beagleboard/beaglebone-black/images/image86.jpg

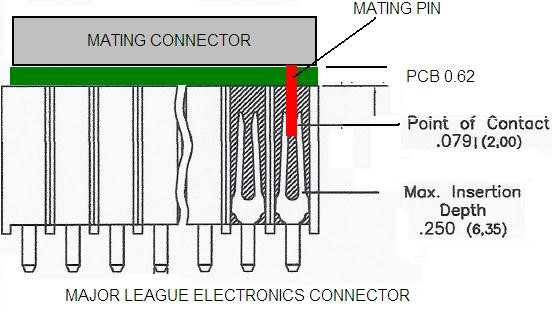
images/image86.jpg
