beagleboard/beaglebone-black/images/image9.jpg

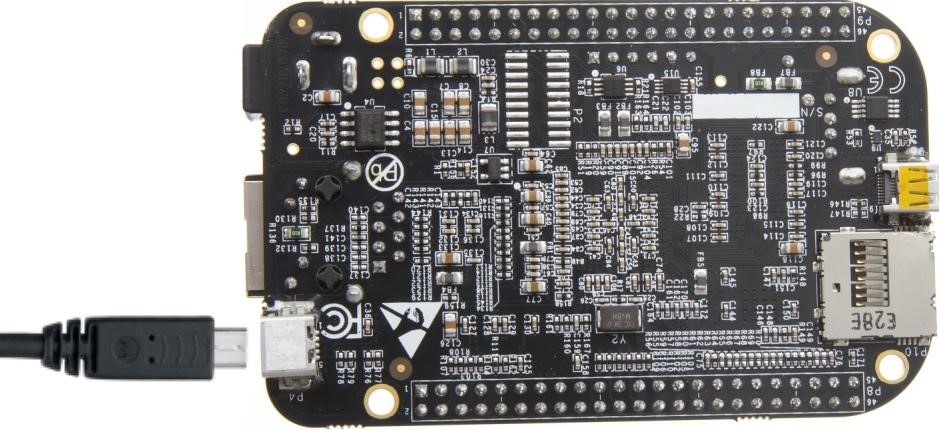
images/image9.jpg
