beagleboard/beaglebone-black/docs/PCN/PCN_BBBI_v0.2.pdf

## PRODUCT CHANGE

PCN# | PCN20201105-002 | PCN ISSUE DATE | Nov 05, 2020
PCN TITLE

BeagleBone Black Industrial

REVISION | | CUSTOMER CONTACT

TYPE OF CHANGE

☐Electrical Specification | ☐Part Number
☐Mechanical Specification | RComponents End of Life
☐Firmware Specification | ☐Other
☐Regulatory of Compliance

AFFECTED PART NUMBER(S)

Part Number | Manufacturer | Description | Change
YL004-030-001 | YULIANG | SMD SD Card Holder | Replace ALPS:SCHA5B0200
Resistors and Capacitors | YAGEO | Improve EMI performance | Quantity and value change

REASONS FOR CHANGE

ALPS: SCHA5B0200 SD card cage EOL and change it to YULIANG: YL004-030-001 (compatible with Molex: 5027740891).

Mechanical is compatible with previous design.

CUSTOMER ACTION REQUIRED

No actions.

## PRODUCT CHANGE

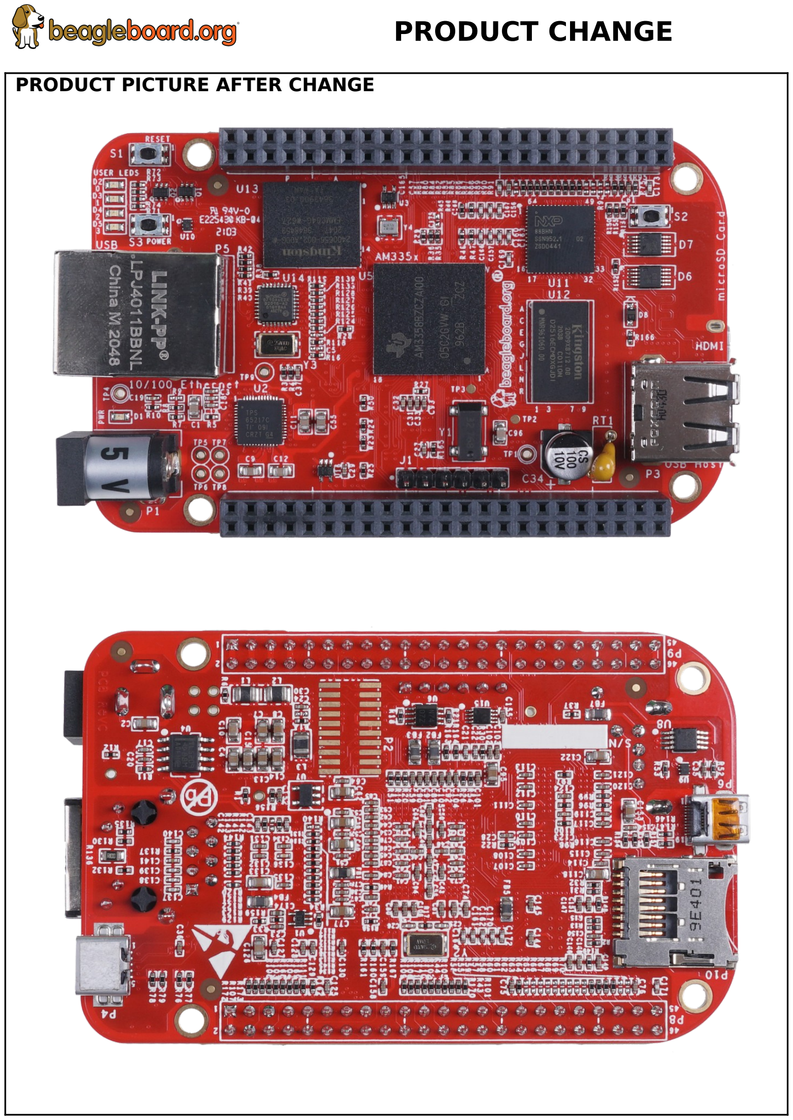
[picture p3: page 2]

PRODUCT PICTURE AFTER CHANGE
