beagleboard/beaglebone-black/images/image1.jpg

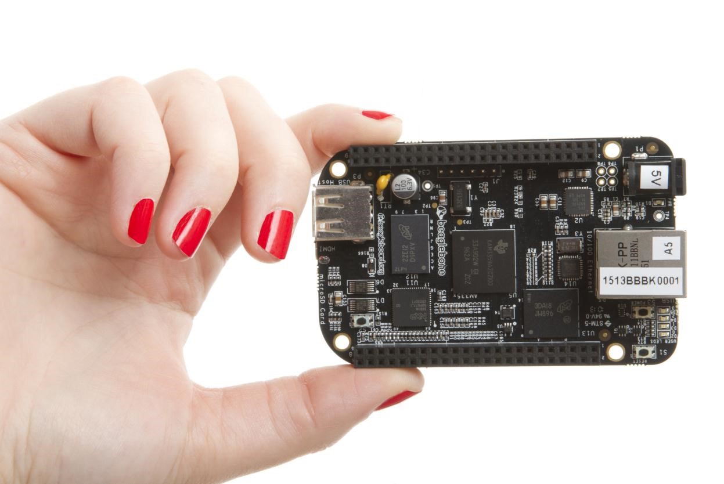
images/image1.jpg
