beagleboard/beaglebone-black/images/image7.jpg

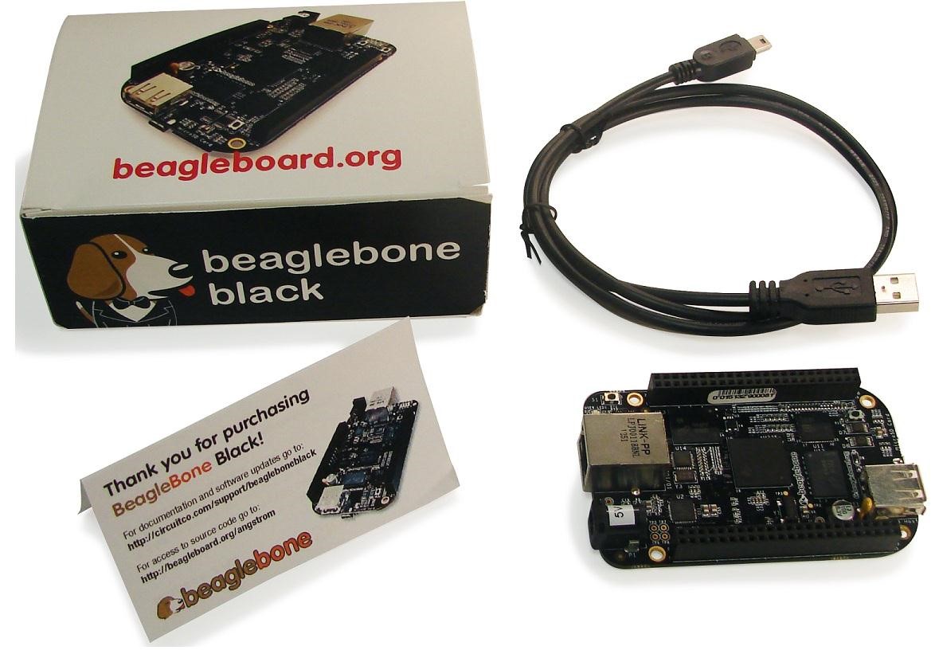
images/image7.jpg
