beagleboard/beaglebone-black/images/image8.jpg

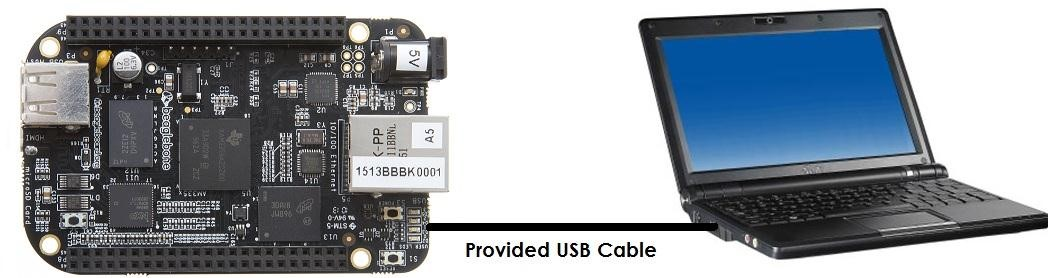
images/image8.jpg
