beagleboard/beaglebone-black/images/image10.jpg

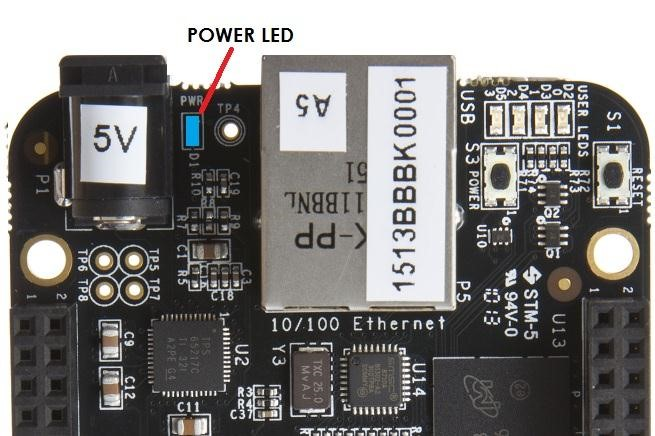
images/image10.jpg
