beagleboard/beaglebone-black/images/image11.jpg

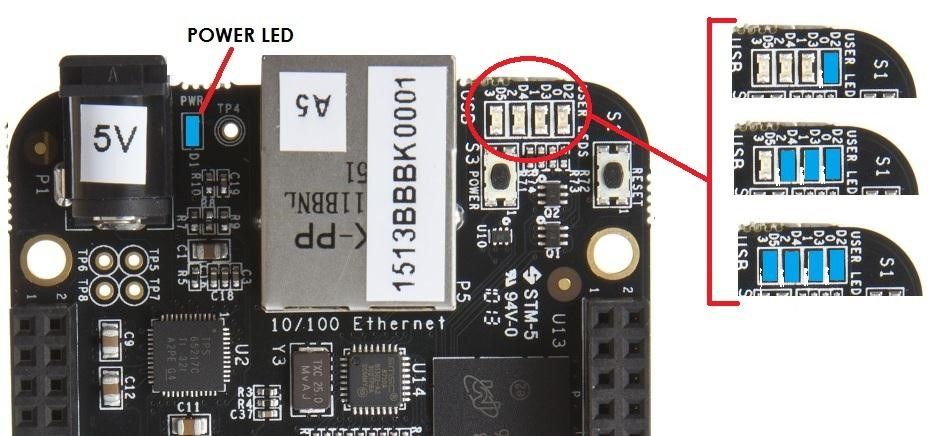
images/image11.jpg
