beagleboard/beaglebone-black/images/image12.jpg

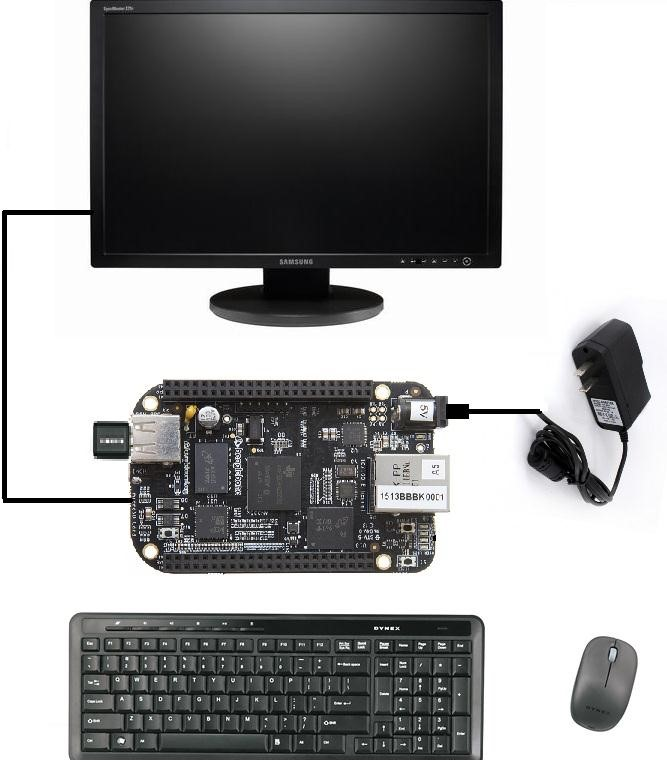
images/image12.jpg
