beagleboard/beaglebone-black/images/image14.jpg

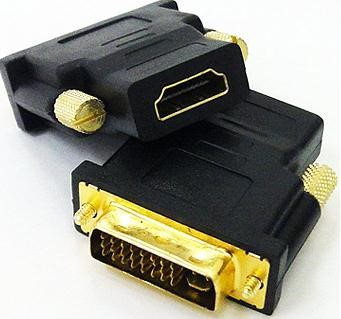
images/image14.jpg
