beagleboard/beaglebone-black/images/image16.jpg

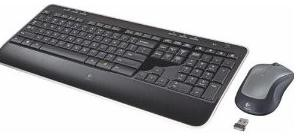
images/image16.jpg
