beagleboard/beaglebone-black/images/image17.jpg

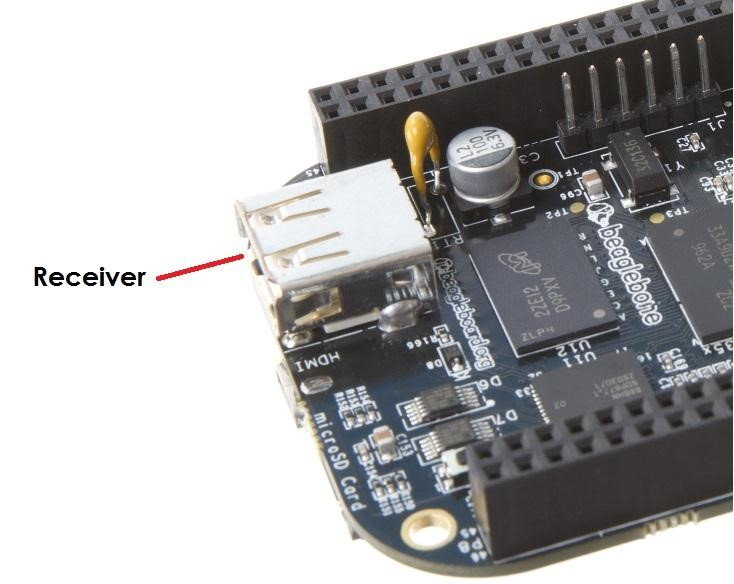
images/image17.jpg
