beagleboard/beaglebone-black/images/image18.jpg

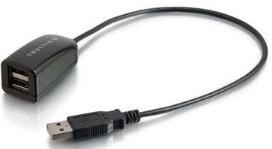
images/image18.jpg
