beagleboard/beaglebone-black/images/image24.jpg

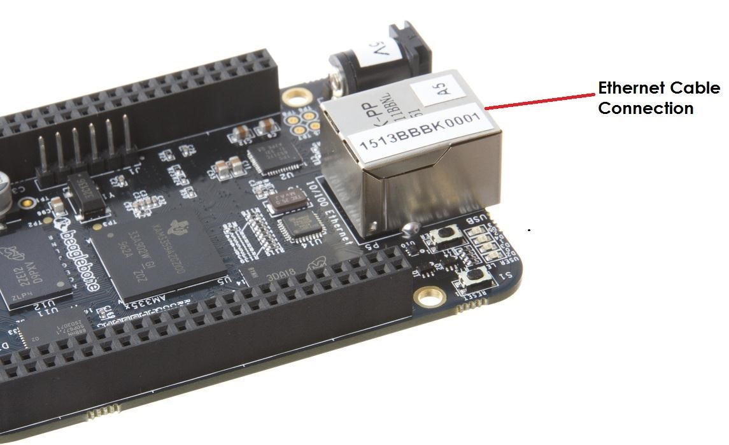
images/image24.jpg
