beagleboard/beaglebone-black/images/image25.jpg

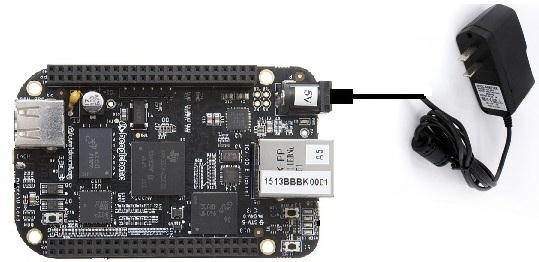
images/image25.jpg
