beagleboard/beaglebone-black/images/image26.jpg

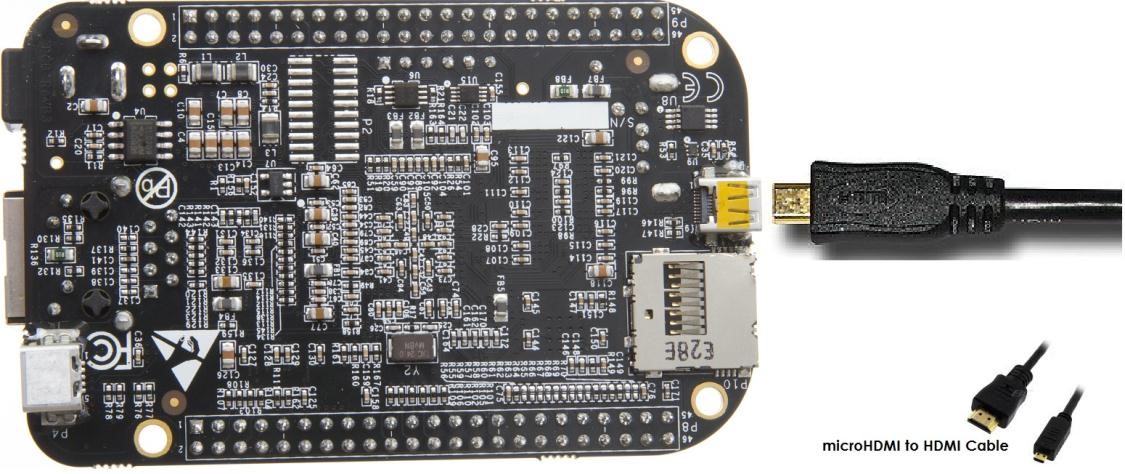
images/image26.jpg
