beagleboard/beaglebone-black/images/image27.jpg

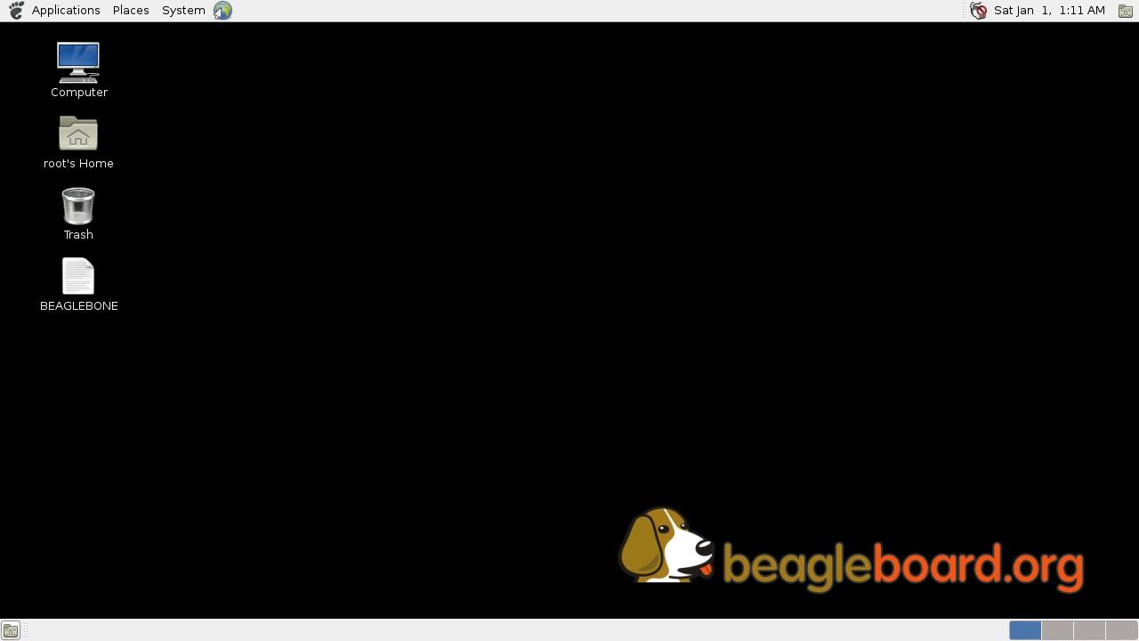
images/image27.jpg
