beagleboard/beaglebone-black/images/image28.jpg

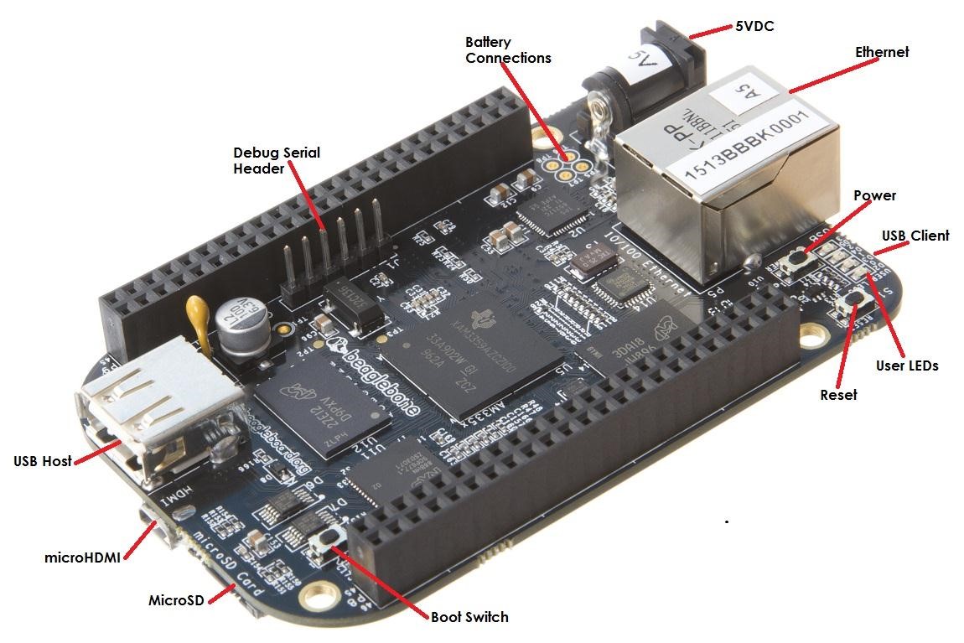
images/image28.jpg
