beagleboard/beaglebone-black/images/image29.jpg

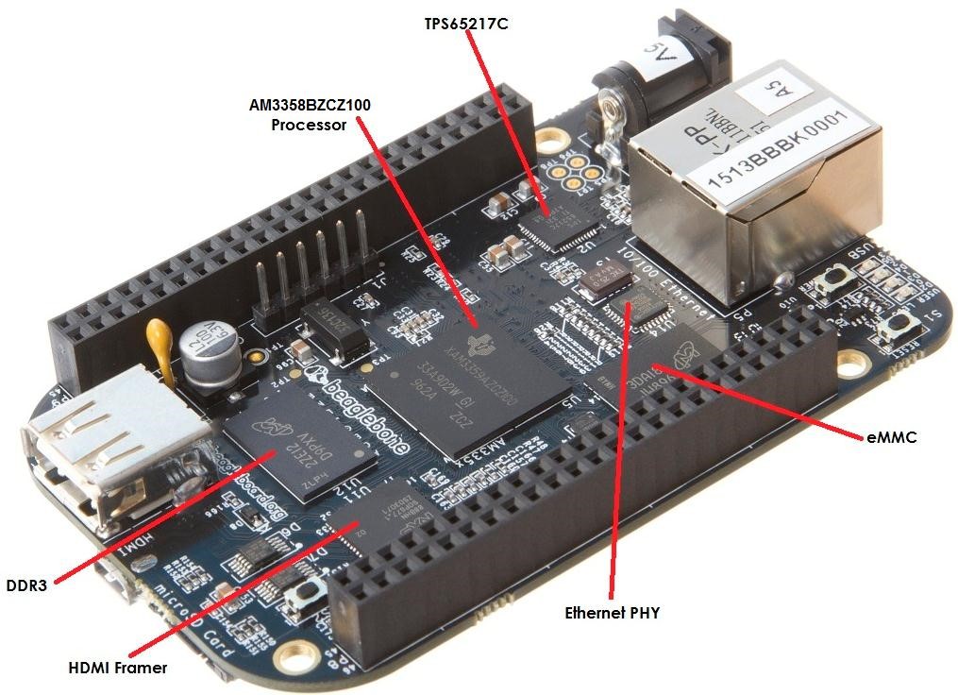
images/image29.jpg
