beagleboard/beaglebone-black/images/image30.jpg

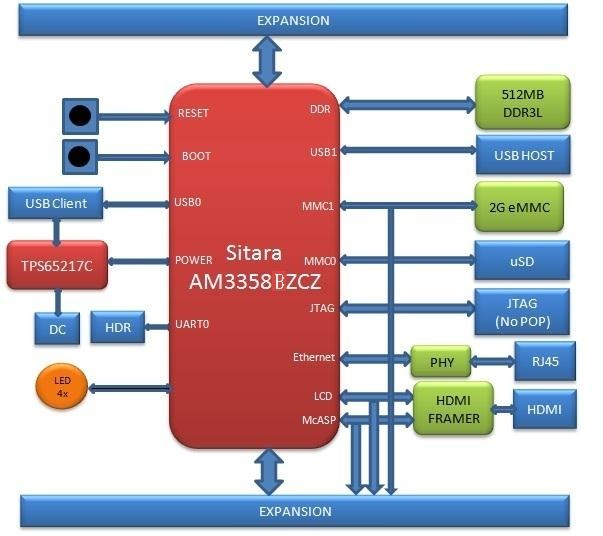
images/image30.jpg
