beagleboard/beaglebone-black/images/image31.png

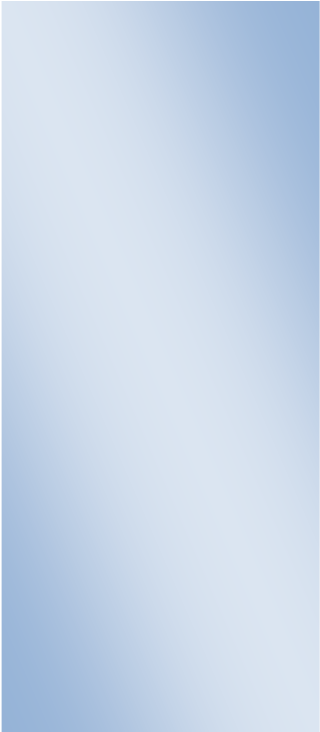
images/image31.png
