beagleboard/beaglebone-black/images/image37.png

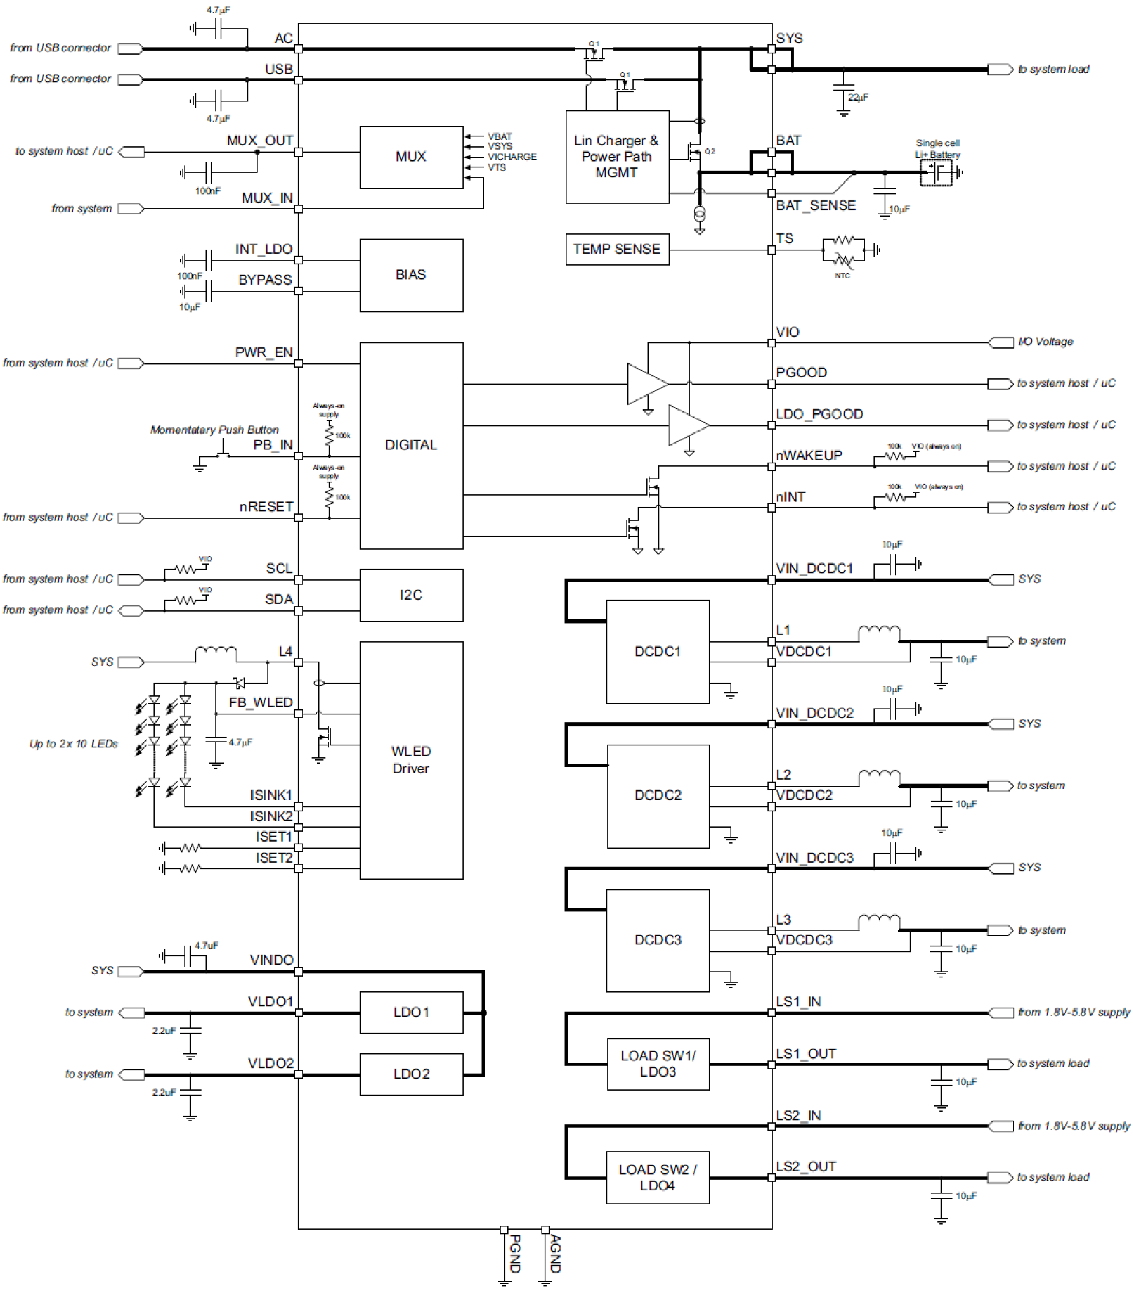
images/image37.png
