beagleboard/beaglebone-black/images/image38.png

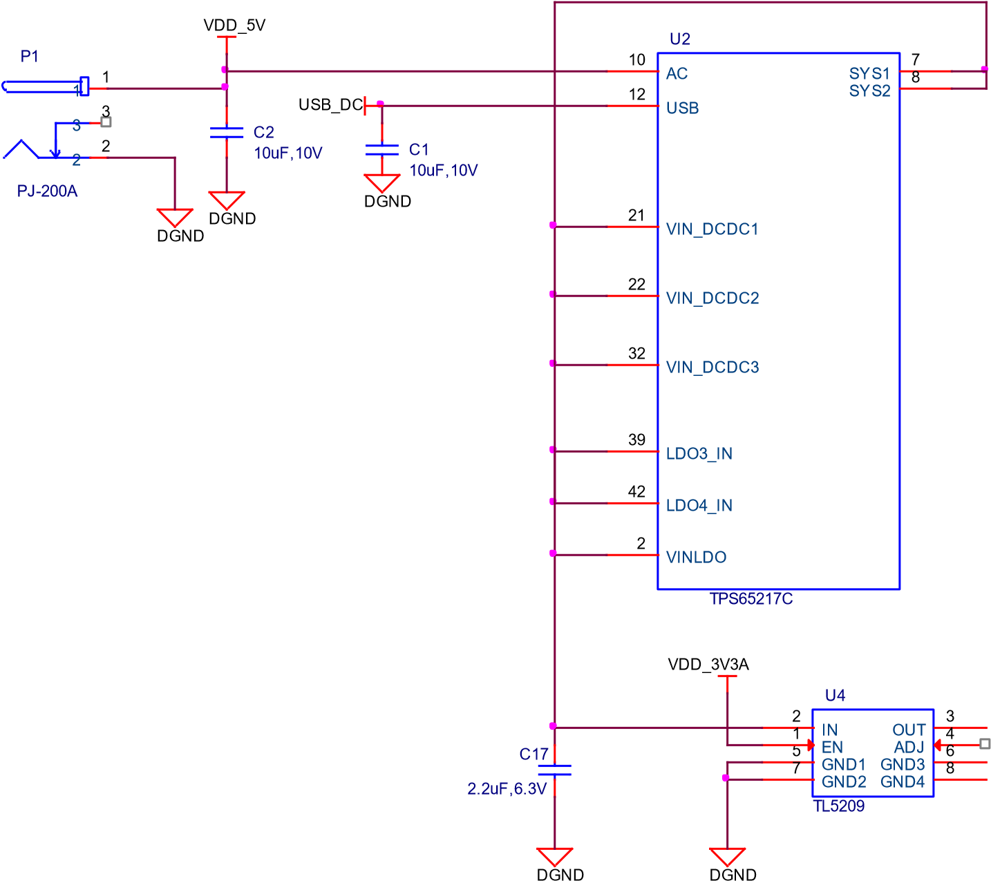
images/image38.png
