beagleboard/beaglebone-black/images/image39.jpg

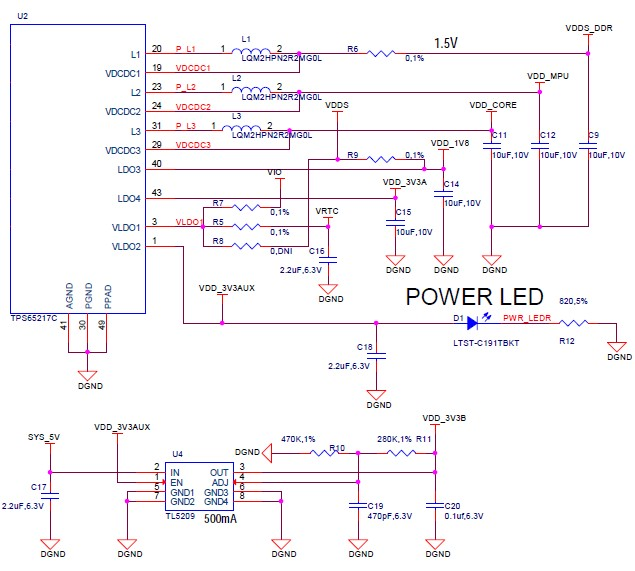
images/image39.jpg
