beagleboard/beaglebone-black/images/image40.png

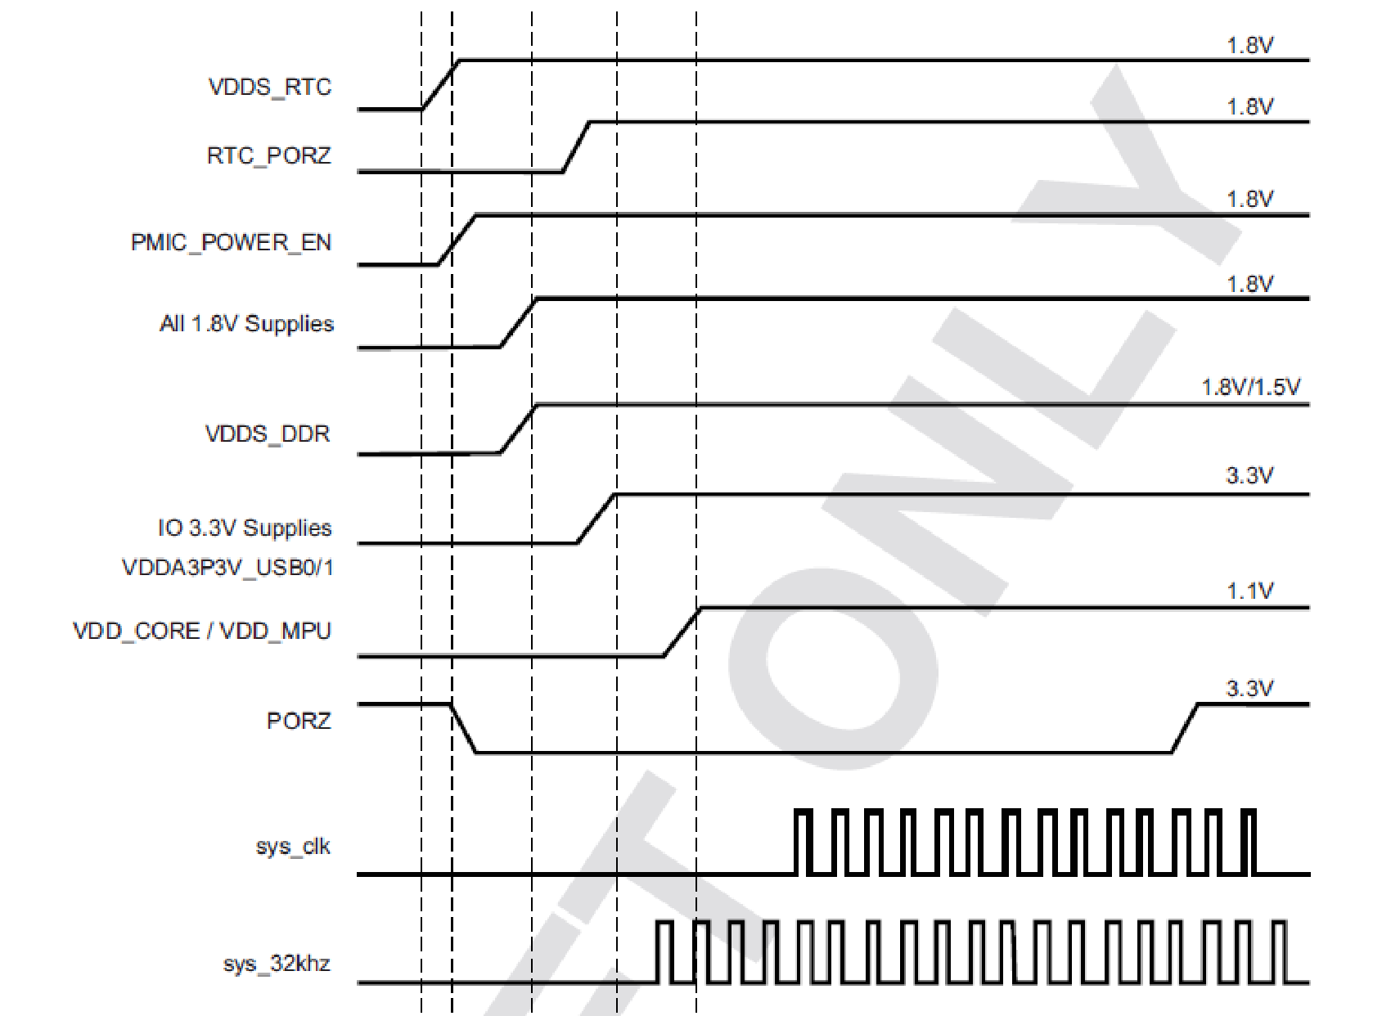
images/image40.png
