beagleboard/beaglebone-black/images/image41.png

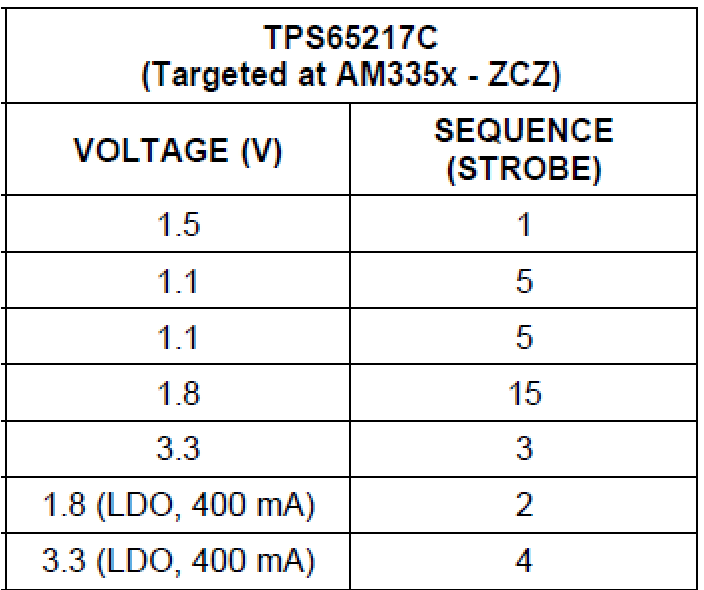
images/image41.png
