beagleboard/beaglebone-black/images/image42.jpg

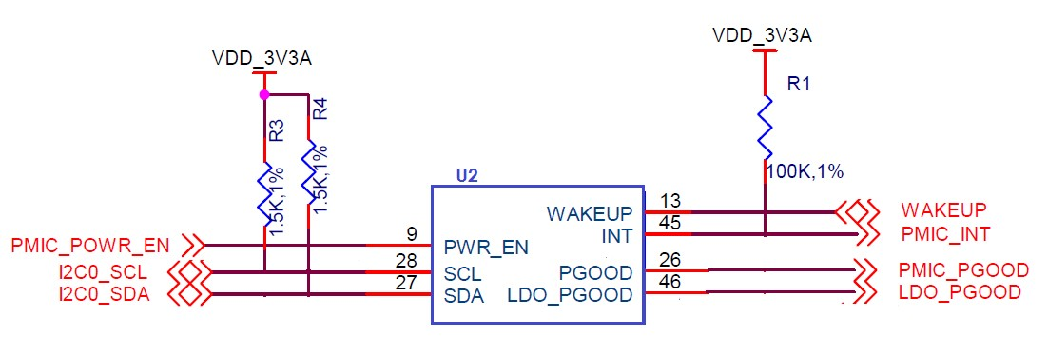
images/image42.jpg
