beagleboard/beaglebone-black/images/image43.png

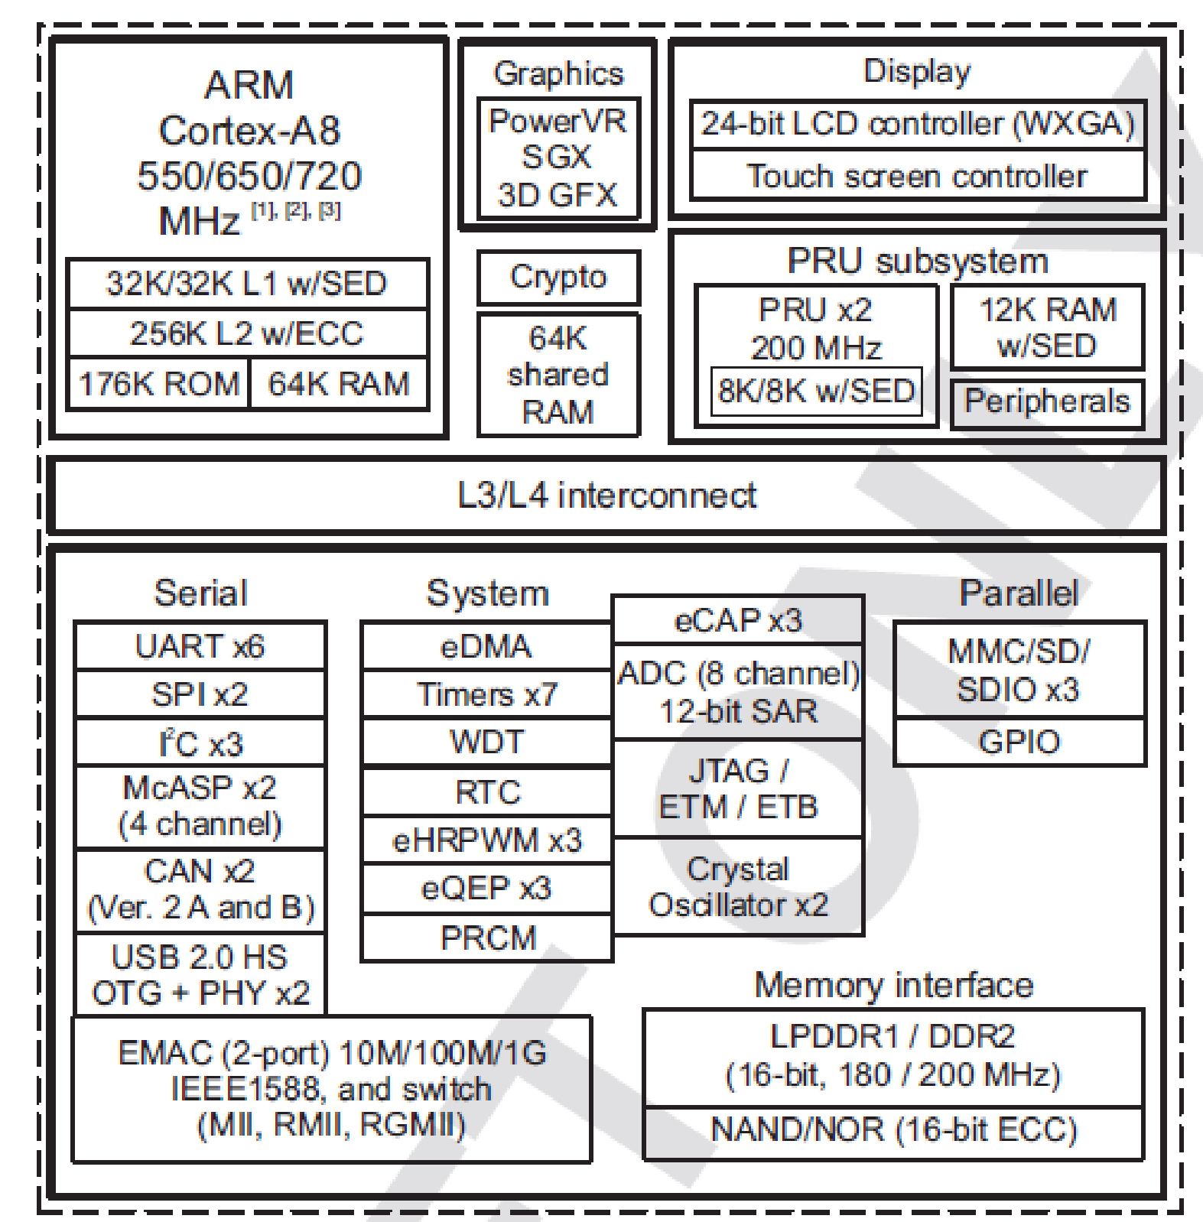
images/image43.png
