beagleboard/beaglebone-black/images/image44.png

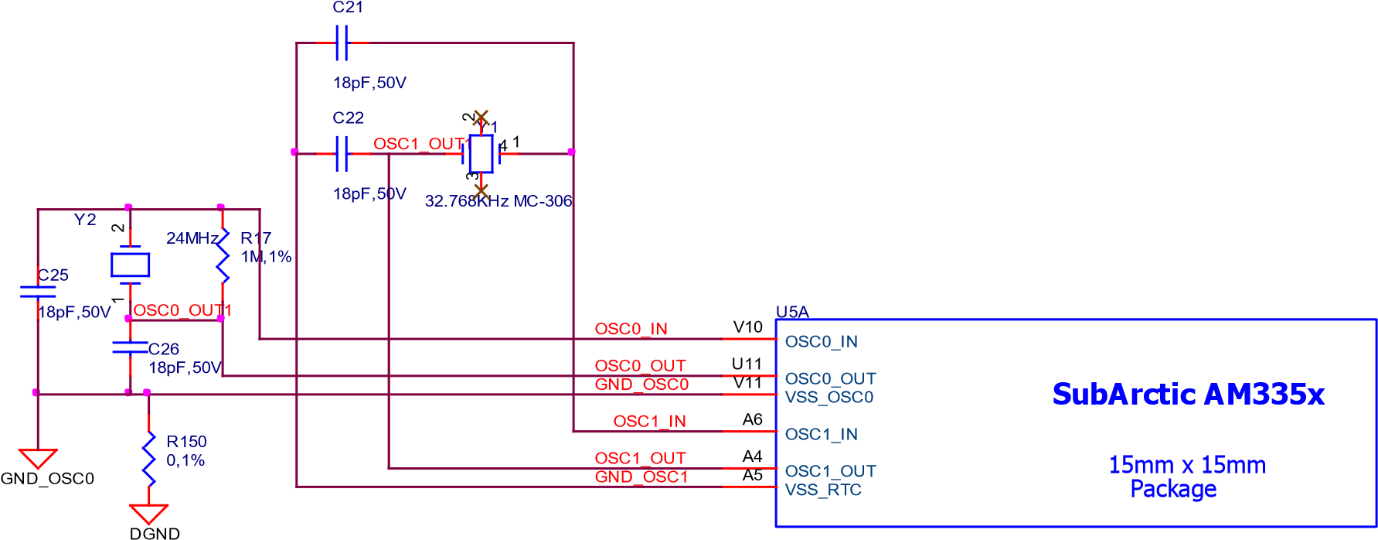
images/image44.png
