beagleboard/beaglebone-black/images/image45.png

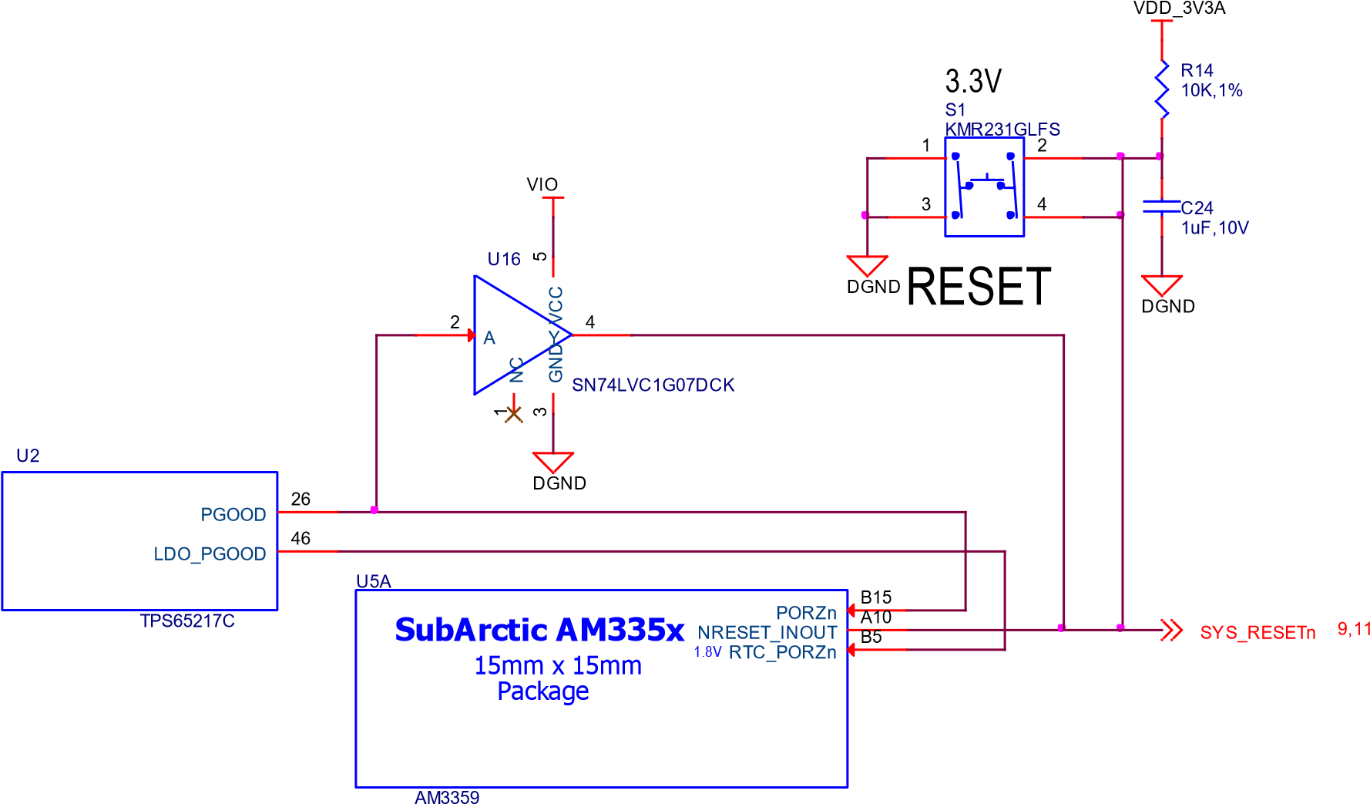
images/image45.png
