beagleboard/beaglebone-black/images/image46.png

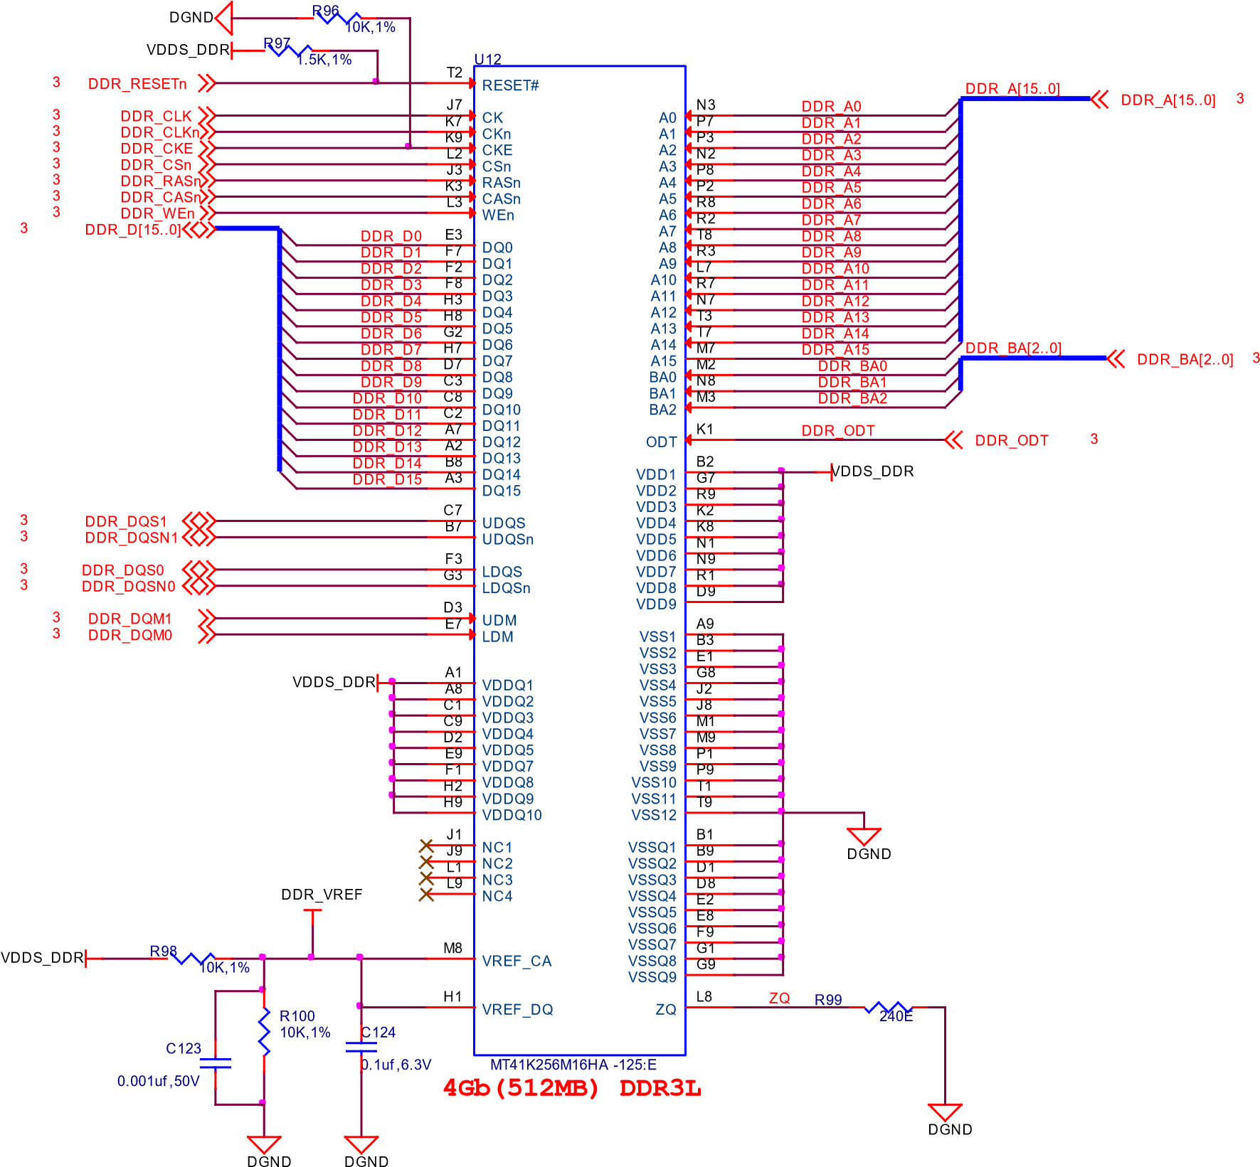
images/image46.png
