beagleboard/beaglebone-black/images/image47.jpg

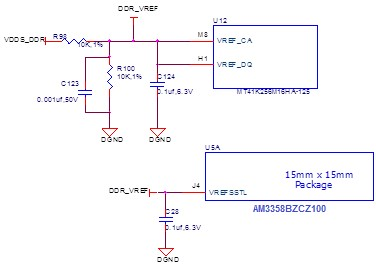
images/image47.jpg
