beagleboard/beaglebone-black/images/image48.png

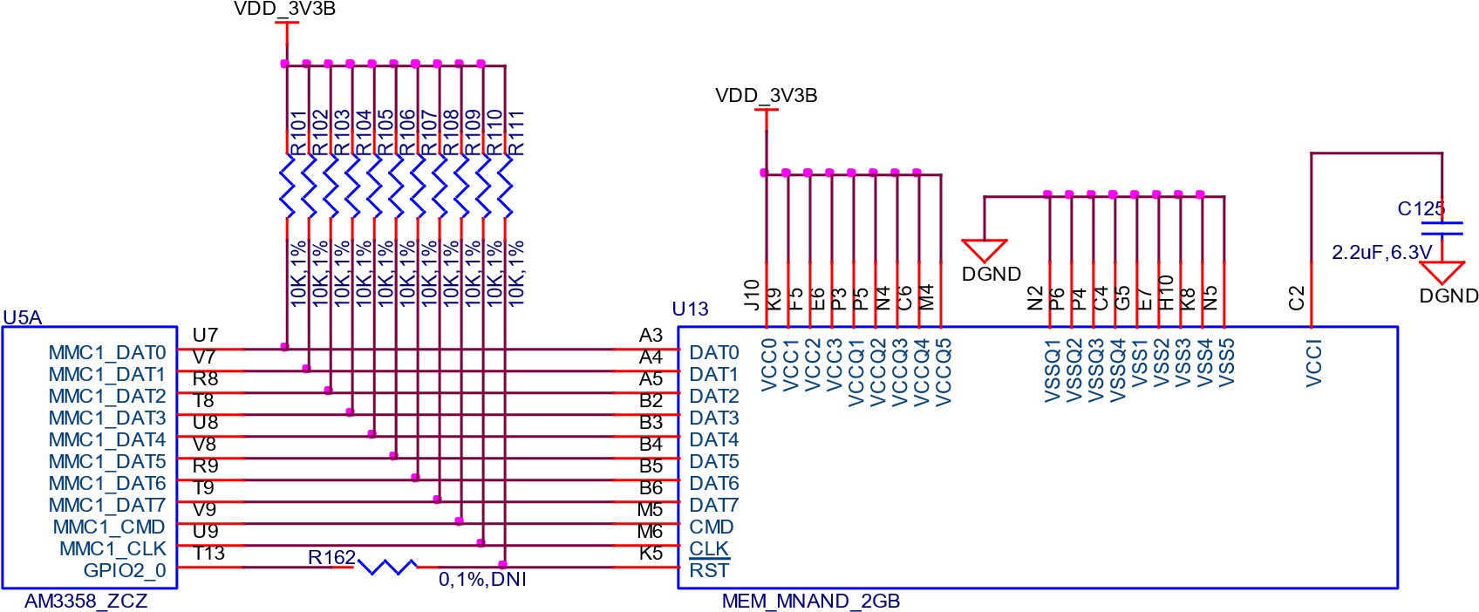
images/image48.png
