beagleboard/beaglebone-black/images/image49.png

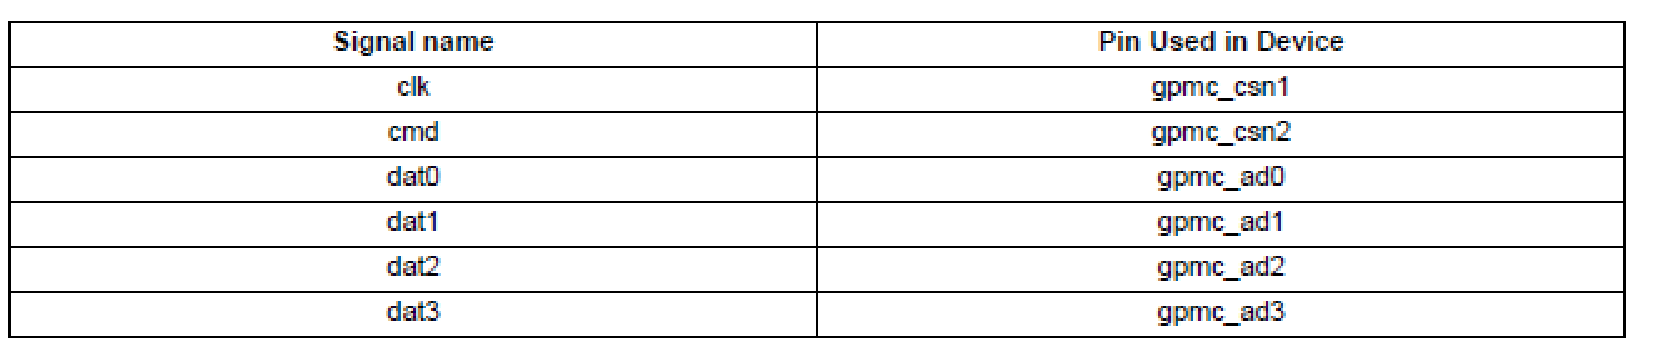
images/image49.png
