beagleboard/beaglebone-black/images/image50.png

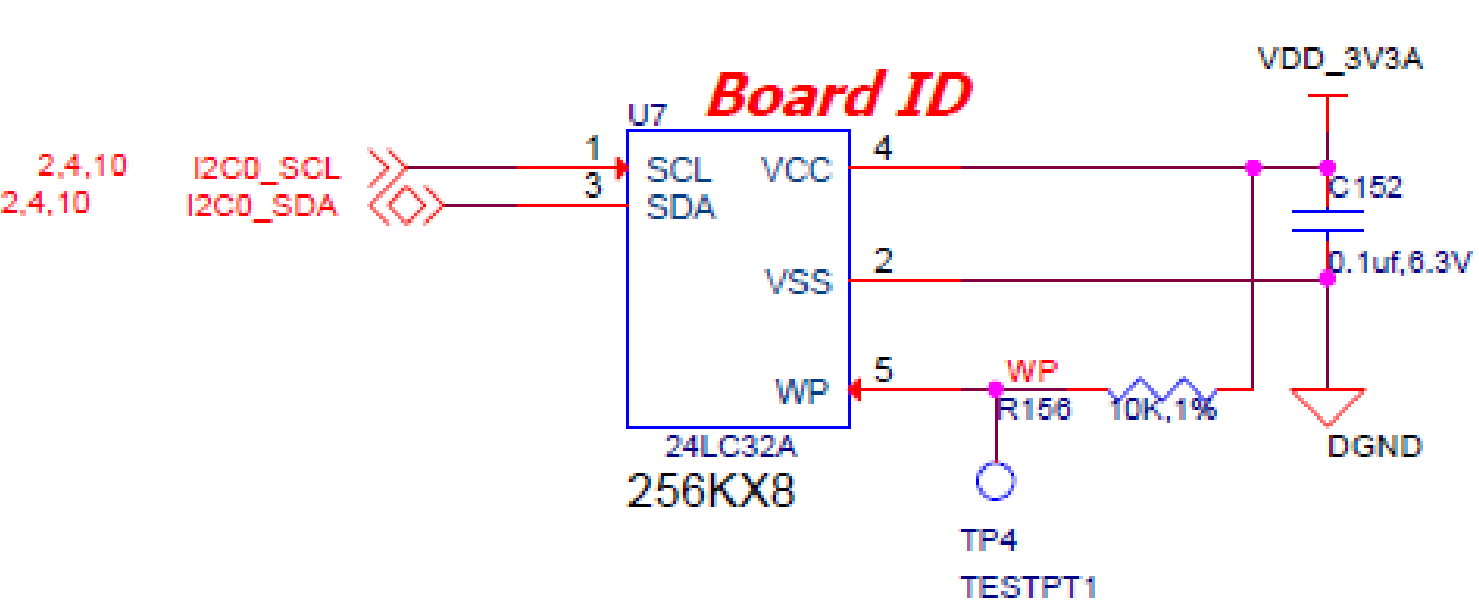
images/image50.png
