beagleboard/beaglebone-black/images/image51.png

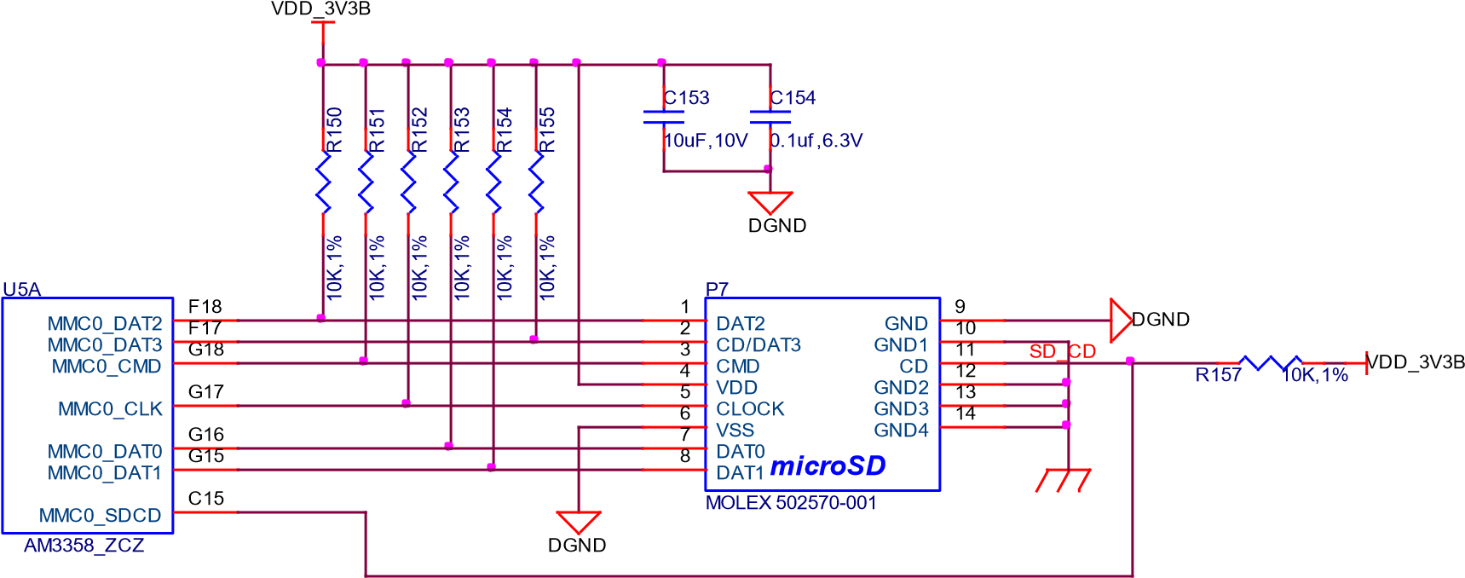
images/image51.png
