beagleboard/beaglebone-black/images/image52.png

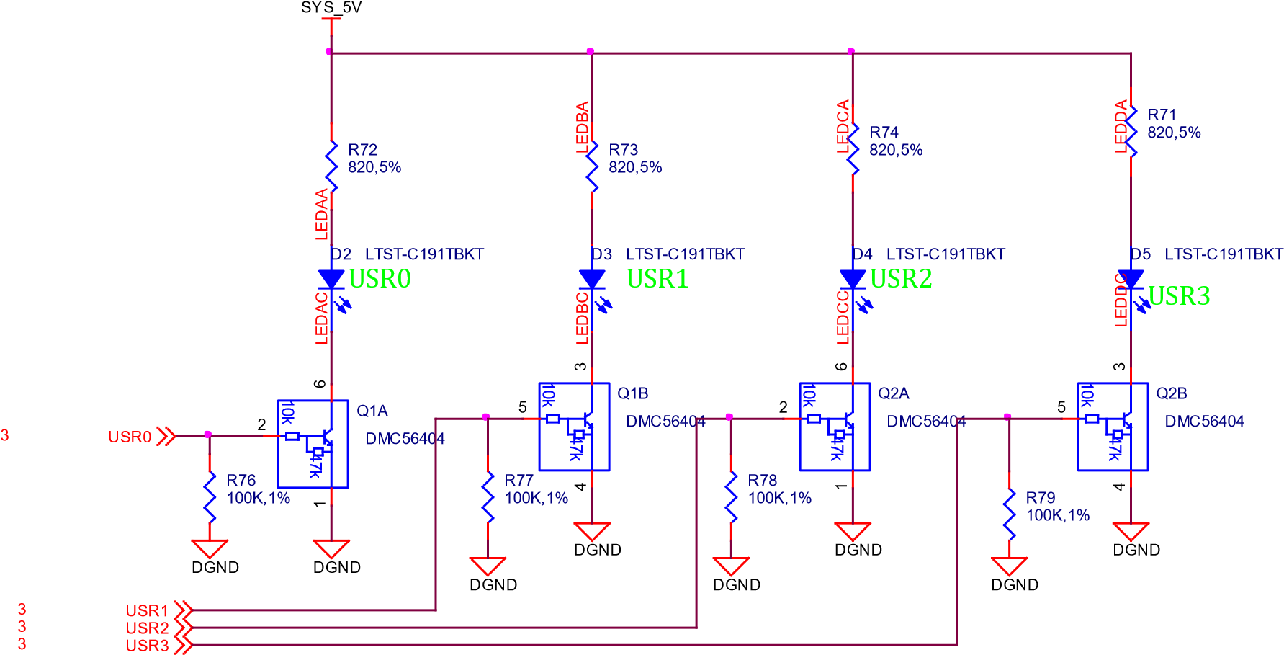
images/image52.png
