beagleboard/beaglebone-black/images/image53.png

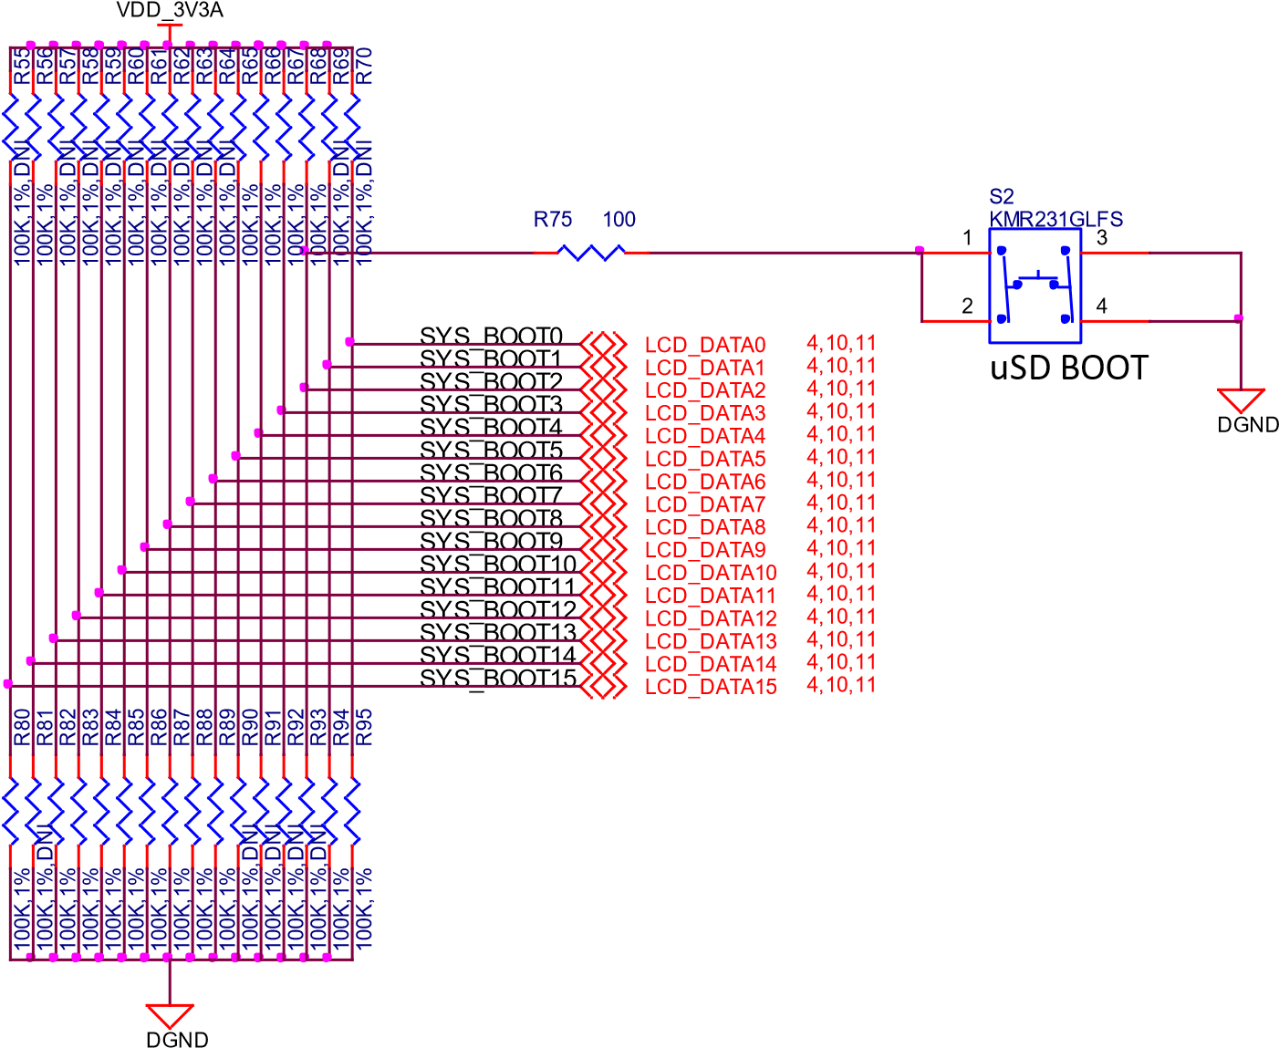
images/image53.png
