beagleboard/beaglebone-black/images/image54.jpg

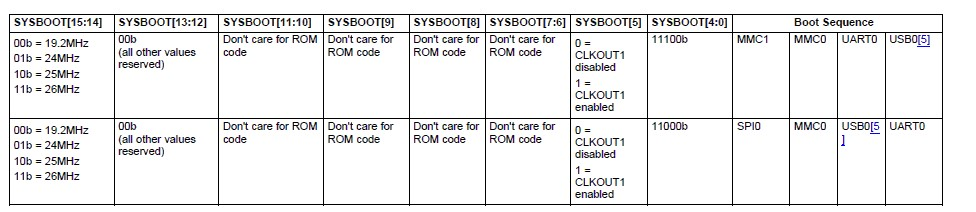
images/image54.jpg
