beagleboard/beaglebone-black/images/image55.png

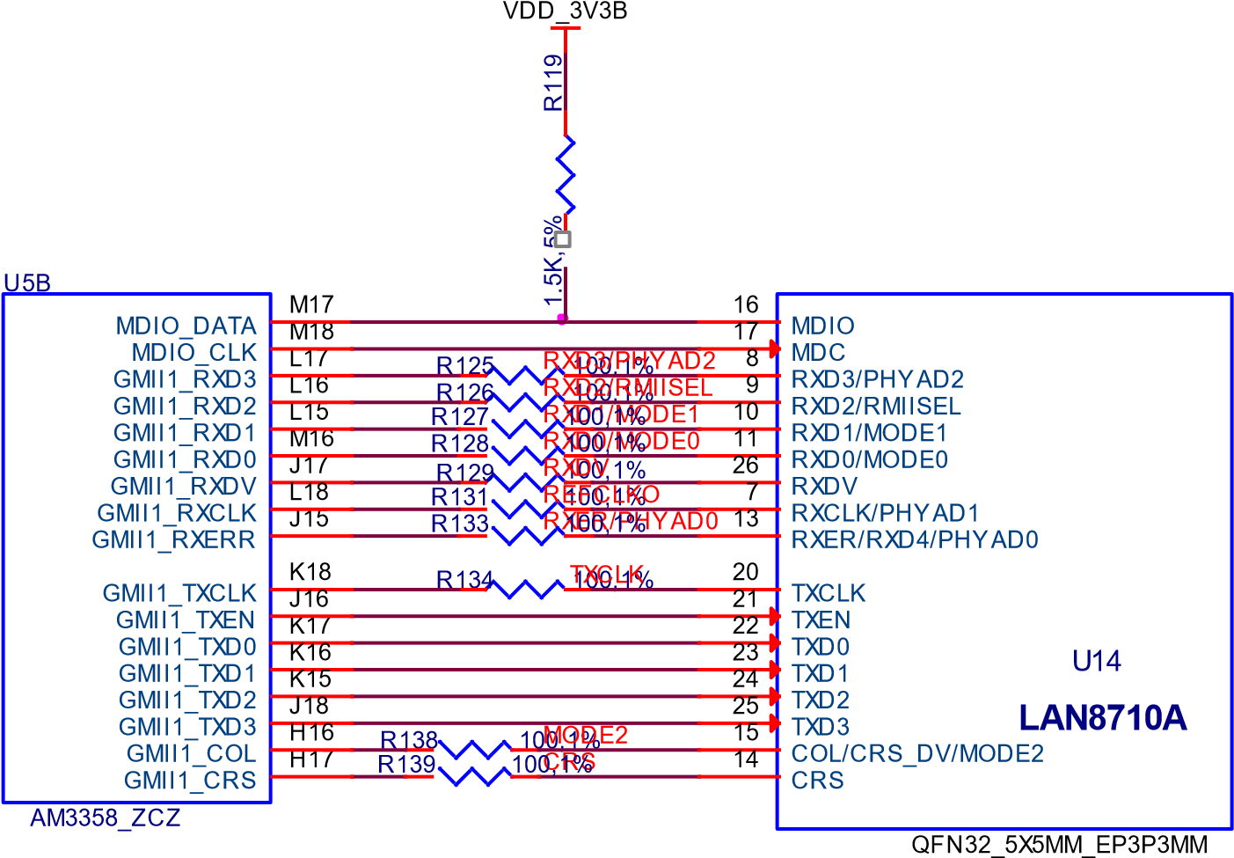
images/image55.png
