beagleboard/beaglebone-black/images/image56.png

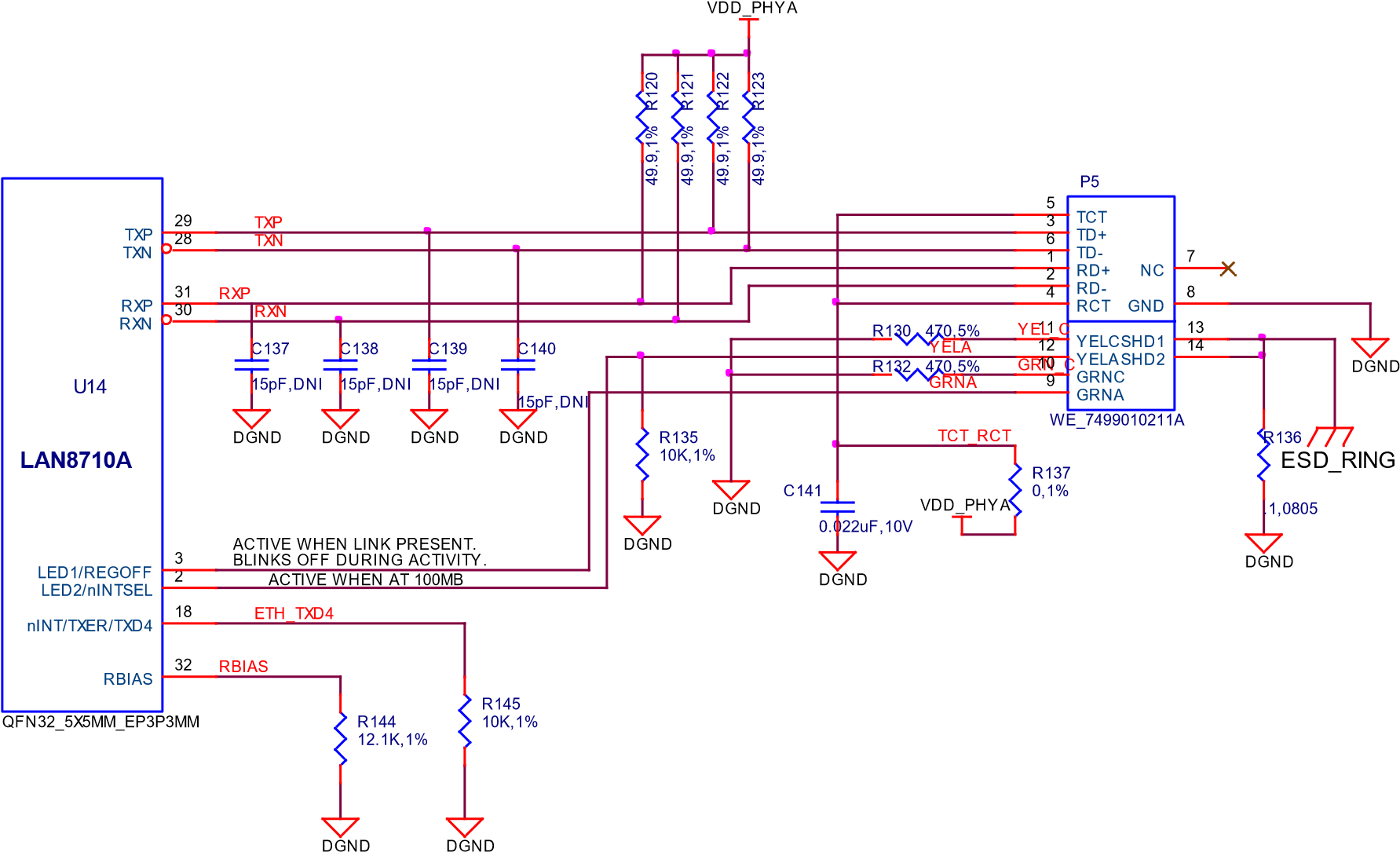
images/image56.png
