beagleboard/beaglebone-black/images/image57.png

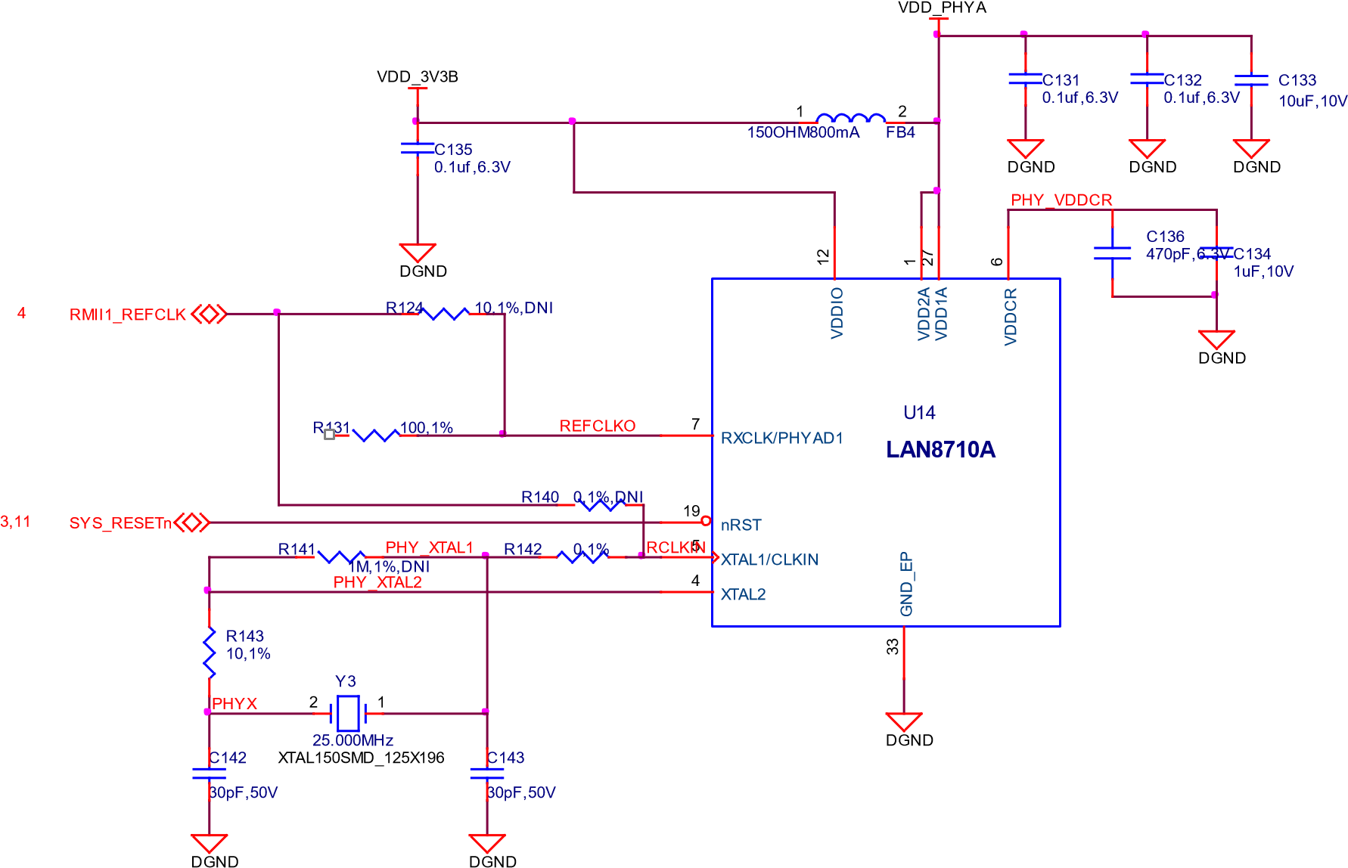
images/image57.png
