beagleboard/beaglebone-black/images/image58.png

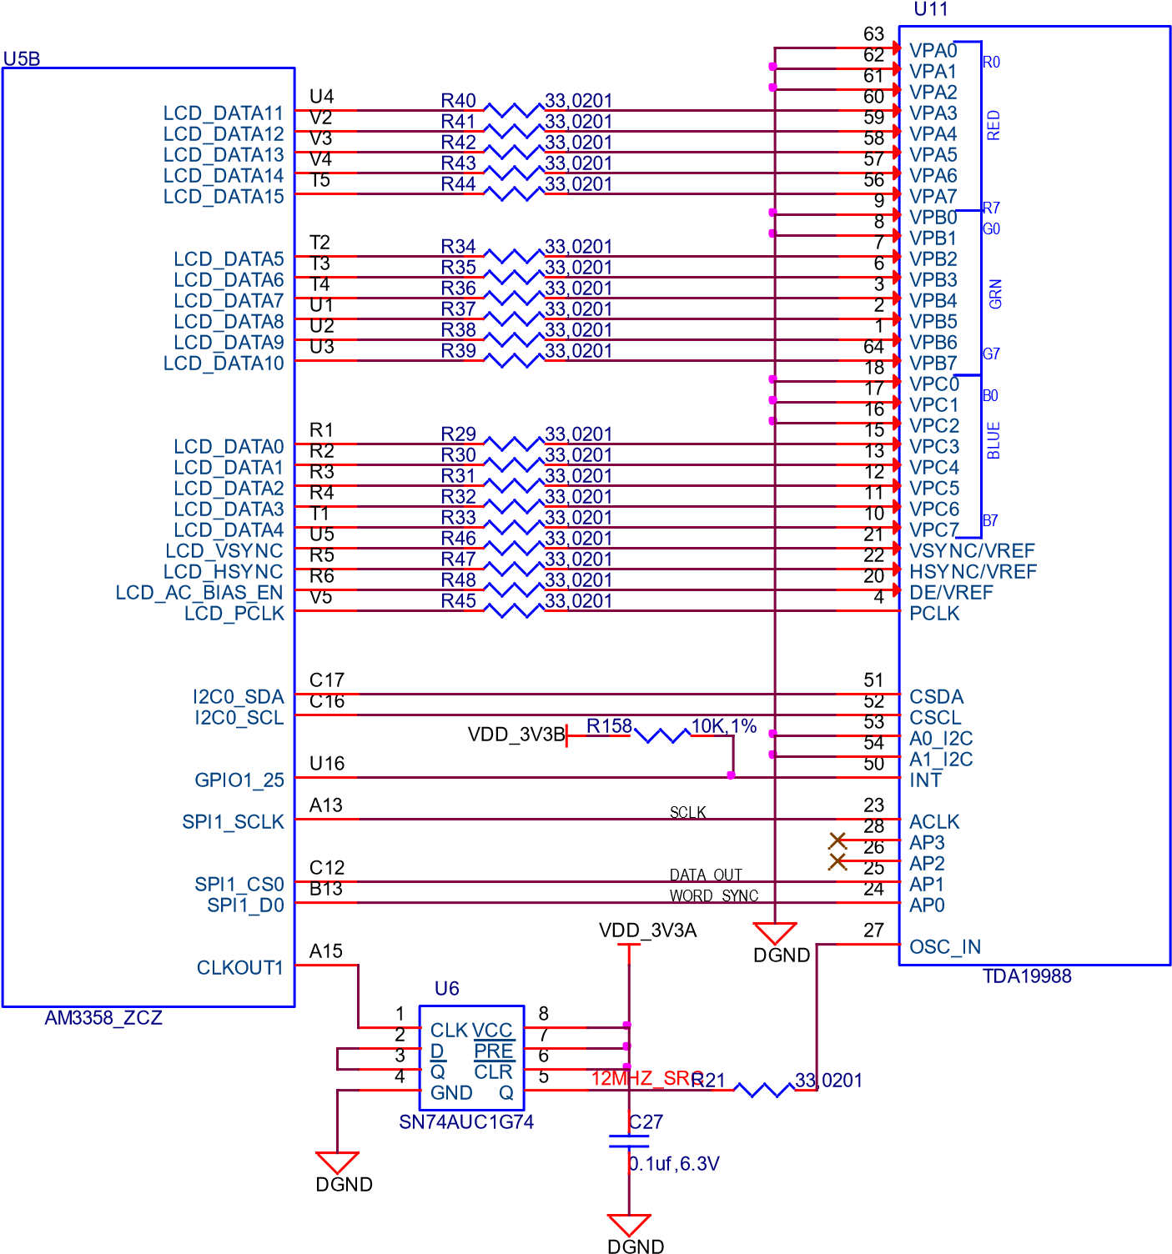
images/image58.png
