beagleboard/beaglebone-black/images/image59.png

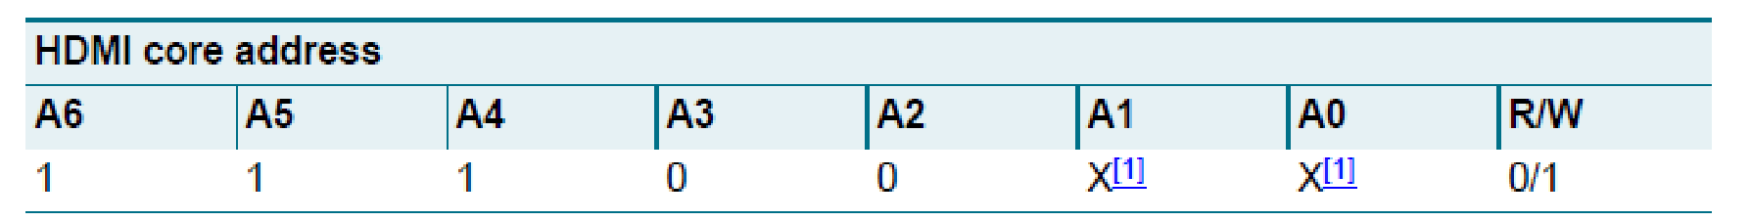
images/image59.png
