beagleboard/beaglebone-black/images/image60.png

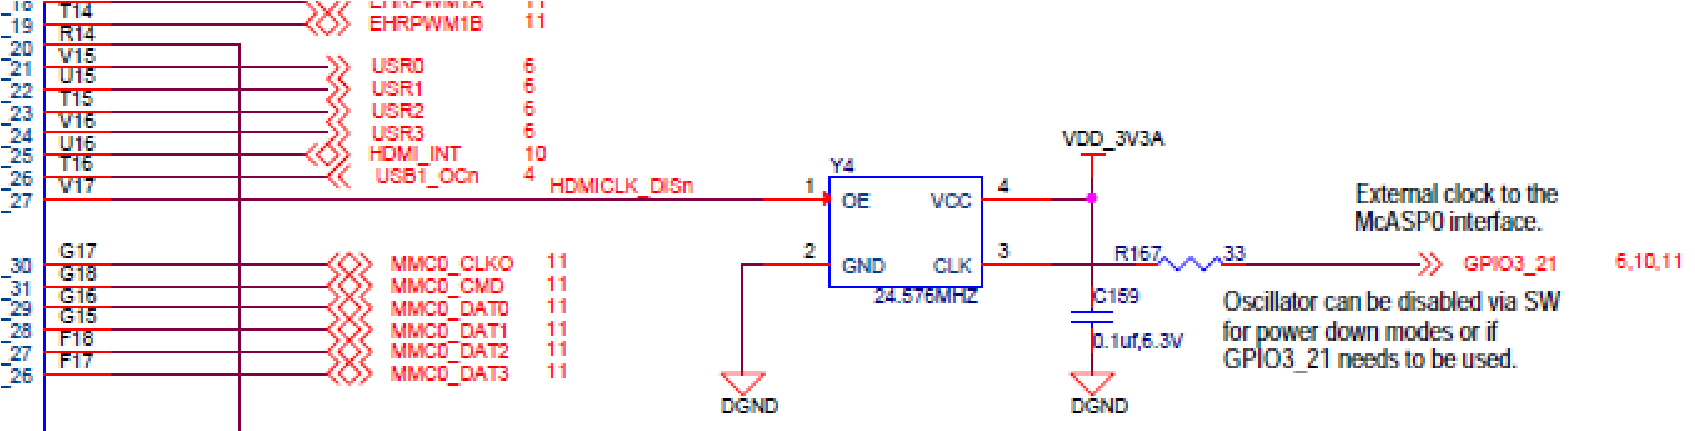
images/image60.png
