beagleboard/beaglebone-black/images/image64.png

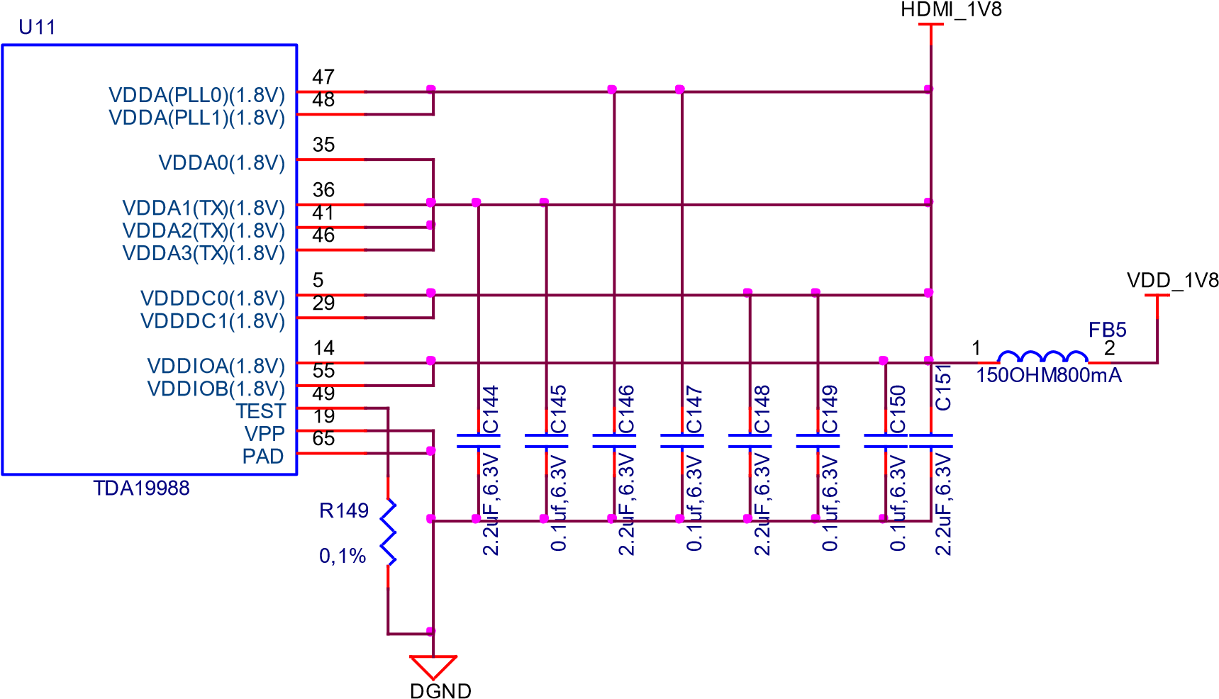
images/image64.png
