beagleboard/beaglebone-black/images/image65.png

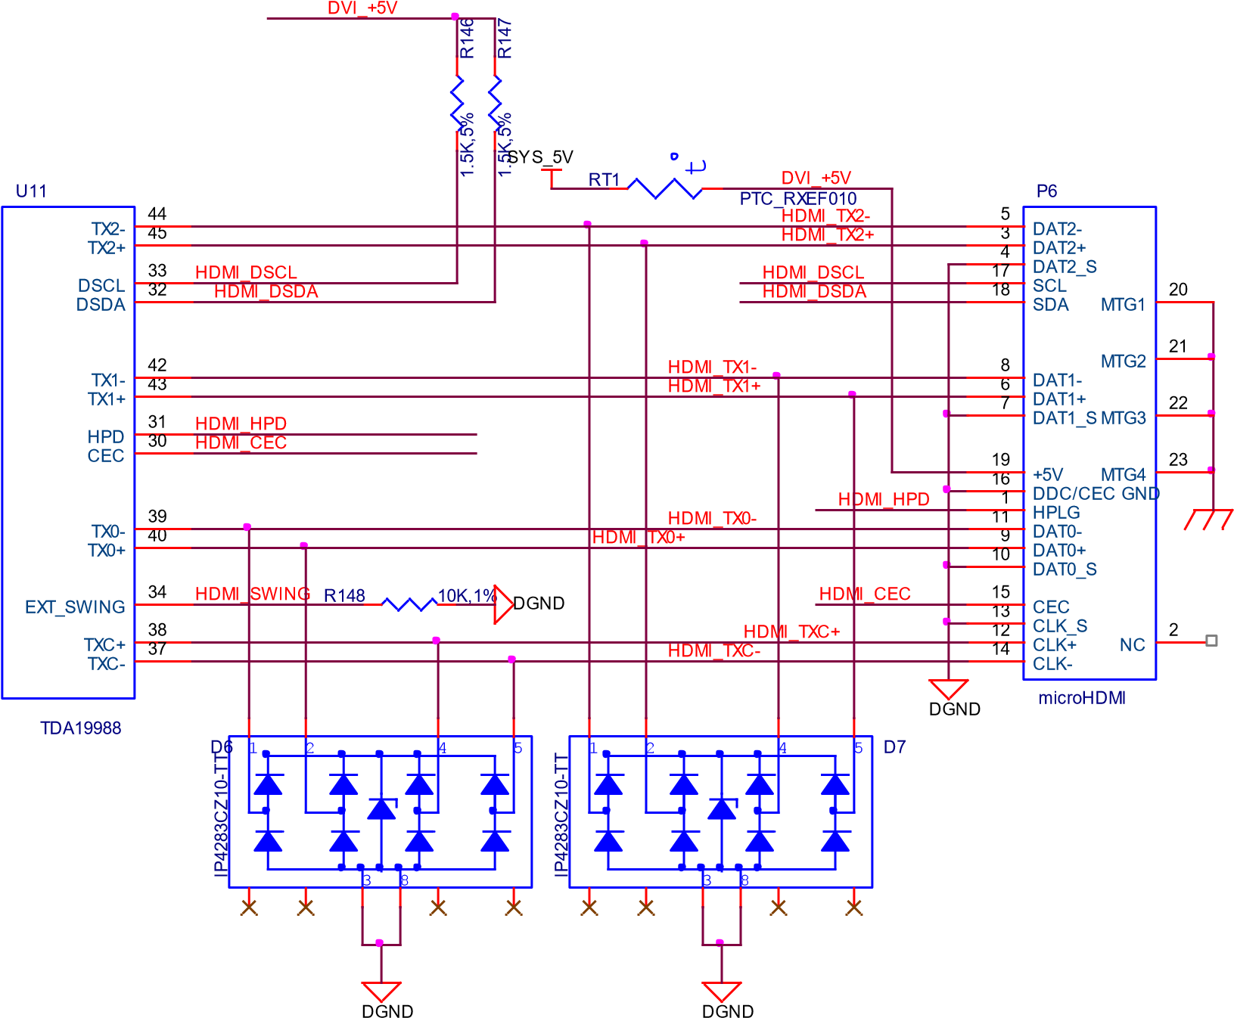
images/image65.png
