beagleboard/beaglebone-black/images/image66.png

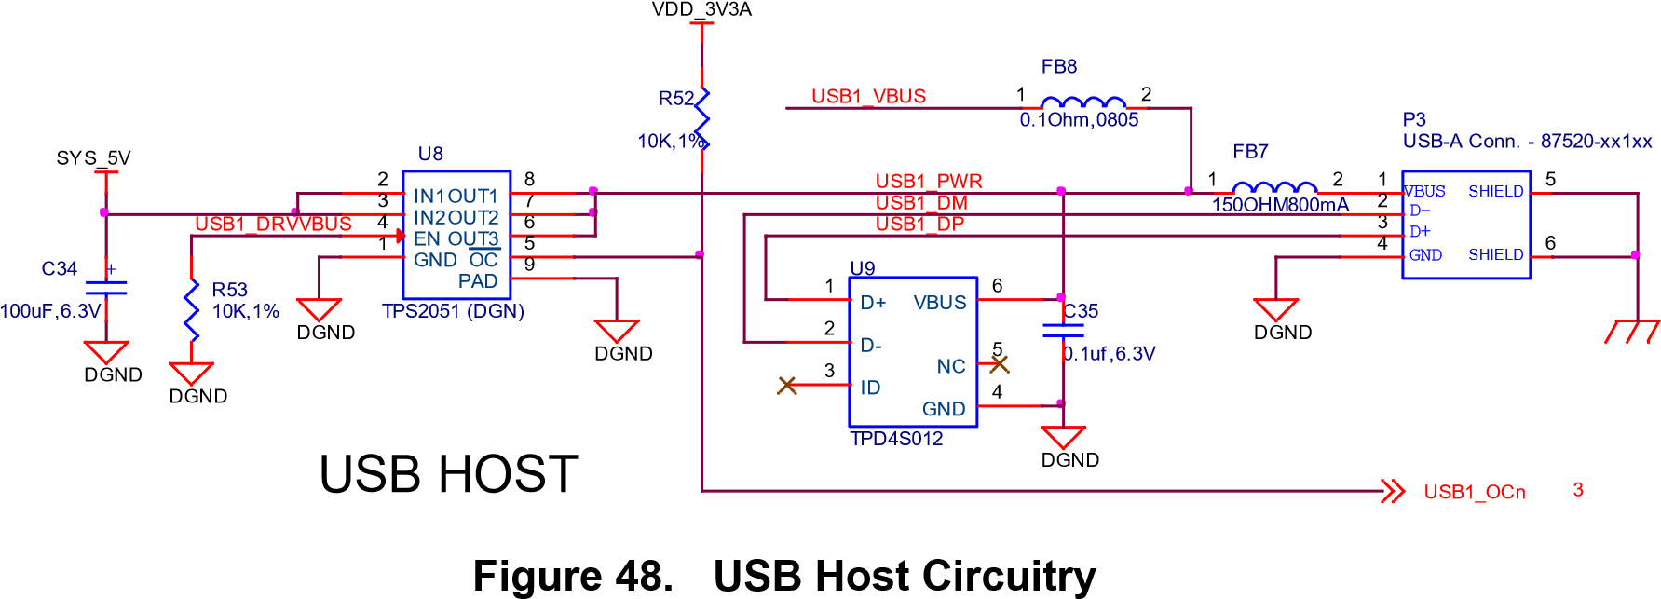
images/image66.png
