beagleboard/beaglebone-black/images/image67.png

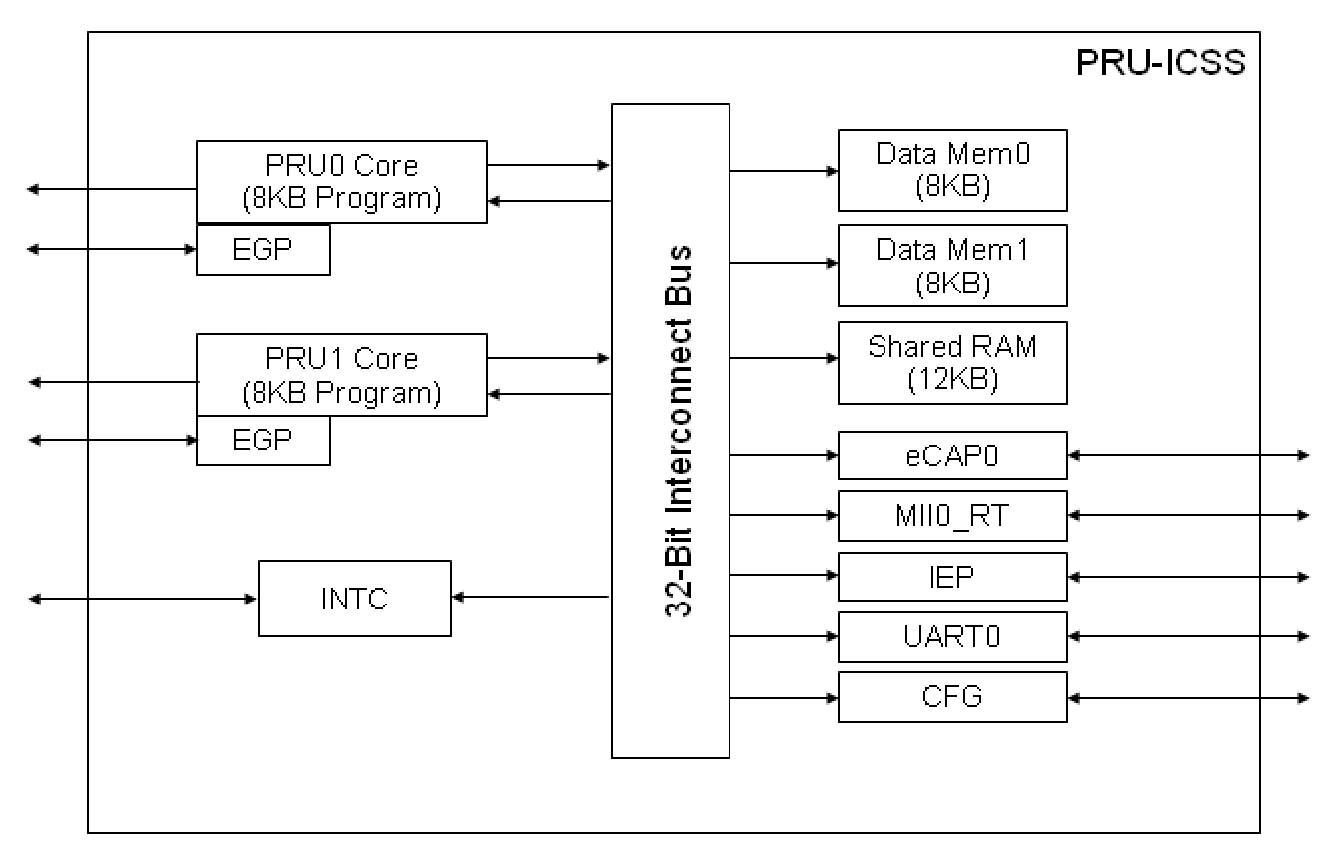
images/image67.png
