beagleboard/beaglebone-black/images/image68.jpg

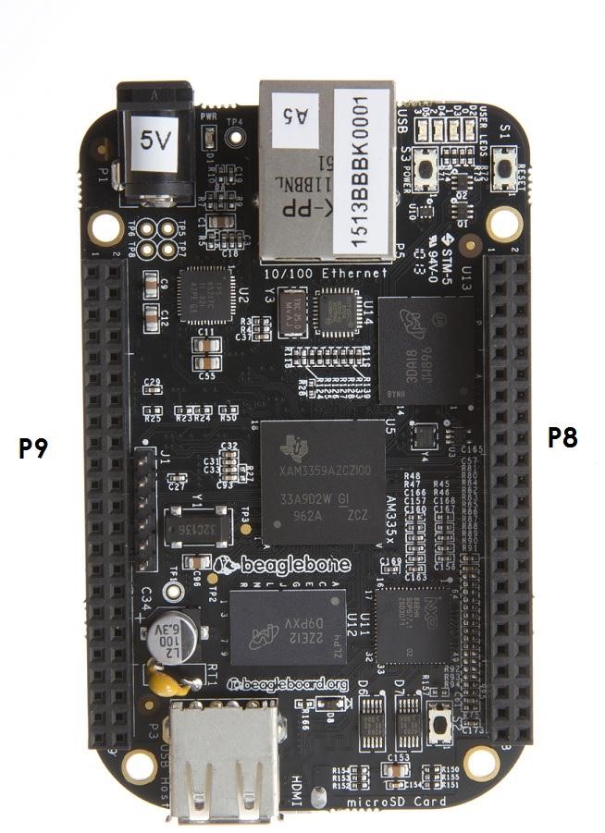
images/image68.jpg
