beagleboard/beaglebone-black/images/image69.jpg

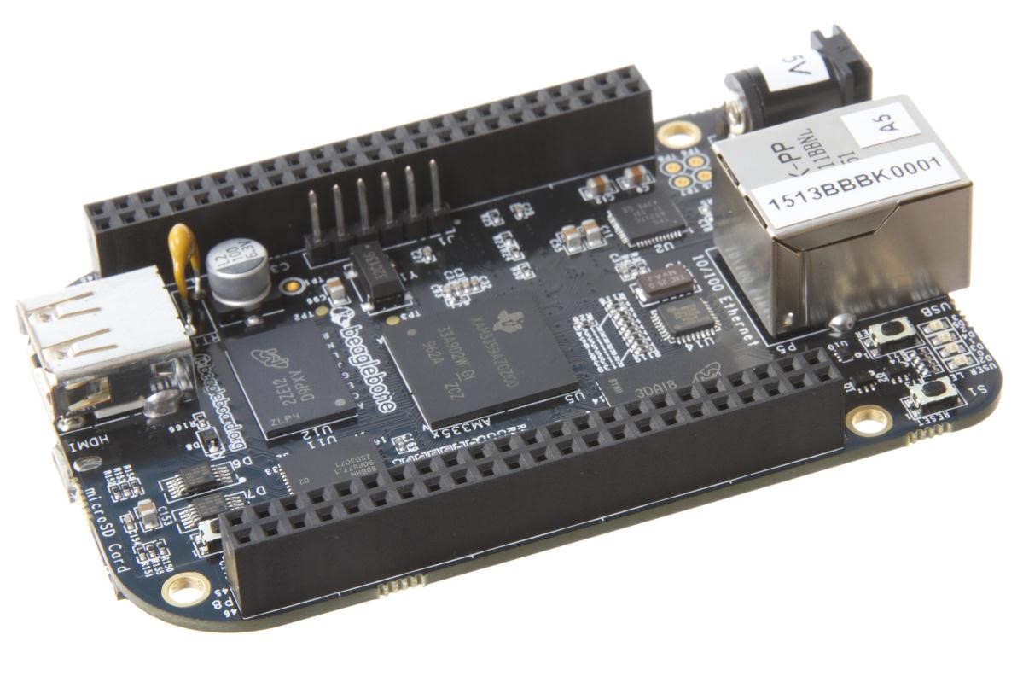
images/image69.jpg
