beagleboard/beaglebone-black/images/image73.jpg

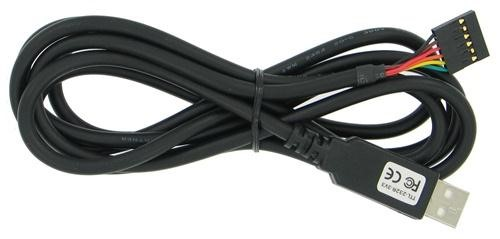
images/image73.jpg
