beagleboard/beaglebone-black/images/image75.jpg

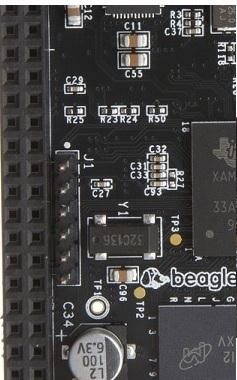
images/image75.jpg
