beagleboard/beaglebone-black/images/image77.jpg

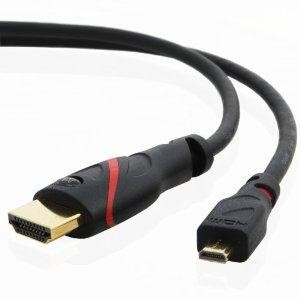
images/image77.jpg
