beagleboard/beaglebone-black/images/image78.png

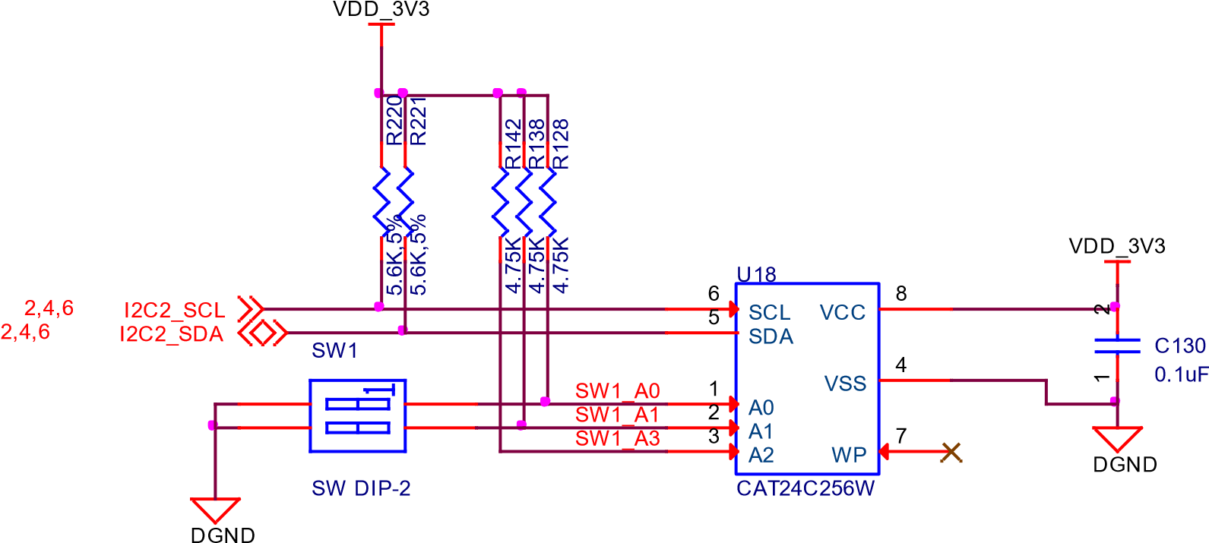
images/image78.png
