beagleboard/beaglebone-black/images/image79.png

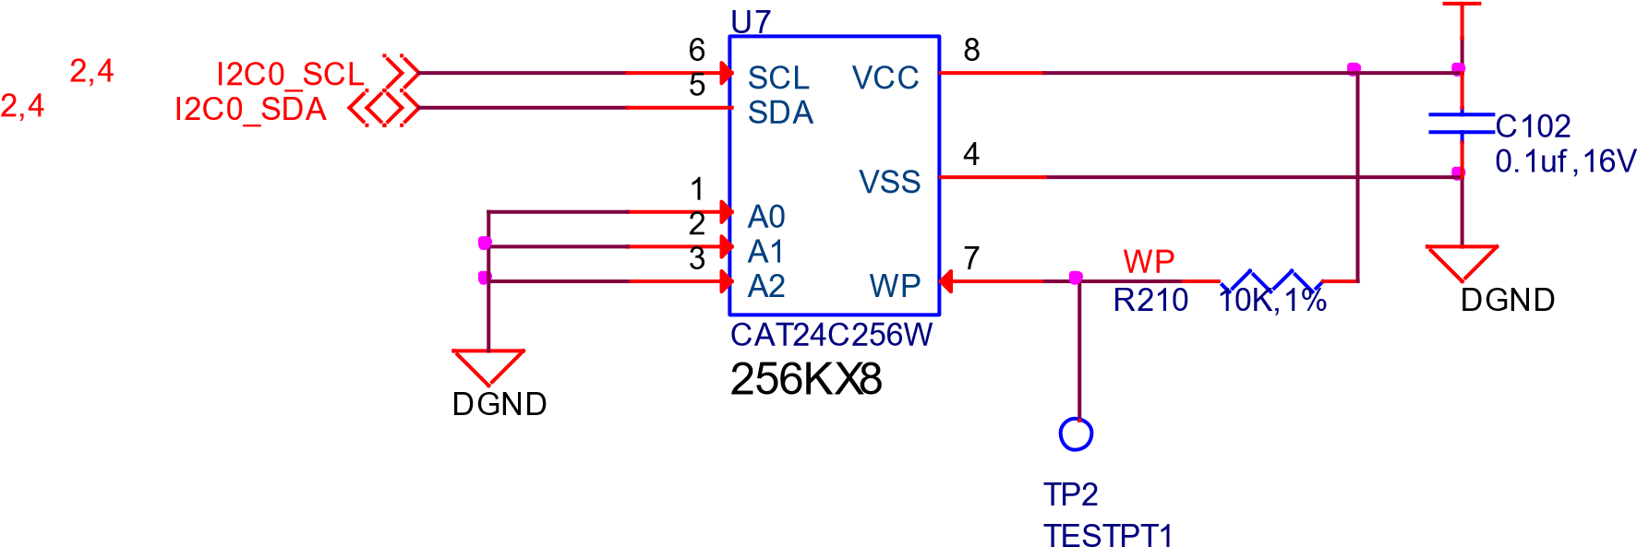
images/image79.png
