beagleboard/beaglebone-black/images/image80.png

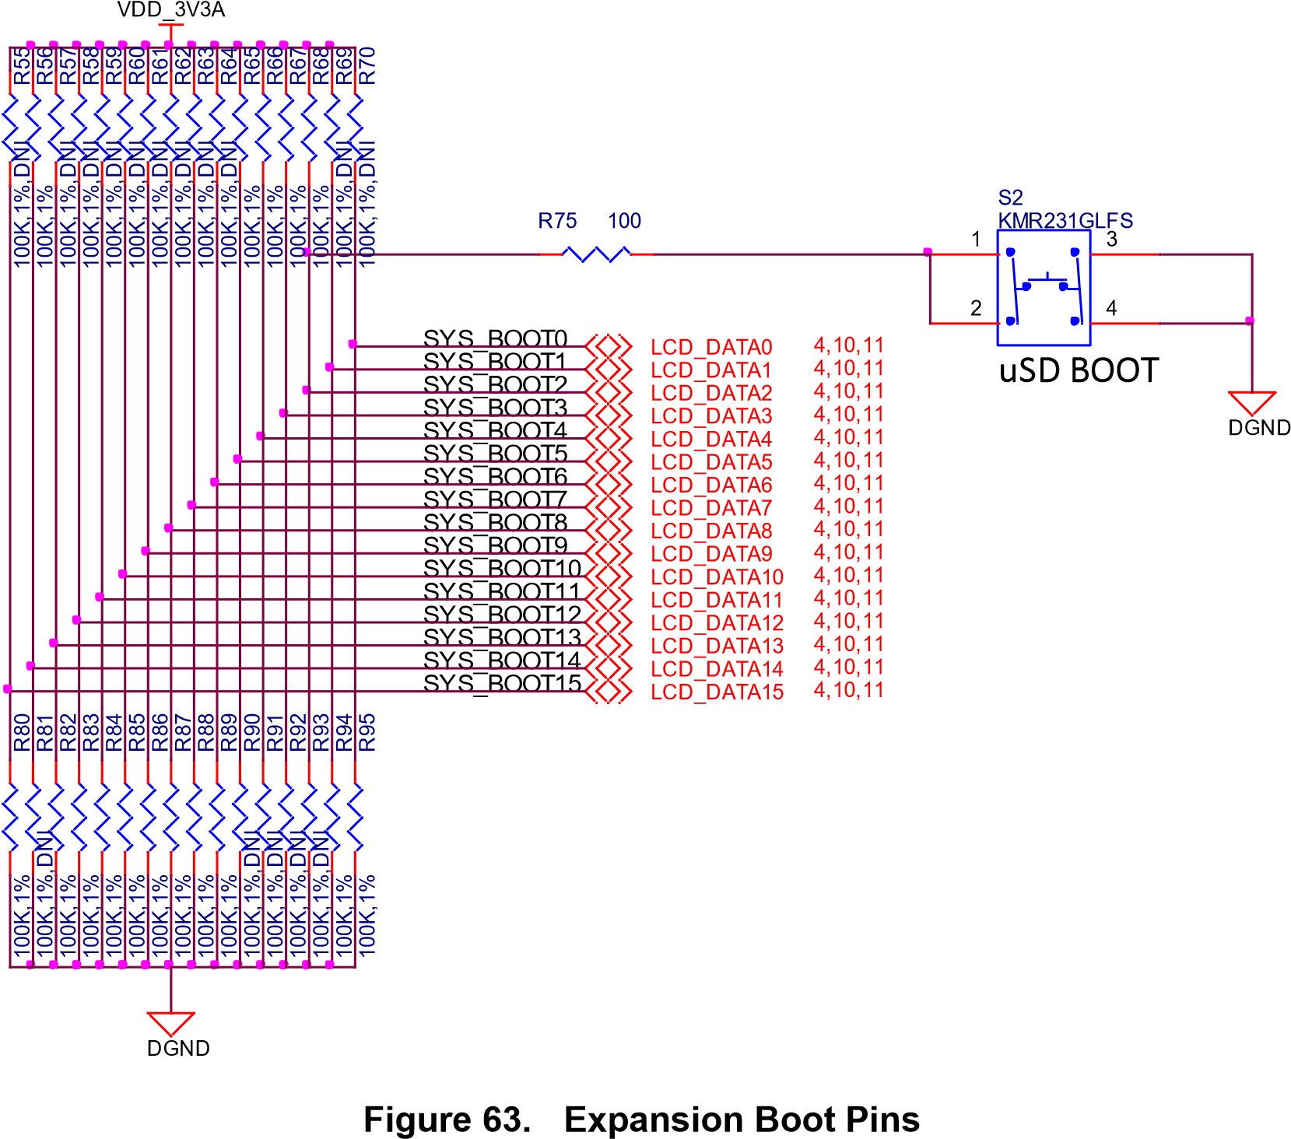
images/image80.png
