beagleboard/beaglebone-black/images/image87.jpg

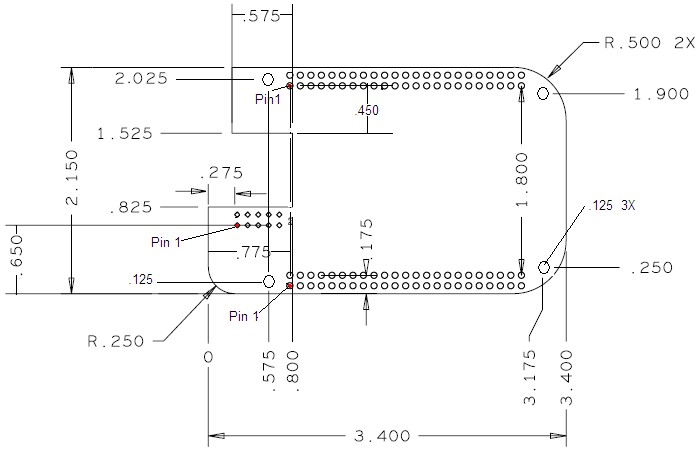
images/image87.jpg
