beagleboard/beaglebone-black/images/image88.jpg

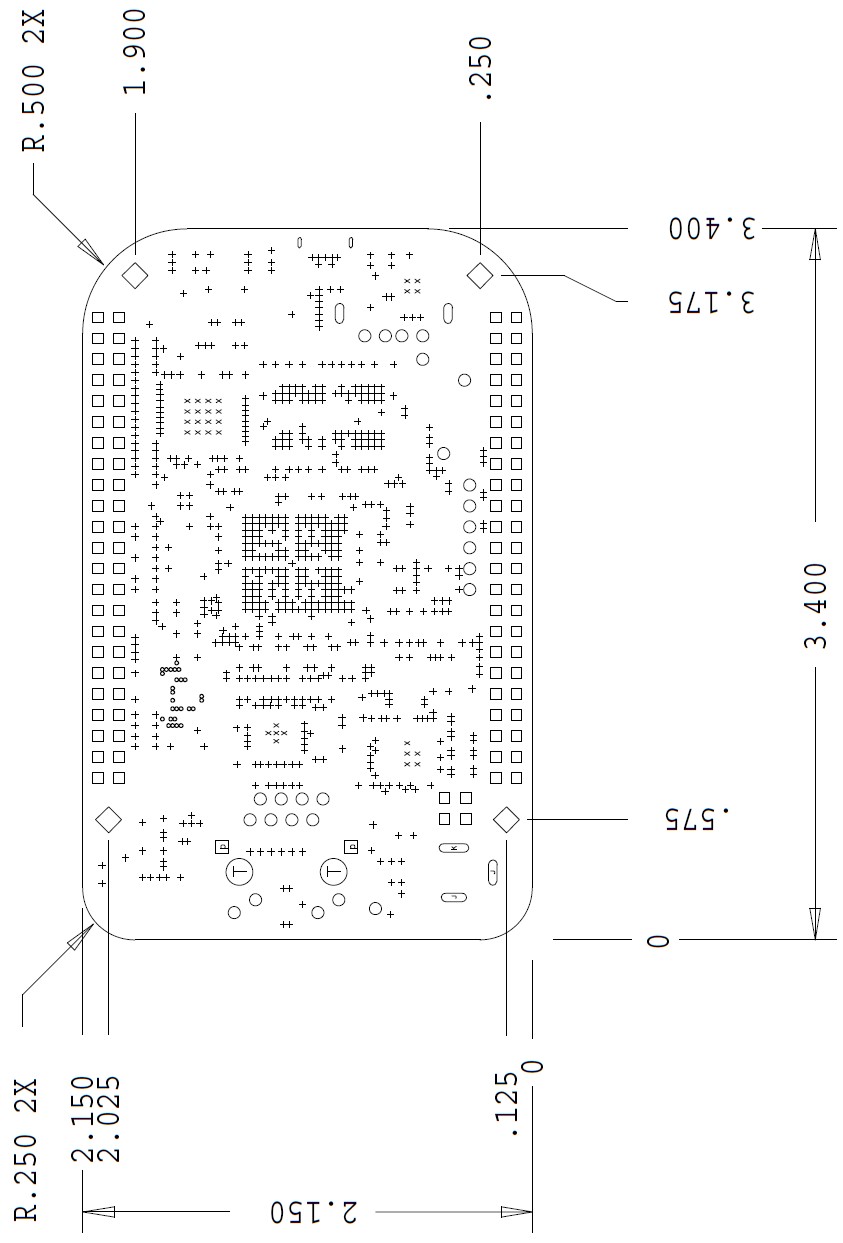
images/image88.jpg
