beagleboard/beaglebone-black/images/image89.jpg

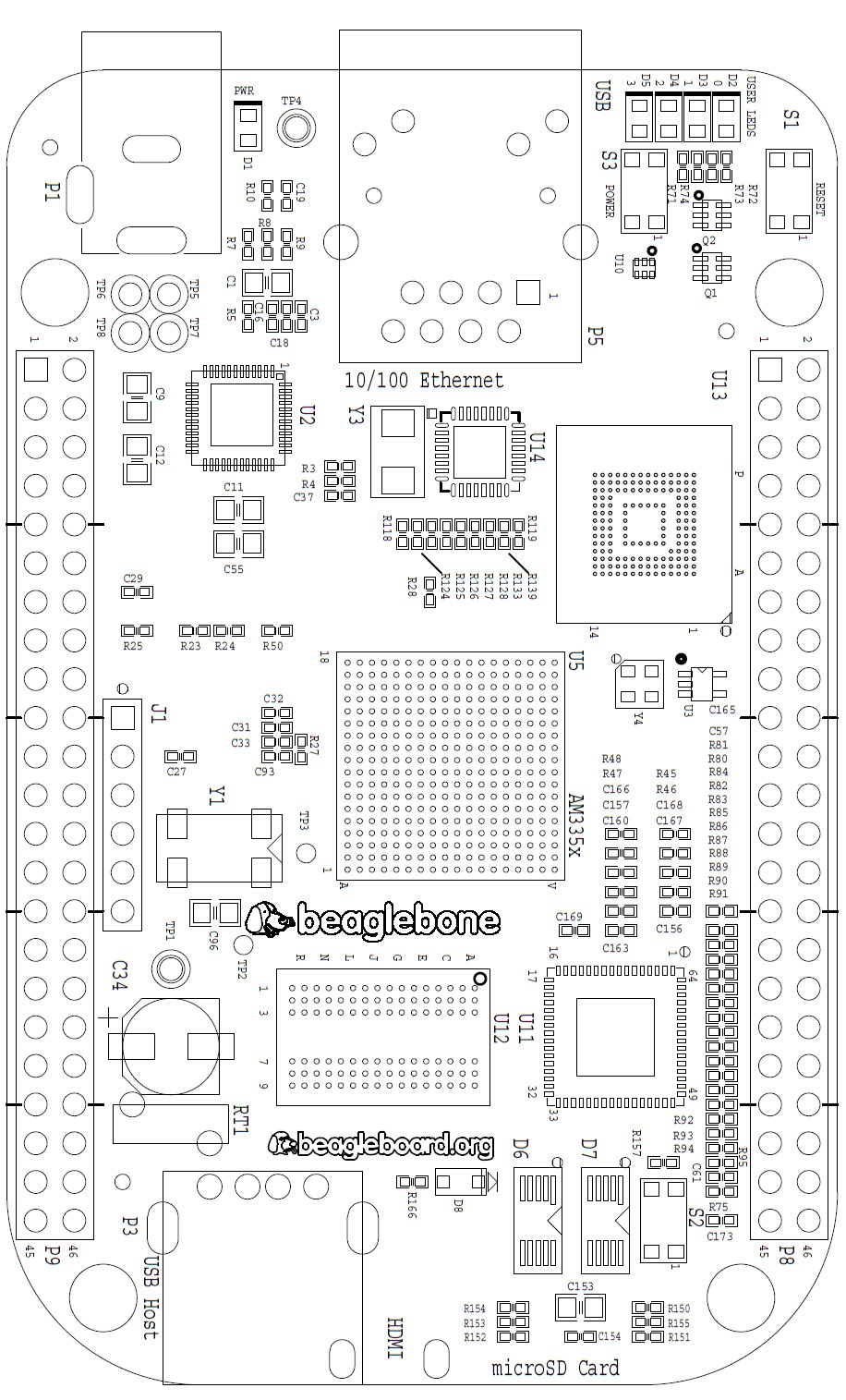
images/image89.jpg
