beagleboard/beaglebone-black/images/image90.jpg

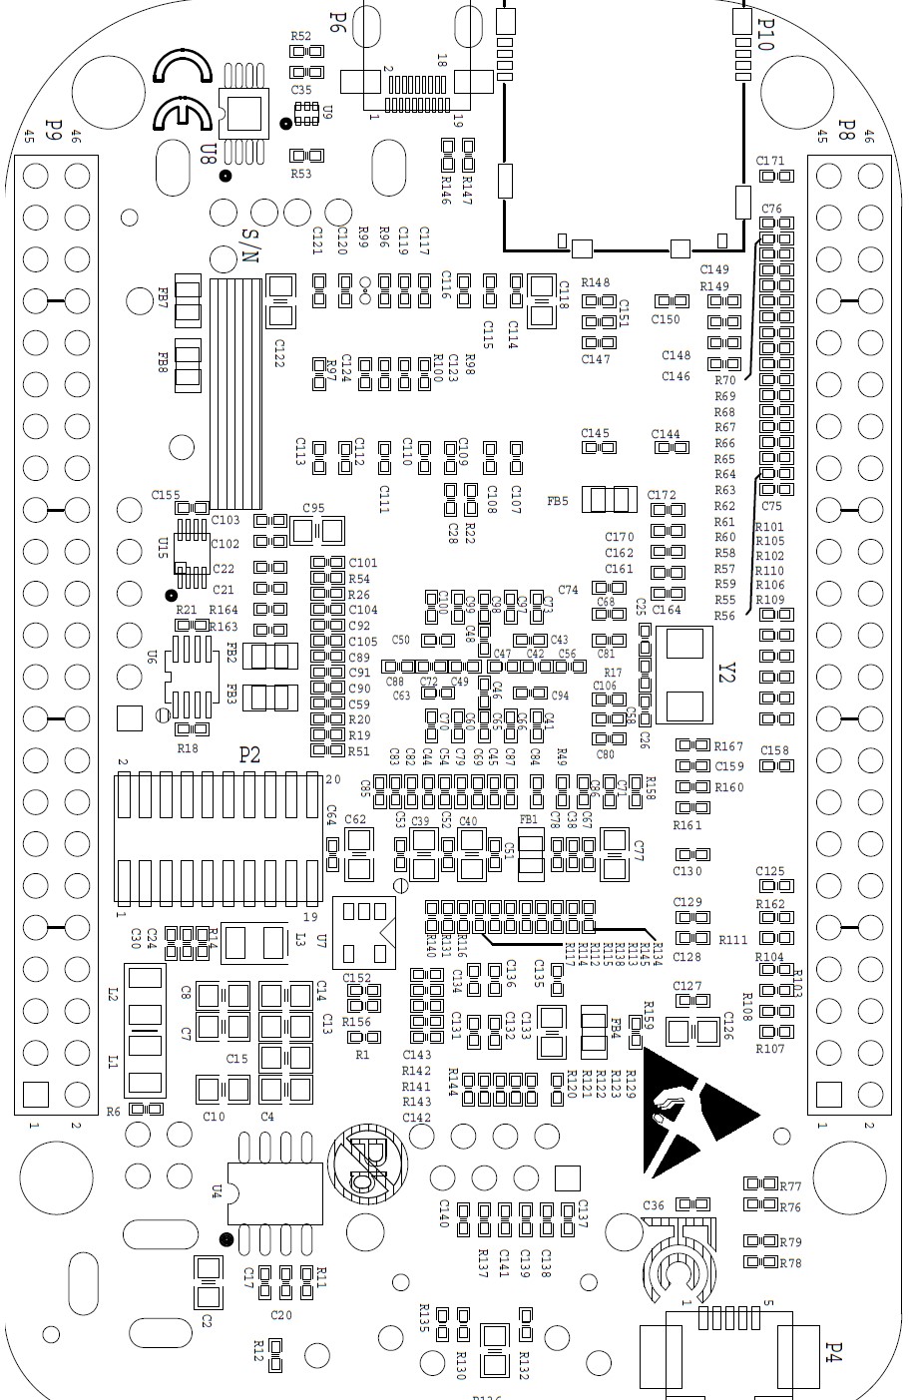
images/image90.jpg
