beagleboard/beaglebone-black/images/image91.jpg

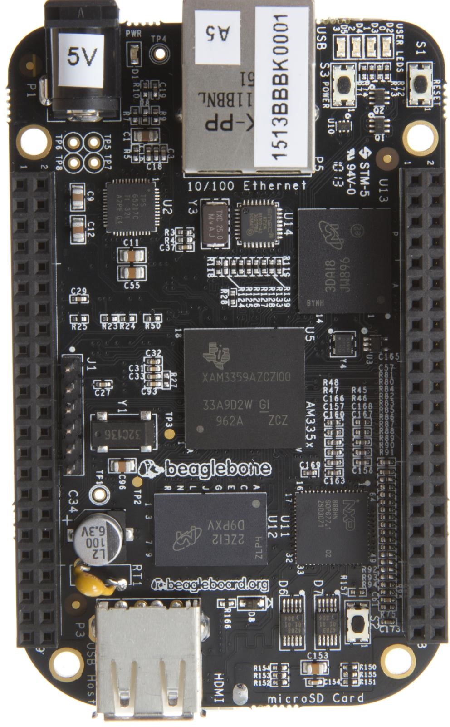
images/image91.jpg
