beagleboard/beaglebone-black/images/image92.jpg

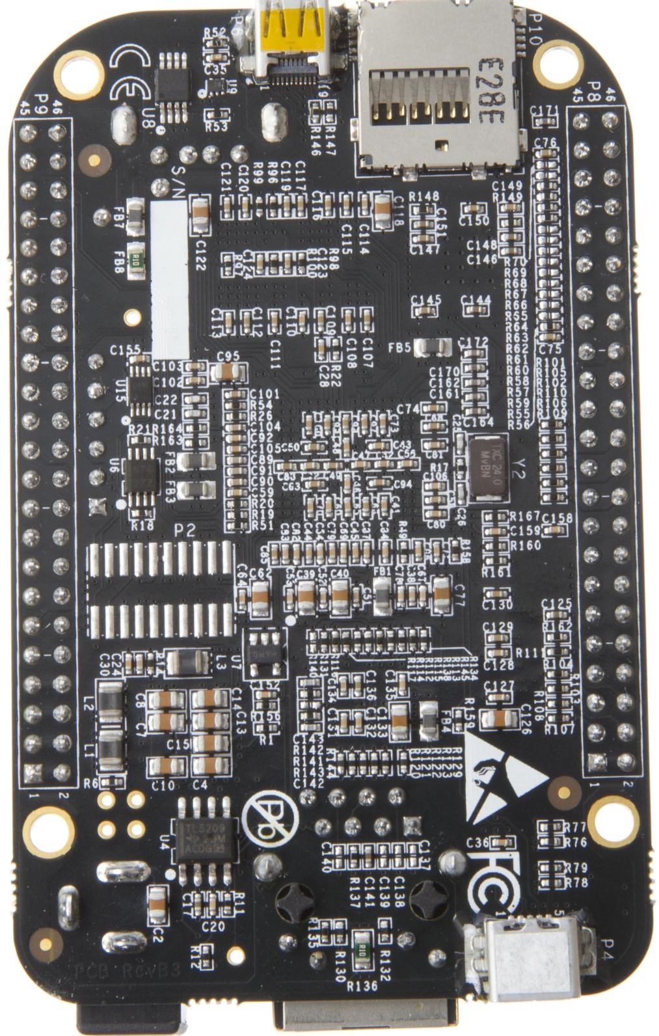
images/image92.jpg
