beagleboard/beaglebone-black/images/image93.jpg

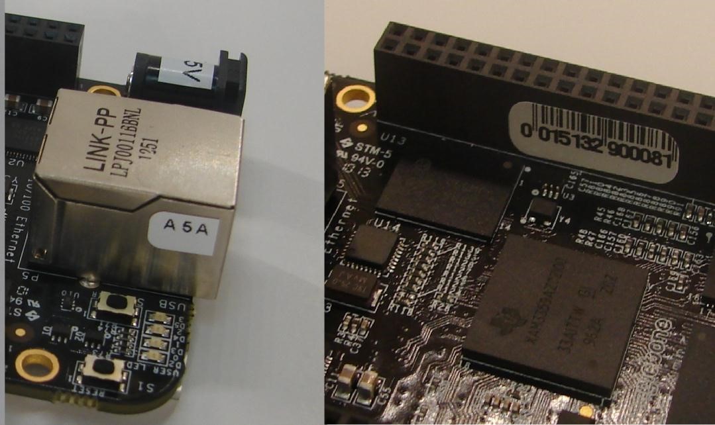
images/image93.jpg
