beagleboard/beaglebone-black/images/image94.jpg

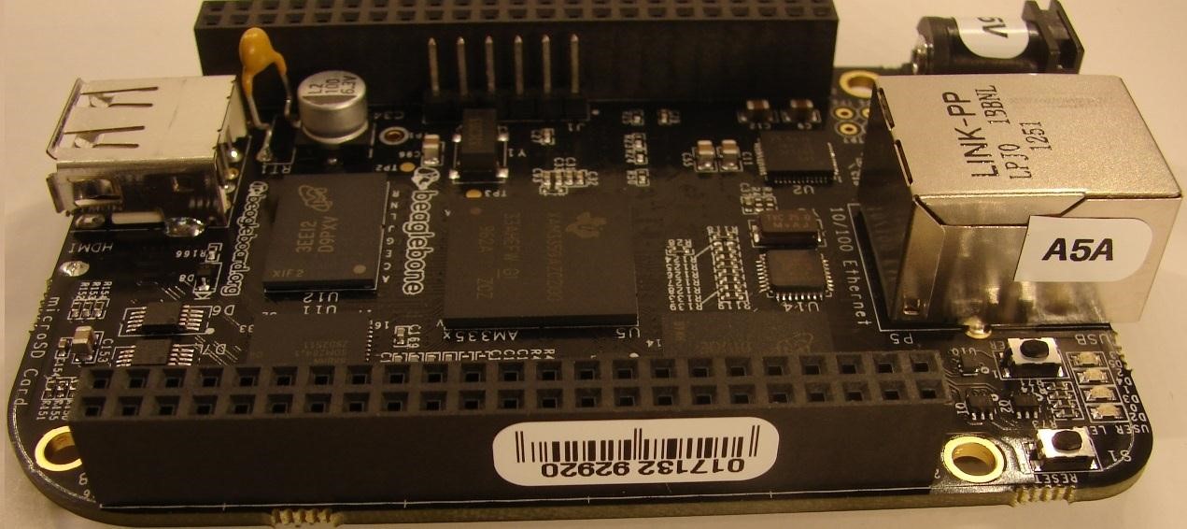
images/image94.jpg
