beagleboard/beaglebone-black/images/image95.jpg

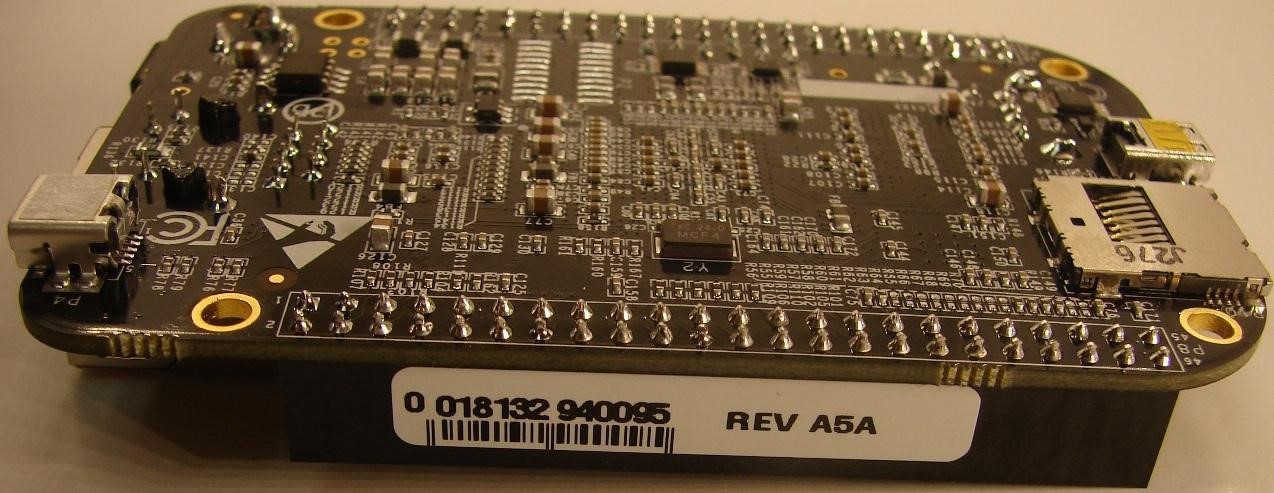
images/image95.jpg
