beagleboard/beaglebone-black/images/RevD-Schematic/AM335X-2O3.png

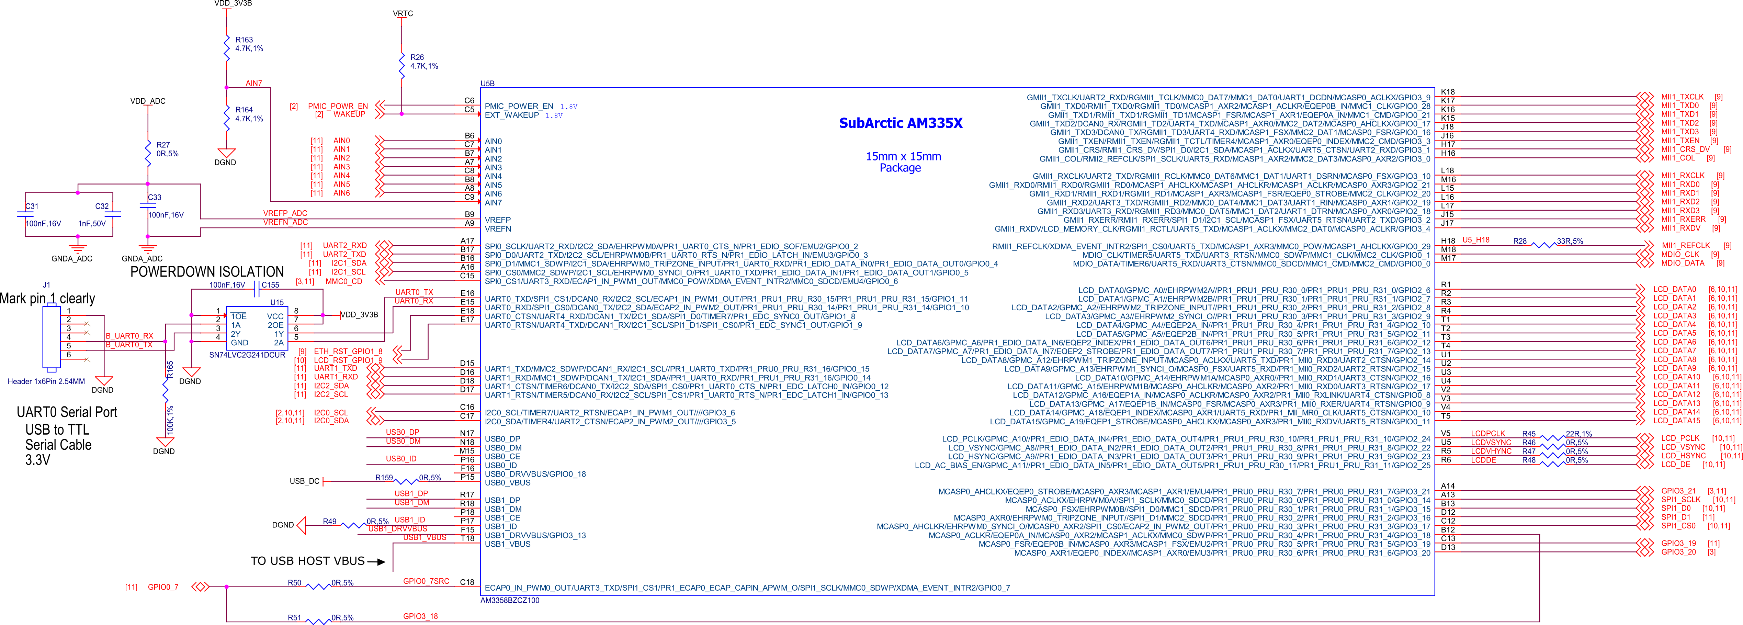
images/RevD-Schematic/AM335X-2O3.png
