beagleboard/beaglebone-black/images/RevD-Schematic/board-id.png

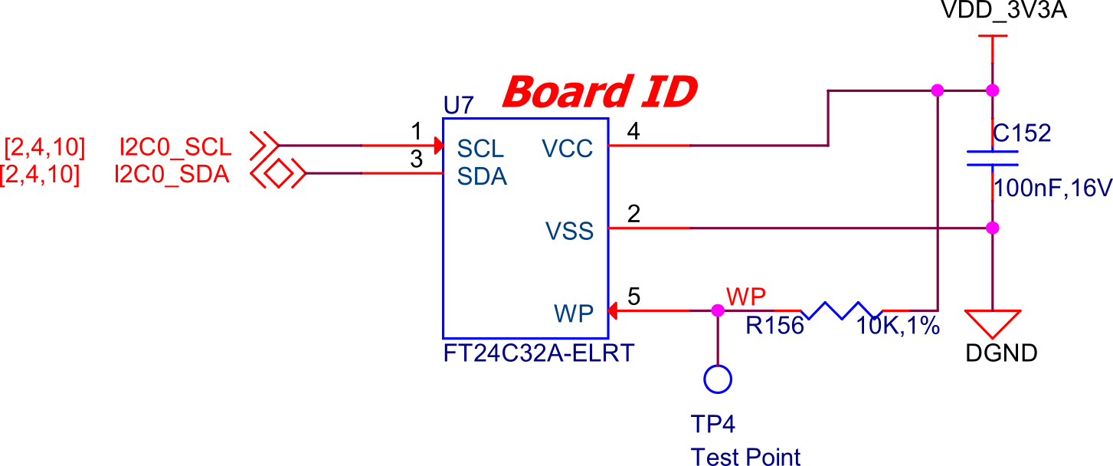
images/RevD-Schematic/board-id.png
