beagleboard/beaglebone-black/images/RevD-Schematic/eMMC.png

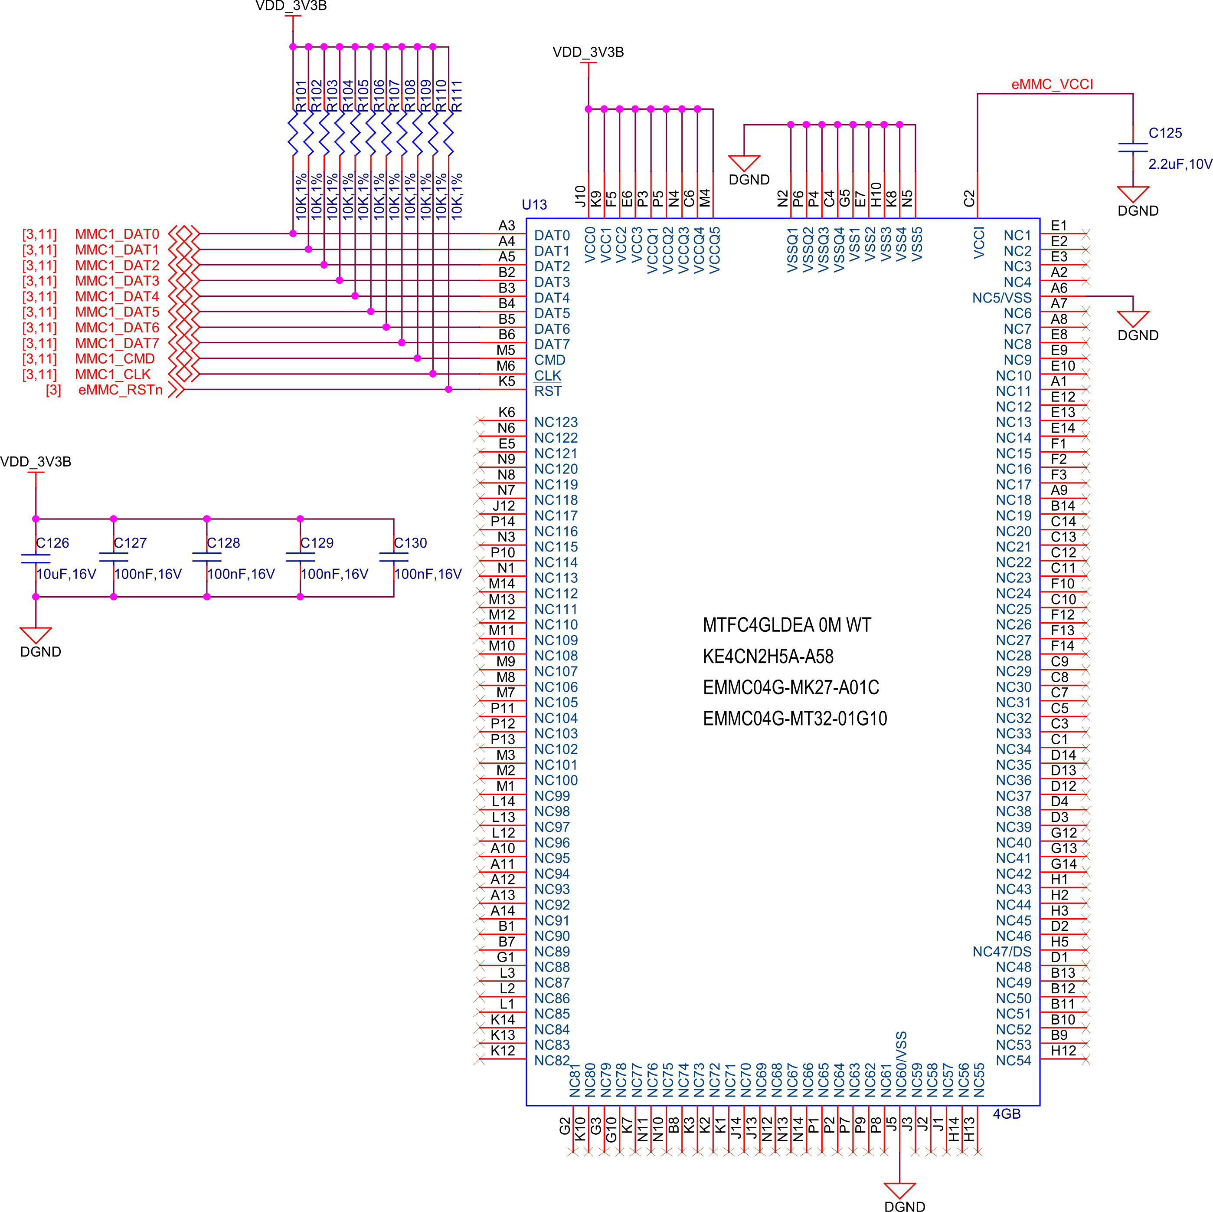
images/RevD-Schematic/eMMC.png
