beagleboard/beaglebone-black/images/RevD-Schematic/Ethernet-AND.png

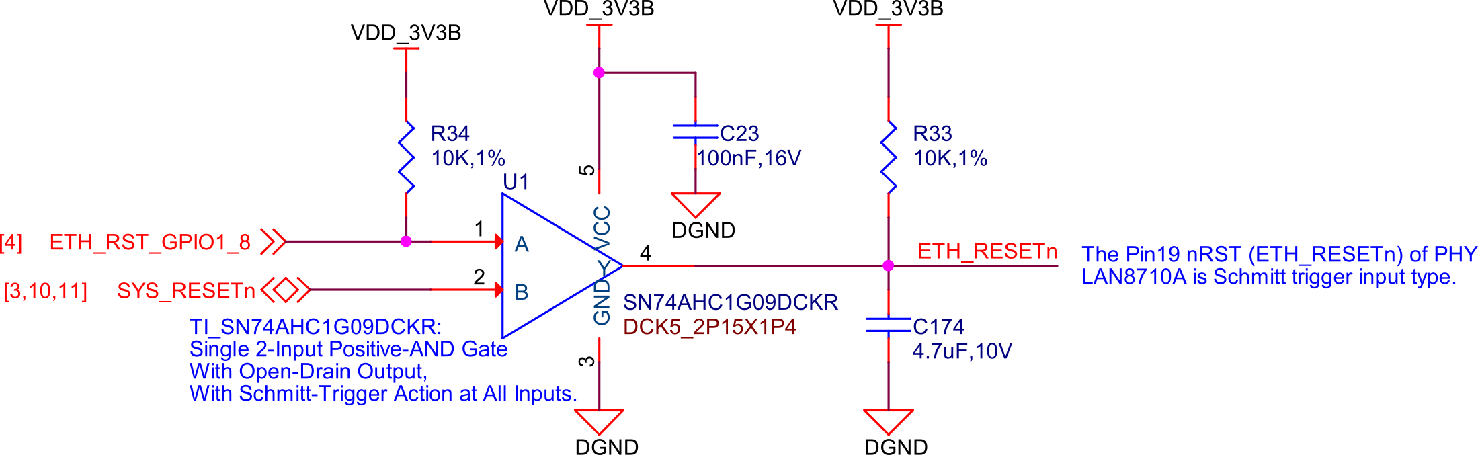
images/RevD-Schematic/Ethernet-AND.png
