beagleboard/beaglebone-black/images/RevD-Schematic/Ethernet-PU-PD.png

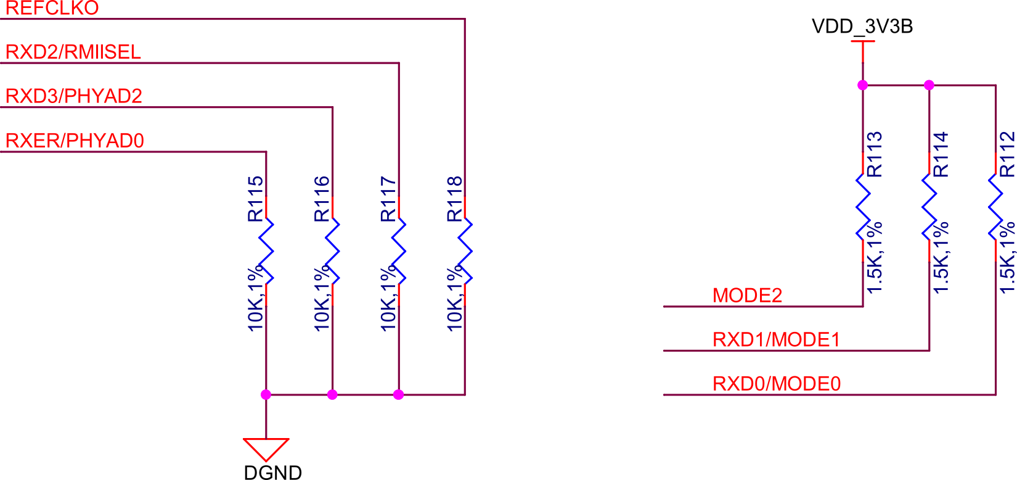
images/RevD-Schematic/Ethernet-PU-PD.png
