beagleboard/beaglebone-black/images/RevD-Schematic/Ethernet.png

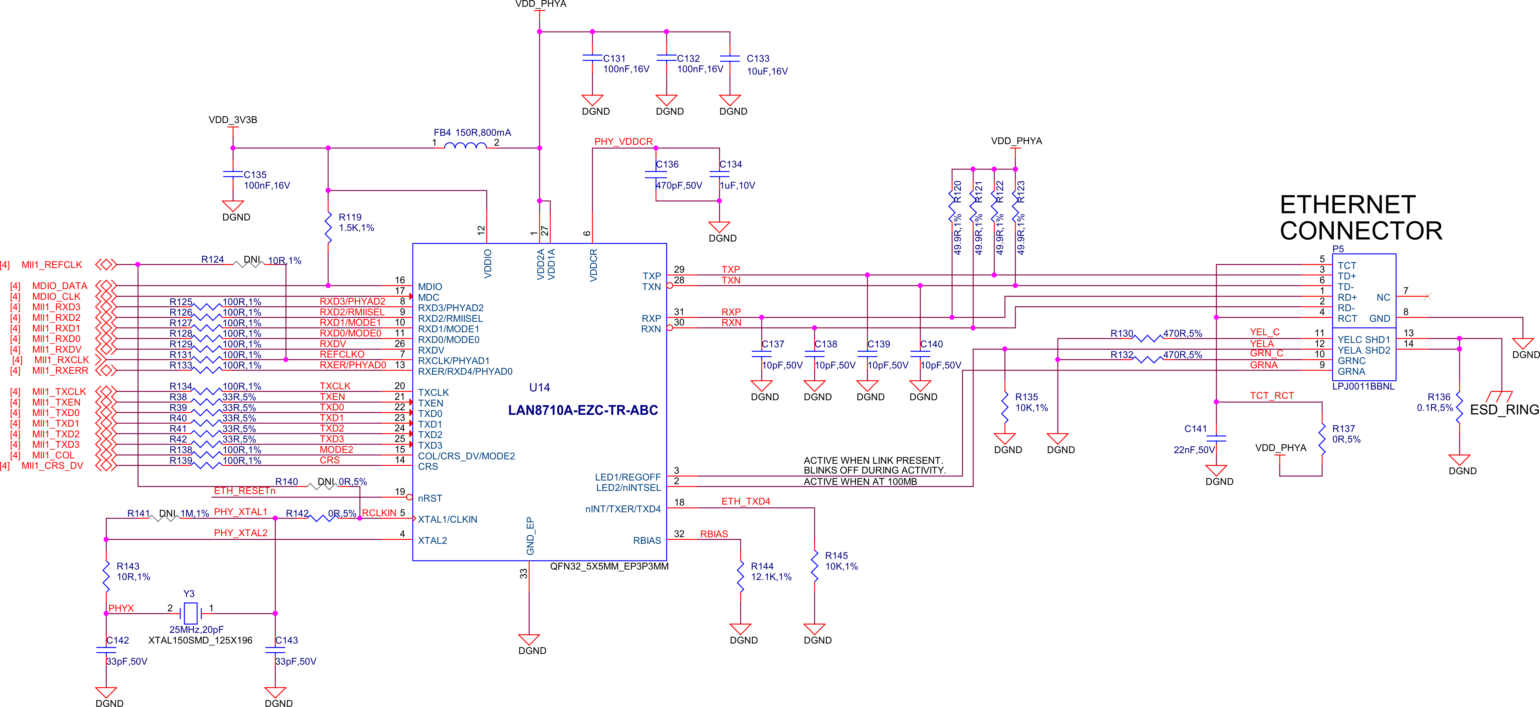
images/RevD-Schematic/Ethernet.png
