beagleboard/beaglebone-black/images/RevD-Schematic/HDMI-ESD.png

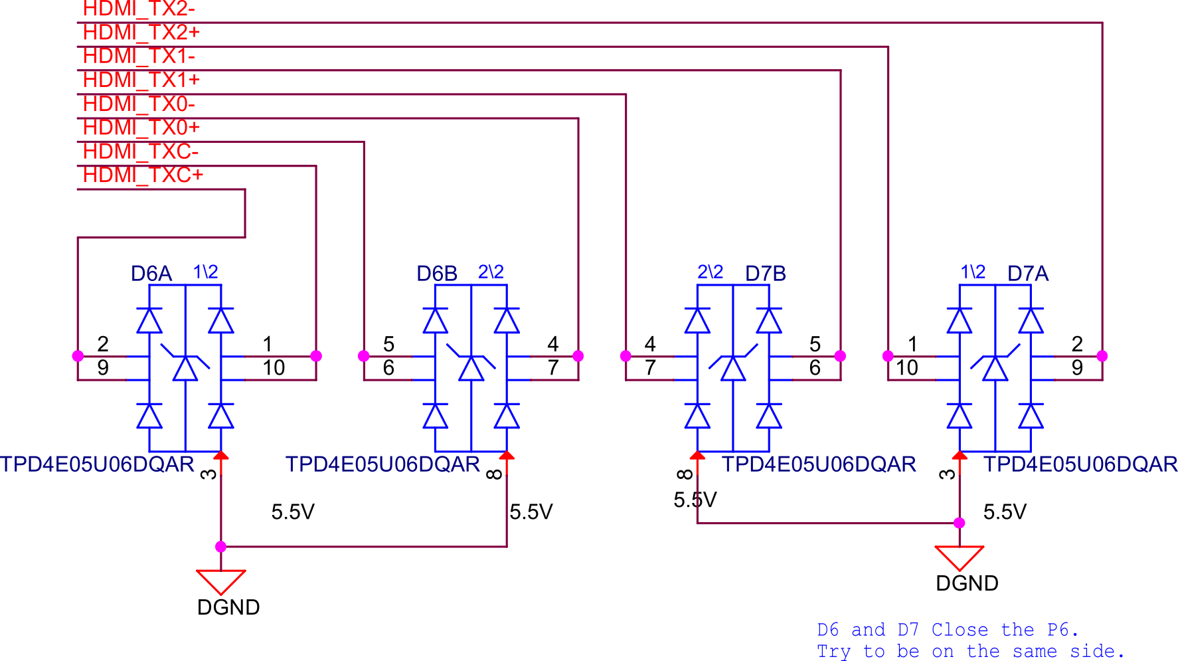
images/RevD-Schematic/HDMI-ESD.png
