beagleboard/beaglebone-black/images/RevD-Schematic/HDMI.png

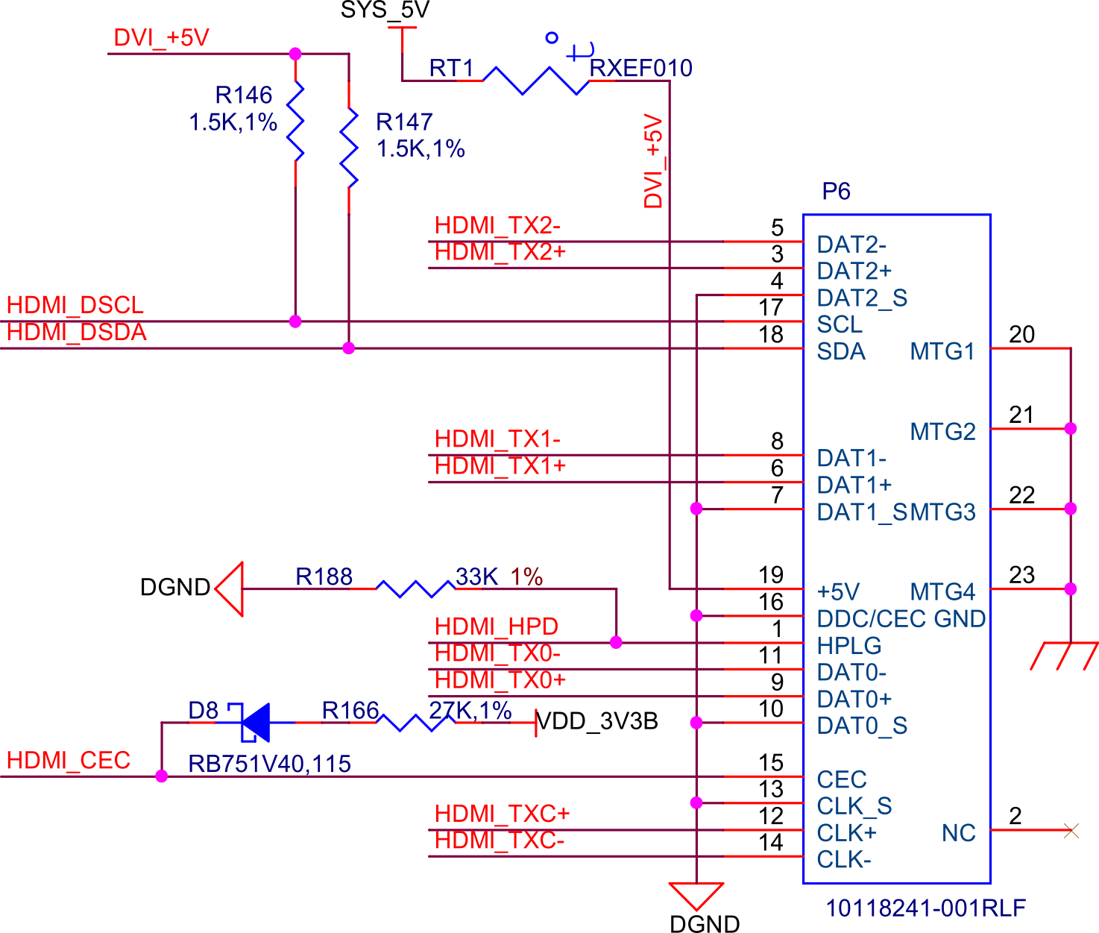
images/RevD-Schematic/HDMI.png
