beagleboard/beaglebone-black/images/RevD-Schematic/IT66122.png

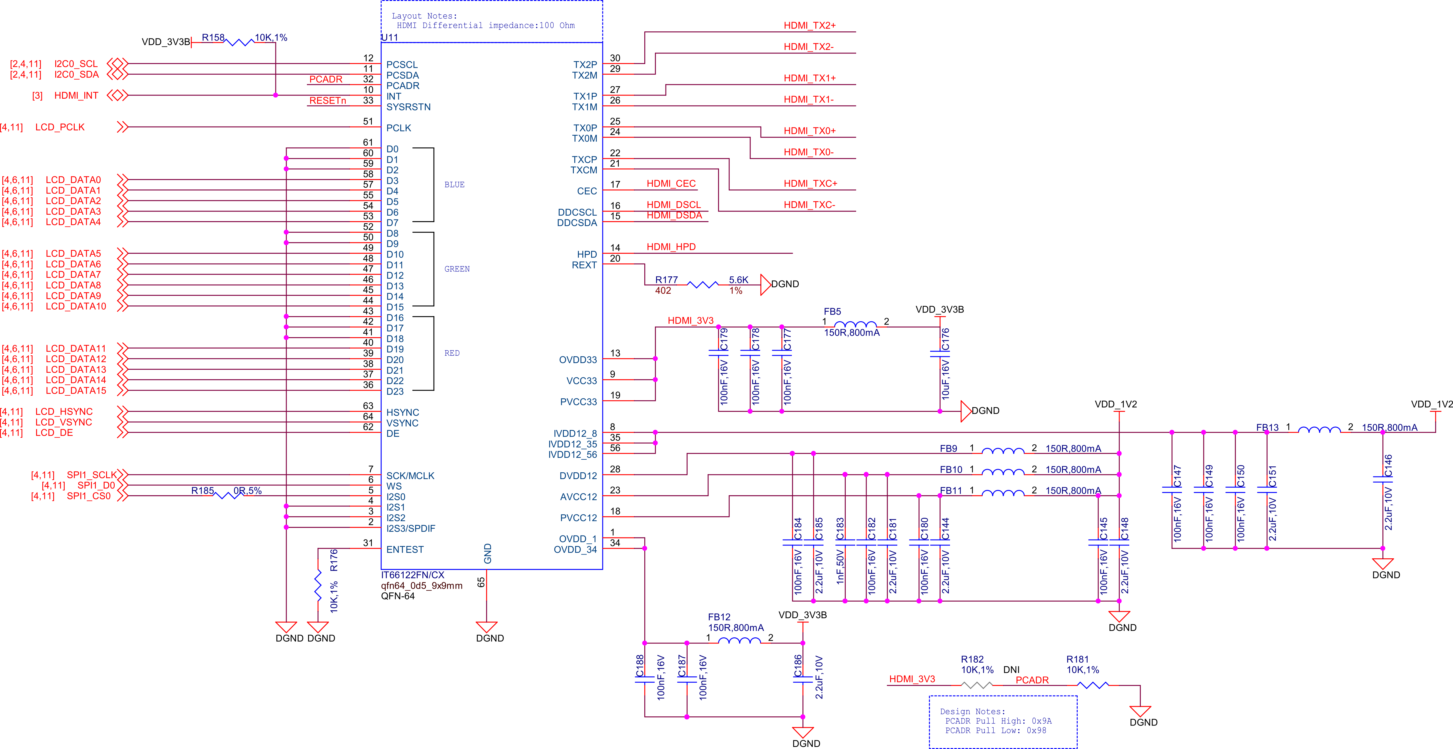
images/RevD-Schematic/IT66122.png
