beagleboard/beaglebone-black/images/RevD-Schematic/JTAG.png

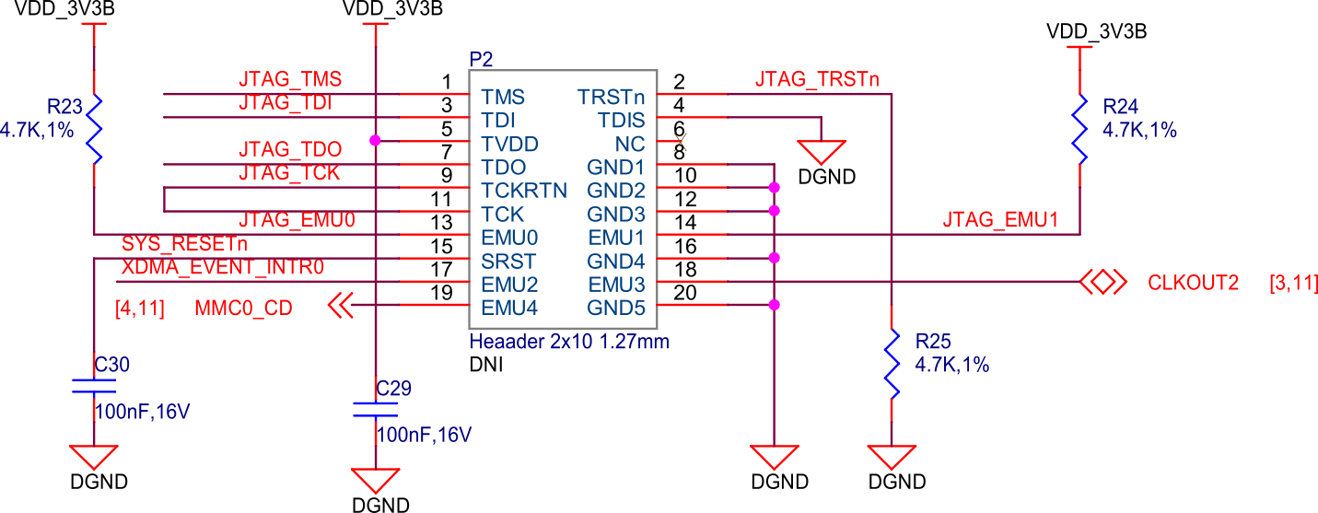
images/RevD-Schematic/JTAG.png
