beagleboard/beaglebone-black/images/RevD-Schematic/TL5209DR-VDD_3V3B.png

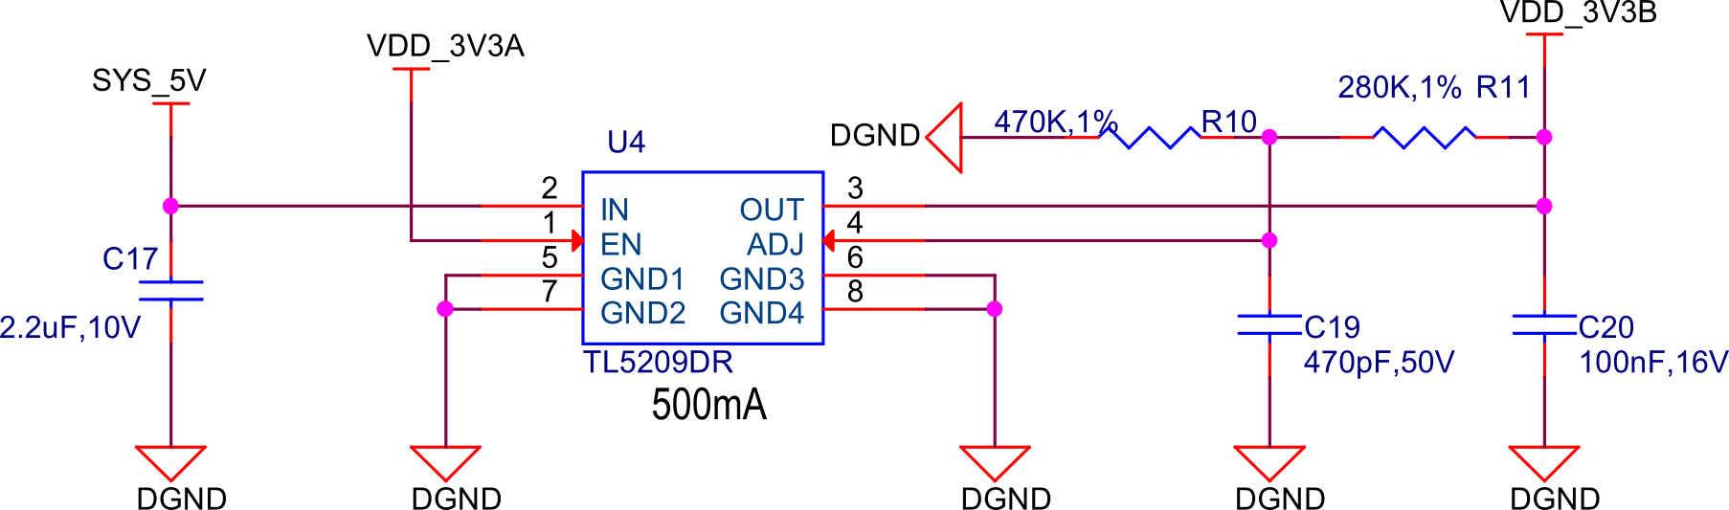
images/RevD-Schematic/TL5209DR-VDD_3V3B.png
