beagleboard/beaglebone-black/images/RevD-Schematic/TLV75512PDBVR-VDD_1V2.png

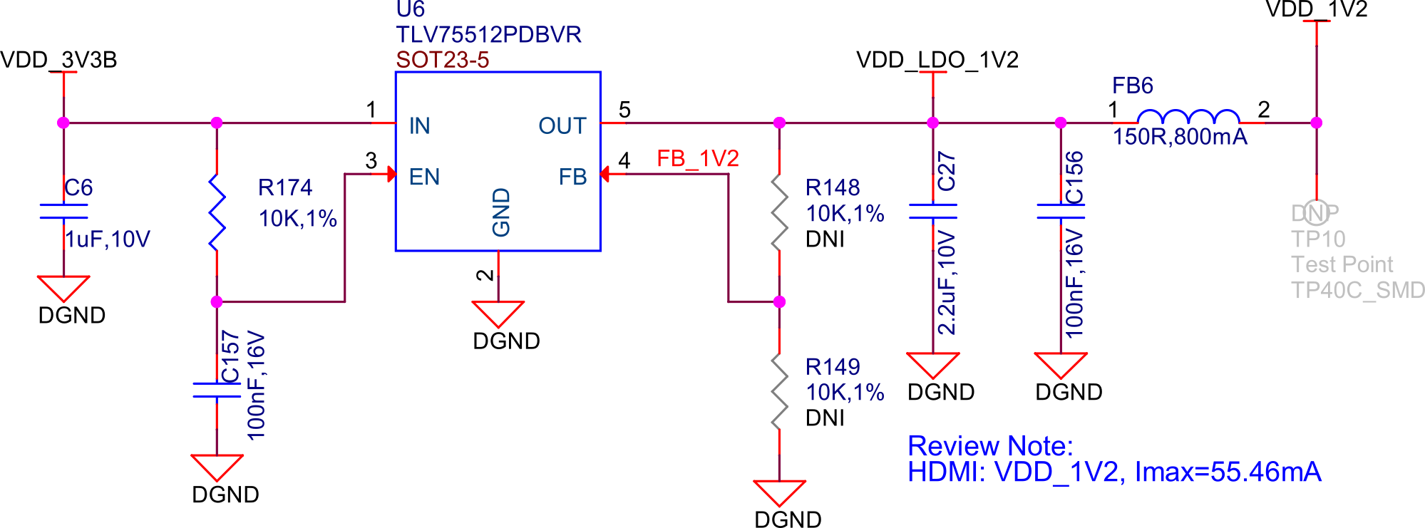
images/RevD-Schematic/TLV75512PDBVR-VDD_1V2.png
