beagleboard/beaglebone-black/images/RevD-Schematic/TPS65217CRSLR-PMIC.png

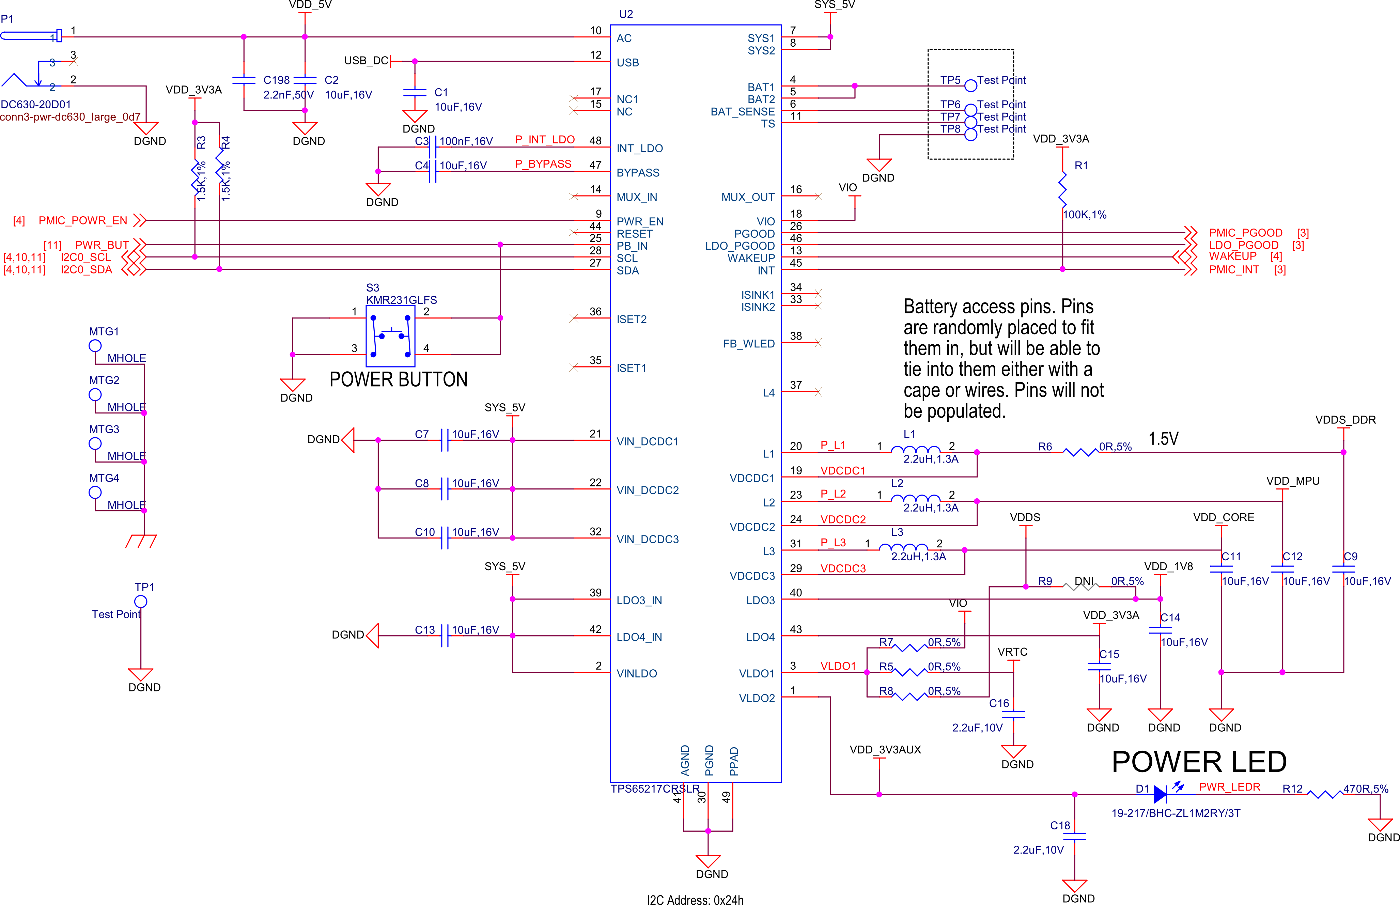
images/RevD-Schematic/TPS65217CRSLR-PMIC.png
