beagleboard/beaglebone-black/images/RevD-Schematic/USB-PC-Connector.png

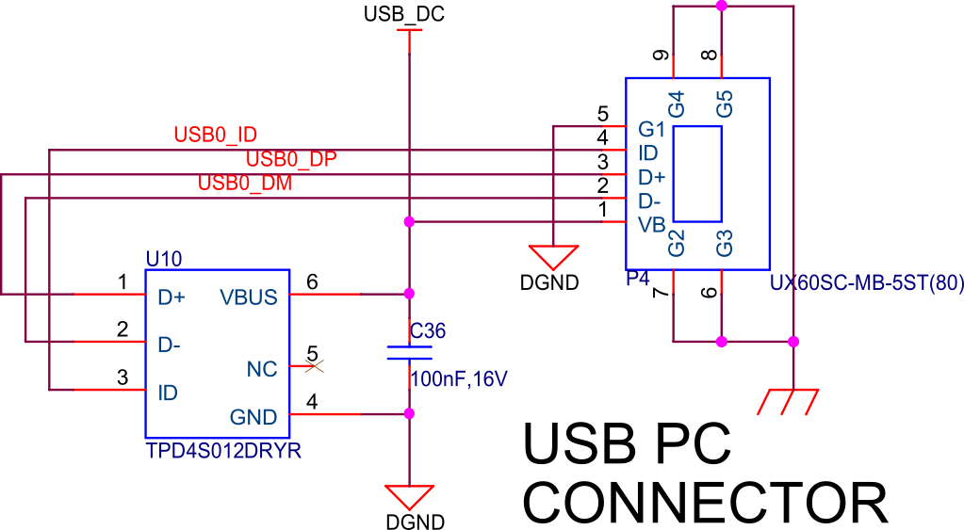
images/RevD-Schematic/USB-PC-Connector.png
