beagleboard/beaglebone-black/images/svg/BeagleBone-Black.jpg

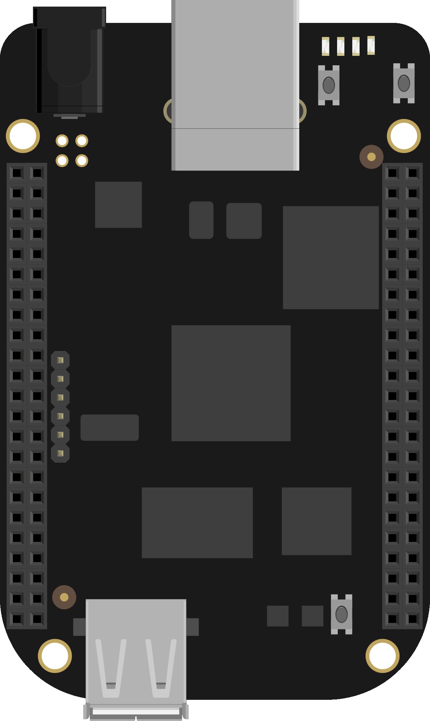
images/svg/BeagleBone-Black.jpg
