beagleboard/beaglebone-black/BBB_BOM.xls

SKU | Description | Manu. | MPN | Quantity | Designator | Working Temp.
310050079 | SMD IC Logic;SC-70-5 | TI | SN74LVC1G07DCKR | 1 | U16 | -40°C~125°C
320010900 | SMD USB2.0 Mini B Right Angle;5P+4P | HRS | UX60SC-MB-5ST(80) | 1 | P4 | -30°C~75°C
301010264 | SMD RES 0.1R-5%-1/8W;0805 | YAGEO | RL0805JR-070R1L | 1 | R136 | -55°C~155°C
320020078 | DIP Black Male Header VERT;1*6P-2.54-2.5-11.5/3.0mm | SINOTOP | ST-PH-254-0087-1*6P-6T | 1 | J1 | -40°C~105°C
303010128 | SMD Inductor 2.2uH-20%-1.3A;2P-2520 | Murata | LQM2HPN2R2MG0L | 3 | L1,L2,L3 | -55°C to 125°C
301010034 | SMD RES 33R-5%-1/16W;0402 | YAGEO | RC0402JR-0733RL | 24 | R2,R13,R15,R16,R18,R28,R31,R32,R35,R36,R38,R39,R40,R41,R42,R43,R44,R167,R168,R169,R170,R171,R172,R173 | -55°C~155°C
302010361 | SMD CAP Ceramic 10uF-16V-±10%-X5R;0805-D*Hmm | Samsung | CL21A106KOQNNNE | 25 | C1,C2,C4,C7,C8,C9,C10,C11,C12,C13,C14,C15,C39,C40,C55,C62,C77,C95,C96,C118,C122,C126,C133,C153,C176 | -55°C~85°C
302012819 | SMD CAP Ceramic 2.2uF-10V-10%-X5R;0402 | YAGEO | CC0402KRX5R6BB225 | 12 | C16,C17,C18,C27,C125,C144,C146,C148,C151,C181,C185,C186 | -55°C~85°C
320030424 | DIP Black Female Header;2*23P-2.54*8.5-3.0mm | SINOTOP | FF-1236 | 2 | P8,P9 | -40°C~105°C
306010085 | SMD Crystal;32.768KHz-12.5pF-20PPM-50K-8*3.8*2.5mm;SOJ-4 | Abracon | ABS25-32.768KHZ-T | 1 | Y1 | -40°C~85°C
320140216 | DIP RJ45 W/P-10/100M;12P-21.25*15.93*13.3mm | LINK-PP | LPJ0011BBNL | 1 | P5 | 0°C~70°C
310030210 | SMD IC PMIC;LDO-ADJ-500mA;SOIC-8 | TI | TL5209DR | 1 | U4 | -40°C~125°C
310050078 | SMD IC Logic;US8(8-VFSOP | TI | SN74LVC2G241DCUR | 1 | U15 | -40°C~125°C
306011584 | SMD Crystal;24MHz-20pF-10ppm-2P-5*3.2*0.8mm | JingYi | HF24000012 | 1 | Y2 | -40°C~85°C
310091066 | (BB) SMD IC Memory-DDR3L 4 Gb(256M x 16)-1866 Mbps-13.5*7.5*1.2mm;FBGA-96 | Kingston | D2516ECMDXGJD-U | 1 | U12 | 0°C~95°C
301010642 | SMD RES;280K-1%-1/16W-0402 | YAGEO | RC0402FR-07280KL | 1 | R11 | -55°C~155°C
302010016 | SMD CAP Ceramic 18pF-50V-5%-NPO;0402 | YAGEO | CC0402JRNPO9BN180 | 2 | C21,C22 | -55°C~125°C
302010001 | SMD CAP Ceramic 10pF-50V-5%-NPO;0402 | YAGEO | CC0402JRNPO9BN100 | 4 | C137,C138,C139,C140 | -55°C~125°C
301010441 | SMD RES 33K-1%-1/16W;0402 | YAGEO | RC0402FR-0733KL | 1 | R188 | -55°C~155°C
301010047 | SMD RES 10K-1%-1/16W;0402 | YAGEO | RC0402FR-0710KL | 40 | R14,R21,R33,R34,R52,R53,R54,R96,R98,R100,R101,R102,R103,R104,R105,R106,R107,R108,R109,R110,R111,R115,R116,R117,R118,R135,R145,R150,R151,R152,R153,R154,R155,R156,R157,R158,R174,R176,R181,R183 | -55°C~155°C
310071146 | SMD IC Ethernet 1-CH Transceiver 10Mbps/100Mbps ;SQFN-32 | Microchip | LAN8710A-EZC-TR-ABC | 1 | U14 | 0°C~85°C
302010010 | SMD CAP Ceramic 470pF-50V-10%-X7R;0402 | YAGEO | CC0402KRX7R9BB471 | 2 | C19,C136 | -55°C~125°C
302010407 | SMD CAP Ceramic 4.7uF-10V-10%-X5R;0402 | YAGEO | CC0402KRX5R6BB475 | 1 | C174 | -55°C~85°C
302030050 | SMD CAP Aluminum 100uF-10V;D6.3*H5.4mm | ST | CS1A101M-CRE54 | 1 | C34 | -40°C~105°C
302010000 | SMD CAP Ceramic 33pF-50V-5%-NPO;0402 | YAGEO | CC0402JRNPO9BN330 | 2 | C142,C143 | -55°C~125°C
301010546 | SMD RES;5.6K-1%-1/10W-0402 | Vishay | CRCW04025K60FKED | 1 | R177 | -55°C~155°C
310050077 | SMD IC Logic;SC-70-5 | TI | SN74LVC1G06DCKR | 1 | U3 | -40°C~125°C
301010000 | SMD RES 0R-5%-1/16W;0402 | YAGEO | RC0402JR-070RL | 24 | R5,R6,R7,R8,R19,R20,R27,R29,R30,R37,R46,R47,R48,R49,R50,R51,R137,R142,R159,R160,R161,R162,R175,R185 | -55°C~155°C
310030209 | SMD IC PMIC;VQFN-48 | TI | TPS65217CRSLR | 1 | U2 | -40°C~105°C
303030029 | SMD Ferrite Bead;150R-800mA-0805 | Laird | LI0805H151R-10 | 12 | FB1,FB2,FB3,FB4,FB5,FB6,FB7,FB9,FB10,FB11,FB12,FB13 | -40°C~125°C
310051111 | SMD IC Logic;Single 2–Input Positive-AND Gate With Open-Drain Output;SC-70-5 | TI | SN74AHC1G09DCKR | 2 | U1,U17 | -55°C~125°C
301010444 | SMD RES 10R-1%-1/16W;0402 | YAGEO | RC0402FR-0710RL | 1 | R143 | -55°C~155°C
320011322 | DIP USB Conn;TYPE-A-Female R/A-USB 2.0-1Port;4P+2P-L14.2*W14.1*H7mm | SUNGTECH | ST-USB-003AT-30 | 1 | P3 | -55°C~85°C
304020767 | SMD Diode Schottky 40V-120mA;SOD-323 | NXP | RB751V40,115 | 1 | D8 | -65°C~150°C
304090045 | SMD LED Clear-Blue;0603 | Everlight | 19-217/BHC-ZL1M2RY/6T | 5 | D1,D2,D3,D4,D5 | -40°C~85°
301011475 | SMD RES 240R-1%-1/16W;0402 | YAGEO | RC0402FR-07240RL | 1 | R99 | -55°C~155°C
301010567 | SMD RES 1.5K-1%-1/16W;0402 | YAGEO | RC0402FR-071K5L | 9 | R3,R4,R97,R112,R113,R114,R119,R146,R147 | -55°C~155°C
301010633 | SMD RES;4.7K-1%-1/16W-0402 | YAGEO | RC0402FR-074K7L | 6 | R23,R24,R25,R26,R163,R164 | -55°C~155°C
302010022 | SMD CAP Ceramic 2.2nF-50V-10%-X7R;0402 | YAGEO | CC0402KRX7R9BB222 | 6 | C192,C194,C195,C196,C197,C198 | -55°C~125°C
310032772 | SMD IC PMIC;LDO-1.2V-500mA;SOT23-5 | TI | TLV75512PDBVR | 1 | U6 | -40°C~125°C
301010013 | SMD RES 470R-5%-1/16W;0402 | YAGEO | RC0402JR-07470RL | 3 | R12,R130,R132 | -55°C~155°C
306020923 | SMD Oscillator;24.576MHz-50ppm-3.3V-4P-2.5*2*1mm | ECEC | DS24576007 | 1 | Y4 | -40°C~85°C
301010442 | SMD RES 100R-1%-1/16W;0402 | YAGEO | RC0402FR-07100RL | 11 | R75,R125,R126,R127,R128,R129,R131,R133,R134,R138,R139 | -55°C~155°C
302010242 | SMD CAP Ceramic 22nF-50V-10%-X7R;0402 | YAGEO | CC0402KRX7R9BB223 | 1 | C141 | -55°C~125°C
302010007 | SMD CAP Ceramic 47pF-50V-5%-NP0;0402 | YAGEO | CC0402JRNPO9BN470 | 16 | C161,C162,C163,C164,C165,C166,C167,C168,C169,C170,C171,C172,C173,C189,C190,C191 | -55°C~125°C
304050020 | SMD Diode TVS;4-Ch USB ESD Solution with-SON-6（1.45x1） | TI | TPD4S012DRYR | 2 | U9,U10 | -40°C to 85°C
319016319 | PCB;BeagleBone Black Commercial RevD_250421-Black-6L |  |  | 1
302010004 | SMD CAP Ceramic 100nF-16V-10%-X7R;0402 | YAGEO | CC0402KRX7R7BB104 | 110 | C3,C20,C23,C28,C29,C30,C31,C33,C35,C36,C37,C38,C41,C42,C43,C44,C45,C46,C47,C48,C49,C50,C51,C52,C53,C54,C56,C57,C58,C59,C60,C61,C63,C64,C65,C66,C67,C68,C69,C70,C71,C72,C73,C74,C75,C76,C78,C79,C80,C81,C82,C83,C84,C85,C86,C87,C88,C92,C93,C94,C97,C98,C99,C100,C101,C102,C103,C105,C107,C108,C109,C110,C111,C112,C113,C114,C115,C116,C117,C119,C120,C121,C124,C127,C128,C129,C130,C131,C132,C135,C145,C147,C149,C150,C152,C154,C155,C156,C157,C158,C159,C160,C177,C178,C179,C180,C182,C184,C187,C188 | -55°C~125°C
301011877 | SMD RES 12.1K-1%-1/16W;0402 | YAGEO | RC0402FR-0712K1L | 1 | R144 | -55°C~155°C
302013681 | SMD CAP Ceramic;30pF-50V-5%-NP0;0402 | YAGEO | CC0402JRNPO9BN300 | 2 | C25,C26 | -55°C~125°C
302013249 | SMD CAP Ceramic 1uF-10V-10%-X5R;0402 | Samsung | CL05A105KP5NNNC | 8 | C6,C89,C90,C91,C104,C106,C134,C193 | -55°C~85°C
320010901 | SMD HDMI Type D Right Angle;SMT+DIP-19P | Amphenol | 10118241-001RLF | 1 | P6 | -40°C to 85°C
304060074 | SMD Diode ESD 0.05pF;0402 | Semitel | ESDPSA0402V05 | 5 | D9,D10,D11,D12,D13 | -40°C~90°C
310030211 | SMD IC PMIC;MSOP-8 | TI | TPS2051BDGNR | 1 | U8 | -40°C~85°C
310091347 | SMD IC Memory;32Kb-IIC Serial EEPROM;SOT23-5 | FMD | FT24C32A-ELRT | 1 | U7 | -40°C~85°C
320120067 | DIP DC Power Jack;3P-2.0-6.3mm;L9*14.7*H11mm | M&T | DC630-20D01 | 1 | P1 | -40°C~85°C
307010055 | DIP PPTC;100mA-60V;2P-5.0-W7.4*T3.0mm | Littelfuse | RF2579-000 | 1 | RT1 | -40°C~85°C
305050004 | SMD Transistor Array 2 NPN-50V-100mA-SOT-363 | Diodes | DDC114YU-7-F | 2 | Q1,Q2 | -55°C~155°C
306011585 | SMD Crystal;25MHz-20pF-10ppm-2P-5*3.2*0.8mm | JingYi | HF25000014 | 1 | Y3 | -40°C~85°C
310010099 | SMD IC MCU;NFBGA-324(15x15） | TI | AM3358BZCZ100 | 1 | U5 | -40°C~105°C
301010456 | SMD RES 100K-1%-1/16W;0402 | YAGEO | RC0402FR-07100KL | 22 | R1,R56,R65,R66,R67,R68,R76,R77,R78,R79,R80,R82,R83,R84,R85,R86,R87,R88,R89,R94,R95,R165 | -55°C~155°C
302010005 | SMD CAP Ceramic 1nF-50V-10%-X7R;0402 | YAGEO | CC0402KRX7R9BB102 | 3 | C32,C123,C183 | -55°C~125°C
301010067 | SMD RES 27K-1%-1/16W;0402 | YAGEO | RC0402FR-0727KL | 1 | R166 | -55°C~155°C
301010043 | SMD RES 1M-1%-1/16W;0402 | YAGEO | RC0402FR-071ML | 1 | R17 | -55°C~155°C
320090416 | SMD SD Card Holder;Reverse-Bottom,8P-14.3*16mm | YuLiang | YL004-030-001 | 1 | P10 | -25°C~85°C
304060294 | SMD Diode Array ESD;4 Channel,6 Gbps,5.5V;USON-10 | TI | TPD4E05U06DQAR | 2 | D6,D7 | -40°C~125°C
301010069 | SMD RES 470K-1%-1/16W;0402 | YAGEO | RC0402FR-07470KL | 1 | R10 | -55°C~155°C
301010052 | SMD RES 22R-1%-1/16W;0402 | YAGEO | RC0402FR-0722RL | 1 | R45 | -55°C~155°C
301010041 | SMD RES 49.9R-1%-1/16W;0402 | YAGEO | RC0402FR-0749R9L | 5 | R22,R120,R121,R122,R123 | -55°C~155°C
301010039 | SMD RES 2.2K-5%-1/16W;0402 | YAGEO | RC0402JR-072K2L | 4 | R71,R72,R73,R74 | -55°C~155°C
311000004 | SMD Button;Top;250gf-0.7mm-4P;L4.6*W3*H2mm | ChengQi | TC-CQ3*4*2 | 3 | S1,S2,S3 | -40°C~80°C
310071490 | SMD IC Interface;HDMI Transmitter;QFN-64 | ITE | IT66122FN/CX | 1 | U11 | -20°C~70°C
310091905 | SMD IC Memory;16GB eMMC 5.1 HS400;VFBGA-153,11.5*13.0*0.73mm | Kingston | EMMC16G-MW28-01E10 | 1 | U13 | -25°C to 85°C
