beagleboard/beaglebone-black/MFG/BeagleBone Black_RevC_ASSY_XY_210222.xlsx

Component Report
Fri Dec 25 15:42:36 2020
Total Components: 413
REFDES | COMP_DEVICE_TYPE | COMP_VALUE | COMP_TOL | COMP_PACKAGE | SYM_X | SYM_Y | SYM_ROTATE | SYM_MIRROR
C1 | CAP_10UF_Y5V_10V_10%_0805_805_1 | 10uF,16V |  | 805 | 550 | 675 | 270 | NO
C2 | CAP_10UF_Y5V_10V_10%_0805_805_1 | 10uF,16V |  | 805 | 325 | 490 | 180 | YES
C3 | CAP_0.1UF_X5R_6.3V_20% 0201 _40 | 100nF,16V |  | 402 | 637.5 | 762.5 | 0 | NO
C4 | CAP_10UF_Y5V_10V_10%_0805_805_1 | 10uF,16V |  | 805 | 787.5 | 675 | 270 | YES
C5 | CC_0402_10PF,50V | 10pF,50V |  | 402 | 1200 | 990 | 0 | NO
C7 | CAP_10UF_Y5V_10V_10%_0805_805_1 | 10uF,16V |  | 805 | 937.5 | 525 | 90 | YES
C8 | CAP_10UF_Y5V_10V_10%_0805_805_1 | 10uF,16V |  | 805 | 1012.5 | 525 | 90 | YES
C9 | CAP_10UF_Y5V_10V_10%_0805_805_1 | 10uF,16V |  | 805 | 847.5 | 337.5 | 180 | NO
C10 | CAP_10UF_Y5V_10V_10%_0805_805_1 | 10uF,16V |  | 805 | 787.5 | 525 | 270 | YES
C11 | CAP_10UF_Y5V_10V_10%_0805_805_1 | 10uF,16V |  | 805 | 1137.5 | 600 | 270 | NO
C12 | CAP_10UF_Y5V_10V_10%_0805_805_1 | 10uF,16V |  | 805 | 1007.5 | 337.5 | 0 | NO
C13 | CAP_10UF_Y5V_10V_10%_0805_805_1 | 10uF,16V |  | 805 | 937.5 | 675 | 270 | YES
C14 | CAP_10UF_Y5V_10V_10%_0805_805_1 | 10uF,16V |  | 805 | 1012.5 | 675 | 270 | YES
C15 | CAP_10UF_Y5V_10V_10%_0805_805_1 | 10uF,16V |  | 805 | 862.5 | 675 | 270 | YES
C16 | CAP_2.2UF_X5R_6.3V_10%_0402_402 | 2.2uF,10V |  | 402 | 637.5 | 687.5 | 180 | NO
C17 | CAP_2.2UF_X5R_6.3V_10%_0402_402 | 2.2uF,10V |  | 402 | 325 | 625 | 0 | YES
C18 | CAP_2.2UF_X5R_6.3V_10%_0402_402 | 2.2uF,10V |  | 402 | 637.5 | 725 | 180 | NO
C19 | CAP_470PF_X7R_25V_10%_0402_402_ | 470pF,50V |  | 402 | 325 | 725 | 180 | NO
C20 | CAP_0.1UF_X5R_6.3V_20% 0201 _40 | 100nF,16V |  | 402 | 325 | 675 | 0 | YES
C21 | CAP_18PF_COG_50V_5%_0402_402_18 | 18pF,50V |  | 402 | 1987.5 | 637.5 | 270 | YES
C22 | CAP_18PF_COG_50V_5%_0402_402_18 | 18pF,50V |  | 402 | 2037.5 | 637.5 | 270 | YES
C23 | CAP_0.1UF_X5R_6.3V_20% 0201 _04 | 100nF,16V |  | 402 | 1015 | 1540 | 0 | YES
C24 | CAP_1.0UF_X5R_10V_10%_0402_40_1 | 2.2uF,10V |  | 402 | 1137.5 | 437.5 | 180 | YES
C25 | CAP_18PF_COG_50V_5%_0402_402_18 | 18pF,50V |  | 402 | 1865 | 1535 | 180 | YES
C26 | CAP_18PF_COG_50V_5%_0402_402_18 | 18pF,50V |  | 402 | 1695 | 1535 | 0 | YES
C27 | CAP_0.1UF_X5R_6.3V_20% 0201 _40 | 100nF,16V |  | 402 | 1775 | 450 | 90 | NO
C28 | CAP_0.1UF_X5R_6.3V_20% 0201 _40 | 100nF,16V |  | 402 | 2200 | 1069.5 | 180 | YES
C29 | CAP_0.1UF_X5R_6.3V_20% 0201 _40 | 100nF,16V |  | 402 | 1350 | 337.5 | 270 | NO
C30 | CAP_0.1UF_X5R_6.3V_20% 0201 _40 | 100nF,16V |  | 402 | 1137.5 | 400 | 180 | YES
C31 | CAP_0.1UF_X5R_6.3V_20% 0201 _40 | 100nF,16V |  | 402 | 1700 | 700 | 270 | NO
C32 | CAP_0.001_X7R_50V_5%_0402_402_1 | 1nF,50V |  | 402 | 1662.5 | 700 | 270 | NO
C33 | CAP_0.1UF_X5R_6.3V_20% 0201 _40 | 100nF,16V |  | 402 | 1737.5 | 700 | 270 | NO
C34 | CAP_100UF_TANT_6.3V_3528-21_RD2 | 100uF,10V |  | RD205SMD_250D | 2525 | 425 | 90 | NO
C35 | CAP_0.1UF_X5R_6.3V_20% 0201 _40 | 100nF,16V |  | 402 | 3223.9 | 725 | 270 | YES
C36 | CAP_0.1UF_X5R_6.3V_20% 0201 _40 | 100nF,16V |  | 402 | 512.5 | 1650 | 90 | YES
C37 | CAP_0.1UF_X5R_6.3V_20% 0201 _40 | 100nF,16V |  | 402 | 1100 | 862.5 | 270 | NO
C38 | CAP_0.1UF_X5R_6.3V_20% 0201 _40 | 100nF,16V |  | 402 | 1350 | 1362.5 | 0 | YES
C39 | CAP_10UF_Y5V_10V_10%_0805_805_1 | 10uF,16V |  | 805 | 1350 | 1005 | 180 | YES
C40 | CAP_10UF_Y5V_10V_10%_0805_805_1 | 10uF,16V |  | 805 | 1350 | 1120 | 180 | YES
C41 | CAP_0.1UF_X5R_6.3V_20% 0201 _40 | 100nF,16V |  | 402 | 1658.25 | 1276 | 0 | YES
C42 | CAP_0.1UF_X5R_6.3V_20% 0201 _40 | 100nF,16V |  | 402 | 1800 | 1276 | 90 | YES
C43 | CAP_0.1UF_X5R_6.3V_20% 0201 _40 | 100nF,16V |  | 402 | 1863 | 1260.25 | 270 | YES
C44 | CAP_0.1UF_X5R_6.3V_20% 0201 _40 | 100nF,16V |  | 402 | 1500.75 | 1016.13 | 0 | YES
C45 | CAP_0.1UF_X5R_6.3V_20% 0201 _40 | 100nF,16V |  | 402 | 1500.75 | 1173.63 | 0 | YES
C46 | CAP_0.1UF_X5R_6.3V_20% 0201 _40 | 100nF,16V |  | 402 | 1737 | 1150 | 180 | YES
C47 | CAP_0.1UF_X5R_6.3V_20% 0201 _40 | 100nF,16V |  | 402 | 1800 | 1197.25 | 90 | YES
C48 | CAP_0.1UF_X5R_6.3V_20% 0201 _40 | 100nF,16V |  | 402 | 1863 | 1150 | 180 | YES
C49 | CAP_0.1UF_X5R_6.3V_20% 0201 _40 | 100nF,16V |  | 402 | 1800 | 1102.75 | 270 | YES
C50 | CAP_0.1UF_X5R_6.3V_20% 0201 _40 | 100nF,16V |  | 402 | 1863 | 1039.75 | 270 | YES
C51 | CAP_0.1UF_X5R_6.3V_20% 0201 _40 | 100nF,16V |  | 402 | 1350 | 1175 | 0 | YES
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
C101 | CAP_0.1UF_X5R_6.3V_20% 0201 _40 | 100nF,16V |  | 402 | 2050 | 775 | 90 | YES
C102 | CAP_0.1UF_X5R_6.3V_20% 0201 _40 | 100nF,16V |  | 402 | 2112.5 | 637.5 | 270 | YES
C103 | CAP_0.1UF_X5R_6.3V_20% 0201 _40 | 100nF,16V |  | 402 | 2150 | 637.5 | 270 | YES
C104 | CAP_1.0UF_X5R_10V_10%_0402_402_ | 1uF,10V |  | 402 | 1937.5 | 775 | 90 | YES
C105 | CAP_0.1UF_X5R_6.3V_20% 0201 _40 | 100nF,16V |  | 402 | 1862.5 | 775 | 90 | YES
C106 | CAP_1.0UF_X5R_10V_10%_0402_402_ | 1uF,10V |  | 402 | 1721.26 | 1449.25 | 270 | YES
C107 | CAP_0.1UF_X5R_6.3V_20% 0201 _40 | 100nF,16V |  | 402 | 2300 | 1227 | 0 | YES
C108 | CAP_0.1UF_X5R_6.3V_20% 0201 _40 | 100nF,16V |  | 402 | 2300 | 1164 | 0 | YES
C109 | CAP_0.1UF_X5R_6.3V_20% 0201 _40 | 100nF,16V |  | 402 | 2300 | 1069.5 | 0 | YES
C110 | CAP_0.1UF_X5R_6.3V_20% 0201 _40 | 100nF,16V |  | 402 | 2300 | 1006.5 | 0 | YES
C111 | CAP_0.1UF_X5R_6.3V_20% 0201 _40 | 100nF,16V |  | 402 | 2300 | 912 | 0 | YES
C112 | CAP_0.1UF_X5R_6.3V_20% 0201 _40 | 100nF,16V |  | 402 | 2300 | 817.5 | 0 | YES
C113 | CAP_0.1UF_X5R_6.3V_20% 0201 _40 | 100nF,16V |  | 402 | 2300 | 754.5 | 0 | YES
C114 | CAP_0.1UF_X5R_6.3V_20% 0201 _40 | 100nF,16V |  | 402 | 2690 | 1215 | 180 | YES
C115 | CAP_0.1UF_X5R_6.3V_20% 0201 _40 | 100nF,16V |  | 402 | 2700 | 1164 | 180 | YES
C116 | CAP_0.1UF_X5R_6.3V_20% 0201 _40 | 100nF,16V |  | 402 | 2700 | 1101 | 180 | YES
C117 | CAP_0.1UF_X5R_6.3V_20% 0201 _40 | 100nF,16V |  | 402 | 2700 | 1006.5 | 180 | YES
C118 | CAP_10UF_Y5V_10V_10%_0805_805_1 | 10uF,16V |  | 805 | 2670 | 1270 | 0 | YES
C119 | CAP_0.1UF_X5R_6.3V_20% 0201 _40 | 100nF,16V |  | 402 | 2700 | 959.25 | 180 | YES
C120 | CAP_0.1UF_X5R_6.3V_20% 0201 _40 | 100nF,16V |  | 402 | 2700 | 817.5 | 180 | YES
C121 | CAP_0.1UF_X5R_6.3V_20% 0201 _40 | 100nF,16V |  | 402 | 2700 | 754.5 | 180 | YES
C122 | CAP_10UF_Y5V_10V_10%_0805_805_1 | 10uF,16V |  | 805 | 2675 | 662.5 | 0 | YES
C123 | CAP_0.001_X7R_50V_5%_0402_402_1 | 1nF,50V |  | 402 | 2500 | 959.25 | 180 | YES
C124 | CAP_0.1UF_X5R_6.3V_20% 0201 _40 | 100nF,16V |  | 402 | 2500 | 864.75 | 0 | YES
C125 | CAP_2.2UF_X5R_6.3V_10%_0402_402 | 2.2uF,10V |  | 402 | 1275 | 1850 | 270 | YES
C126 | CAP_10UF_Y5V_10V_10%_0805_805_1 | 10uF,16V |  | 805 | 925 | 1650 | 270 | YES
C127 | CAP_0.1UF_X5R_6.3V_20% 0201 _40 | 100nF,16V |  | 402 | 1000 | 1650 | 90 | YES
C128 | CAP_0.1UF_X5R_6.3V_20% 0201 _40 | 100nF,16V |  | 402 | 1150 | 1650 | 270 | YES
C129 | CAP_0.1UF_X5R_6.3V_20% 0201 _40 | 100nF,16V |  | 402 | 1200 | 1650 | 90 | YES
C130 | CAP_0.1UF_X5R_6.3V_20% 0201 _40 | 100nF,16V |  | 402 | 1350 | 1650 | 90 | YES
C131 | CAP_0.1UF_X5R_6.3V_20% 0201 _40 | 100nF,16V |  | 402 | 925 | 1125 | 180 | YES
C132 | CAP_0.1UF_X5R_6.3V_20% 0201 _40 | 100nF,16V |  | 402 | 925 | 1175 | 180 | YES
C133 | CAP_10UF_Y5V_10V_10%_0805_805_1 | 10uF,16V |  | 805 | 925 | 1312.5 | 0 | YES
C134 | CAP_1.0UF_X5R_10V_10%_0402_402_ | 1uF,10V |  | 402 | 1050 | 1125 | 0 | YES
C135 | CAP_0.1UF_X5R_6.3V_20% 0201 _40 | 100nF,16V |  | 402 | 1050 | 1325 | 180 | YES
C136 | 470PF/5%/50V/C0G/0603_0_0402_47 | 470pF,50V |  | 402 | 1050 | 1175 | 0 | YES
C137 | CAP_0402_100PF_COG_50V_402_10PF | 10pF,50V |  | 402 | 475 | 1350 | 0 | YES
C138 | CAP_0402_100PF_COG_50V_402_10PF | 10pF,50V |  | 402 | 475 | 1300 | 0 | YES
C139 | CAP_0402_100PF_COG_50V_402_10PF | 10pF,50V |  | 402 | 475 | 1250 | 0 | YES
C140 | CAP_0402_100PF_COG_50V_402_10PF | 10pF,50V |  | 402 | 475 | 1100 | 0 | YES
C141 | CAP_0402_0.1UF_X5R_10V_402_22NF | 22nF,50V |  | 402 | 475 | 1200 | 0 | YES
C142 | CAP_30PF_COG_50V_5%_0402_402_33 | 33pF,50V |  | 402 | 912.5 | 1012.5 | 270 | YES
C143 | CAP_30PF_COG_50V_5%_0402_402_33 | 33pF,50V |  | 402 | 1062.5 | 1012.5 | 270 | YES
C144 | CAP_2.2UF_X5R_6.3V_10%_0402_402 | 2.2uF,10V |  | 402 | 2325 | 1600 | 90 | YES
C145 | CAP_0.1UF_X5R_6.3V_20% 0201 _40 | 100nF,16V |  | 402 | 2325 | 1425 | 90 | YES
C146 | CAP_2.2UF_X5R_6.3V_10%_0402_402 | 2.2uF,10V |  | 402 | 2525 | 1725 | 90 | YES
C147 | CAP_0.1UF_X5R_6.3V_20% 0201 _40 | 100nF,16V |  | 402 | 2575 | 1425 | 270 | YES
C148 | CAP_2.2UF_X5R_6.3V_10%_0402_402 | 2.2uF,10V |  | 402 | 2575 | 1725 | 90 | YES
C149 | CAP_0.1UF_X5R_6.3V_20% 0201 _40 | 100nF,16V |  | 402 | 2675 | 1725 | 270 | YES
C150 | CAP_0.1UF_X5R_6.3V_20% 0201 _40 | 100nF,16V |  | 402 | 2650 | 1590 | 0 | YES
C151 | CAP_2.2UF_X5R_6.3V_10%_0402_402 | 2.2uF,10V |  | 402 | 2625 | 1425 | 90 | YES
C152 | CAP_0.1UF_X5R_6.3V_20% 0201 _40 | 100nF,16V |  | 402 | 1025 | 862.5 | 270 | YES
C153 | CAP_10UF_Y5V_10V_10%_0805_805_1 | 10uF,16V |  | 805 | 2835 | 945 | 90 | YES
C154 | CAP_0.1UF_X5R_6.3V_20% 0201 _40 | 100nF,16V |  | 402 | 2840 | 1030 | 0 | YES
C155 | CAP_0.1UF_X5R_6.3V_20% 0201 _40 | 100nF,16V |  | 402 | 2180 | 450 | 90 | YES
C156 | CAP_0.1UF_X5R_6.3V_20% 0201 __1 | 47pF,50V |  | 402 | 2175 | 1730 | 90 | NO
C157 | CAP_0.1UF_X5R_6.3V_20% 0201 __1 | 47pF,50V |  | 402 | 2125 | 1590 | 90 | NO
C158 | CAP_0.1UF_X5R_6.3V_20% 0201 _40 | 100nF,16V |  | 402 | 1562.5 | 1850 | 270 | YES
C159 | CAP_0.1UF_X5R_6.3V_20% 0201 _40 | 100nF,16V |  | 402 | 1562.5 | 1650 | 90 | YES
C160 | CAP_0.1UF_X5R_6.3V_20% 0201 __1 | 47pF,50V |  | 402 | 2175 | 1590 | 270 | NO
C161 | CAP_0.1UF_X5R_6.3V_20% 0201 __1 | 47pF,50V |  | 402 | 2025 | 1590 | 270 | YES
C162 | CAP_0.1UF_X5R_6.3V_20% 0201 __1 | 47pF,50V |  | 402 | 2075 | 1590 | 270 | YES
C163 | CAP_0.1UF_X5R_6.3V_20% 0201 __1 | 47pF,50V |  | 402 | 2225 | 1590 | 90 | NO
C164 | CAP_0.1UF_X5R_6.3V_20% 0201 __1 | 47pF,50V |  | 402 | 1975 | 1590 | 270 | YES
C165 | CAP_0.1UF_X5R_6.3V_20% 0201 __1 | 47pF,50V |  | 402 | 2175 | 1850 | 270 | NO
C166 | CAP_0.1UF_X5R_6.3V_20% 0201 __1 | 47pF,50V |  | 402 | 2075 | 1590 | 90 | NO
C167 | CAP_0.1UF_X5R_6.3V_20% 0201 __1 | 47pF,50V |  | 402 | 2125 | 1730 | 270 | NO
C168 | CAP_0.1UF_X5R_6.3V_20% 0201 __1 | 47pF,50V |  | 402 | 2075 | 1730 | 90 | NO
C169 | CAP_0.1UF_X5R_6.3V_20% 0201 __1 | 47pF,50V |  | 402 | 2225 | 1470 | 270 | NO
C170 | CAP_0.1UF_X5R_6.3V_20% 0201 __1 | 47pF,50V |  | 402 | 2125 | 1590 | 270 | YES
C171 | CAP_0.1UF_X5R_6.3V_20% 0201 __1 | 47pF,50V |  | 402 | 2975 | 1850 | 90 | YES
C172 | CAP_0.1UF_X5R_6.3V_20% 0201 __1 | 47pF,50V |  | 402 | 2175 | 1590 | 270 | YES
C173 | CAP_0.1UF_X5R_6.3V_20% 0201 __1 | 47pF,50V |  | 402 | 2975 | 1850 | 270 | NO
C174 | CAP_30PF_COG_50V_5%_0402_0402_4 | 4.7uF,10V |  | 402 | 1015 | 1470 | 0 | YES
C175 | CC_0402_10PF,50V | 10pF,50V |  | 402 | 1845 | 1675 | 90 | NO
D1 | LED_LTST-C150GKT_0_LED_0603__19 | 19-217/BHC-ZL1M2RY/3T |  | LED_0603 | 150 | 625 | 0 | NO
D2 | LED_LTST-C150GKT_0_LED_0603__19 | 19-217/BHC-ZL1M2RY/3T |  | LED_0603 | 125 | 1862.5 | 0 | NO
D3 | LED_LTST-C150GKT_0_LED_0603__19 | 19-217/BHC-ZL1M2RY/3T |  | LED_0603 | 125 | 1787.5 | 0 | NO
D4 | LED_LTST-C150GKT_0_LED_0603__19 | 19-217/BHC-ZL1M2RY/3T |  | LED_0603 | 125 | 1712.5 | 0 | NO
D5 | LED_LTST-C150GKT_0_LED_0603__19 | 19-217/BHC-ZL1M2RY/3T |  | LED_0603 | 125 | 1637.5 | 0 | NO
D6 | 32CTQ030/TO_1_TSSOP10_TPD4S009D | TPD4S009DGSR |  | TSSOP10 | 2975 | 1375 | 270 | NO
D7 | 32CTQ030/TO_1_TSSOP10_TPD4S009D | TPD4S009DGSR |  | TSSOP10 | 2975 | 1550 | 270 | NO
D8 | DIO_SR305_TH_0_SOD323_RB751V40, | RB751V40,115 |  | SOD323 | 2875 | 1175 | 90 | NO
FB1 | FER_180_200_0_SM-7351-IND-0805_ | 150R,800mA |  | SM-7351-IND-0805 | 1350 | 1262.5 | 180 | YES
FB2 | FER_180_200_0_SM-7351-IND-0805_ | 150R,800mA |  | SM-7351-IND-0805 | 1825 | 637.5 | 90 | YES
FB3 | FER_180_200_0_SM-7351-IND-0805_ | 150R,800mA |  | SM-7351-IND-0805 | 1725 | 637.5 | 90 | YES
FB4 | FER_180_200_0_SM-7351-IND-0805_ | 150R,800mA |  | SM-7351-IND-0805 | 925 | 1412.5 | 0 | YES
FB5 | FER_180_200_0805_SM-7351-IND-08 | 150R,800mA |  | SM-7351-IND-0805 | 2200 | 1450 | 90 | YES
FB7 | FER_180_200_0_SM-7351-IND-0805_ | 150R,800mA |  | SM-7351-IND-0805 | 2675 | 440 | 180 | YES
J1 | HEADER 6_SIP6_HEADER 1X6PIN 2.5 | Header 1x6Pin 2.54MM |  | SIP6 | 1675 | 300 | 90 | NO
L1 | IND_2.2UH_2.6A_10%_SMD_2520_2.2 | 2.2uH,1.3A |  | 2520 | 847.5 | 337.5 | 0 | YES
L2 | IND_2.2UH_2.6A_10%_SMD_2520_2.2 | 2.2uH,1.3A |  | 2520 | 1010 | 337.5 | 180 | YES
L3 | IND_2.2UH_2.6A_10%_SMD_2520_2.2 | 2.2uH,1.3A |  | 2520 | 1137.5 | 600 | 90 | YES
MTG1 | MHOLE_MTGH200C125D_PL_MHOLE | MHOLE |  | MTGH200C125D_PL | 575 | 125 | 90 | NO
MTG2 | MHOLE_MTGH200C125D_PL_MHOLE | MHOLE |  | MTGH200C125D_PL | 3175 | 250 | 90 | NO
MTG3 | MHOLE_MTGH200C125D_PL_MHOLE | MHOLE |  | MTGH200C125D_PL | 575 | 2025 | 90 | NO
MTG4 | MHOLE_MTGH200C125D_PL_MHOLE | MHOLE |  | MTGH200C125D_PL | 3175 | 1900 | 90 | NO
P1 | POWER_JACK_CONN3-PWR-PJ102A_DC6 | DC630-20D01 |  | CONN3-PWR-PJ102A | 440 | 375 | 180 | NO
P2 | HDR_10X2_CJTAG_0_HEADER10X2_SMD | Heaader 2x10 1.27mm |  | HEADER10X2_SMD | 1387.5 | 512.5 | 270 | YES
P3 | CONN_54819-0578_2_USB_A_SH__UB1 | UB11123-4H9-4F |  | USB_A_SH | 2887.5 | 525 | 90 | NO
P4 | MINI-USB-AB-SOCKET_USB5MINI_4SH | UX60SC-MB-5ST(80) |  | USB5MINI_4SHIELDED_SMD-5 | 240 | 1737.5 | 180 | YES
P5 | CONN_RJ45_MAG_WE_0_RJ45-7499010 | LPJ0011BBNL |  | RJ45-7499010211A | 575 | 1350 | 270 | NO
P6 | CONN_HDMI_TYPED_CONN19_HDMI_101 | 10118241-001RLF |  | CONN19_HDMI | 3332.68 | 990 | 90 | YES
P8 | HDR_46_F_2_0.1_0.1_HEADER23X2_F | Female Header 2x23Pin 2.54MM |  | HEADER23X2 | 775 | 1975 | 0 | NO
P9 | HDR_46_F_2_0.1_0.1_HEADER23X2_F | Female Header 2x23Pin 2.54MM |  | HEADER23X2 | 775 | 75 | 0 | NO
P10 | MICROSD CARD_10+4P_MICRO_SD_15X | TF-114 |  | MICRO_SD_15X14_3X1_8MM | 2779.92 | 1230.7 | 270 | YES
Q1 | RN1907_SMINI6-F3-B_DDC114YU-7-F | DDC114YU-7-F |  | SMINI6-F3-B | 512.5 | 1825 | 180 | NO
Q2 | RN1907_SMINI6-F3-B_DDC114YU-7-F | DDC114YU-7-F |  | SMINI6-F3-B | 375 | 1825 | 180 | NO
R1 | RES_100K_1/16W_1%_0402_402_100K | 100K,1% |  | 402 | 850 | 862.5 | 90 | YES
R2 | RES_33_0402_0402_33R,5% | 33R,5% |  | 402 | 2650 | 1625 | 180 | YES
R3 | RES_1.5K_1/16W_5%_0402_402_1.5K | 1.5K,1% |  | 402 | 1025 | 862.5 | 270 | NO
R4 | RES_1.5K_1/16W_5%_0402_402_1.5K | 1.5K,1% |  | 402 | 1062.5 | 862.5 | 270 | NO
R5 | RES_4.75K_1/16W_1%_0402_402_0R, | 0R,5% |  | 402 | 637.5 | 625 | 180 | NO
R6 | RES_4.75K_1/16W_1%_0402_402_0R, | 0R,5% |  | 402 | 740 | 340 | 90 | YES
R7 | RES_4.75K_1/16W_1%_0402_402_0R, | 0R,5% |  | 402 | 450 | 625 | 180 | NO
R8 | RES_4.75K_1/16W_1%_0402_402_0R, | 0R,5% |  | 402 | 450 | 675 | 180 | NO
R9 | RES_4.75K_1/16W_1%_0402_402_0R, | 0R,5% |  | 402 | 450 | 725 | 0 | NO
R10 | RES_470_1/10W_5%_0402_402_470K, | 470K,1% |  | 402 | 325 | 675 | 180 | NO
R11 | RES_470_1/10W_5%_0402_402_280K, | 280K,1% |  | 402 | 325 | 725 | 180 | YES
R12 | RES_470_1/10W_5%_0402_402_470R, | 470R,5% |  | 402 | 150 | 650 | 0 | YES
R13 | RES_33_0402_0402_33R,5% | 33R,5% |  | 402 | 2650 | 1545 | 180 | YES
R14 | RES_10K_1/16W_1%_0402_402_10K,1 | 10K,1% |  | 402 | 1137.5 | 475 | 0 | YES
R15 | RES_33_0402_0402_33R,5% | 33R,5% |  | 402 | 2650 | 1510 | 180 | YES
R16 | RES_33_0402_0402_33R,5% | 33R,5% |  | 402 | 1200 | 955 | 180 | NO
R17 | RES_1M_1/16W_1%_0402_402_1M,1% | 1M,1% |  | 402 | 1780 | 1535 | 0 | YES
R18 | RES_33_0402_0402_33R,5% | 33R,5% |  | 402 | 1650 | 450 | 90 | YES
R19 | RES_0_1/16W_1%_0402_402_0R,5% | 0R,5% |  | 402 | 1637.5 | 775 | 90 | YES
R20 | RES_0_1/16W_1%_0402_402_0R,5% | 0R,5% |  | 402 | 1675 | 775 | 270 | YES
R21 | RES_33_0402_0402_33R,5% | 33R,5% |  | 402 | 1900 | 450 | 90 | YES
R22 | RES_4.7K_0402_402_49.9R,1% | 49.9R,1% |  | 402 | 2200 | 1118.5 | 0 | YES
R23 | RES_4.75K_1/16W_1%_0402_402_4.7 | 4.7K,1% |  | 402 | 1450 | 487.5 | 270 | NO
R24 | RES_4.75K_1/16W_1%_0402_402_4.7 | 4.7K,1% |  | 402 | 1450 | 575 | 90 | NO
R25 | RES_4.75K_1/16W_1%_0402_402_4.7 | 4.7K,1% |  | 402 | 1450 | 337.5 | 90 | NO
R26 | RES_4.75K_1/16W_1%_0402_402_4.7 | 4.7K,1% |  | 402 | 1975 | 775 | 270 | YES
R27 | RES_0_1/16W_1%_0402_402_0R,5% | 0R,5% |  | 402 | 1756.25 | 762.5 | 180 | NO
R28 | RES_33_0402_0402_33R,5% | 33R,5% |  | 402 | 1350 | 1095 | 180 | NO
R29 | RES_0_1/16W_1%_0402_402_0R,5% | 0R,5% |  | 402 | 1770 | 1590 | 90 | NO
R30 | RES_0_1/16W_1%_0402_402_0R,5% | 0R,5% |  | 402 | 2075 | 637.5 | 90 | YES
R31 | RES_33_0402_0402_33R,5% | 33R,5% |  | 402 | 2650 | 1360 | 180 | YES
R32 | RES_33_0402_0402_33R,5% | 33R,5% |  | 402 | 2650 | 1325 | 180 | YES
R33 | RES_10K_1/16W_1%_0402_0402_10K, | 10K,1% |  | 402 | 1015 | 1505 | 180 | YES
R34 | RES_10K_1/16W_1%_0402_0402_10K, | 10K,1% |  | 402 | 1230 | 1505 | 90 | YES
R35 | RES_33_0402_0402_33R,5% | 33R,5% |  | 402 | 1845 | 1590 | 90 | NO
R36 | RES_33_0402_0402_33R,5% | 33R,5% |  | 402 | 1810 | 1590 | 90 | NO
R37 | RES_100K_1/16W_1%_0402_0402_0R, | 0R,5% |  | 402 | 2540 | 440 | 180 | YES
R38 | RES_4.7K_0402_0402_33R,5% | 33R,5% |  | 402 | 955 | 1385 | 0 | NO
R39 | RES_4.7K_0402_0402_33R,5% | 33R,5% |  | 402 | 820 | 1415 | 0 | NO
R40 | RES_4.7K_0402_0402_33R,5% | 33R,5% |  | 402 | 820 | 1380 | 0 | NO
R41 | RES_4.7K_0402_0402_33R,5% | 33R,5% |  | 402 | 820 | 1450 | 180 | NO
R42 | RES_4.7K_0402_0402_33R,5% | 33R,5% |  | 402 | 820 | 1485 | 180 | NO
R43 | RES_33_0402_0402_33R,5% | 33R,5% |  | 402 | 1950 | 1850 | 270 | YES
R44 | RES_33_0402_0402_33R,5% | 33R,5% |  | 402 | 1845 | 1850 | 270 | YES
R45 | RES_33_0402_0402_22R,1% | 22R,1% |  | 402 | 1975 | 1730 | 90 | NO
R46 | RES_33_0402_0402_0R,5% | 0R,5% |  | 402 | 2025 | 1730 | 90 | NO
R47 | RES_33_0402_0402_0R,5% | 0R,5% |  | 402 | 2025 | 1590 | 90 | NO
R48 | RES_33_0402_0402_0R,5% | 0R,5% |  | 402 | 1975 | 1590 | 90 | NO
R49 | RES_100K_1/16W_1%_0402_402_0R,5 | 0R,5% |  | 402 | 1500 | 1337.5 | 180 | YES
R50 | RES_4.75K_1/16W_1%_0402_402_0R, | 0R,5% |  | 402 | 1450 | 700 | 270 | NO
R51 | RES_4.75K_1/16W_1%_0402_402_0R, | 0R,5% |  | 402 | 1600 | 775 | 270 | YES
R52 | RES_10K_1/16W_1%_0402_402_10K,1 | 10K,1% |  | 402 | 3273.9 | 725 | 90 | YES
R53 | RES_10K_1/16W_1%_0402_402_10K,1 | 10K,1% |  | 402 | 3023.9 | 725 | 270 | YES
R54 | RES_10K_1/16W_1%_0402_402_10K,1 | 10K,1% |  | 402 | 2012.5 | 775 | 270 | YES
R55 | RES_100K_1/16W_1%_0402_402_100K | 100K,1% |  | 402 | 2300 | 1850 | 270 | YES
R56 | RES_100K_1/16W_1%_0402_402_100K | 100K,1% |  | 402 | 2262.5 | 1850 | 270 | YES
R57 | RES_100K_1/16W_1%_0402_402_100K | 100K,1% |  | 402 | 2375 | 1850 | 270 | YES
R58 | RES_100K_1/16W_1%_0402_402_100K | 100K,1% |  | 402 | 2412.5 | 1850 | 270 | YES
R59 | RES_100K_1/16W_1%_0402_402_100K | 100K,1% |  | 402 | 2337.5 | 1850 | 270 | YES
R60 | RES_100K_1/16W_1%_0402_402_100K | 100K,1% |  | 402 | 2450 | 1850 | 270 | YES
R61 | RES_100K_1/16W_1%_0402_402_100K | 100K,1% |  | 402 | 2487.5 | 1850 | 270 | YES
R62 | RES_100K_1/16W_1%_0402_402_100K | 100K,1% |  | 402 | 2525 | 1850 | 270 | YES
R63 | RES_100K_1/16W_1%_0402_402_100K | 100K,1% |  | 402 | 2562.5 | 1850 | 270 | YES
R64 | RES_100K_1/16W_1%_0402_402_100K | 100K,1% |  | 402 | 2600 | 1850 | 270 | YES
R65 | RES_100K_1/16W_1%_0402_402_100K | 100K,1% |  | 402 | 2637.5 | 1850 | 270 | YES
R66 | RES_100K_1/16W_1%_0402_402_100K | 100K,1% |  | 402 | 2675 | 1850 | 270 | YES
R67 | RES_100K_1/16W_1%_0402_402_100K | 100K,1% |  | 402 | 2712.5 | 1850 | 270 | YES
R68 | RES_100K_1/16W_1%_0402_402_100K | 100K,1% |  | 402 | 2750 | 1850 | 270 | YES
R69 | RES_100K_1/16W_1%_0402_402_100K | 100K,1% |  | 402 | 2787.5 | 1850 | 270 | YES
R70 | RES_100K_1/16W_1%_0402_402_100K | 100K,1% |  | 402 | 2825 | 1850 | 270 | YES
R71 | RES_470_1/10W_5%_0402_402_2.2K, | 2.2K,5% |  | 402 | 250 | 1750 | 180 | NO
R72 | RES_470_1/10W_5%_0402_402_2.2K, | 2.2K,5% |  | 402 | 250 | 1862.5 | 180 | NO
R73 | RES_470_1/10W_5%_0402_402_2.2K, | 2.2K,5% |  | 402 | 250 | 1825 | 180 | NO
R74 | RES_470_1/10W_5%_0402_402_2.2K, | 2.2K,5% |  | 402 | 250 | 1787.5 | 180 | NO
R75 | RES_100K_1/16W_1%_0402_402_100R | 100R,1% |  | 402 | 2900 | 1850 | 270 | NO
R76 | RES_100K_1/16W_1%_0402_402_100K | 100K,1% |  | 402 | 512.5 | 1812.5 | 270 | YES
R77 | RES_100K_1/16W_1%_0402_402_100K | 100K,1% |  | 402 | 562.5 | 1812.5 | 90 | YES
R78 | RES_100K_1/16W_1%_0402_402_100K | 100K,1% |  | 402 | 375 | 1812.5 | 270 | YES
R79 | RES_100K_1/16W_1%_0402_402_100K | 100K,1% |  | 402 | 425 | 1812.5 | 90 | YES
R80 | RES_100K_1/16W_1%_0402_402_100K | 100K,1% |  | 402 | 2300 | 1850 | 270 | NO
R81 | RES_100K_1/16W_1%_0402_402_100K | 100K,1% |  | 402 | 2262.5 | 1850 | 270 | NO
R82 | RES_100K_1/16W_1%_0402_402_100K | 100K,1% |  | 402 | 2375 | 1850 | 270 | NO
R83 | RES_100K_1/16W_1%_0402_402_100K | 100K,1% |  | 402 | 2412.5 | 1850 | 270 | NO
R84 | RES_100K_1/16W_1%_0402_402_100K | 100K,1% |  | 402 | 2337.5 | 1850 | 270 | NO
R85 | RES_100K_1/16W_1%_0402_402_100K | 100K,1% |  | 402 | 2450 | 1850 | 270 | NO
R86 | RES_100K_1/16W_1%_0402_402_100K | 100K,1% |  | 402 | 2487.5 | 1850 | 270 | NO
R87 | RES_100K_1/16W_1%_0402_402_100K | 100K,1% |  | 402 | 2525 | 1850 | 270 | NO
R88 | RES_100K_1/16W_1%_0402_402_100K | 100K,1% |  | 402 | 2562.5 | 1850 | 270 | NO
R89 | RES_100K_1/16W_1%_0402_402_100K | 100K,1% |  | 402 | 2600 | 1850 | 270 | NO
R90 | RES_100K_1/16W_1%_0402_402_100K | 100K,1% |  | 402 | 2637.5 | 1850 | 270 | NO
R91 | RES_100K_1/16W_1%_0402_402_100K | 100K,1% |  | 402 | 2675 | 1850 | 270 | NO
R92 | RES_100K_1/16W_1%_0402_402_100K | 100K,1% |  | 402 | 2712.5 | 1850 | 270 | NO
R93 | RES_100K_1/16W_1%_0402_402_100K | 100K,1% |  | 402 | 2750 | 1850 | 270 | NO
R94 | RES_100K_1/16W_1%_0402_402_100K | 100K,1% |  | 402 | 2787.5 | 1850 | 270 | NO
R95 | RES_100K_1/16W_1%_0402_402_100K | 100K,1% |  | 402 | 2825 | 1850 | 270 | NO
R96 | RES_10K_1/16W_1%_0402_402_10K,1 | 10K,1% |  | 402 | 2700 | 912 | 0 | YES
R97 | RES_10K_1/16W_1%_0402_402_1.5K, | 1.5K,1% |  | 402 | 2500 | 754.5 | 0 | YES
R98 | RES_10K_1/16W_1%_0402_402_10K,1 | 10K,1% |  | 402 | 2500 | 1006.5 | 0 | YES
R99 | RES_0402_240R,1% | 240R,1% |  | 402 | 2700 | 864.75 | 0 | YES
R100 | RES_10K_1/16W_1%_0402_402_10K,1 | 10K,1% |  | 402 | 2500 | 912 | 0 | YES
R101 | RES_10K_1/16W_1%_0402_402_10K,1 | 10K,1% |  | 402 | 1985 | 1850 | 270 | YES
R102 | RES_10K_1/16W_1%_0402_402_10K,1 | 10K,1% |  | 402 | 1810 | 1850 | 270 | YES
R103 | RES_10K_1/16W_1%_0402_402_10K,1 | 10K,1% |  | 402 | 1010 | 1850 | 270 | YES
R104 | RES_10K_1/16W_1%_0402_402_10K,1 | 10K,1% |  | 402 | 1080 | 1850 | 270 | YES
R105 | RES_10K_1/16W_1%_0402_402_10K,1 | 10K,1% |  | 402 | 1880 | 1850 | 270 | YES
R106 | RES_10K_1/16W_1%_0402_402_10K,1 | 10K,1% |  | 402 | 1705 | 1850 | 270 | YES
R107 | RES_10K_1/16W_1%_0402_402_10K,1 | 10K,1% |  | 402 | 905 | 1850 | 270 | YES
R108 | RES_10K_1/16W_1%_0402_402_10K,1 | 10K,1% |  | 402 | 975 | 1850 | 270 | YES
R109 | RES_10K_1/16W_1%_0402_402_10K,1 | 10K,1% |  | 402 | 1670 | 1850 | 270 | YES
R110 | RES_10K_1/16W_1%_0402_402_10K,1 | 10K,1% |  | 402 | 1775 | 1850 | 270 | YES
R111 | RES_10K_1/16W_1%_0402_402_10K,1 | 10K,1% |  | 402 | 1150 | 1850 | 90 | YES
R112 | RES_4.75K_1/16W_1%_0402_402_1.5 | 1.5K,1% |  | 402 | 1200 | 1212.5 | 180 | YES
R113 | RES_4.75K_1/16W_1%_0402_402_1.5 | 1.5K,1% |  | 402 | 1200 | 1325 | 180 | YES
R114 | RES_4.75K_1/16W_1%_0402_402_1.5 | 1.5K,1% |  | 402 | 1200 | 1175 | 180 | YES
R115 | RES_4.75K_1/16W_1%_0402_402_10K | 10K,1% |  | 402 | 1200 | 1250 | 180 | YES
R116 | RES_4.75K_1/16W_1%_0402_402_10K | 10K,1% |  | 402 | 1200 | 1100 | 180 | YES
R117 | RES_4.75K_1/16W_1%_0402_402_10K | 10K,1% |  | 402 | 1200 | 1137.5 | 180 | YES
R118 | RES_4.75K_1/16W_1%_0402_402_10K | 10K,1% |  | 402 | 1200 | 1025 | 0 | NO
R119 | RES_1.5K_1/16W_5%_0402_402_1.5K | 1.5K,1% |  | 402 | 1200 | 1325 | 180 | NO
R120 | RES_4.7K_0402_402_49.9R,1% | 49.9R,1% |  | 402 | 787.5 | 1150 | 0 | YES
R121 | RES_4.7K_0402_402_49.9R,1% | 49.9R,1% |  | 402 | 787.5 | 1187.5 | 0 | YES
R122 | RES_4.7K_0402_402_49.9R,1% | 49.9R,1% |  | 402 | 787.5 | 1225 | 0 | YES
R123 | RES_4.7K_0402_402_49.9R,1% | 49.9R,1% |  | 402 | 787.5 | 1262.5 | 0 | YES
R124 | 100-1/10W-1%-0603_4_402_10R,1% | 10R,1% |  | 402 | 1200 | 1062.5 | 180 | NO
R125 | 100-1/10W-1%-0603_4_402_100R,1% | 100R,1% |  | 402 | 1200 | 1100 | 180 | NO
R126 | 100-1/10W-1%-0603_4_402_100R,1% | 100R,1% |  | 402 | 1200 | 1137.5 | 180 | NO
R127 | RES_100_1/10W_5%_0402_402_100R, | 100R,1% |  | 402 | 1200 | 1175 | 180 | NO
R128 | RES_100_1/10W_5%_0402_402_100R, | 100R,1% |  | 402 | 1200 | 1212.5 | 180 | NO
R129 | 100-1/10W-1%-0603_4_402_100R,1% | 100R,1% |  | 402 | 787.5 | 1325 | 180 | YES
R130 | RES_470_1/10W_5%_0402_402_470R, | 470R,5% |  | 402 | 225 | 1100 | 0 | YES
R131 | RES_100_1/10W_5%_0402_402_100R, | 100R,1% |  | 402 | 1200 | 1062.5 | 0 | YES
R132 | RES_470_1/10W_5%_0402_402_470R, | 470R,5% |  | 402 | 225 | 1250 | 0 | YES
R133 | RES_100_1/10W_5%_0402_402_100R, | 100R,1% |  | 402 | 1200 | 1250 | 180 | NO
R134 | 100-1/10W-1%-0603_4_402_100R,1% | 100R,1% |  | 402 | 1200 | 1400 | 0 | YES
R135 | RES_10K_1/16W_1%_0402_402_10K,1 | 10K,1% |  | 402 | 225 | 1050 | 180 | YES
R136 | RES_0.1_0805_805_0.1R,5% | 0.1R,5% |  | 805 | 162.5 | 1175 | 0 | YES
R137 | RES_10K_1/16W_1%_0402_402_0R,5% | 0R,5% |  | 402 | 475 | 1150 | 0 | YES
R138 | 100-1/10W-1%-0603_4_402_100R,1% | 100R,1% |  | 402 | 1200 | 1287.5 | 0 | YES
R139 | RES_100_1/10W_5%_0402_402_100R, | 100R,1% |  | 402 | 1200 | 1287.5 | 180 | NO
R140 | RES_0_1/16W_1%_0402_402_0R,5% | 0R,5% |  | 402 | 1200 | 1025 | 0 | YES
R141 | RES_1M_1/16W_1%_0402_402_1M,1% | 1M,1% |  | 402 | 987.5 | 1012.5 | 90 | YES
R142 | RES_0_1/16W_1%_0402_402_0R,5% | 0R,5% |  | 402 | 1025 | 1012.5 | 270 | YES
R143 | RES_10K_1/16W_1%_0402_402_10R,1 | 10R,1% |  | 402 | 950 | 1012.5 | 90 | YES
R144 | RES_12.1K_1/16W_1%_0402_402_12. | 12.1K,1% |  | 402 | 787.5 | 1112.5 | 0 | YES
R145 | RES_10K_1/16W_1%_0402_402_10K,1 | 10K,1% |  | 402 | 1200 | 1362.5 | 180 | YES
R146 | RES_1.5K_1/16W_5%_0402_402_1.5K | 1.5K,1% |  | 402 | 3025 | 1062.5 | 180 | YES
R147 | RES_1.5K_1/16W_5%_0402_402_1.5K | 1.5K,1% |  | 402 | 3025 | 1112.5 | 180 | YES
R148 | RES_10K_1/16W_1%_0402_402_10K,1 | 10K,1% |  | 402 | 2675 | 1425 | 90 | YES
R149 | RES_0_1/16W_1%_0402_402_0R,5% | 0R,5% |  | 402 | 2625 | 1725 | 90 | YES
R150 | RES_10K_1/16W_1%_0402_402_10K,1 | 10K,1% |  | 402 | 2760 | 1730 | 270 | NO
R151 | RES_10K_1/16W_1%_0402_402_10K,1 | 10K,1% |  | 402 | 2835 | 1730 | 270 | NO
R152 | RES_10K_1/16W_1%_0402_402_10K,1 | 10K,1% |  | 402 | 2795 | 1430 | 270 | NO
R153 | RES_10K_1/16W_1%_0402_402_10K,1 | 10K,1% |  | 402 | 2865 | 1090 | 270 | YES
R154 | RES_10K_1/16W_1%_0402_402_10K,1 | 10K,1% |  | 402 | 2815 | 1090 | 270 | YES
R155 | RES_10K_1/16W_1%_0402_402_10K,1 | 10K,1% |  | 402 | 2797.5 | 1730 | 270 | NO
R156 | RES_0_1/16W_1%_0402_402_10K,1% | 10K,1% |  | 402 | 987.5 | 862.5 | 270 | YES
R157 | RES_10K_1/16W_1%_0402_402_10K,1 | 10K,1% |  | 402 | 2925 | 1090 | 90 | YES
R158 | RES_10K_1/16W_1%_0402_402_10K,1 | 10K,1% |  | 402 | 1500 | 1512.5 | 0 | YES
R159 | RES_4.75K_1/16W_1%_0402_402_0R, | 0R,5% |  | 402 | 925 | 1512.5 | 180 | YES
R160 | RES_4.75K_1/16W_1%_0402_402_0R, | 0R,5% |  | 402 | 1512.5 | 1650 | 270 | YES
R161 | RES_4.75K_1/16W_1%_0402_402_0R, | 0R,5% |  | 402 | 1462.5 | 1650 | 270 | YES
R162 | RES_4.75K_1/16W_1%_0402_402_0R, | 0R,5% |  | 402 | 1200 | 1850 | 90 | YES
R163 | RES_4.75K_1/16W_1%_0402_402_4.7 | 4.7K,1% |  | 402 | 1887.5 | 637.5 | 270 | YES
R164 | RES_4.75K_1/16W_1%_0402_402_4.7 | 4.7K,1% |  | 402 | 1937.5 | 637.5 | 270 | YES
R165 | RES_100K_1/16W_1%_0402_402_100K | 100K,1% |  | 402 | 1825 | 450 | 90 | NO
R166 | RES_22.6K_1/16W_1%_0402_402_27K | 27K,1% |  | 402 | 2875 | 1050 | 270 | NO
R167 | RES_33_0402_0402_33R,5% | 33R,5% |  | 402 | 1612.5 | 1650 | 90 | YES
R168 | RES_33_0402_0402_33R,5% | 33R,5% |  | 402 | 1045 | 1850 | 270 | YES
R169 | RES_33_0402_0402_33R,5% | 33R,5% |  | 402 | 1115 | 1850 | 270 | YES
R170 | RES_33_0402_0402_33R,5% | 33R,5% |  | 402 | 1915 | 1850 | 270 | YES
R171 | RES_33_0402_0402_33R,5% | 33R,5% |  | 402 | 1740 | 1850 | 270 | YES
R172 | RES_33_0402_0402_33R,5% | 33R,5% |  | 402 | 870 | 1850 | 270 | YES
R173 | RES_33_0402_0402_33R,5% | 33R,5% |  | 402 | 940 | 1850 | 270 | YES
RT1 | PTC_RXEF010_POLYSW200-5638-310_ | RXEF010 |  | POLYSW200-5638-310 | 2775 | 525 | 90 | NO
S1 | SW_KT11P2JM_2_SW4SMD_63X161LS__ | KMR231GLFS |  | SW4SMD_63X161LS | 312.5 | 2025 | 180 | NO
S2 | SW_KT11P2JM_1_SW4SMD_63X161LS__ | KMR231GLFS |  | SW4SMD_63X161LS | 2975 | 1700 | 180 | NO
S3 | SW_KT11P2JM_2_SW4SMD_63X161LS__ | KMR231GLFS |  | SW4SMD_63X161LS | 312.5 | 1650 | 180 | NO
TP1 | TESTPT1_TP1-8040_TEST POINT | Test Point |  | TP1-8040 | 2325 | 425 | 0 | NO
TP2 | TESTPT1_TP60C_SMD_TEST POINT | Test Point |  | TP60C_SMD | 2262.5 | 612.5 | 0 | NO
TP3 | TESTPT1_TP60C_SMD_TEST POINT | Test Point |  | TP60C_SMD | 2025 | 775 | 0 | NO
TP4 | TESTPT1_TP1-8040_TEST POINT | Test Point |  | TP1-8040 | 150 | 750 | 0 | NO
TP5 | TESTPT1_TP60C33D_TEST POINT | Test Point |  | TP60C33D | 580 | 420 | 0 | NO
TP6 | TESTPT1_TP60C33D_TEST POINT | Test Point |  | TP60C33D | 580 | 320 | 0 | NO
TP7 | TESTPT1_TP60C33D_TEST POINT | Test Point |  | TP60C33D | 680 | 420 | 0 | NO
TP8 | TESTPT1_TP60C33D_TEST POINT | Test Point |  | TP60C33D | 680 | 320 | 0 | NO
TP9 | TESTPT1_TP60C33D_TEST POINT | Test Point |  | TP60C33D | 920 | 865 | 0 | NO
U1 | SN74AHC1G09DCKR_DCK5_2P15X1P4_S | SN74AHC1G09DCKR |  | DCK5_2P15X1P4 | 1135 | 1500 | 90 | YES
U2 | PWR_TPS65217_2_U_48_RSL_TPS6521 | TPS65217CRSLR |  | U_48_RSL | 900 | 600 | 0 | NO
U3 | IC_SN74LVC1G06DCK_0_DCK5_2P15X1 | SN74LVC1G06DCKR |  | DCK5_2P15X1P4 | 1587.5 | 1800 | 0 | NO
U4 | PWR_TLV70233DBV_0_SO8-25X75_TL5 | TL5209DR |  | SO8-25X75 | 537.5 | 650 | 270 | YES
U5 | IC_AM335X_ZCZ_AM33XX_15X15_AM33 | AM3358BZCZ100 |  | AM33XX_15X15 | 1800 | 1150 | 180 | NO
U6 | IC_SN74AUC1G74_SOP8_DCT_SN74LVC | SN74LVC1G74DCTR |  | SOP8_DCT | 1775 | 450 | 270 | YES
U7 | MEM_24LC32_SOT23-5_SOT23-5_24LC | 24LC32AT-I/OT |  | SOT23-5 | 1162.5 | 862.5 | 90 | YES
U8 | TPS2061_1_DGN-16X60_TPS2051BDGN | TPS2051BDGNR |  | DGN-16X60 | 3123.9 | 575 | 270 | YES
U9 | PROT_TPD4S012_U_6_DRY_TPD4S012D | TPD4S012DRYR |  | U_6_DRY | 3123.9 | 725 | 270 | YES
U10 | PROT_TPD4S012_U_6_DRY_TPD4S012D | TPD4S012DRYR |  | U_6_DRY | 512.5 | 1650 | 270 | NO
U11 | IC_TDA19988_HVQFN64_5_QFN64S9X9 | TDA19988BHN/C1,557 |  | QFN64S9X9P5 | 2500 | 1575 | 0 | NO
U12 | MT47H256M8_7_BGA96_T9_P8_9X14_D | D2516ECMDXGJD-U |  | BGA96_T9_P8_9X14 | 2500 | 975 | 0 | NO
U13 | EMMC_153-BALL_WFBGA_BGA153_P14_ | EMMC04G-M627 |  | BGA153_P14_P5_11P5X13 | 1175 | 1650 | 270 | NO
U14 | LAN8710 QFN32_1_QFN32_5X5MM_EP3 | LAN8710A-EZC-TR |  | QFN32_5X5MM_EP3P3MM | 987.5 | 1225 | 0 | NO
U15 | IC_SN74LVC2G241_1_U_8_DCU_SN74L | SN74LVC2G241DCUR |  | U_8_DCU | 2070 | 450 | 270 | YES
U16 | IC_SN74LVC1G07DCK_DCK5_2P15X1P4 | SN74LVC1G07DCKR |  | DCK5_2P15X1P4 | 1250 | 338 | 180 | NO
Y1 | CRYS_32_768KHZ_SMD32_1_XTAL4_12 | 32.768KHz,12.5pF |  | XTAL4_126-216SMD | 2012.5 | 550 | 270 | NO
Y2 | CRYS_24MHZ_SCC_0_XTAL150SMD_125 | 24MHz,20pF |  | XTAL150SMD_125X196 | 1780 | 1630 | 180 | YES
Y3 | SUNTSU ITEMP 25MHZ _0.005% 20PF | 25MHz,20pF |  | XTAL150SMD_125X196 | 987.5 | 1012.5 | 180 | NO
Y4 | OSC_12MHZ_1.3V_OSC4_61X65LS_79X | 24.576MHz |  | OSC4_61X65LS_79X98SMD | 1587.5 | 1637.5 | 0 | NO
