beagleboard/beaglebone-black/(threads)

Thread 3 (2017-12-06):

Wrong connector number in SRM

smortex, 2017-12-06:
On page 85 of file `BBB_SRM.pdf`, Rev C.1, we can read:

* “# Both of these signals connect to pin 41 of P*11*.”
* “@ Both of these signals connect to pin 42 of P*11*.”

But there is no P*11* connector.  In fact, this is the section talking about P*9* so **P11** should be replaced by **P9**.

smortex, 2017-12-06:
Same paragraphs, “by removing R*221*.” and “by removing R*202*.”.

There are no R*202* / R*221*. As far as I understand, **R221** should be **R20**, and **R202** should be **R51**.  But one may prefer to remove R20 and R50 depending on the application… maybe it makes sense to tell the user about the 3 possibilities (use one pin as input, the other one as output ; remove one of the resistors ; remove the other resistor).

jadonk, 2018-01-17:
@smortex thanks!

Note that the latest SRM is now at https://github.com/beagleboard/beaglebone-black/wiki/System-Reference-Manual. I'm still working on the process of producing a suitable new .PDF file to replace BBB_SRM.pdf.

jadonk, 2018-01-18:
Updated on wiki: https://github.com/beagleboard/beaglebone-black/wiki/System-Reference-Manual/_compare/363d5c354752fb1a1734f4a465a1d885d3a89e16...0828a11554c69e32f2dd45afb77fd1157a17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

jadonk, 2018-01-18:
Note I've duplicated and expanded upon some of this table data at https://github.com/beagleboard/capes

jadonk, 2018-01-18:
OK, I think I've fixed it up enough.

Closed 2018-01-18.

Thread 4 (2018-03-14):

8710A Reset Design Flaw

sslupsky, 2018-03-14:
There is an issue in the way the reset circuity on the BBB resets the 8710A ethernet PHY.

When coming out of reset, the 8710A can end up in an indefinite state as a result.  This is problematic because you can loose the ability to communicate with the BBB occasionally and it requires a physical reset to clear the problem.  For a remote system if a difficult to reach location this creates a major problem.

We have found that you can hack the current pcb (Rev B or Rev C) and disconnect the reset line from the 8710A.  Then, hack a wire from the 8710A reset pin to a GPIO on the BBB.  Now, when the ethernet PHY hangs it can be reset by asserting the GPIO pin.

I would like to recommend a revision to the PCB to address this issue.  At the moment the reset trace near the 8710A is on an inner layer and not easily accessible.  It would be a big help if the trace was more easily accessible.  It would be an even bigger help if there was a jumper and a couple pads.

We would be happy to contribute the firmware driver we developed for this.

RobertCNelson, 2018-03-20:
This was the exact same fix done to later boards, on mainline, the kernel mdio device tree supports the concept of a gpio-reset line:

https://git.kernel.org/pub/scm/linux/kernel/git/torvalds/linux.git/commit/Documentation/devicetree/bindings/net/mdio.txt?id=69226896ad636b94f6d2e55d75ff21a29c4de83b

If we ever did a rev D pcb, this is something i'd request..

Regards,

sslupsky, 2018-03-20:
@RobertCNelson

Do you know if anyone has converted the schematic and pcb from Allegro format to either Kicad or Altium?

Also, on my wish list would be to increase the amount of RAM.

rowsail, 2019-02-13:
There might be a fix here: https://wp.josh.com/2018/06/04/a-software-only-solution-to-the-vexing-beagle-bone-black-phy-issue/

rowsail, 2019-02-13:
On Rev D, would it be more appropriate to use a reset controller rather than an RC circuit?

RobertCNelson, 2019-02-13:
@rowsail we have been using a kernel mdio address fixup patch mentioned in that link you show.  A dedicated gpio to reset the phy is the best option.

Regards,

rowsail, 2019-02-15:
So until a design with this fix is released (I have the design in Altium BTW) would an external reset controller on a cape (or equivalent) fix the issue?

RobertCNelson, 2019-02-15:
@rowsail, in your design based off the beagle, cut the reset line so they aren't shared, wire a spare gpio to it with a pull-up/pull-down (haven't looked at the phy reset logic in awhile) and use the phy-reset binding, to control the gpio.

Regards,

rowsail, 2019-02-15:
Thanks for your help Robert. That's a very short trace on Pin 19 before it gets to the via carrying the regular reset signal, but if this goes into production, it's not really the sort of thing I want to do on 100+ units!  It's difficult to find out what the actual issue is from the posts re the fix: is it that the reset duration is not long enough, or something else?  If the former, I can fix it simply with a reset controller on my main board that can drive the reset low for longer and when the voltage is at a sufficiently high level.  If it is a problem with the PHY (a silicon issue) then sure, the only fix might be to additionally control its reset line by GPIO.
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

RobertCNelson, 2019-02-15:
@rowsail , i haven't looked at the actual timing signals, but from what i've been told, the sys_resetn is long enough to reset the am335x but not long enough to correctly reset the phy in 100% of all boards.

Regards,

rowsail, 2019-02-15:
OK - great info - thank you.  I will check the timing requirements but if that is the case it sounds like adding an external reset controller should work.

sslupsky, 2019-02-17:
@rowsail. It is a timing issue ... not just duration of the reset.  So, unfortunately, simply adding an external reset controller will not do the job.

It is an expensive hack.  To do it reliably you need a laser to cut the reset line.

Can you convert the design files to Kicad?  If so, I can propose some changes.

rowsail, 2019-02-17:
Ugh, that's bad news. I've got the schematics updated to rev C in Altium, but PCB is still at rev A5. The additional components need to be placed and routed to bring to rev C, but for what I'm needing the Altoid tin profile is not necessary at all and just pushed up the assembly cost. If you let me know know the changes I will include and can send the update to you.
Thanks, David.

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

--
Sent from my Android device with K-9 Mail. Please excuse my brevity.

sslupsky, 2019-02-17:
I updated my comment to be more specific.  The main cause is the power sequencing.  As I recall (it has been a while), I think I concluded the 8710a is likely on the wrong power bus.  In theory, separating the reset and using a reset controller for the 8710a should work.  But the underlying issue remains if you do not address the power sequencing.  So, likely the issue is best resolved by addressing the power sequencing issue and separating the reset.

rowsail, 2019-02-18:
Attached should be a PDF of the schematic.  I have attempted to create a structured schematic which I think is easier to understand to someone looking at it anew (i.e. me!).  I have also made the changes which bought it to Rev C and also added a link between a GPIO pin an the reset of the PHY.  I'd be grateful for any input good or bad.

[BEAGLEBONEBLACK.pdf](https://github.com/beagleboard/beaglebone-black/files/2873685/BEAGLEBONEBLACK.pdf)

rowsail, 2019-02-19:
https://github.com/rowsail/-BeagleBone-Black

GTrannoy, 2019-06-03:
I am designing a board based on BeagleCore and would add an ethernet PHY similar to this one of the BBB.

Is the solution of Rowsail correct ? With the fix in the mdio_driver ? (https://git.kernel.org/pub/scm/linux/kernel/git/torvalds/linux.git/commit/Documentation/devicetree/bindings/net/mdio.txt?id=69226896ad636b94f6d2e55d75ff21a29c4de83b)

jadonk, 2020-09-04:
@RobertCNelson is there a safe gpio line we can use for the MDIO reset? We will eventually need to address the microSD card cage issue and therefore do a hardware rev.

jadonk, 2020-09-04:
I think the reasonable way to do this (for as much compatibility as possible) is to find an unused GPIO that is able to float high with a pull-up and add an AND gate ahead of the reset to the PHY MDIO reset. That way, old code will still rely on the SYS_RESETn, but new code can reset the PHY even after SYS_RESETn is high.

Fixing the power sequencing would be nice such that this device is powered early enough for the SYS_RESETn to do the trick, but I'm worried about the validation process (risk) for that.

sslupsky, 2020-09-04:
I took a look at the technical reference manual and found this:
> Caution must be used when implementing the nRESETIN_OUT as an bi-directional reset signal. Because of the short maximum time allowed using RSTTIME1, it does not supply an adequate debounce time for an external push button circuit. The processor could potentially start running while external components are still in reset. It is recommended that this signal be used as input only (do not connect to other devices as a reset) to implement a push button reset circuit to the AM335x, or an output only to be able to reset other devices after an AM335x reset completes.

It appears the BBB does not adhere to this caution.  Moreover, the large capacitance on this signal line may cause issues due to the very slow signal rise time.  It would likely be a good idea to properly debounce the reset button and remove the capacitor from this reset signal line.

I recall that when we did some work on this a few years ago we tested whether or not a reset controller would resolve the issue.  If I recall correctly, a reset controller did not resolve the issue.  Unfortunately I did not perform the testing so I am not certain of my recollection of how the tests were carried out.  I think there are reports from others elsewhere that attempted to use a reset controller and observed the same outcome.

I took a closer look today on the power sequencing and the TPS65217's default sequence has about 26ms of delay from LDO4.  The LAN8710a datasheet indicates a minimum reset of 25ms is required.  So, that delay plus the delay associated with the time constant should be adequate to reset the PHY.

Another thought is to increase PGDLY.  It can be changed from 25ms to 100, 200 or 400ms.

jadonk, 2020-12-15:
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

Fix in version C3.

sslupsky, 2020-12-15:
That looks like a lot of capacitance.  Might want to double check the rise time spec on the 8710A.

Did anyone try changing PGDLY?

jadonk, 2020-12-16:
Where is PGDLY set?

sslupsky, 2020-12-17:
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

Yeah, it is a TPS65217C register.  I looked into this and I think it can be changed but I was not able to determine which driver to make the change to.

mvduin, 2021-03-30:
> There might be a fix here: https://wp.josh.com/2018/06/04/a-software-only-solution-to-the-vexing-beagle-bone-black-phy-issue/

This is not a good fix, it causes most processor supplies to briefly power off while SYS_5V remains powered hence the VDD_3V3B regulator bug will cause the 3.3V supply on the P9 header to remain powered.  Depending on what's connected to the beaglebone externally, this can easily cause external hardware to fry the AM335x's I/O.

>> I'm pretty sure PGDLY is in the TPS65217C, not sure we can reprogram that..
>
> Yeah, it is a TPS65217C register. I looked into this and I think it can be changed but I was not able to determine which driver to make the change to.

Changing its value at runtime is pointless since that's too late, you'd need to change its non-volatile programming.  This is presumably possible using the programming sequence documented for the TPS652170, however this requires putting 8V on PWR_EN and therefore cannot be done in-situ.

As I also commented on that article linked above, my own testing results show that the primary cause of the phy problems is not the reset time but the rise time of the reset signal:

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

In short summary, the phy just sucks.  Has it ever been considered to just swap it out for one that _doesn't_ suck?

mvduin, 2021-03-30:
Just to add, the fixes that I believe would solve the problem are:
1. replace the phy by one that doesn't have this problem
2. use a GPIO to reset the phy instead of using the processor reset signal
3. extend the reset time (by reprogramming PGDLY or using an external reset extender) and remove the capacitance on the reset line to ensure a sharp rising edge

mvduin, 2021-03-30:
> is there a safe gpio line we can use for the MDIO reset? We will eventually need to address the microSD card cage issue and therefore do a hardware rev.

You could reuse the eMMC reset line, since this line has not worked for the intended purpose (keeping eMMC in reset to ensure it does not cause problems when reusing the eMMC pins) since the Micron eMMC (whose reset input is low-level-triggered) was swapped out for Kingston eMMC (whose reset input is rising-edge-triggered).

jadonk, 2021-08-30:
Resolved in 5b065006c05e50cd58c14f73959d9bd32d439efc. Reset GPIO is GPIO1_8.

mvduin, 2021-12-15:
I only just noticed in the C3 schematic that the phy reset is being driven by an AND-gate with open-drain output and weak pull-up (10KΩ) and large capacitance (4.7μF) on its output, yielding a 47 ms RC-time, which seems like a bad idea considering slow rise time on the reset line appears to be the main cause for the phy problems in the first place. A push-pull output would have been more appropriate (and eliminates 2 components). It's not a huge deal since the reset gpio allows for multiple attempts at resetting the phy if necessary, but it is a bit of a weird choice.

Is C3 already in production btw? There's no [EEPROM identifier](https://github.com/RobertCNelson/omap-image-builder#eeprom-database) listed for it yet, will it be `A335BNLT00C3`?  I noticed the BBBs currently produced by Seeed erroneously identify themselves as `A335BNLTEIA0` (Element14 BBB Industrial A0).

svdmark, 2021-12-21:
It seems that completely removing C24 fixes the issue for us (powering the board through the cape connectors).
If I understand correctly the side effect should be that the reset button does not work reliably anymore, but we are not using that anyway.
Can anybody see a problem with this approach I am missing?

mvduin, 2021-12-24:
@svdmark As shown in my comment earlier, in my experience removing C24 helped a lot but did not fix it completely. The sensitivity to this issue varies per board though, and the one I tested on was particularly sensitive. Also, the purpose of C24 is to ensure the minimum reset time for the phy is met, and removing it without somehow extending the power-on-reset duration will violate the reset timing requirements specified in the phy's datasheet. Whether or not that will cause problems in practice, I do not know.

And of course having to patch the board is not exactly an ideal workaround.

It seems the C3 revision with the new phy reset gpio is either currently shipping or about to be, based on [this forum thread](https://forum.beagleboard.org/t/recognizing-a-beaglebone-black-rev-c3-board/31249). If a small bit of logic is added to u-boot to reset the phy until it's working properly, this problem will finally be fixed.

@jadonk This issue should probably not be closed until that software fix is actually implemented. The reset gpio by itself doesn't fix the problem if it's not being used.

jadonk, 2022-10-18:
@RobertCNelson do you know if this has been implemented yet?

RobertCNelson, 2022-10-18:
@jadonk this is a todo... i think it's best to implement the "reset" in u-boot... mainline gpio-reset for phy's cpsw, is ongoing (last i checked)..

We should just do this in u-boot, blindy reset the gpio, connected or not on the "bone-black" target..

RobertCNelson, 2022-10-18:
Just like the icev2 is done... https://github.com/u-boot/u-boot/blob/master/board/ti/am335x/board.c#L789

jadonk, 2022-10-18:
I agree. It should be innocuous to do it blind.

On Tue, Oct 18, 2022 at 11:37 AM Robert Nelson ***@***.***>
wrote:

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

Closed 2021-08-30.

Thread 5 (2018-07-23):

RE: Using the Teensy USB Device for a Marlin Device/BBB

silver2row, 2018-07-23:
Hello,

I found that the hardware is in fact a Teensy but I am not aware of what type/version. Is the Teensy type a Teensy++ 2.0?

Seth

P.S. Sorry, the USB device is what I am discussing.

Closed 2018-07-24.

Thread 6 (2018-11-05):

P10 (SD Card Slot) Obsolete

abferm, 2018-11-05:
ALPS has discontinued SCHA5B0200 without an alternative or replacement. If there is a suitable replacement from a different manufacturer the BOM should be updated.

`P10	Connector SD/MMC	ALPS	SCHA5B0200`

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

jadonk, 2020-01-10:
No suitable replacment has been found. They continue to supply this component. We did a design update with a new card cage, but it didn't pass FCC/CE and we currently have no plans to revisit. We continue to be able to design in high volume (~400k/yr).

jadonk, 2021-02-12:
Alternate proposed SD card cage options with associated layout update are:
* Molex 5027740891
* XUNPU TF-114

jadonk, 2021-08-30:
Resolved in rev_c3

Closed 2021-08-30.

Thread 7 (2019-03-25):

Beaglebone black boot kernel panic

natasha323, 2019-03-25:
Hi, i have a problem with BBB.

I have two sd images and both worked fine.
Then during work it disconnected from PC, i tried to reboot it, but reboot fails with this log with both sd cards:

U-Boot SPL 2013.04-dirty (Jul 10 2013 - 14:02:53)
musb-hdrc: ConfigData=0xde (UTMI-8, dyn FIFOs, HB-ISO Rx, HB-ISO Tx, SoftConn)
musb-hdrc: MHDRC RTL version 2.0
musb-hdrc: setup fifo_mode 4
musb-hdrc: 28/31 max ep, 16384/16384 memory
USB Peripheral mode controller at 47401000 using PIO, IRQ 0
musb-hdrc: ConfigData=0xde (UTMI-8, dyn FIFOs, HB-ISO Rx, HB-ISO Tx, SoftConn)
musb-hdrc: MHDRC RTL version 2.0
musb-hdrc: setup fifo_mode 4
musb-hdrc: 28/31 max ep, 16384/16384 memory
USB Host mode controller at 47401800 using PIO, IRQ 0
OMAP SD/MMC: 0
mmc_send_cmd : timeout: No status update
reading u-boot.img
reading u-boot.img

U-Boot 2013.04-dirty (Jul 10 2013 - 14:02:53)

I2C:   ready
DRAM:  512 MiB
WARNING: Caches not enabled
NAND:  No NAND device found!!!
0 MiB
MMC:   OMAP SD/MMC: 0, OMAP SD/MMC: 1
*** Warning - readenv() failed, using default environment

musb-hdrc: ConfigData=0xde (UTMI-8, dyn FIFOs, HB-ISO Rx, HB-ISO Tx, SoftConn)
musb-hdrc: MHDRC RTL version 2.0
musb-hdrc: setup fifo_mode 4
musb-hdrc: 28/31 max ep, 16384/16384 memory
USB Peripheral mode controller at 47401000 using PIO, IRQ 0
musb-hdrc: ConfigData=0xde (UTMI-8, dyn FIFOs, HB-ISO Rx, HB-ISO Tx, SoftConn)
musb-hdrc: MHDRC RTL version 2.0
musb-hdrc: setup fifo_mode 4
musb-hdrc: 28/31 max ep, 16384/16384 memory
USB Host mode controller at 47401800 using PIO, IRQ 0
Net:   <ethaddr> not set. Validating first E-fuse MAC
Phy not found
PHY reset timed out
cpsw, usb_ether
Hit any key to stop autoboot:  0
gpio: pin 53 (gpio 53) value is 1
mmc0 is current device
micro SD card found
mmc0 is current device
gpio: pin 54 (gpio 54) value is 1
SD/MMC found on device 0
reading uEnv.txt
33 bytes read in 4 ms (7.8 KiB/s)
Loaded environment from uEnv.txt
Importing environment from mmc ...
gpio: pin 55 (gpio 55) value is 1
4381184 bytes read in 816 ms (5.1 MiB/s)
gpio: pin 56 (gpio 56) value is 1
24238 bytes read in 55 ms (429.7 KiB/s)
Booting from mmc ...
## Booting kernel from Legacy Image at 80007fc0 ...
   Image Name:   Linux-3.8.13
   Image Type:   ARM Linux Kernel Image (uncompressed)
   Data Size:    4381120 Bytes = 4.2 MiB
   Load Address: 80008000
   Entry Point:  80008000
   Verifying Checksum ... OK
## Flattened Device Tree blob at 80f80000
   Booting using the fdt blob at 0x80f80000
   XIP Kernel Image ... OK
OK
   Using Device Tree in place at 80f80000, end 80f88ead

Starting kernel ...

Uncompressing Linux... done, booting the kernel.
[    0.190418] omap2_mbox_probe: platform not supported
[    0.200964] tps65217-bl tps65217-bl: no platform data provided
[    0.276307] omap_hsmmc mmc.5: of_parse_phandle_with_args of 'reset' failed
[    0.340932] pinctrl-single 44e10800.pinmux: pin 44e10854 already requested by 44e10800.pinmux; cannot claim for gpio-leds.8
[    0.352646] pinctrl-single 44e10800.pinmux: pin-21 (gpio-leds.8) status -22
[    0.359960] pinctrl-single 44e10800.pinmux: could not request pin 21 on device pinctrl-single
[    0.464476] Unhandled fault: external abort on non-linefetch (0x1008) at 0xe09e2000
[    0.472492] Internal error: : 1008 [#1] SMP THUMB2
[    0.477498] Modules linked in:
[    0.480701] CPU: 0    Not tainted  (3.8.13 #12)
[    0.485448] PC is at cpsw_probe+0x3ee/0x88c
[    0.489840] LR is at ioremap_page_range+0xad/0xe8
[    0.494761] pc : [<c0250e16>]    lr : [<c019f111>]    psr: 80000133
[    0.494761] sp : df051e20  ip : e09e4000  fp : df3c6590
[    0.506753] r10: df3784a0  r9 : 00000000  r8 : df10d800
[    0.512214] r7 : df10d810  r6 : e09e2000  r5 : df3c6540  r4 : df3c6000
[    0.519033] r3 : 00000000  r2 : 00000800  r1 : c0250e03  r0 : e09e2000
[    0.525855] Flags: Nzcv  IRQs on  FIQs on  Mode SVC_32  ISA Thumb  Segment kernel
[    0.533674] Control: 50c5387d  Table: 80004019  DAC: 00000015
[    0.539678] Process swapper/0 (pid: 1, stack limit = 0xdf050240)
[    0.545954] Stack: (0xdf051e20 to 0xdf052000)
[    0.550517] 1e20: 00000000 c06a7440 00000001 df3c6298 df04cac0 df3c9548 00000000 df051e88
[    0.559069] 1e40: df10c408 c00d0f2f 22222222 df3c9548 df3cae40 df3c9548 df051e88 c00d0e77
[    0.567620] 1e60: df04cac0 df3c9548 df3c9548 00000000 df3c95c8 c00d1557 df0474b8 c004184d
[    0.576171] 1e80: 00000000 00000003 00000008 00000020 df10d844 df10d810 df10d844 c072b1fc
[    0.584722] 1ea0: c072b204 c06beb18 00000000 00000000 00000000 c0201597 c020158b c0200b37
[    0.593272] 1ec0: 00000000 df10d810 df10d844 c06beb18 00000000 c06d9d80 00000000 c0200c45
[    0.601823] 1ee0: c06beb18 c0200c15 00000000 c01ffd5f df047478 df104580 c06beb18 df3cae40
[    0.610375] 1f00: c06b5380 c02005d1 c054e5f7 c054e5f8 c06beb18 c064e048 c064e028 c0644ffd
[    0.618926] 1f20: c06d9d80 c0201025 00000007 c064e048 c064e028 c0644ffd c06d9d80 00000000
[    0.627477] 1f40: 00000000 c0008661 00000007 00000007 c06a27e0 00000007 c064e044 00000007
[    0.636028] 1f60: c064e048 c064e028 c06d9d80 000000f6 c0660134 c062d65d 00000007 00000007
[    0.644578] 1f80: c062d15d c0399955 00000000 00000000 c0399955 00000000 00000000 00000000
[    0.653128] 1fa0: 00000000 c039995b 00000000 c000c5f9 00000000 00000000 00000000 00000000
[    0.661677] 1fc0: 00000000 00000000 00000000 00000000 00000000 00000000 00000000 00000000
[    0.670227] 1fe0: 00000000 00000000 00000000 00000000 00000013 00000000 fe75e5cd a7652d8e
[    0.678808] [<c0250e16>] (cpsw_probe+0x3ee/0x88c) from [<c0201597>] (platform_drv_probe+0xd/0xe)
[    0.688005] [<c0201597>] (platform_drv_probe+0xd/0xe) from [<c0200b37>] (driver_probe_device+0x77/0x154)
[    0.697923] [<c0200b37>] (driver_probe_device+0x77/0x154) from [<c0200c45>] (__driver_attach+0x31/0x44)
[    0.707750] [<c0200c45>] (__driver_attach+0x31/0x44) from [<c01ffd5f>] (bus_for_each_dev+0x27/0x44)
[    0.717215] [<c01ffd5f>] (bus_for_each_dev+0x27/0x44) from [<c02005d1>] (bus_add_driver+0x65/0x158)
[    0.726678] [<c02005d1>] (bus_add_driver+0x65/0x158) from [<c0201025>] (driver_register+0x4d/0xac)
[    0.736052] [<c0201025>] (driver_register+0x4d/0xac) from [<c0008661>] (do_one_initcall+0x65/0xf0)
[    0.745429] [<c0008661>] (do_one_initcall+0x65/0xf0) from [<c062d65d>] (kernel_init_freeable+0xb9/0x14c)
[    0.755352] [<c062d65d>] (kernel_init_freeable+0xb9/0x14c) from [<c039995b>] (kernel_init+0x7/0x90)
[    0.764821] [<c039995b>] (kernel_init+0x7/0x90) from [<c000c5f9>] (ret_from_fork+0x11/0x38)
[    0.773554] Code: fe26 e208 f8c4 05c0 (6803) f44f
[    0.778565] ---[ end trace 3b1325c5f0465841 ]---
[    0.783690] mmc1: BKOPS_EN bit is not set
[    0.787989] Kernel panic - not syncing: Attempted to kill init! exitcode=0x0000000b
[    0.787989]
[    0.797540] drm_kms_helper: panic occurred, switching back to text console

At first we got all four LEDs on, then only LED 2 stays on, and kernel doesn't boot.
Could you help to determine where the problem is and whether it can be fixed?

jadonk, 2019-11-13:
Is this still an issue?

Closed 2020-05-14.

Thread 11 (2021-03-30):

VDD_3V3B regulator latched on by leakage, battery pins unsafe to use as result

mvduin, 2021-03-30:
The BBB has three 3.3V supply rails:
- VDD_3V3AUX from PMIC LDO3 (100 mA) is only used for the power led
- VDD_3V3A from PMIC LDO4 (400 mA) is used for the AM335x 3.3V I/O supplies and a few miscellaneous on-board uses
- VDD_3V3B from discrete LDO U4 (500 mA) is available on P9 for external hardware and also used for various on-board uses such as eMMC, μSD card, ethernet phy, and the console uart buffer.

Since 3V3B is used to drive signals into the AM335x, it is critical this supply comes up after (or simultaneous with) 3V3A. The BBB attempts to ensure this by simply using 3V3A as enable-signal for 3V3B, which has the desired result during power-up. During power-down however a problem arises: current injected from 3V3B into AM335x I/Os flows leaks back onto 3V3A (via protection diodes inside the AM335x) which causes 3V3A to remain high enough to keep 3V3B permanently enabled as long as SYS_5V continues to supply LDO U4.

The impact is easily visible in a scope capture of the power-off sequence:
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
- t = 0 ms: PMIC starts power-off sequence by deasserting PGOOD and (bizarrely) cutting power to SYS_5V, which means the system is now running on capacitors only
- t = 2 ms: DCDC2 and DCDC3 supplying VDD_MPU and VDD_CORE respectively (not depicted) are shut off
- t = 3 ms: LDO4 supplying VDD_3V3A is shut off, but VDD_3V3B remains on
- t = 4 ms: LDO2 supplying VDD_3V3AUX (not depicted) is shut off, SYS_5V has fallen to 3.5V and VDD_3V3B is starting to track SYS_5V - 0.1V
- t = 9 ms: LDO3 supplying VDD_1V8 is shut off
- t = 10 ms: DCDC1 supplying VDDS_DDR (not depicted) is shut off
- t = 11 ms: LDO1 supplying VRTC (not depicted) is shut off and LDO_PGOOD is deasserted, finishing the PMIC's power-off sequence
- t = 20 ms (approx): LDO U4 supplying VDD_3V3B _finally_ shuts off

As a result, the absolute maximum ratings of the AM335x (max I/O voltage = supply voltage + 0.3v) are violated for about 15 ms on each power-off.  Whether this has any long-term reliability impact in practice is unclear.

A far more serious situation occurs when the PMIC battery terminals are used to power the system, in which case SYS_5V is always-on and as a result LDO U4 never shuts off at all:
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

In this state there's about 35 mA continuously flowing from 3V3B into the AM335x (and back out to 3V3A) via pull-ups on about two dozen pins. However if one makes the mistake of having a serial console cable connected during this, the console uart buffer (powered from 3V3B) drives *45 mA* of current into UART0_RXD, causing 3V3A to be raised more than 2V above the 1.8V supplies, a situation the am335x datasheet repeatedly and emphatically warns must be avoided under all circumstances. Yikes.

Note that this is actually an ancient issue dating all the way back to the BeagleBone White ([discussion thread](https://groups.google.com/g/beagleboard/c/7sxPePT7wkM)), whose LDO U8 supplying VDD_3V3EXP suffered from the same problem, except it had no on-board leakage paths into AM335x I/O like the BBB does (but external hardware powered from VDD_3V3EXP easily creates such paths obviously)

mvduin, 2021-03-30:
Possible fixes:
- Use a tracking voltage regulator for VDD_3V3B that tracks the voltage of VDD_3V3A.
- Use PGOOD as enable-signal for the 3V3B.  the only caveat here is that this is an 1.8V signal while the V_IH(min) of the TL5209's enable input is 2V, so this signal would need to be buffered / level-shifted to 3.3V or a different LDO needs to be used which does accept an 1.8V enable-signal.
- Reprogram the PMIC to enable LDO2 (VDD_3V3AUX) after or at the same time as LDO4 (VDD_3V3A) and use LDO2 as enable-signal for the 3V3B.  This option appears very annoying since changing the non-volatile programming of the TPS65217 (assuming the procedure documented in section 7.6.1.1 of the [TPS652170 datasheet](https://www.ti.com/lit/ds/symlink/tps652170.pdf) applies to all TPS65217 family members) requires applying **8V** to its PWR_EN pin.
- For new designs, consider replacing the TPS65217 by the TPS65218D0, which supplies 3.3V using a buck-boost converter which can supply 1.6A output hence eliminates the need for a separate discrete 3.3V LDO.  This also greatly improves energy efficiency, and it can provide stable 3.3V output even if the system is supplied directly by a nearly-depleted Li-Ion battery, albeit with reduced output current (down to 1A 3.3V output from 2.8V input).

Workarounds:
- if your power requirements on 3.3V are modest enough, [replace LDO U4 by a patch wire](https://groups.google.com/g/beagleboard/c/7sxPePT7wkM/m/_oNSCta5WusJ).

sslupsky, 2021-08-30:
This is probably quite an important issue to resolve since the demise of Andicelabs.  Andicelabs had a power cape with a separate battery power path and it worked reasonably well.  However, for quite a while now that cape is no longer available so we have to resort back to the PMIC battery pins.

Ixanom, 2021-11-02:
BTW Figure 25 in the SRM document still shows the EN pin of U4 wired to VDD_3v3AUX rail. That's misleading.

Also it's interesting, in the section 5.4, external LDO TLV70233 is mentioned. In that LDO, the hysteresis window for EN input is relatively narrow. So in theory, it would be practical to implement a quick and dirty fix using just a voltage divider of two resistors on that pin. Also, that LDO optionally has internal discharging capability for Vout. For some reason, they'd decided to substitute that part with TL5209, which seems less suitable here, imho...

apper002, 2022-04-11:
Having several BBB with Roboticscape flying my pretty expensive stuff...
Does this setup, with only the Cape being powered by the Jack with 3S Lipo prevent these issues??
Any ideas or help would be much appreciated!

mvduin, 2022-04-11:
This issue is about the BBB's own battery pins (1S), which are not normally accessible by capes (it's an unplaced header). The robotics cape simply provides the BBB with 5V.

apper002, 2022-04-11:
Got it, ThX

Thread 12 (2021-06-18):

Connecting the BeagleBone Black with mikroE Click Boards/mikroBus Cape help wanted

ckoehler0, 2021-06-18:
TL;DR: How to access a mikroE click module via SPI using a BeagleBone Black and a mikroBus Cape?

Hello,
I'm currently trying to connect my BeagleBone Black Rev C with the mikroBus Cape (PID: MIKROE-1857).
Furthermore, I want to get access to a MRAM click module (https://www.mikroe.com/mram-click) by connecting it with the mikroBus Cape. My BBB is running the latest Debian image (AM3358 Debian 10.3 2020-04-06 4GB SD IoT) and with uname_r=4.14.108-ti-r141.

Firstly, I tried to work with U-Boot overlays:

1.
I followed the instructions on https://elinux.org/Tigal:BeagleBone_mikrobuscape but used the updated url "https://github.com/mikroe/BBB-mikroBUS-Cape". But, after setting the "uboot_overlay_addr0=/lib/firmware/BB-MIKROBUS-01-00A1.dtbo" in the uEnv.txt the board would not boot.

2.
I followed the instructions on "https://github.com/beagleboard/bb.org-overlays/" and I also upgraded my bootloader (https://elinux.org/Beagleboard:BeagleBoneBlack_Debian#U-Boot_Overlays). After setting all four BB-MIKROBUS-CAPE-X.dtbo files in "uboot_overlay_addrY=..." the board booted. (It also boots when only one is enabled)

Next I wanted to get access to the click module on the mikroBus Cape.

A.
I downloaded the mikroSDK 2.0 (https://www.mikroe.com/mikrosdk) on the BBB, but I couldn't find nor create the correct board.h file to get it running. After stumbling upon "NectoStudio" I could only find support for generic ARM boards which are from the STM32 family, which the BBB Rev C is not.  (Getting access to the mikroSDK 2.0 would allow the usage of scripts via https://libstock.mikroe.com/ which would open up many other possibilities)

As I couldn't get the mikroSDK 2.0 working, I tried to get direct access via SPI to the click module. For that I put the click module on the mikroBus Cape slot 3 (CS - Pin 17, D1/MISO - Pin 21, D0/MOSI - Pin 18 and CLK - Pin 22).

B.
After some research I found the iobb library and followed its instructions
(https://www.element14.com/community/community/designcenter/single-board-computers/next-genbeaglebone/blog/2019/08/15/beaglebone-black-bbb-io-gpio-spi-and-i2c-library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).
After installation, I tried to run the example SPI code without any changes (so not using option 2.) and it runs error-free. But when I enable the BB-MIKROBUS-CAPE-3.dtbo I always get "ERROR: open() for /sys/devices/platform/ocp/ocp:P9_17_pinmux/state failed, No such file or directory"  So, after some investigation I realised that BB-MIKROBUS-CAPE-3.dtbo sets "P9_X_pinmux { status = "disabled"; };" for X = {18,19,21,22} and doesn't enable spi in its pinctrl-section, which could be the cause for the problem.

So I tried two things:
- I just used BB-MIKROBUS-CAPE-2.dtbo which doesn't set "P9_X_pinmux { status = "disabled"; };" for any X = {18,19,21,22} and the example code ran error-free.
- I changed BB-MIKROBUS-CAPE-3.dtbo so that spi gets enabled in the pinctrl-section and the example code ran error-free.

To my understanding both of this ways should enable SPI, but when I try to read previously written data from the click module, I can't receive any data at all or select a cell to write to.

So, is there a way to get any of my attempts working so that I can get access to the click module via SPI? Or have I overlooked an other solution?

Btw:
- I tried all solutions on the board itself and on a microSD card which I set up using https://beagleboard.org/getting-started
- I also tried it with and without setting "disable_uboot_overlay_video=1" in the uEnv.txt

jadonk, 2021-10-18:
Please ask for support on forum.beagleboard.org. If resolved, please close this issue and point to the discussion. If unable to resolve, please contact me via my calendar at https://beagleboard.org/about/jkridner.

ckoehler0, 2021-12-14:
The issues were due to an internal error of the beagle board.

Closed 2021-12-14.

Thread 13 (2022-01-12):

Enhancement request: let's measure the battery voltage

Ixanom, 2022-01-12:
BBB design uses the PMIC which is extremely suitable for a battery powered applications. In such applications, it's essential for the SW to be aware of the battery voltage. The PMIC integrates analog multiplexer, that can provide this information. In the BeagleBone design, the  multiplexer's output (MUX_OUT pin) is routed to AN7 input of the processor and this is fine.
For some reason, in the BBB design that feature is broken and the MUX_OUT pin is left not connected. So the customers wishing to get it back having to exercise their soldering skills. Because of the PMIC part dimensions, it's a bit difficult to solder a wire to the MUX_OUT pin manually.
If it's a problem to completely fix the PCB routing in the future revision, I'd like to propose to implement a workaround in the form of test point via on the PCB somewhere near the MUX_OUT pin of the PMIC. That will simplify the soldering work.

mvduin, 2022-01-12:
Hmm, I do wonder why this change was made. My initial thought was that there might be a concern with the PMIC driving the analog inputs of the AM335x when it's powered off, but when the PMIC goes into OFF state it resets all registers which includes setting the mux back to default (high-Z) so that shouldn't be a problem.

BTW, be cautioned: using the battery terminals of the BBB is not officially supported and not advisable. A quirk of the TPS65217 PMIC is that SYS_5V remains at battery voltage even when the board is powered off. Pull-up resistors on various I/Os cause current from VDD_3V3B to be injected into processor pins back onto VDD_3V3A, which is used as enable-signal for the VDD_3V3B regulator, causing it to never shut down hence causing this current leakage to persist. At the very least this causes significant battery drain even when powered off, but if any AM335x I/O pins are strongly driven high from VDD_3V3B, e.g. by external hardware on the expansion headers or by the on-board serial console buffer (when a serial cable is attached), then this will seriously violate the absolute maximum ratings and potentially damage the AM335x.

See also https://elinux.org/BeagleBone_Power_Management#Battery and the discussion thread it links to.

Ixanom, 2022-01-13:
When I'd encountered the 3V3B problem for the first time, I googled a little in the course of investigation and have found all the discussions. Seems it's a well known problem so it must be known to the designers for years. Moreover the BBB is by no mean a new design so it must be reviewed with TI more than once. I was sure that by now it's free from a HW defects of such severity. Recently, the new PCB version has emerged but still with no fix. No idea why it's so poor.

Anyway for the time being every new customer have to do the mandatory homework before starting using the board. To fix the problem, I opted to populate my boards with piggybacked voltage monitor (see the image). It's STM1061, which was suggested in the discussions. The part is easy to source and work just fine.
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

But now the bottom side of the board is more vulnerable to mechanical damage. Some kind of cover is necessary. So the cover board is built to protect the patchwork. That provides enough room for battery. Nothing special.
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

And Matthijs, thanks a lot for your efforts in sharing the information!

apper002, 2022-04-11:
So this also works with every Cape connected to the BBB?

mvduin, 2022-04-11:
None of this is related to capes in any way.

apper002, 2022-04-11:
That's correct. But does powering the BBB from the Cape and not BBB 5V jack influence this...

Thread 16 (2022-06-27):

TPS65217 not available anymore

mickae1, 2022-06-27:
Hi,

The TPS65217 is not available anymore, how can we replace it ?

cschweers, 2022-06-27:
According to TI the TPS65217 ist still [active](https://www.ti.com/product/TPS65217).

mickae1, 2022-06-27:
yes, but nowhere to be found !

cschweers, 2022-06-27:
> yes, but nowhere to be found !

... my distributor show me that 4.274 parts are available.

mvduin, 2022-06-27:
The entire semiconductor industry has availability problems, that's not something to be reported as a bug on a design.

You can use either the TPS65217C or TPS65217D, anything else would require a substantial redesign of the schematic and PCB and modifications to u-boot and the device tree.

mickae1, 2022-06-27:
I agree it's not a bug, but you can't built anymore beaglebone black if you don't have the component ...

Maybe it's time to create a new design ?

Thread 19 (2024-01-11):

Inconsistency between figure 39 and text in SRM + comments on the text relating to boot

TooManyTakenUsernames, 2024-01-11:
In Figure 39 of the user manual, first in the boot sequence when the boot switch is pressed, is "SPI0".
The text states: "On boot, the processor will look for the SPIO0 port first". So the label between these is not consistent.

Comment on the text:
Section 5.3.5 discusses 4 different boot modes, eMMC Boot, SD Boot, Serial Boot and USB boot. It could be helpful (especially for beginners) to relate back to these boot modes in section 6.8 (possibly in relation to figure 39). The text about the serial boot especially feels unconnected to section 6.8: "Serial Boot…This mode will use the serial port to allow downloading of the software direct. A separate USB to serial cable is required to use this port."

I'm assuming that booting from SPI0 or UART is booting in the serial mode, but I cannot confirm this anywhere just by reading the text.

mvduin, 2024-01-11:
Issues for the [current SRM](https://docs.beagleboard.org/latest/boards/beaglebone/black/) should probably be reported [here](https://openbeagle.org/docs/docs.beagleboard.io/-/issues) instead.

It looks like the [current version](https://docs.beagleboard.org/latest/boards/beaglebone/black/ch05.html#boot-modes) doesn't even mention SPI boot, which I personally don't think is an improvement since even if you never use it, its presence in the boot sequence (when the boot switch was down at power-on) means P9.17, P9.18, and P9.22 will be configured as outputs and will toggle as a result of bootrom's attempt to boot from an SPI flash on SPI0 CS0.

Serial boot is referring to UART0 (XMODEM) boot only.

TooManyTakenUsernames, 2024-01-12:
Thank you! And many thanks for clarifying that the serial boot refers to UART only.
I was reading the [PDF version](https://github.com/beagleboard/beaglebone-black/blob/master/BBB_SRM.pdf) and the link for supplying comments and errors in there leads to here:

"Supply comments and errors via https://github.com/beagleboard/beaglebone-black/issues"

I will close this issue and open an issue at the link you supplied instead.

Thread 20 (2024-04-14):

Conversion of (0-5V) Analog Signal to (0-1.8V) without Loss of Information

NabilaTasnim, 2024-04-14:
I have an analog signal of (0-5V). I want to use the ADC of BeagleBone Black to process it, but the ADC inputs can take a maximum of 1.8V. If I down-scale the signal to (0-1.8V), then -

How should I do this ensuring no loss/minimum loss of information or resolution? If there is some loss, then is there any way to retrieve the original signal after processing it with the ADC of BeagleBone Black?

cschweers, 2024-04-14:
This is precisely the purpose of the so-called [voltage divider](https://en.wikipedia.org/wiki/Voltage_divider) in [electrical engineering](https://electronics.stackexchange.com/)

NabilaTasnim, 2024-04-14:
If I use a voltage divider to scale down the voltage and then use ADC for digital conversion, won't I lose some accuracy and information? @cschweers @jadonk @RobertCNelson @pdp7

jadonk, 2024-04-16:
yes, but not much depending on the accuracy of the resistors and amount of capacitance on the line.

mvduin, 2024-04-16:
No, scaling the full range of the signal you want to measure to match the full range of the ADC you're using to measure it is exactly how you achieve the best accuracy possible with that particular ADC.

Also, this sort of question is better asked on the forum at https://forum.beagleboard.org/ instead of using a github issue.

Thread 21 (2024-05-07):

BeagleBone Cape Board Design without EEPROM

NabilaTasnim, 2024-05-07:
I am confused about one thing. If I design a BeagleBone Cape Board without EEPROM and use it with BeagleBone Black, then will that Cape Board work just like a PCB board? @RobertCNelson @jadonk @pdp7 @MarkAYoder

RobertCNelson, 2024-05-07:
If you don't install an eeprom, it just won't auto-load... Nothing stopping from writing directions on using an overlay for your cape.

NabilaTasnim, 2024-05-07:
@RobertCNelson I was thinking if I connect the cape board over the BeagleBone Black and control the GPIO pins of the BeagleBone Black, will I be able to use the cape board? I meant, can I then use the cape board just like the breadboard or protoboard?

RobertCNelson, 2024-05-07:
eeprom is only used for 'auto' detection of what board is plugged into the bbb.. as long as you know what board is plugged in your can load the appropriate overlay

NabilaTasnim, 2024-05-07:
But I want the cape to serve the purpose of the PCB board. It does not need to be intelligent. The cape’s header pins will be like jumper wires, so if I enable one GPIO pin of BeagleBone Black, the corresponding header pin of the connected cape will also be enabled like the jumper wire. So, is it possible to use the header pins of the cape like the jumper wires? @RobertCNelson

RobertCNelson, 2024-05-07:
The only intelligent feature is the erprom. If you don't have eeprom, you can write your own overlay to configure the pin in any mode that is supported.

adhishhh, 2024-06-18:
Yes, your Cape Board without EEPROM will work like a PCB with BeagleBone Black. You'll just need to create a Device Tree Overlay (DTO) for manual configuration instead of automatic detection via EEPROM. This lets you control the Cape's functionalities through BeagleBone Black's software, similar to how you'd use jumper wires on a breadboard.
