beagleboard/beaglebone-black/BBB-SCH.pdf

5

4

3

2

1

D | D
C | C
B | B
A | A

8

1

# eMMC FLASH

9

3

2

# HDMI FRAMER

# 10/100 ETHERNET

10

# DDR3 MEMORY

# PROCESSOR 2 OF 3, UAB PORTS

7

# LED, CONFIGURATION AND BUTTON

PAGE NO. | SCHEMATIC PAGE

# PROCESSOR 3 OF 3

# PROCESSOR 1 OF 3, JTAG HEADER

4

# POWER MANAGEMENT

5

# COVER PAGE

6

# This schematic is *NOT SUPPORTED* and DOES NOT constitute a reference design. Only "community" support is allowed via

resources at BeagleBoard.org/discuss.

# THERE IS NO WARRANTY FOR THIS DESIGN, TO THE EXTENT PERMITTED BY APPLICABLE LAW. EXCEPT WHEN OTHERWISE STATED IN WRITING THE COPYRIGHT HOLDERS AND/OR OTHER PARTIES

PROVIDE THE DESIGN "AS IS" WITHOUT WARRANTY OF ANY KIND, EITHER EXPRESSED OR IMPLIED, INCLUDING, BUT NOT LIMITED TO,

# THE IMPLIED WARRANTIES OF MERCHANTABILITY AND FITNESS FOR A PARTICULAR PURPOSE. THE ENTIRE RISK AS TO THE QUALITY AND PERFORMANCE OF THE DESIGN IS WITH YOU. SHOULD THE DESIGN PROVE DEFECTIVE, YOU ASSUME THE COST OF ALL NECESSARY

SERVICING, REPAIR OR CORRECTION.

11 | EXP CONN, uSD
REV | Description | DATE | BY
A4A | Initial production Release. | 11/19/2012 | GC
A5 | On the initial production release the processors were to be found incorrect as supplied by TI.
| Parts while marked AM3359 were actually AM3352. This revision uses the correct parts. | 1/2/2013 | GC
1. Deleted R29-R44 from the LCD lines.
2. Added 47pf capacitors C156-C173 to LCD data lines to ground.
3. Changed schematic revision to A5A.

A5A

4. Changed a few footprints after PCB update for above changes.
5. Added access point for the battery function of the TPS65217C. | 2/8/2013 | GC

# 7. Added power button to enable sleep, wakeup, power down and power up features on the

system.

# 6. Added Ferrite beads in series with LED power and 5V power rail of the USB host

connector. Required to pass FCC/CE testing due to noise emissions on that pin.

A5B 1. Added 100K pulldown on J1 pin 4 to prevent crosstalk when serial cable is not connected into PCB layout.

2. Changed the LED resistors to 4.75K to lower the brightness.

5/21/2013

# 8. Added Modification to add 100K ohm resistor to ground to prvent crosstalk when serial

cable is not plugged in.

GC

A5C | 6/12/2013 | GC 1. Changed R46, R47,R48 to 0 ohms.
2. Changed R45 to 22 Ohms.
Change was made due to production failures on some boards due to differences in impedances.

A6

# 1. Moved the enable for the VDD_3V3B regulator to VDD_3V3A rail. Change was made to

reduce the delay between the ramp up of the 3.3V rails.
2. Added a AND gate to the SYS_RESETn circuitry. There is a small chance that on power up | 7/25/2013 | GC

# the nRESETOUT signal on the processor may go high, causing the SYS_RESETn signal to go

HI before it should. This change reenforces the reset with the PORZn reset signal.
3. Added optional zero ohm resistor to tie GND_OSC0 to system ground.
A6A | 12/13/2013 | GC
1. Added optional zero ohm resistor to tie GND_OSC1 to system ground.
2. Changed C106 to a 1uF capacitor.
3. Changed C24 to a 2.2uF capacitor.
B | 1. Changed the processor to the AM3358BZCZ100. | 1/20/2014 | GC
4. Made R8 installed and R9 not installed.
C | 1. Increased the eMMC from 2GB to 4GB; The PCB revision for this board is Rev B6. | 3/21/2014 | GC

C3

1. Page 3: Added series resistor (R35,R36,R43,R44,R168-R173)=33R to the MMC1 lines,
C175=DNI(10pF) to the MMC1_CLK to DGND; Changed C24 from 2.2uF to DNI.

4/1/2021

3. Page 8: Connected the Pin A6 J5 of U13(eMMC IC) to DGND.
4. Page 9: Added AM3358 GPIO1_8 and a Positive-AND gate(U1) to reset ethernet LAN8710A; Added series resistor (R38-R42)=33R to the LAN8710A TX lines;
Changed (C137-C140) from DNI to 10pF.

# 5. Page 11: Changed the MicroSD Connector from ALPS_SCHA5B0200 (EOL) to YU LIANG_YL004-030-001; Added series resistor (R2,R13,R15,R16,R31,R32)=33R

and C5=DNI(10pF) to the MMC0 lines.

# JQ.Xin

6. The PCB Revision for this board is RevC, BOM is RevC3.
2. Page 4: Changed USB1_VBUS series resistor from FB8=0.1R 0805 to R37=0R 0402.

C3

1. Page 2: Change P1 footprint for the production.
2. Page 10: Change P6 footprint for the production. | 12/29/2021 | JN.F
3.The PCB version remains unchanged and this board is RevC, BOM is RevC3.

D1

# 1. Page 10: Change the HDMI chip from NXP_TDA19988BHN/C1,557

to ITE_IT66122FN for the TDA19988BHN EOL.
2. Page 10: Adjust the HDMI peripheral circuit of HDMI Transmitter.
3. Page 03: Remove U6,R21,C27 components.

# 24/03/2025 JN.FUONG

4.The PCB Revision for this board is RevD, BOM is RevD1.

# 5. Add C192,C194-C198 to pass FCC/CE

# Title

Size | Document Number | Rev
Date: | Sheet | of
| 450-5500-001 | D1

# BeagleBone Black Cover Page

B
Wednesday, March 26, 2025 | 1 | 11

# Title

Size | Document Number | Rev
Date: | Sheet | of
| 450-5500-001 | D1

# BeagleBone Black Cover Page

B
Wednesday, March 26, 2025 | 1 | 11

# Title

Size | Document Number | Rev
Date: | Sheet | of
| 450-5500-001 | D1

# BeagleBone Black Cover Page

B
Wednesday, March 26, 2025 | 1 | 11

500mA

### DGND

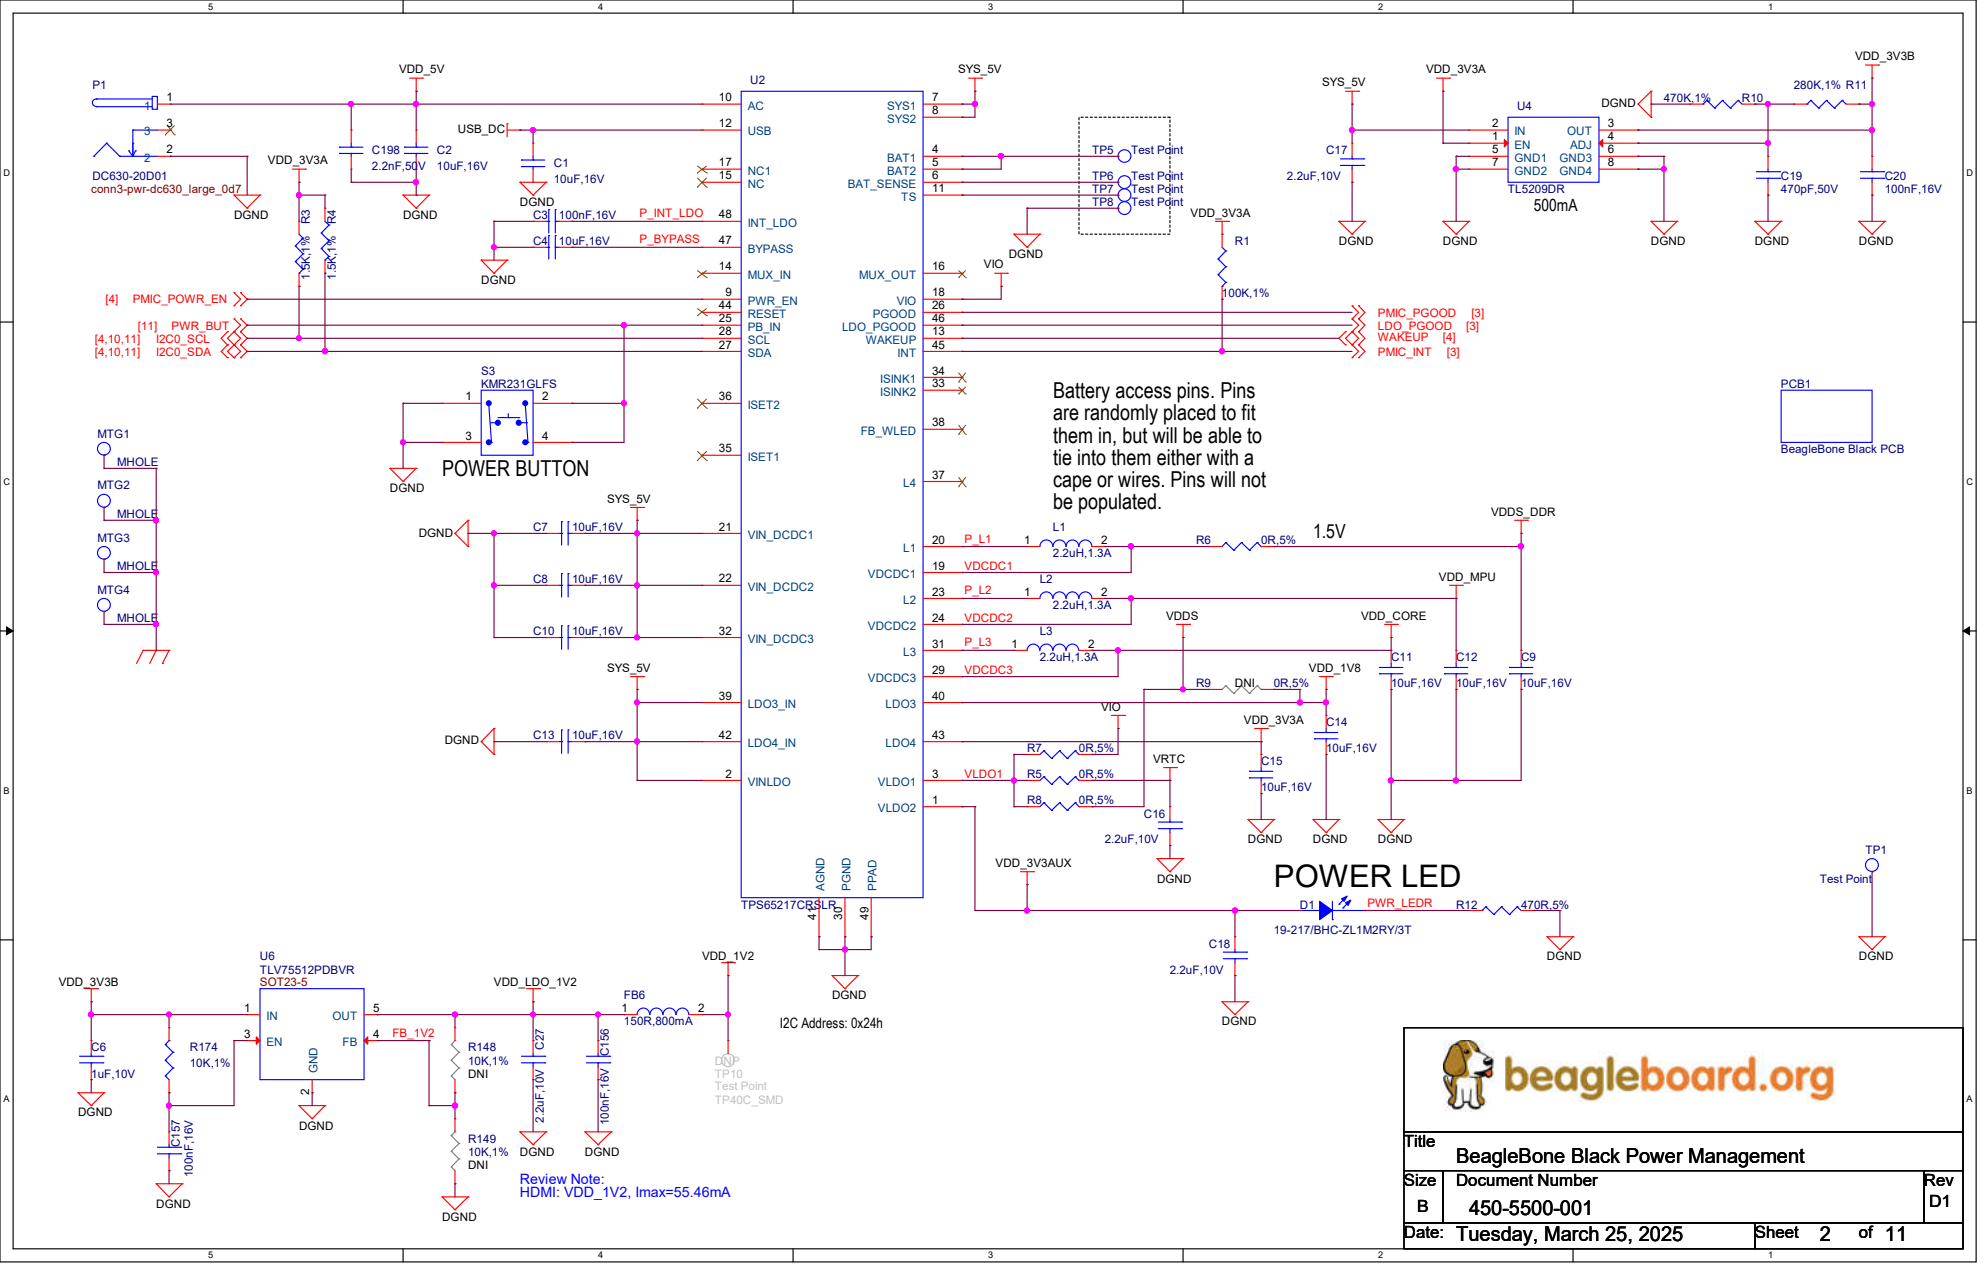
[picture p82: page 2]

Battery access pins. Pins
are randomly placed to fit
them in, but will be able to
tie into them either with a
cape or wires. Pins will not
be populated.

Title
BeagleBone Black Power Management

# RESET

3.3V

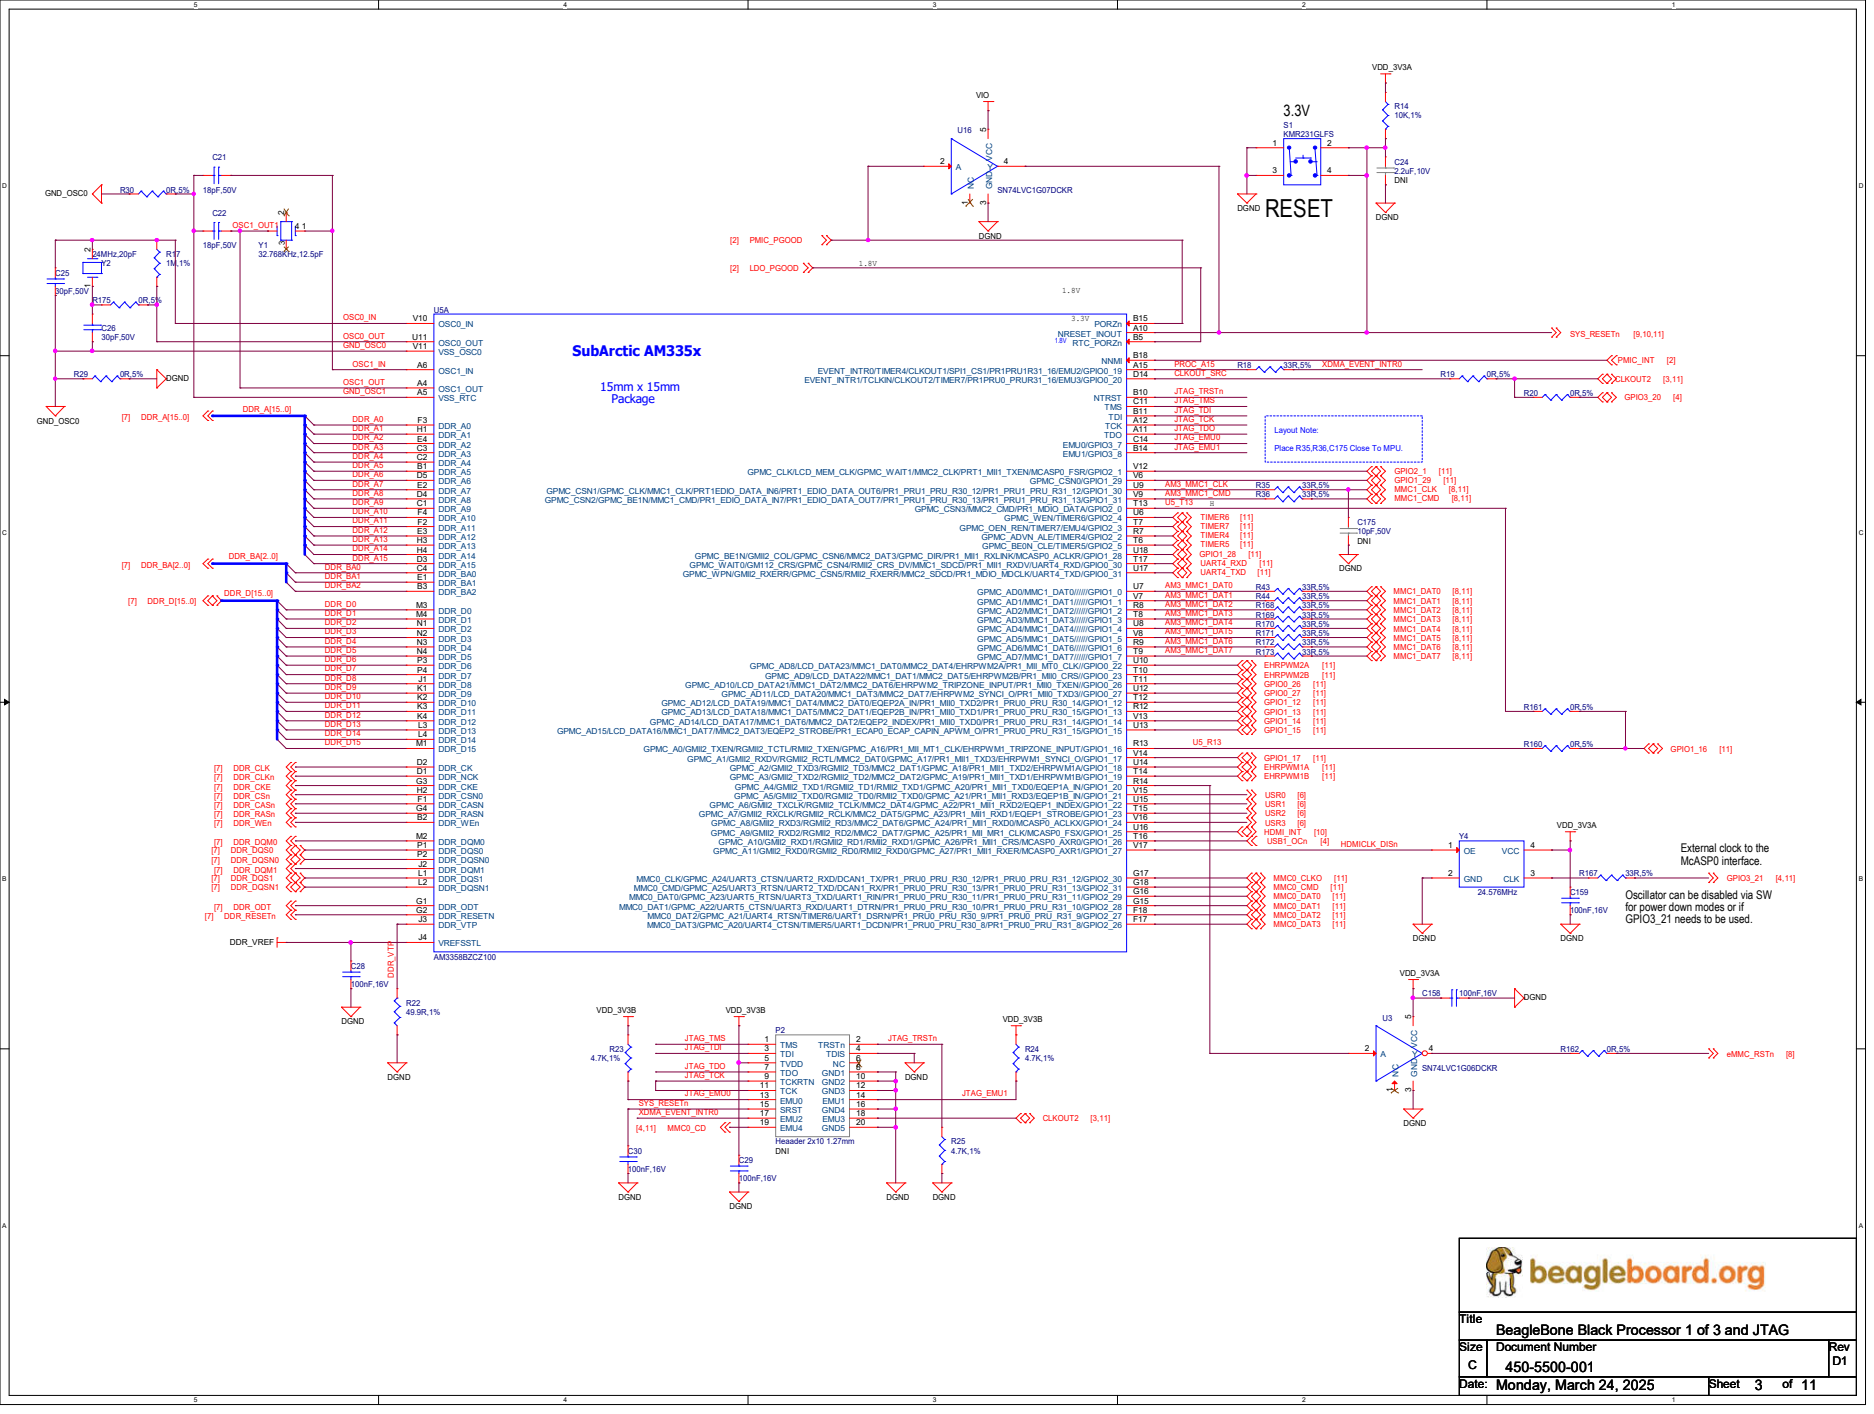
[picture p83: page 3]

Place R35,R36,C175 Close To MPU.

External clock to the
McASP0 interface.

Oscillator can be disabled via SW
for power down modes or if
GPIO3_21 needs to be used.

Title
BeagleBone Black Processor 1 of 3 and JTAG

# SubArctic AM335X

## 15mm x 15mm

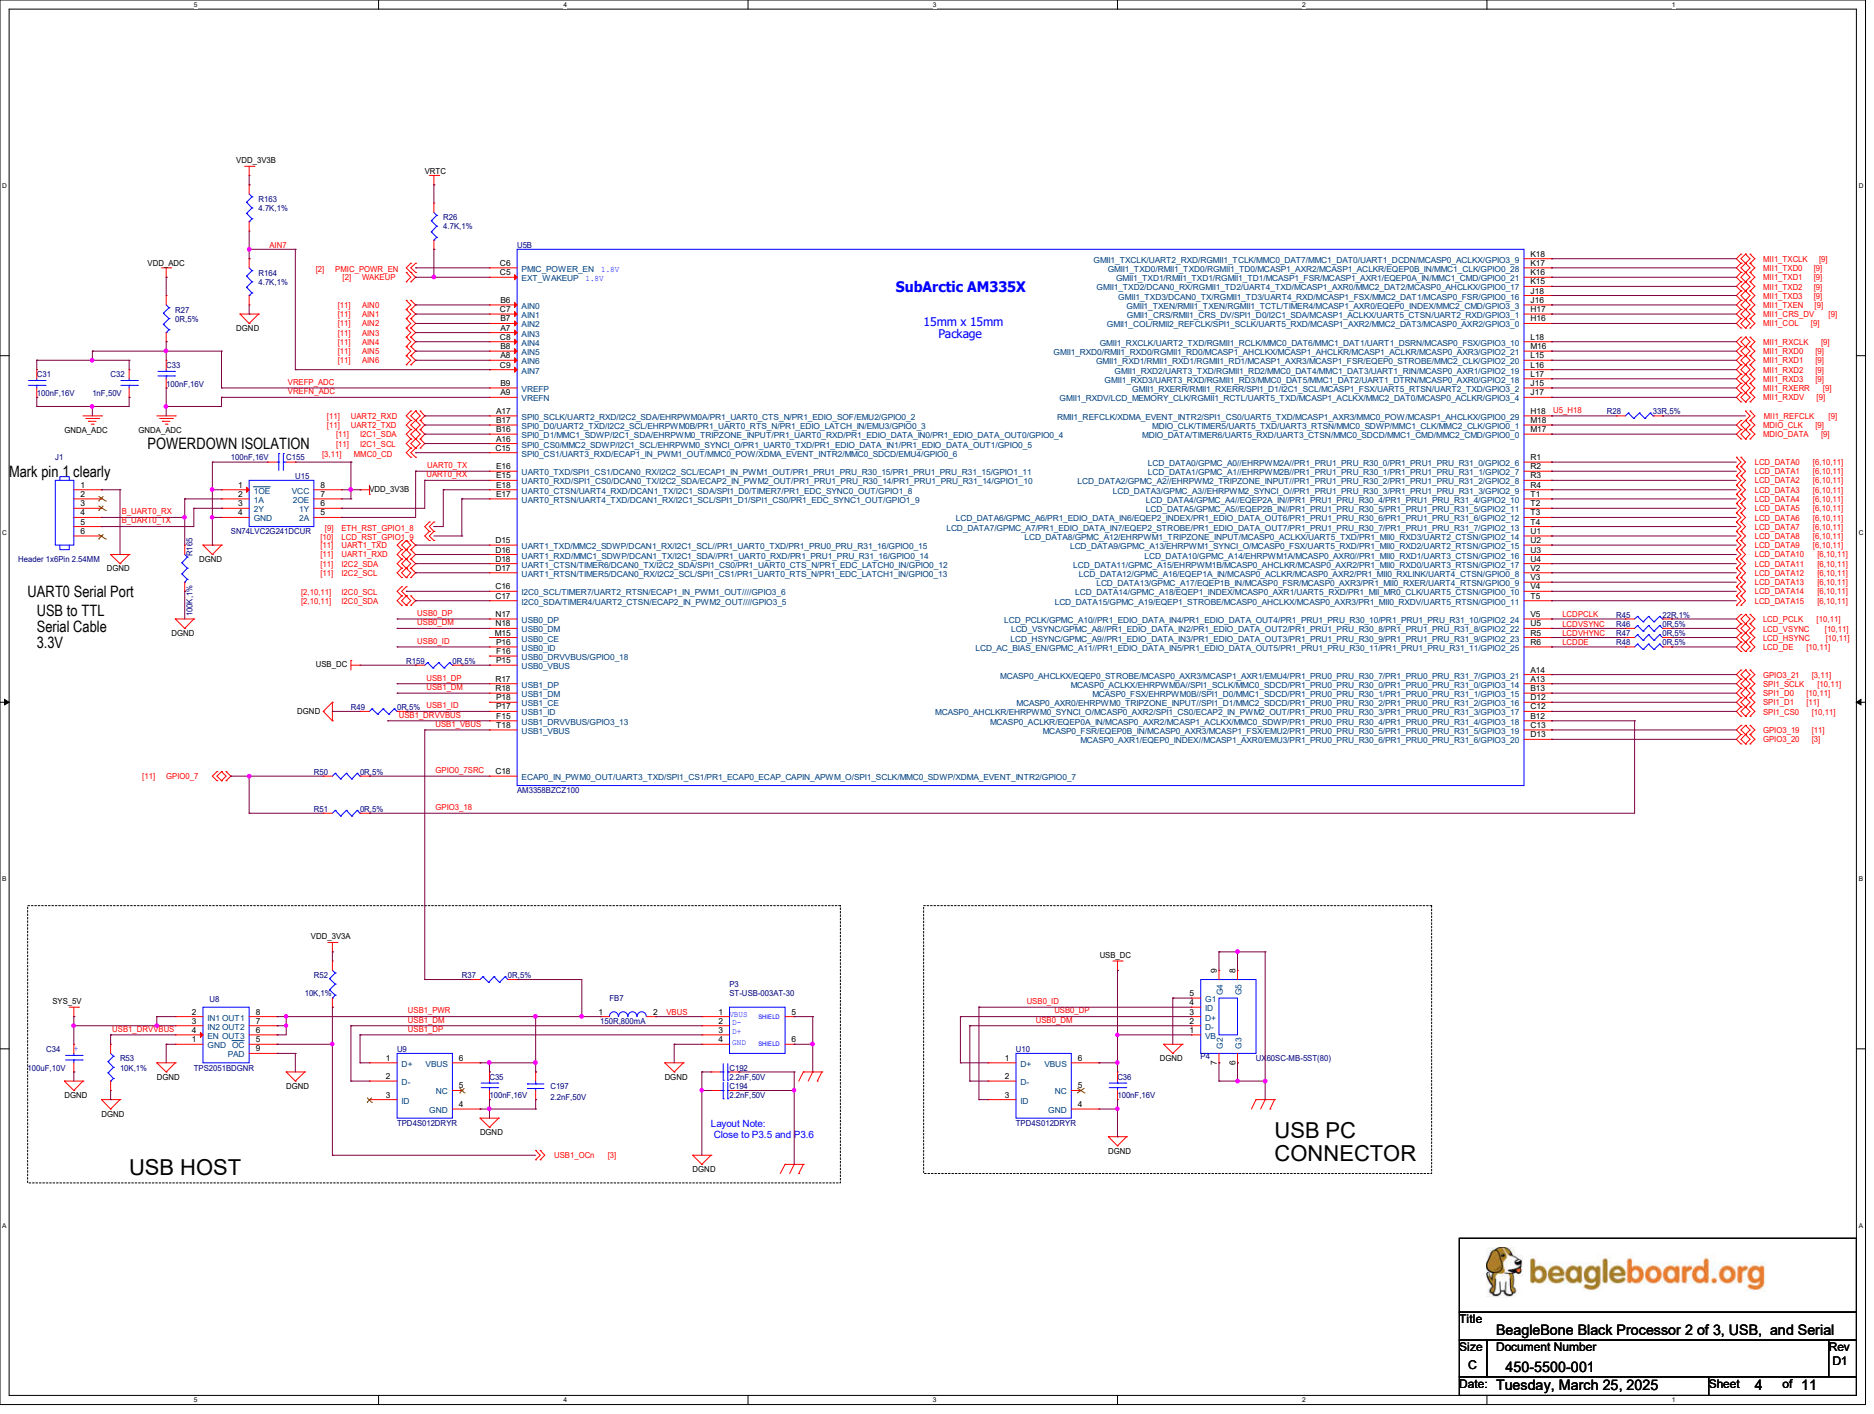
[picture p84: page 4]

Title
BeagleBone Black Processor 2 of 3, USB, and Serial

# C43100nF,16V

# C44100nF,16V

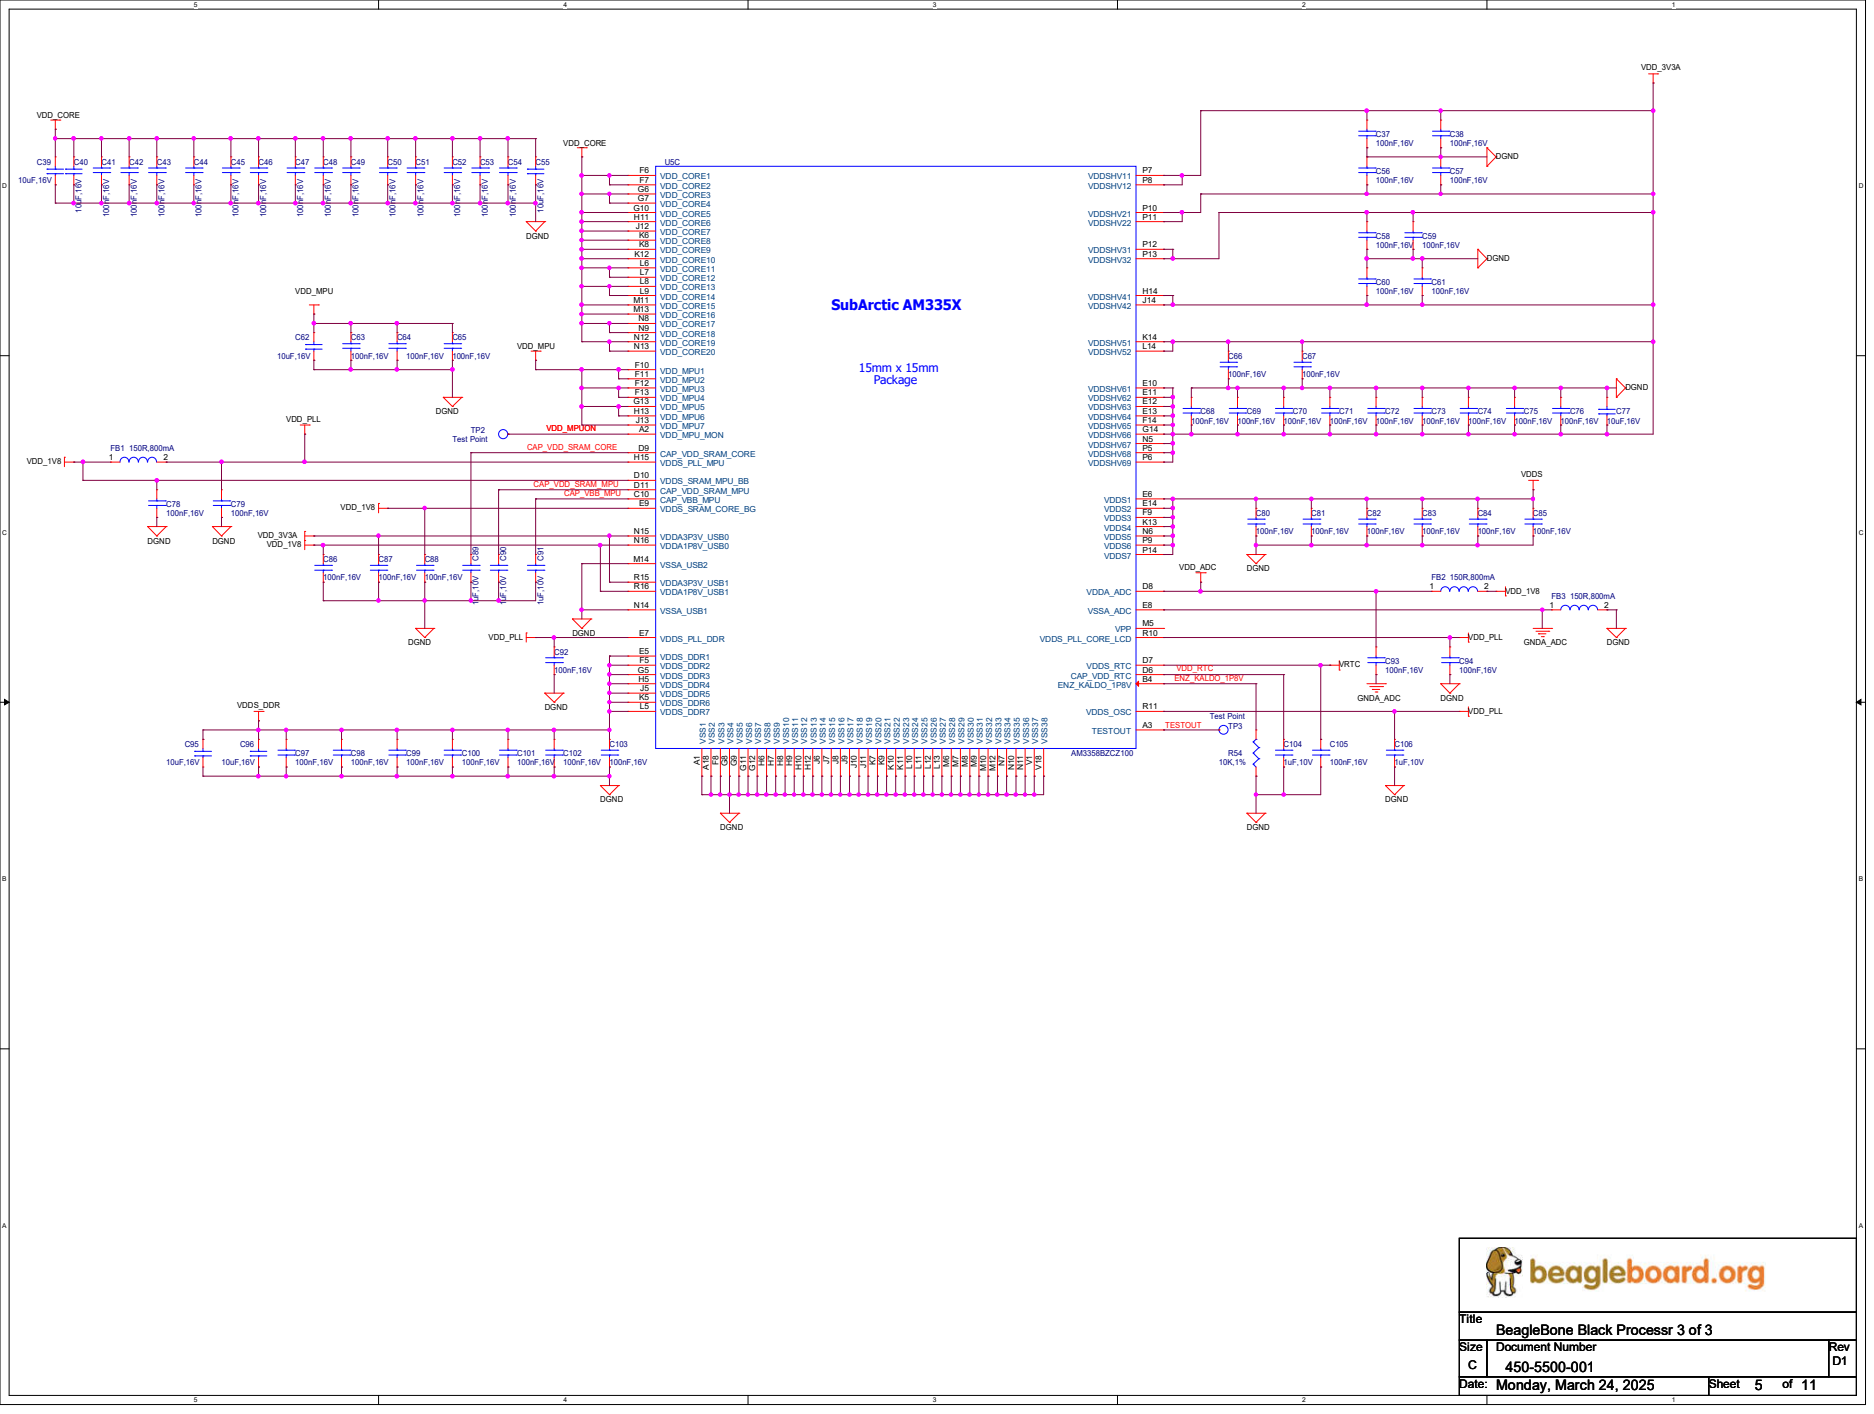
[picture p85: page 5]

Title
BeagleBone Black Processr 3 of 3

## SYS_BOOT8 SYS_BOOT9

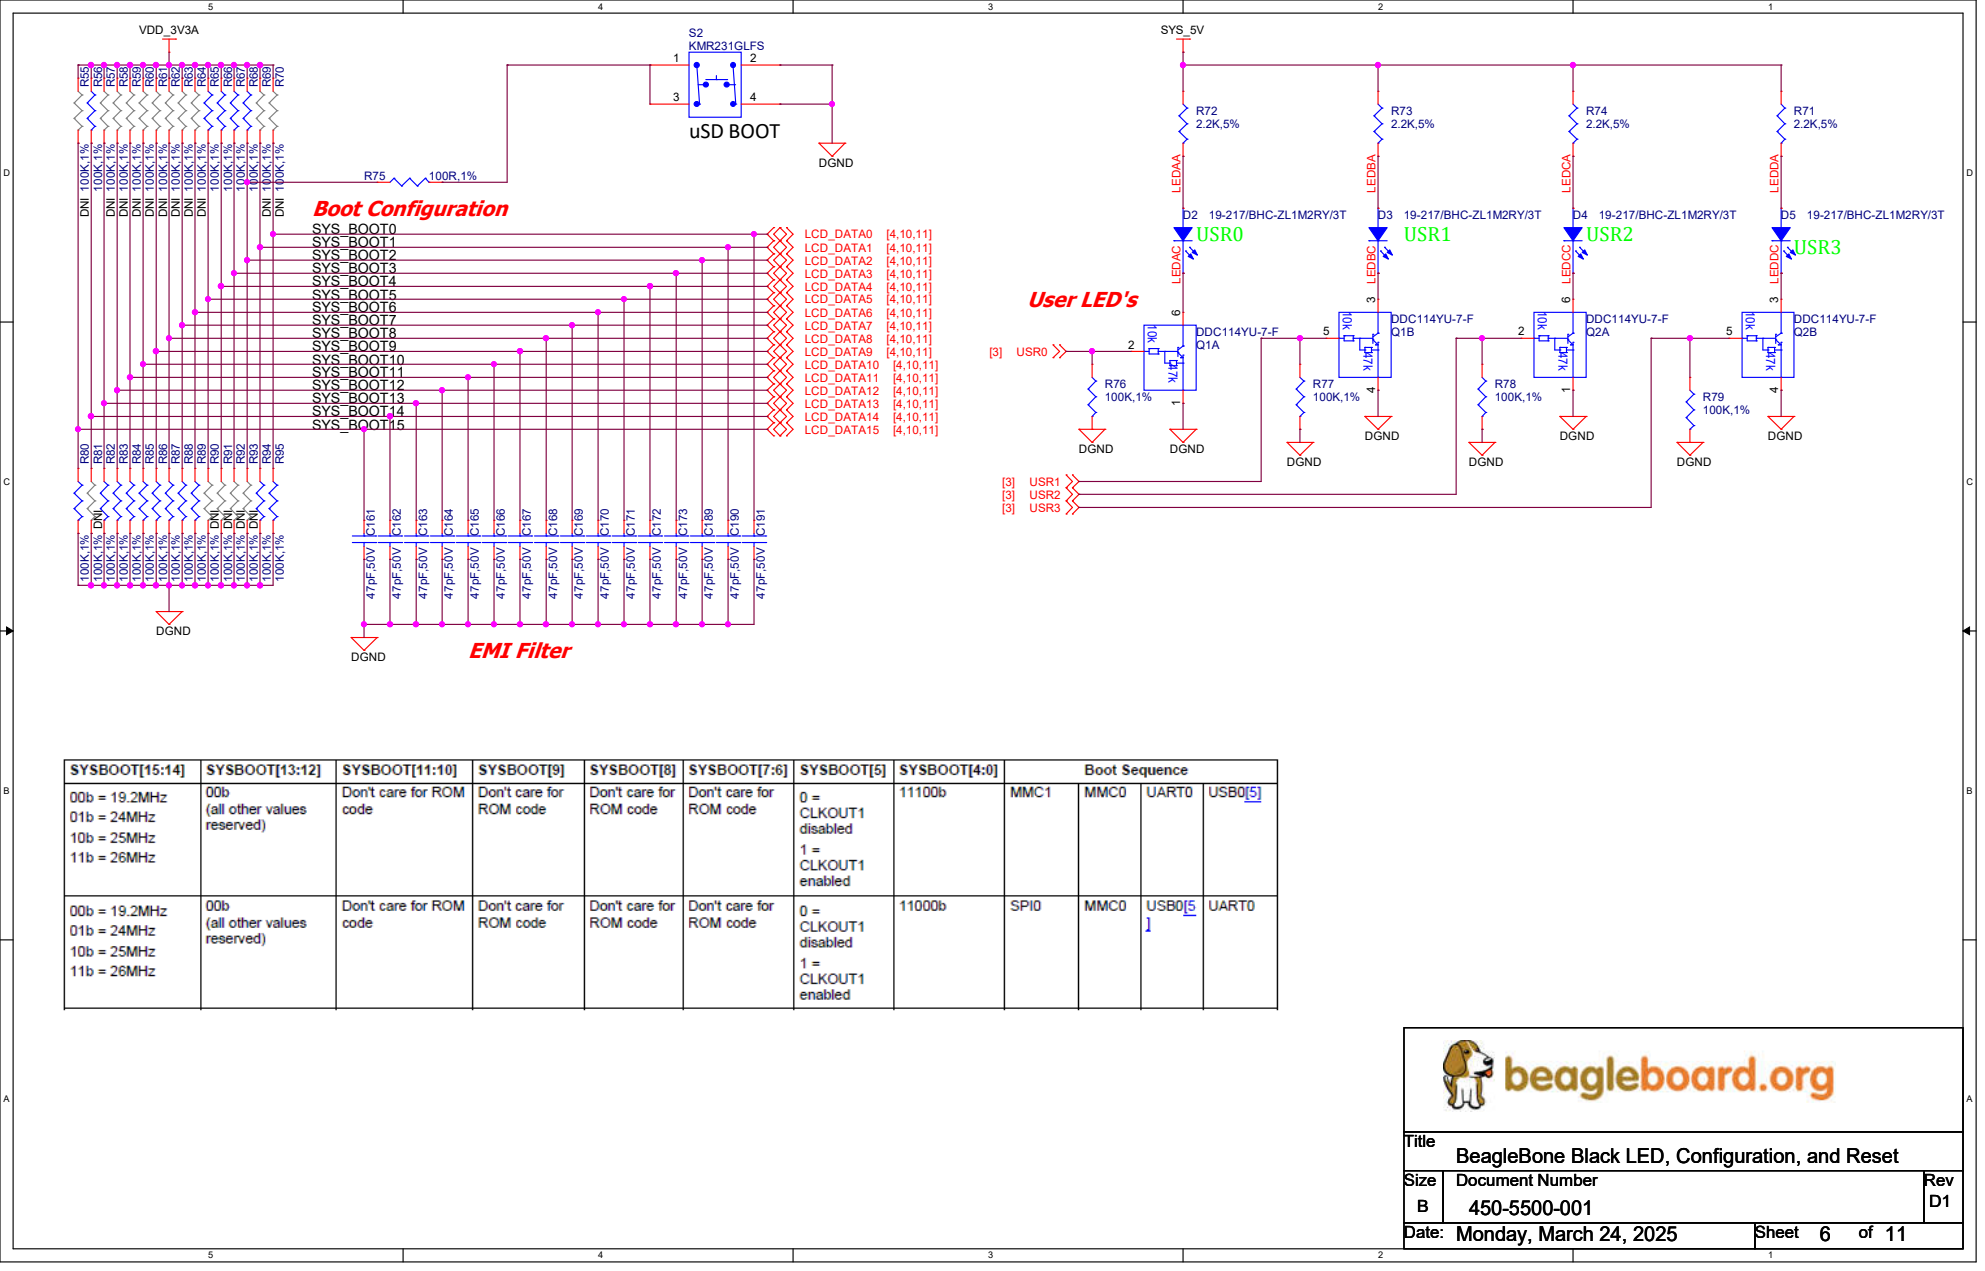
[picture p86: page 6]

Title
BeagleBone Black LED, Configuration, and Reset

# DDR3L SDRAM

### DGND

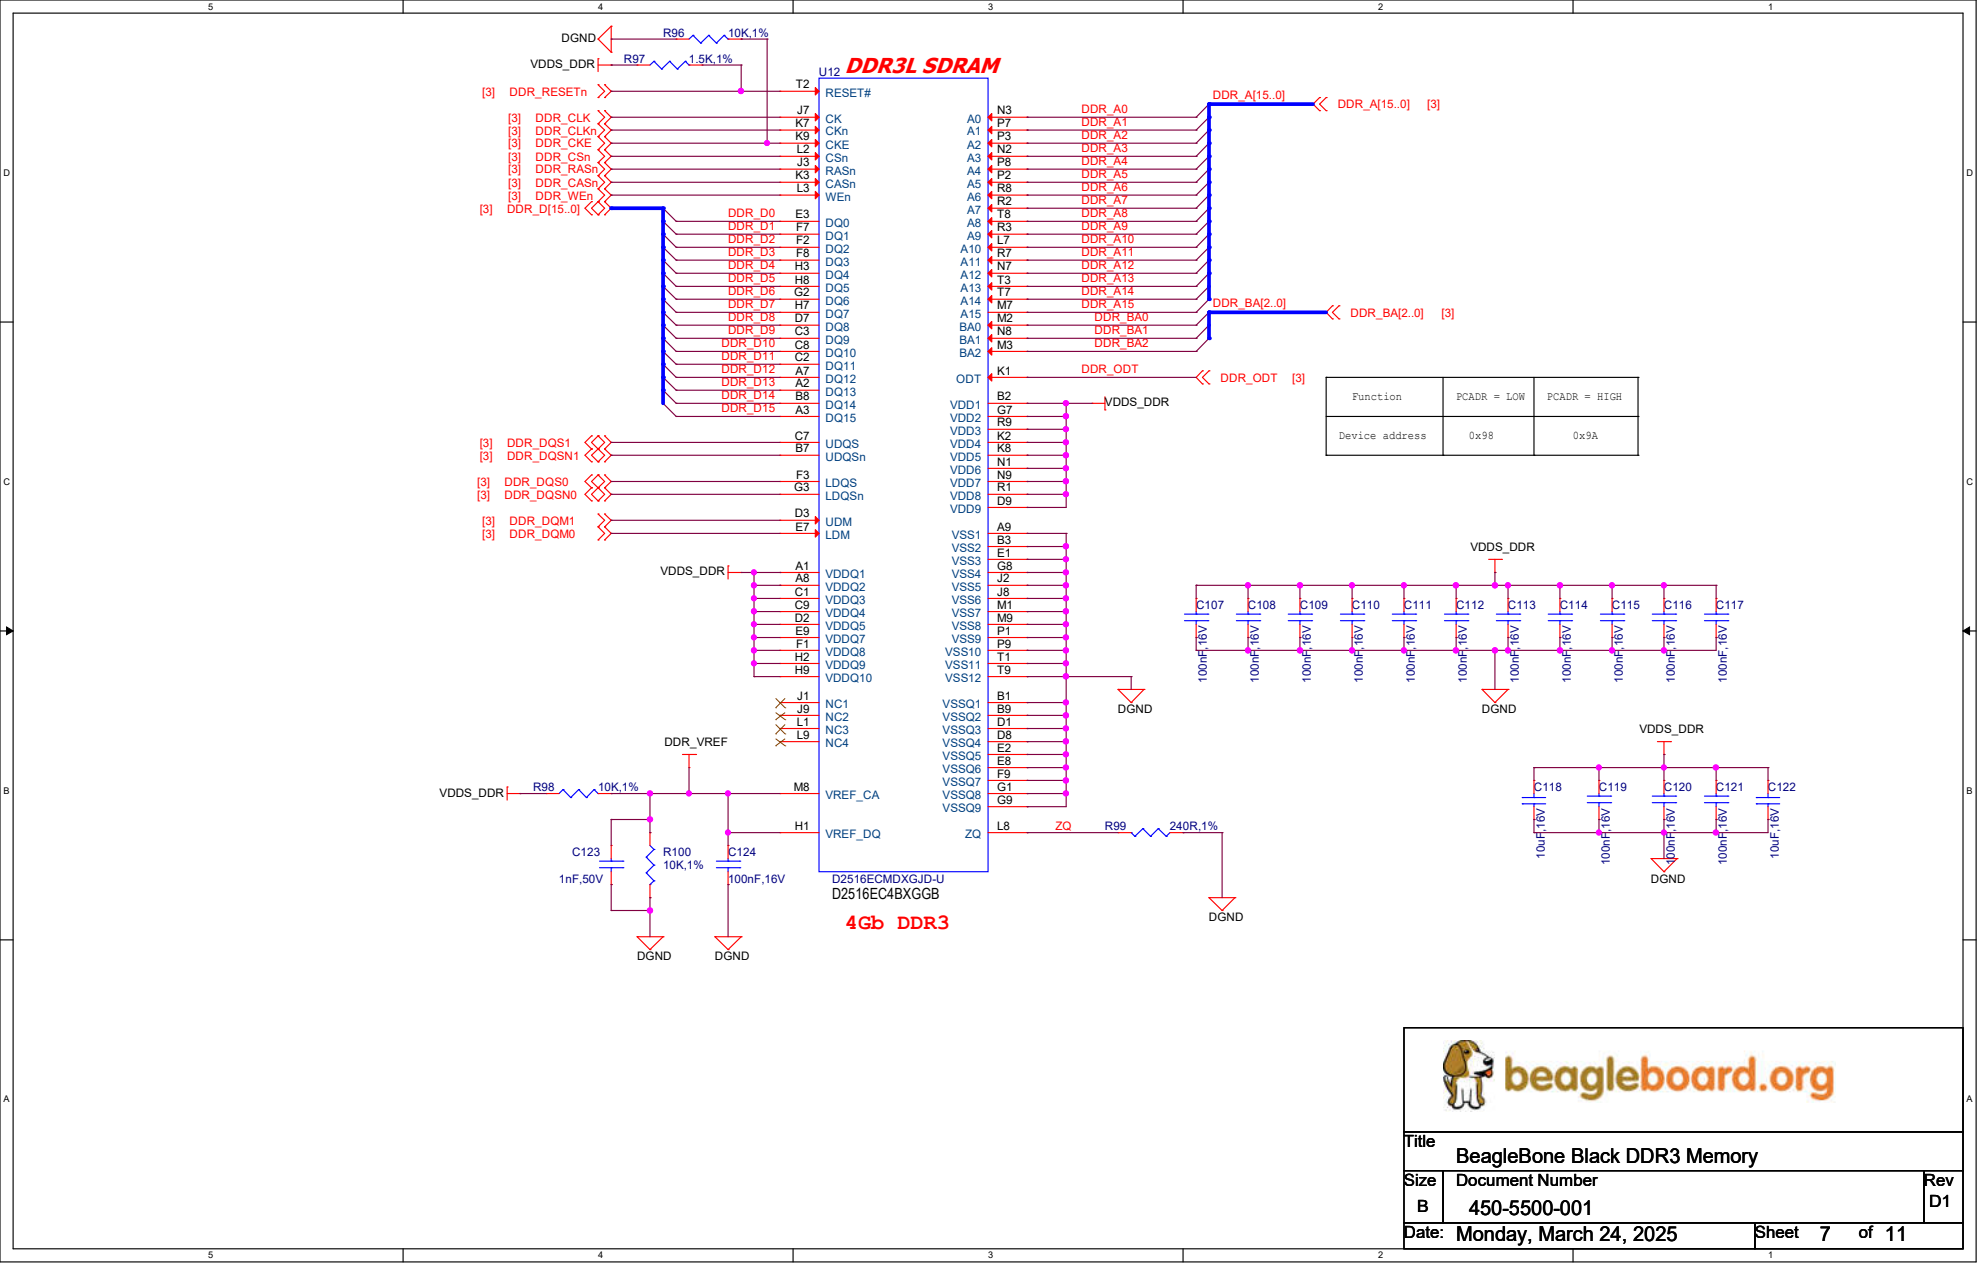
[picture p87: page 7]

Function | PCADR = LOW | PCADR = HIGH

Device address | 0x98 | 0x9A

### DGND

### DGND

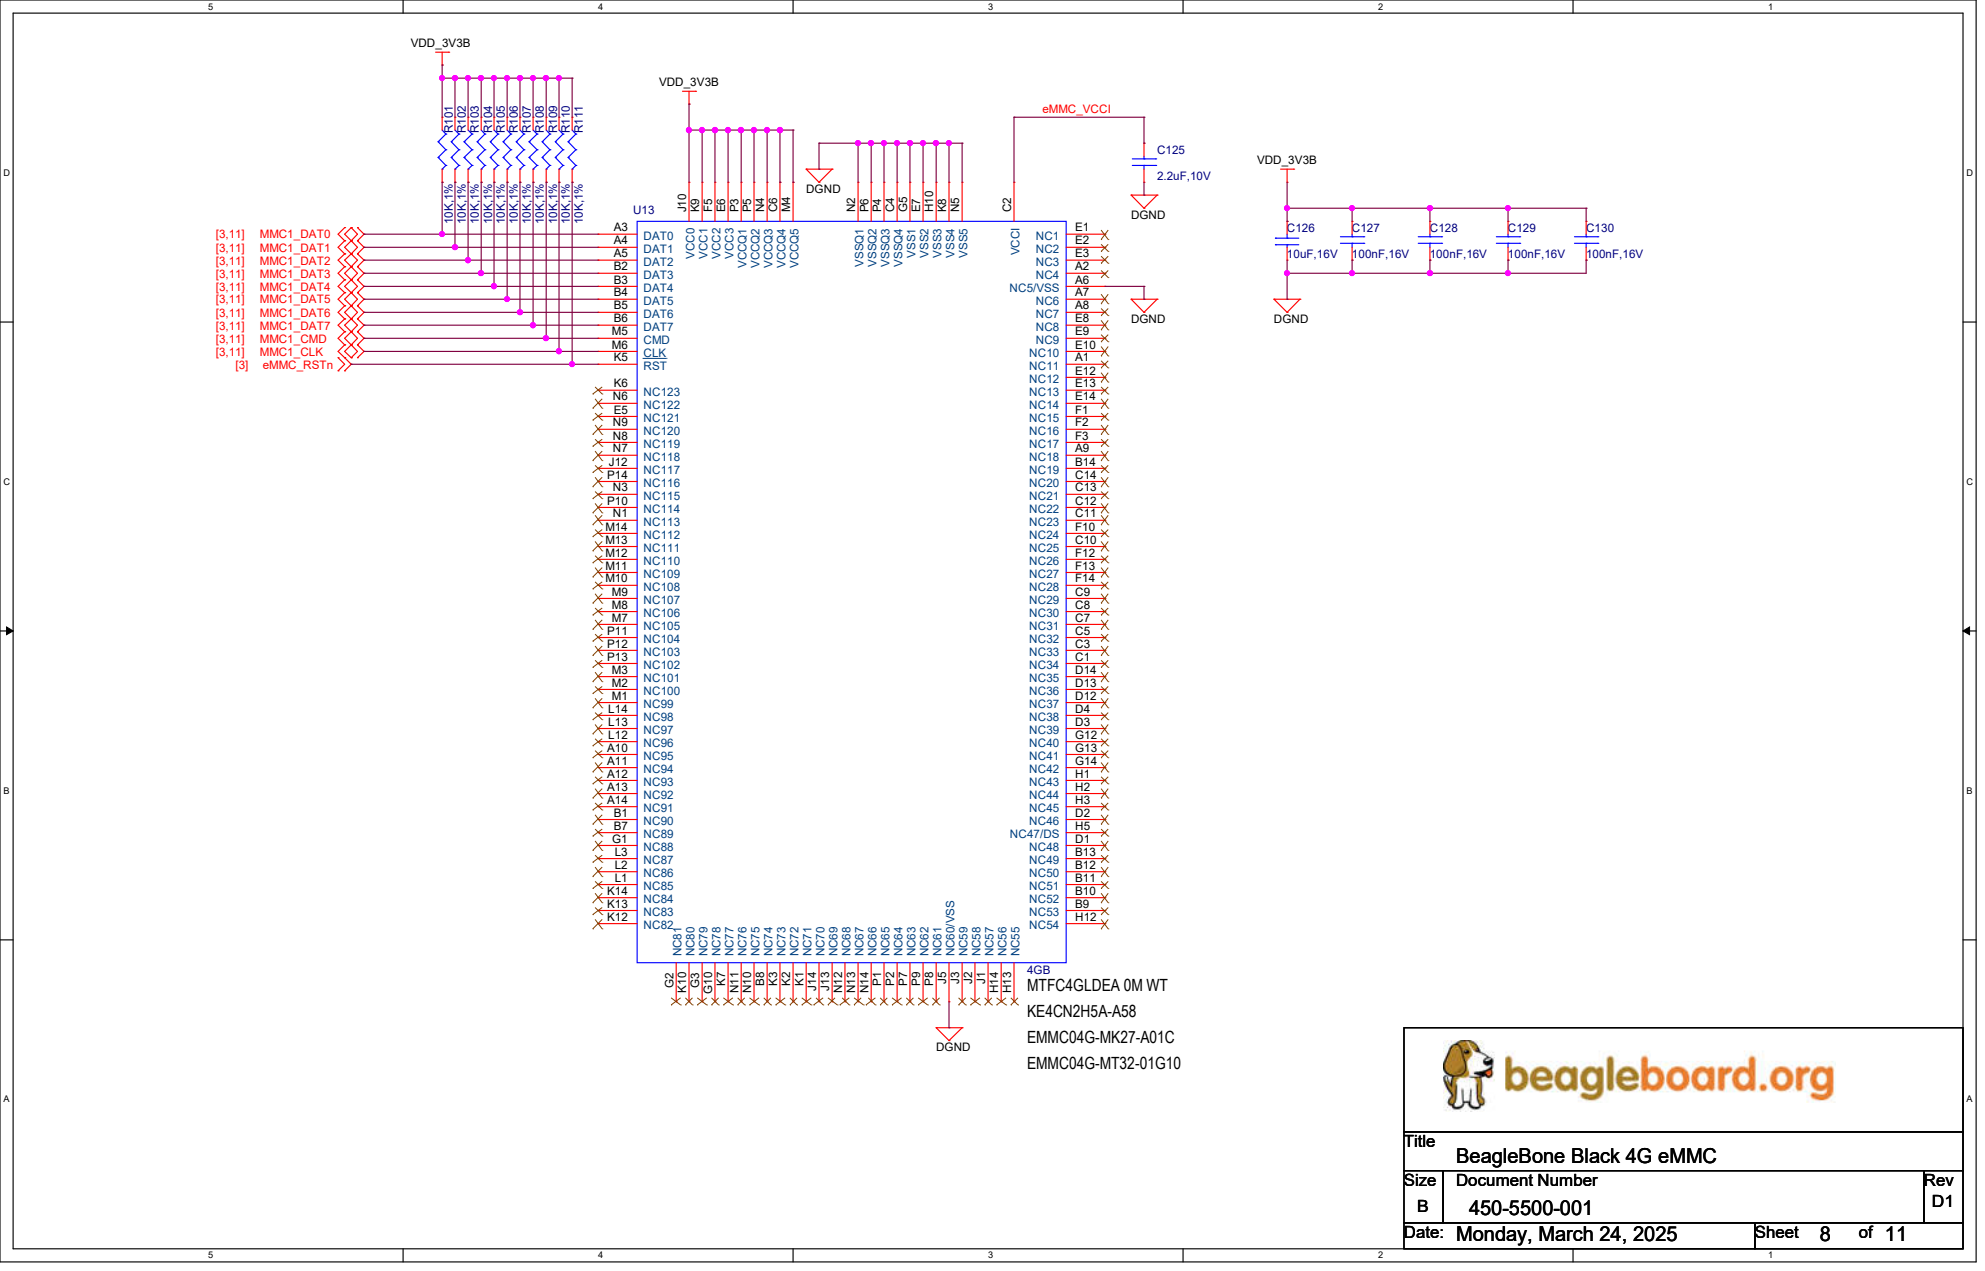
[picture p88: page 8]

### VDD_3V3B

### VDD_PHYA

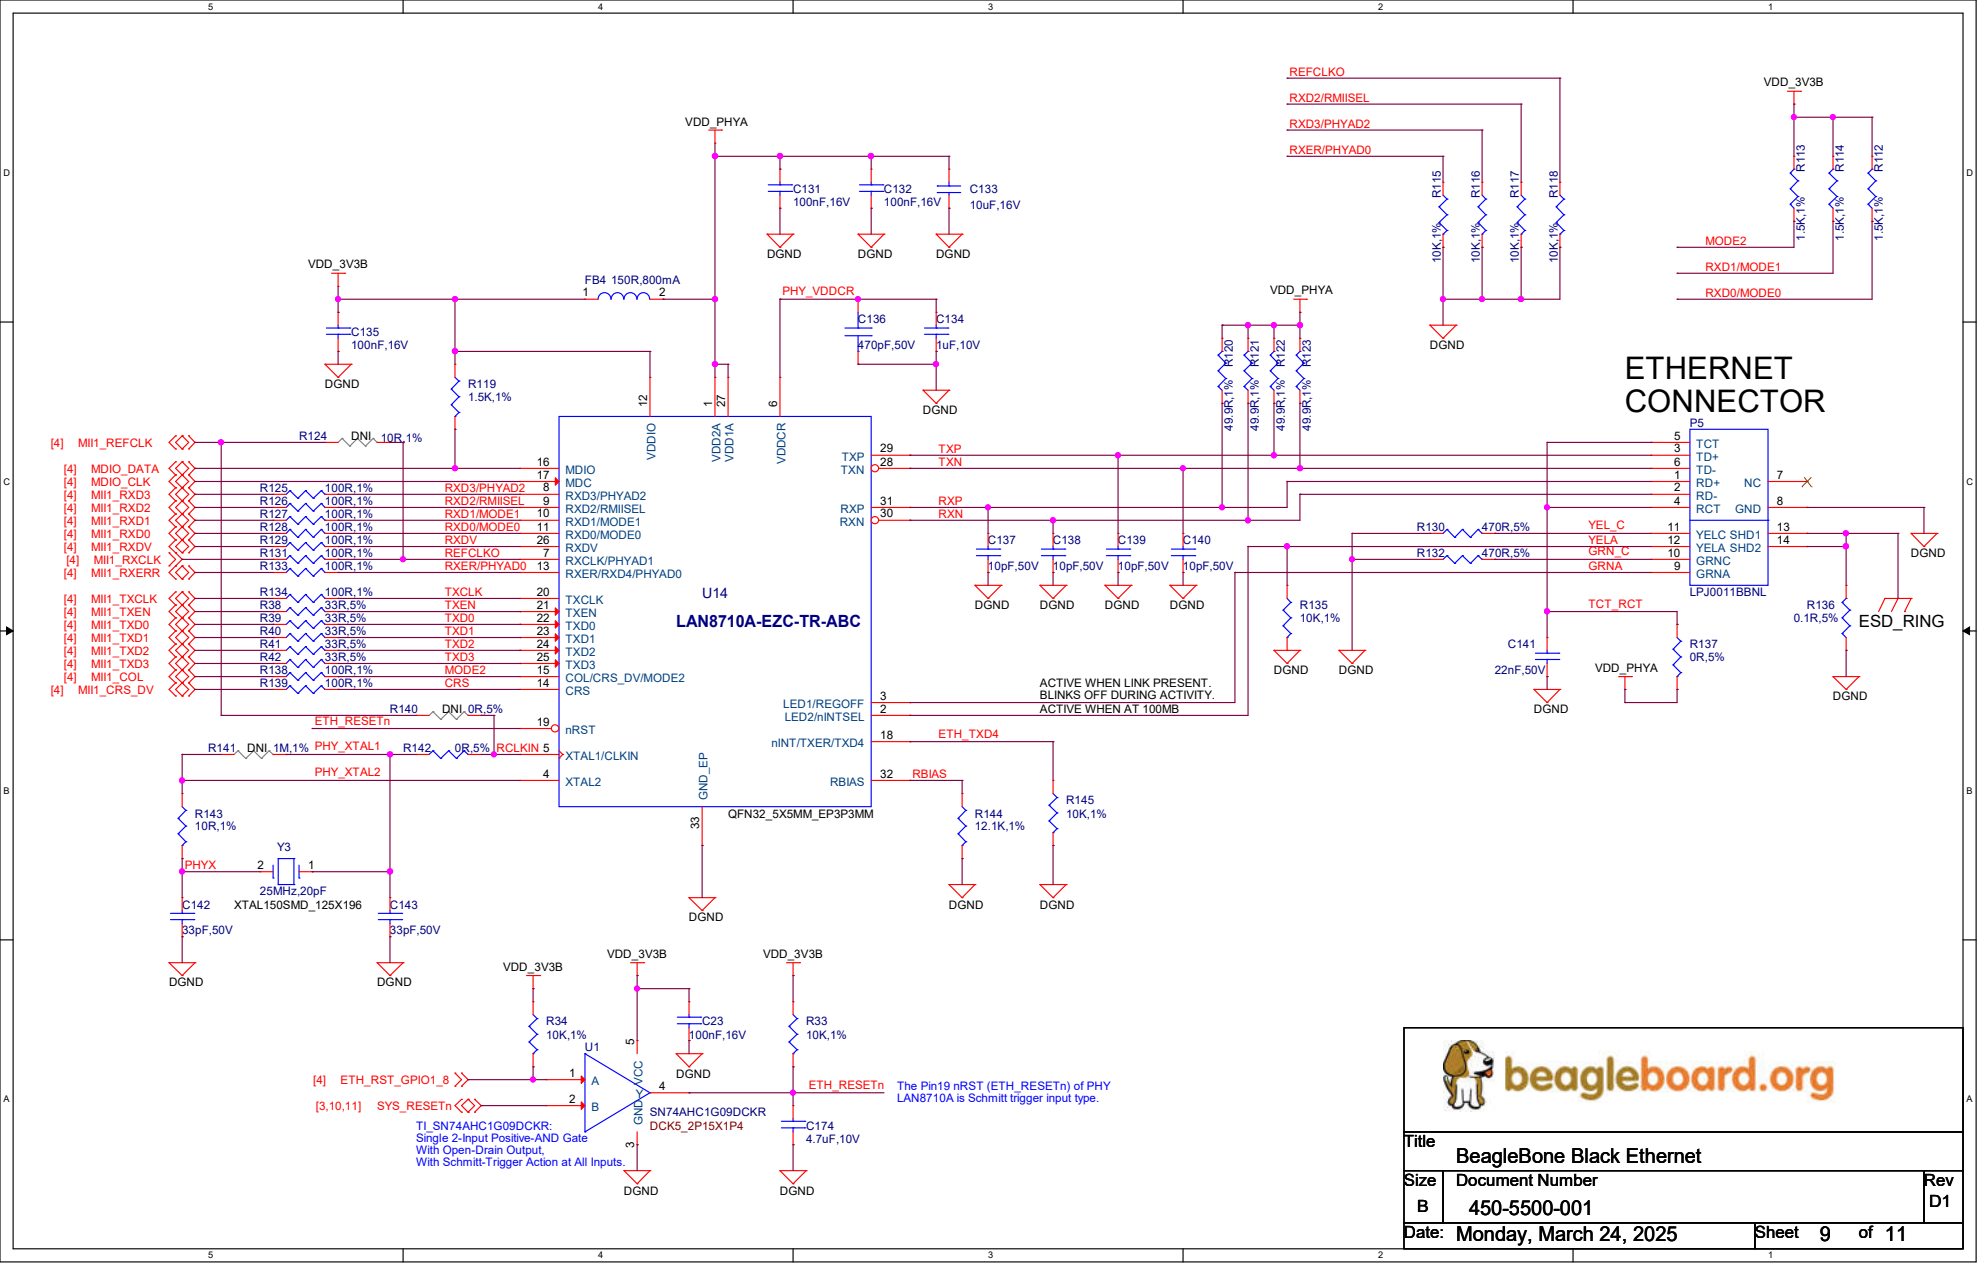
[picture p89: page 9]

ACTIVE WHEN LINK PRESENT.
BLINKS OFF DURING ACTIVITY.
ACTIVE WHEN AT 100MB

The Pin19 nRST (ETH_RESETn) of PHY
LAN8710A is Schmitt trigger input type.

TI_SN74AHC1G09DCKR:
Single 2-Input Positive-AND Gate
With Open-Drain Output,
With Schmitt-Trigger Action at All Inputs.

### SYS_5V

### VDD_3V3B

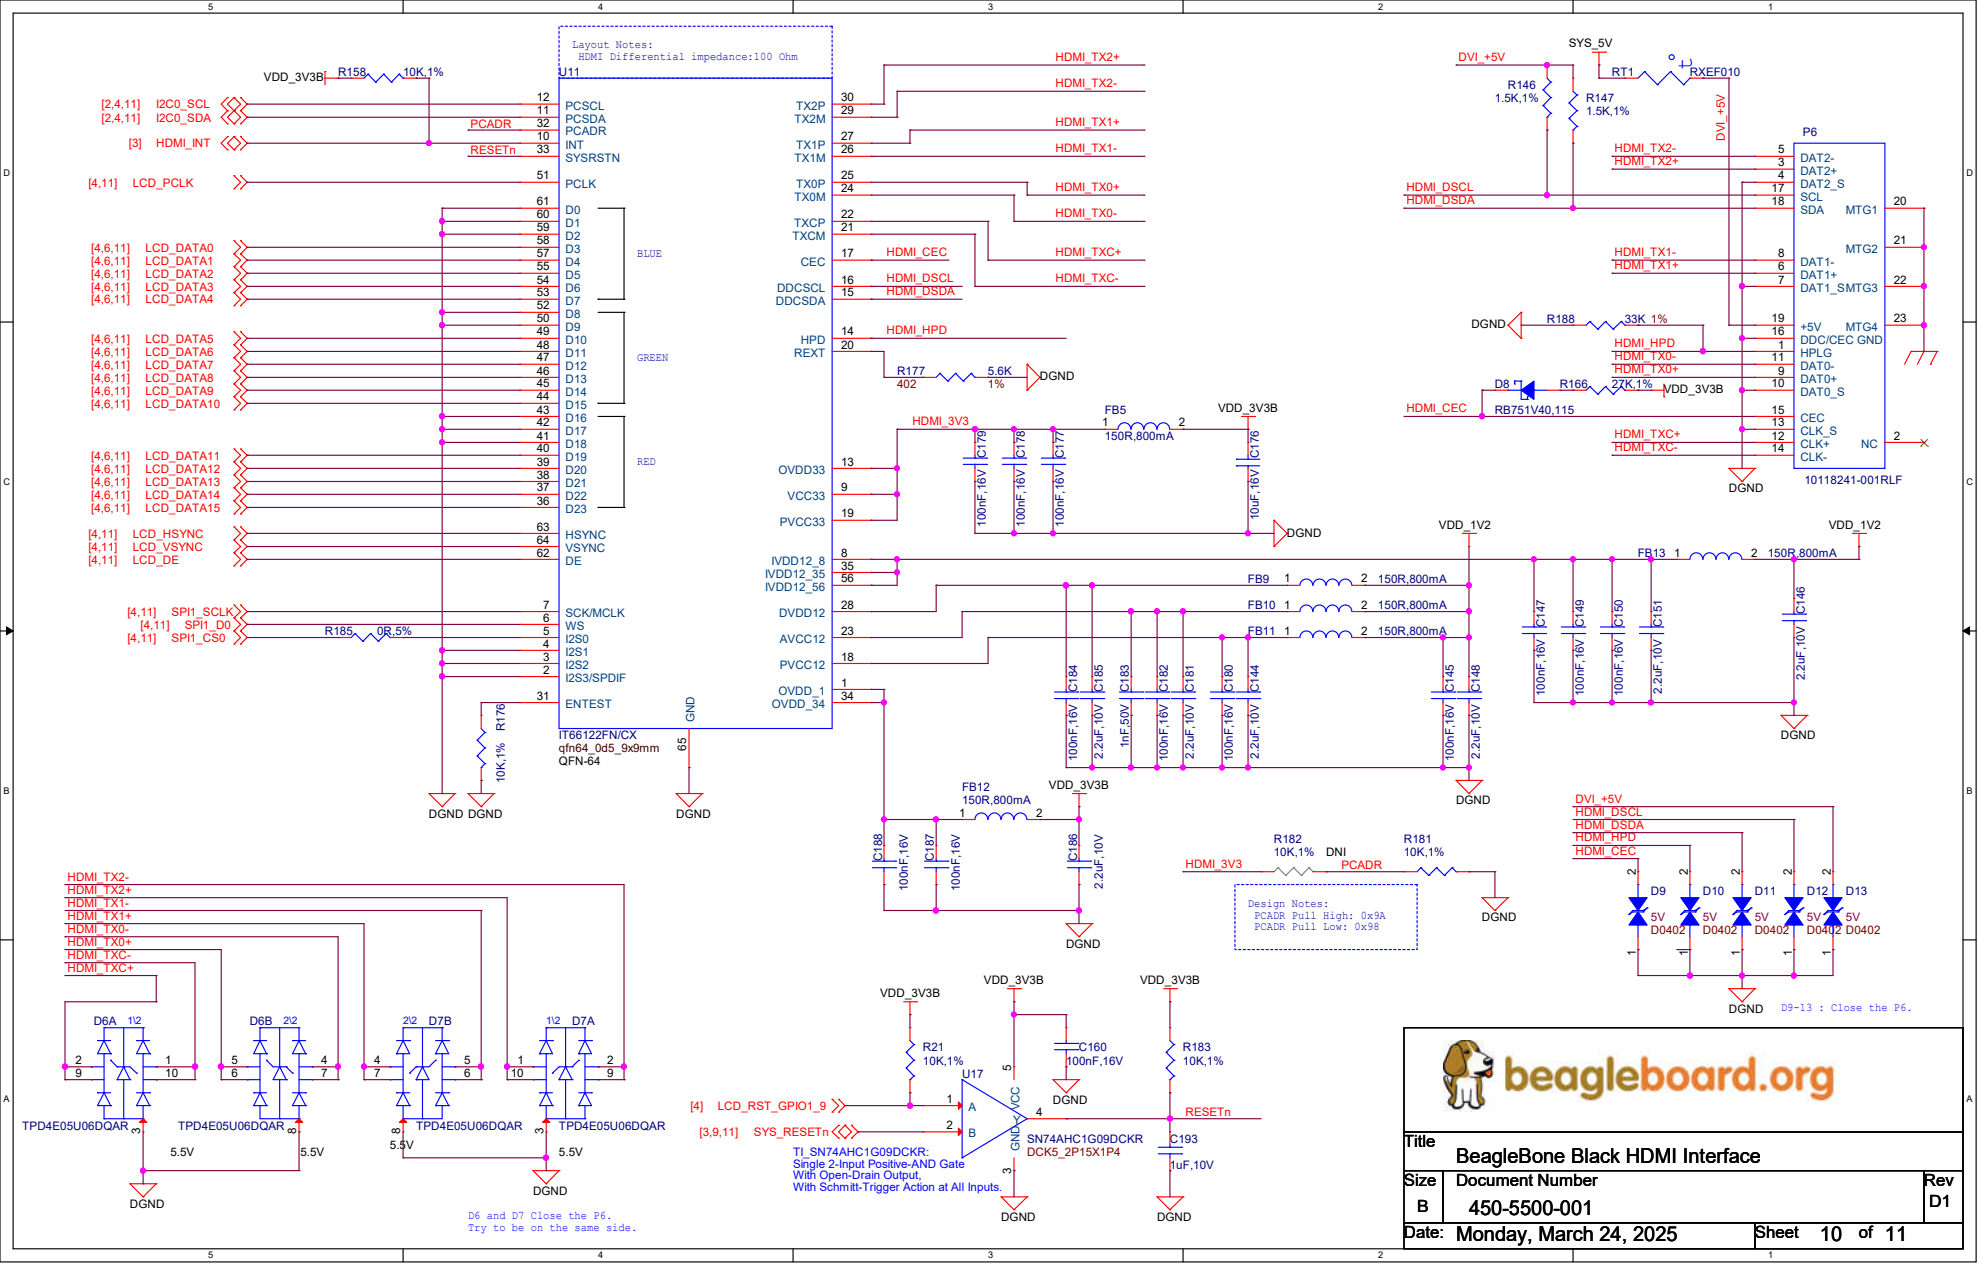
[picture p90: page 10]

Layout Notes:
HDMI Differential impedance:100 Ohm

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

Title
BeagleBone Black HDMI Interface

D6 and D7 Close the P6.
Try to be on the same side.

### DGND

### VDD_5V

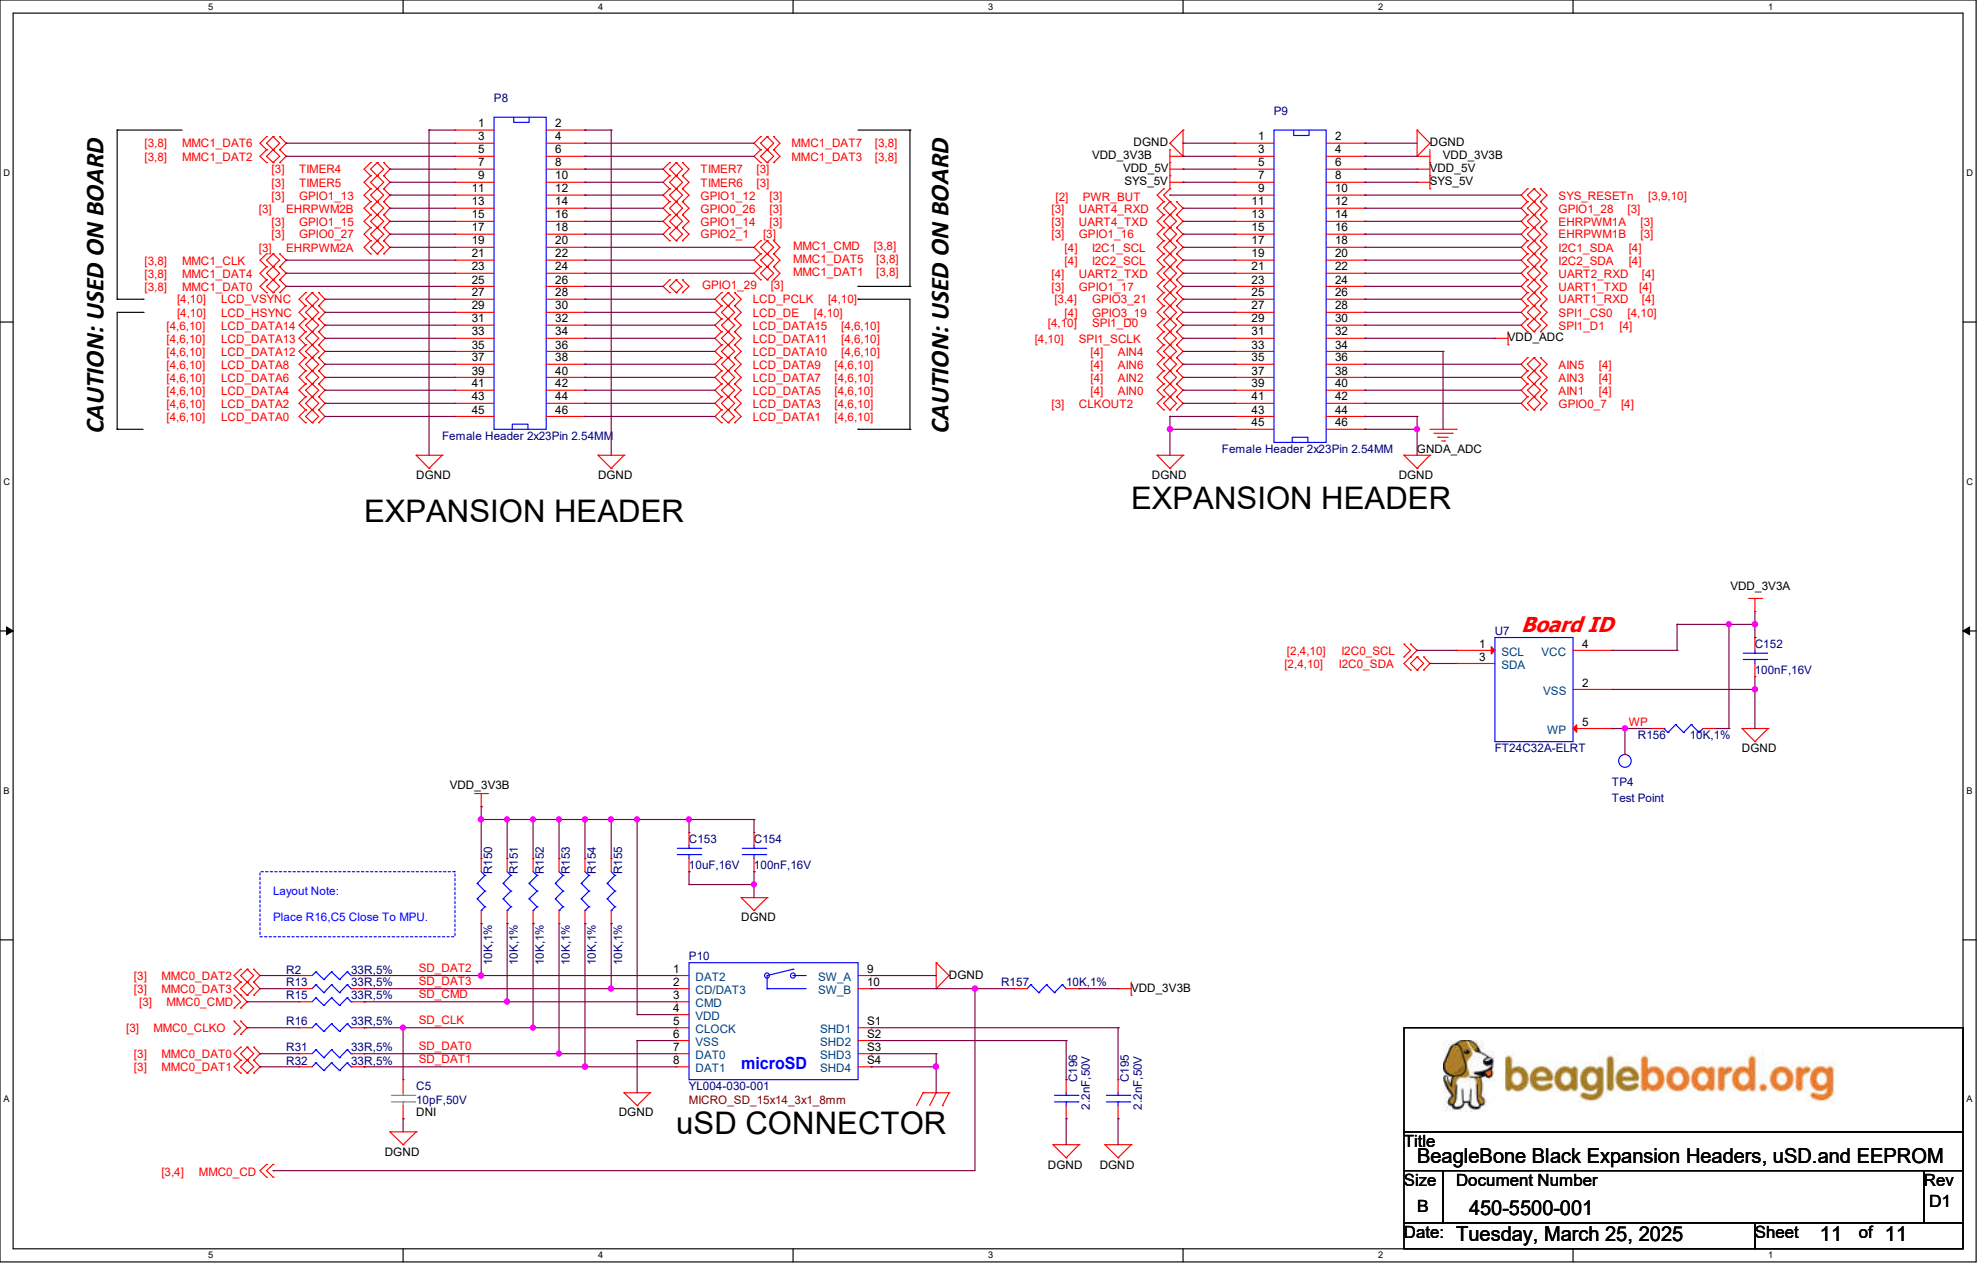
[picture p91: page 11]

CAUTION: USED ON BOARD

Place R16,C5 Close To MPU.

Title
BeagleBone Black Expansion Headers, uSD.and EEPROM
