beagleboard/beaglebone-black/BBB_SCH.pdf

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
# eMMC FLASH

9

3

2

# HDMI FRAMER

# 10/100 ETHERNET

10

# DDR3 MEMORY

# PROCESSOR 2 OF 3, UAB PORTS

7

# LED, CONFIGURATION AND BUTTON

PAGE NO. | SCHEMATIC PAGE

# PROCESSOR 3 OF 3

# PROCESSOR 1 OF 3, JTAG HEADER

4

# POWER MANAGEMENT

5

# COVER PAGE

6

# This schematic is *NOT SUPPORTED* and DOES NOT constitute a reference design. Only "community" support is allowed via

resources at BeagleBoard.org/discuss.

# THERE IS NO WARRANTY FOR THIS DESIGN, TO THE EXTENT PERMITTED BY APPLICABLE LAW. EXCEPT WHEN OTHERWISE STATED IN WRITING THE COPYRIGHT HOLDERS AND/OR OTHER PARTIES

PROVIDE THE DESIGN "AS IS" WITHOUT WARRANTY OF ANY KIND, EITHER EXPRESSED OR IMPLIED, INCLUDING, BUT NOT LIMITED TO,

# THE IMPLIED WARRANTIES OF MERCHANTABILITY AND FITNESS FOR A PARTICULAR PURPOSE. THE ENTIRE RISK AS TO THE QUALITY AND PERFORMANCE OF THE DESIGN IS WITH YOU. SHOULD THE DESIGN PROVE DEFECTIVE, YOU ASSUME THE COST OF ALL NECESSARY

SERVICING, REPAIR OR CORRECTION.

# 11 EXP CONN, uSD

REV | Description | DATE | BY
A4A | Initial production Release. | 11/19/2012 | GC
A5 | On the initial production release the processors were to be found incorrect as supplied by TI.
| Parts while marked AM3359 were actually AM3352. This revision uses the correct parts. | 1/2/2013 | GC
1. Deleted R29-R44 from the LCD lines.
2. Added 47pf capacitors C156-C173 to LCD data lines to ground.
3. Changed schematic revision to A5A.

A5A

4. Changed a few footprints after PCB update for above changes.
| 5. Added access point for the battery function of the TPS65217C. | 2/8/2013 | GC

# 7. Added power button to enable sleep, wakeup, power down and power up features on the

| system.

# 6. Added Ferrite beads in series with LED power and 5V power rail of the USB host

connector. Required to pass FCC/CE testing due to noise emissions on that pin.

A5B

# 1. Added 100K pulldown on J1 pin 4 to prevent crosstalk when serial cable is

not connected into PCB layout.
2. Changed the LED resistors to 4.75K to lower the brightness.

5/21/2013

# 8. Added Modification to add 100K ohm resistor to ground to prvent crosstalk when serial

cable is not plugged in.

GC

A5C | 6/12/2013 | GC
1. Changed R46, R47,R48 to 0 ohms.
2. Changed R45 to 22 Ohms.
Change was made due to production failures on some boards due to differences in impedances.

A6

# 1. Moved the enable for the VDD_3V3B regulator to VDD_3V3A rail. Change was made to

reduce the delay between the ramp up of the 3.3V rails.
2. Added a AND gate to the SYS_RESETn circuitry. There is a small chance that on power up | 7/25/2013 | GC

# the nRESETOUT signal on the processor may go high, causing the SYS_RESETn signal to go

HI before it should. This change reenforces the reset with the PORZn reset signal.
3. Added optional zero ohm resistor to tie GND_OSC0 to system ground.
A6A | | 12/13/2013 | GC
1. Added optional zero ohm resistor to tie GND_OSC1 to system ground.
2. Changed C106 to a 1uF capacitor.
3. Changed C24 to a 2.2uF capacitor.
B | 1. Changed the processor to the AM3358BZCZ100. | 1/20/2014 | GC
4. Made R8 installed and R9 not installed.
C | 1. Increased the eMMC from 2GB to 4GB; The PCB revision for this board is Rev B6. | 3/21/2014 | GC

C3

1. Page 3: Added series resistor (R35,R36,R43,R44,R168-R173)=33R to the MMC1 lines,
C175=DNI(10pF) to the MMC1_CLK to DGND; Changed C24 from 2.2uF to DNI.

4/1/2021

3. Page 8: Connected the Pin A6 J5 of U13(eMMC IC) to DGND.
4. Page 9: Added AM3358 GPIO1_8 and a Positive-AND gate(U1) to reset ethernet LAN8710A; Added series resistor (R38-R42)=33R to the LAN8710A TX lines;
Changed (C137-C140) from DNI to 10pF.

# 5. Page 11: Changed the MicroSD Connector from ALPS_SCHA5B0200 (EOL) to YU LIANG_YL004-030-001; Added series resistor (R2,R13,R15,R16,R31,R32)=33R

and C5=DNI(10pF) to the MMC0 lines.

# JQ.Xin

6. The PCB Revision for this board is RevC, BOM is RevC3.
2. Page 4: Changed USB1_VBUS series resistor from FB8=0.1R 0805 to R37=0R 0402.

# Title

Size Document Number | Rev
Date: | Sheet | of
450-5500-001 | C3

# BeagleBone Black Cover Page

B
Thursday, April 01, 2021 | 1 | 11

# Title

Size Document Number | Rev
Date: | Sheet | of
450-5500-001 | C3

# BeagleBone Black Cover Page

B
Thursday, April 01, 2021 | 1 | 11

# Title

Size Document Number | Rev
Date: | Sheet | of
450-5500-001 | C3

# BeagleBone Black Cover Page

B
Thursday, April 01, 2021 | 1 | 11

# Battery access pins. Pins are randomly placed to fit

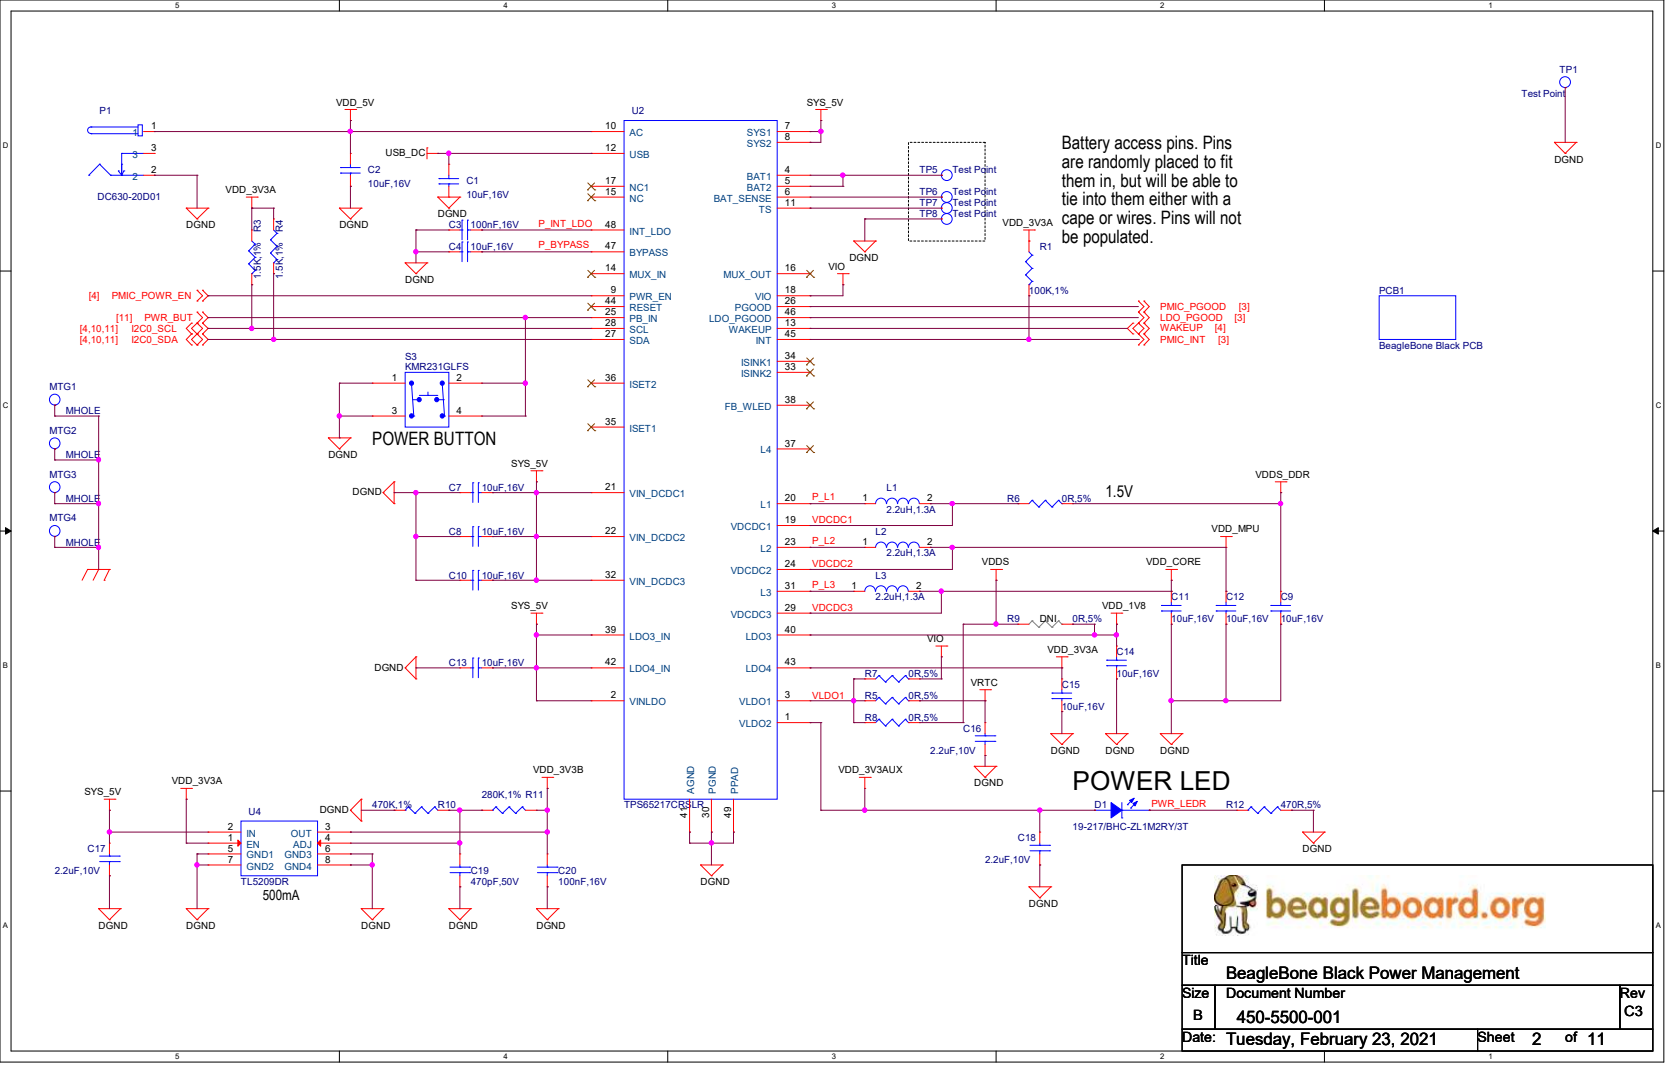
[picture p92: page 2]

them in, but will be able to
tie into them either with a
cape or wires. Pins will not
be populated.

# RESET

## CEC Clock for HDMI Framer

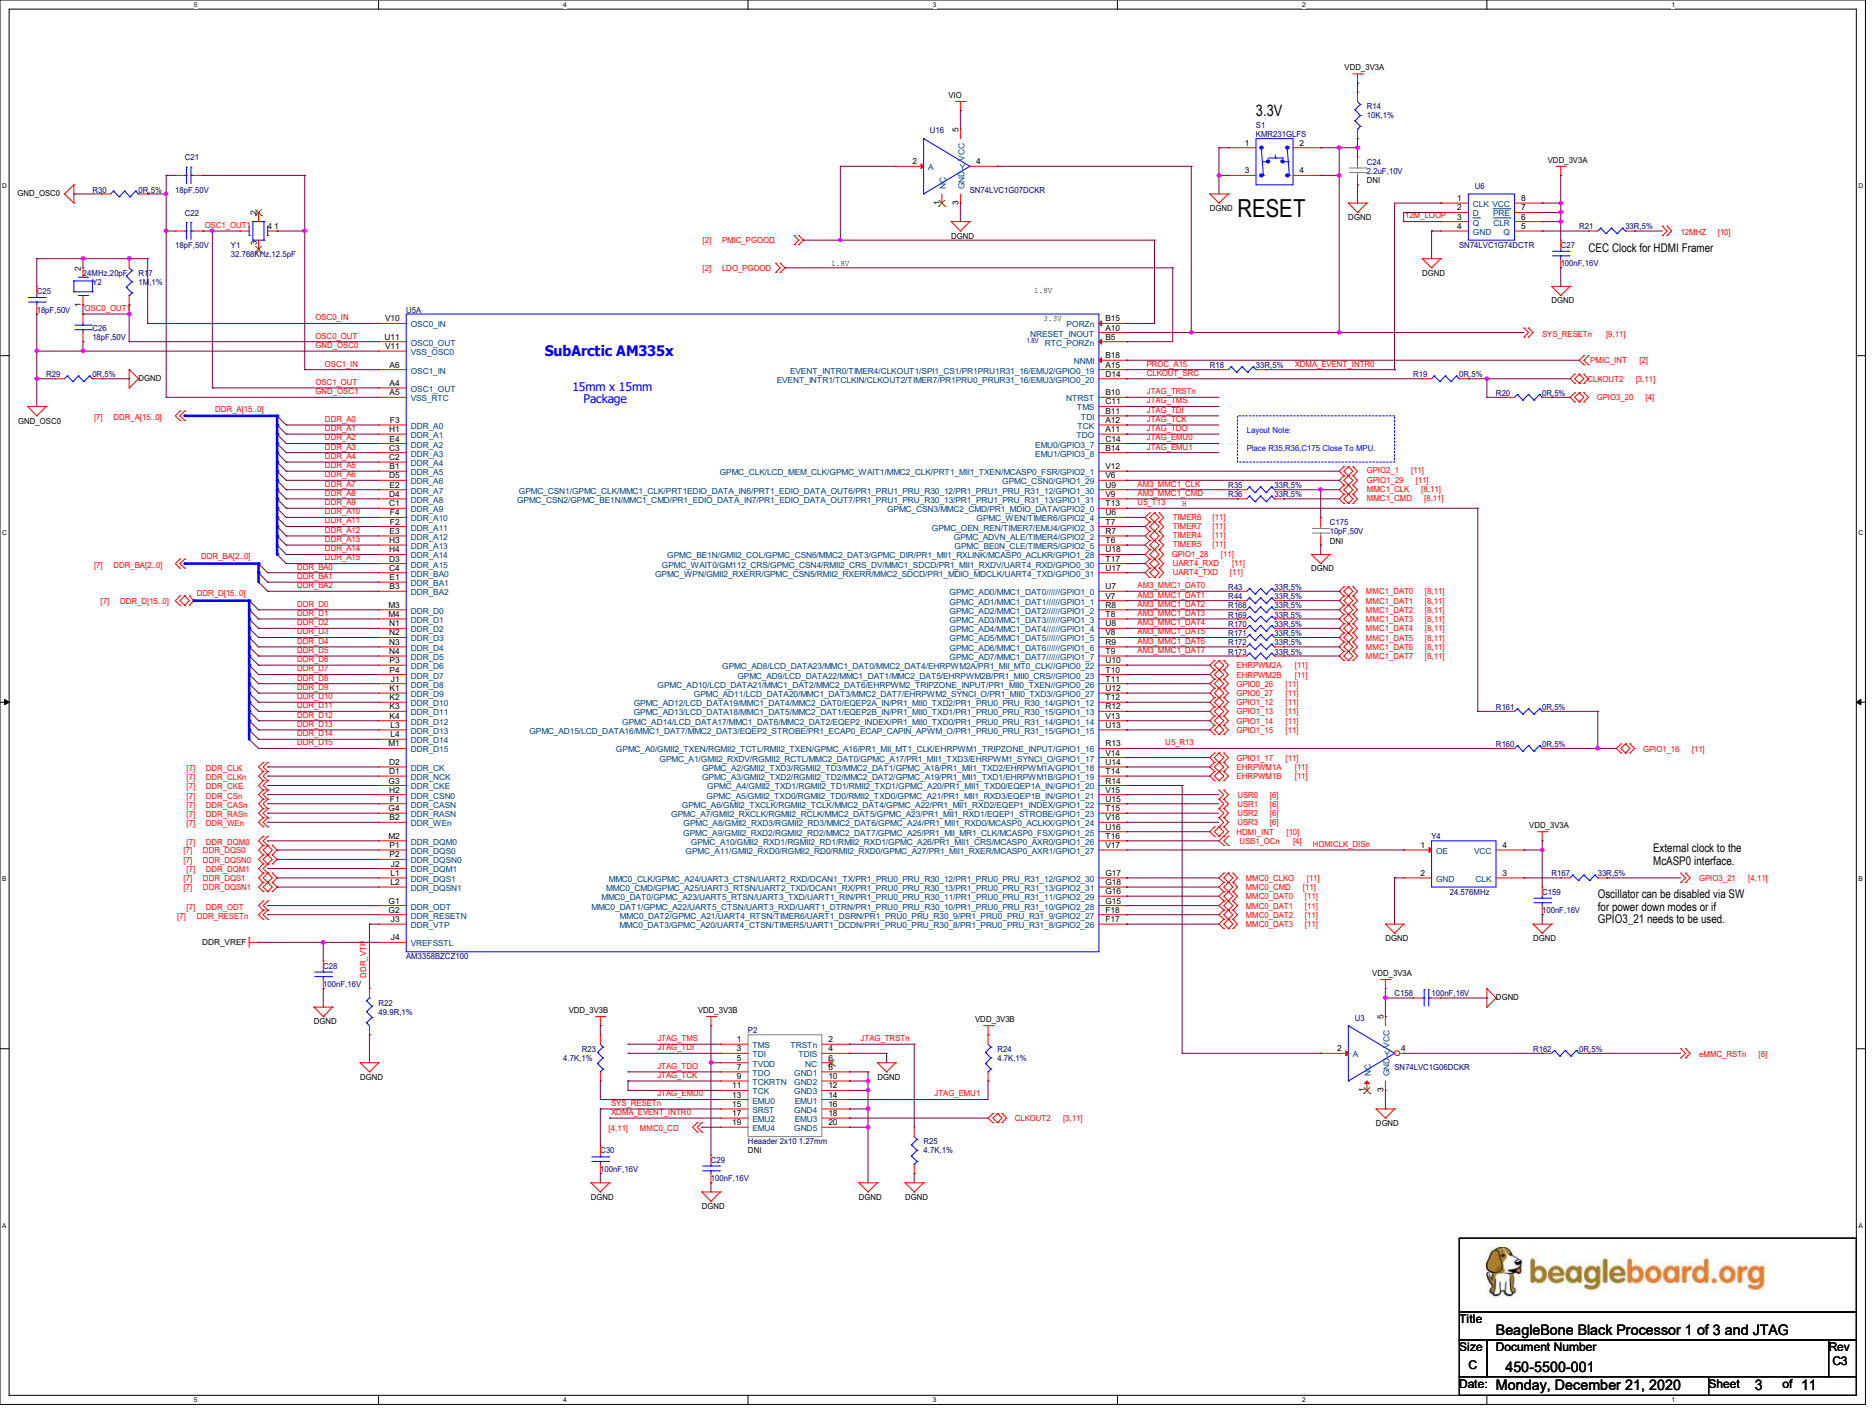
[picture p93: page 3]

Layout Note: Place R35,R36,C175 Close To MPU.

External clock to the
McASP0 interface.

Oscillator can be disabled via SW
for power down modes or if
GPIO3_21 needs to be used.

# VDD_ADC GNDA_ADC

# VDD_3V3B DGND

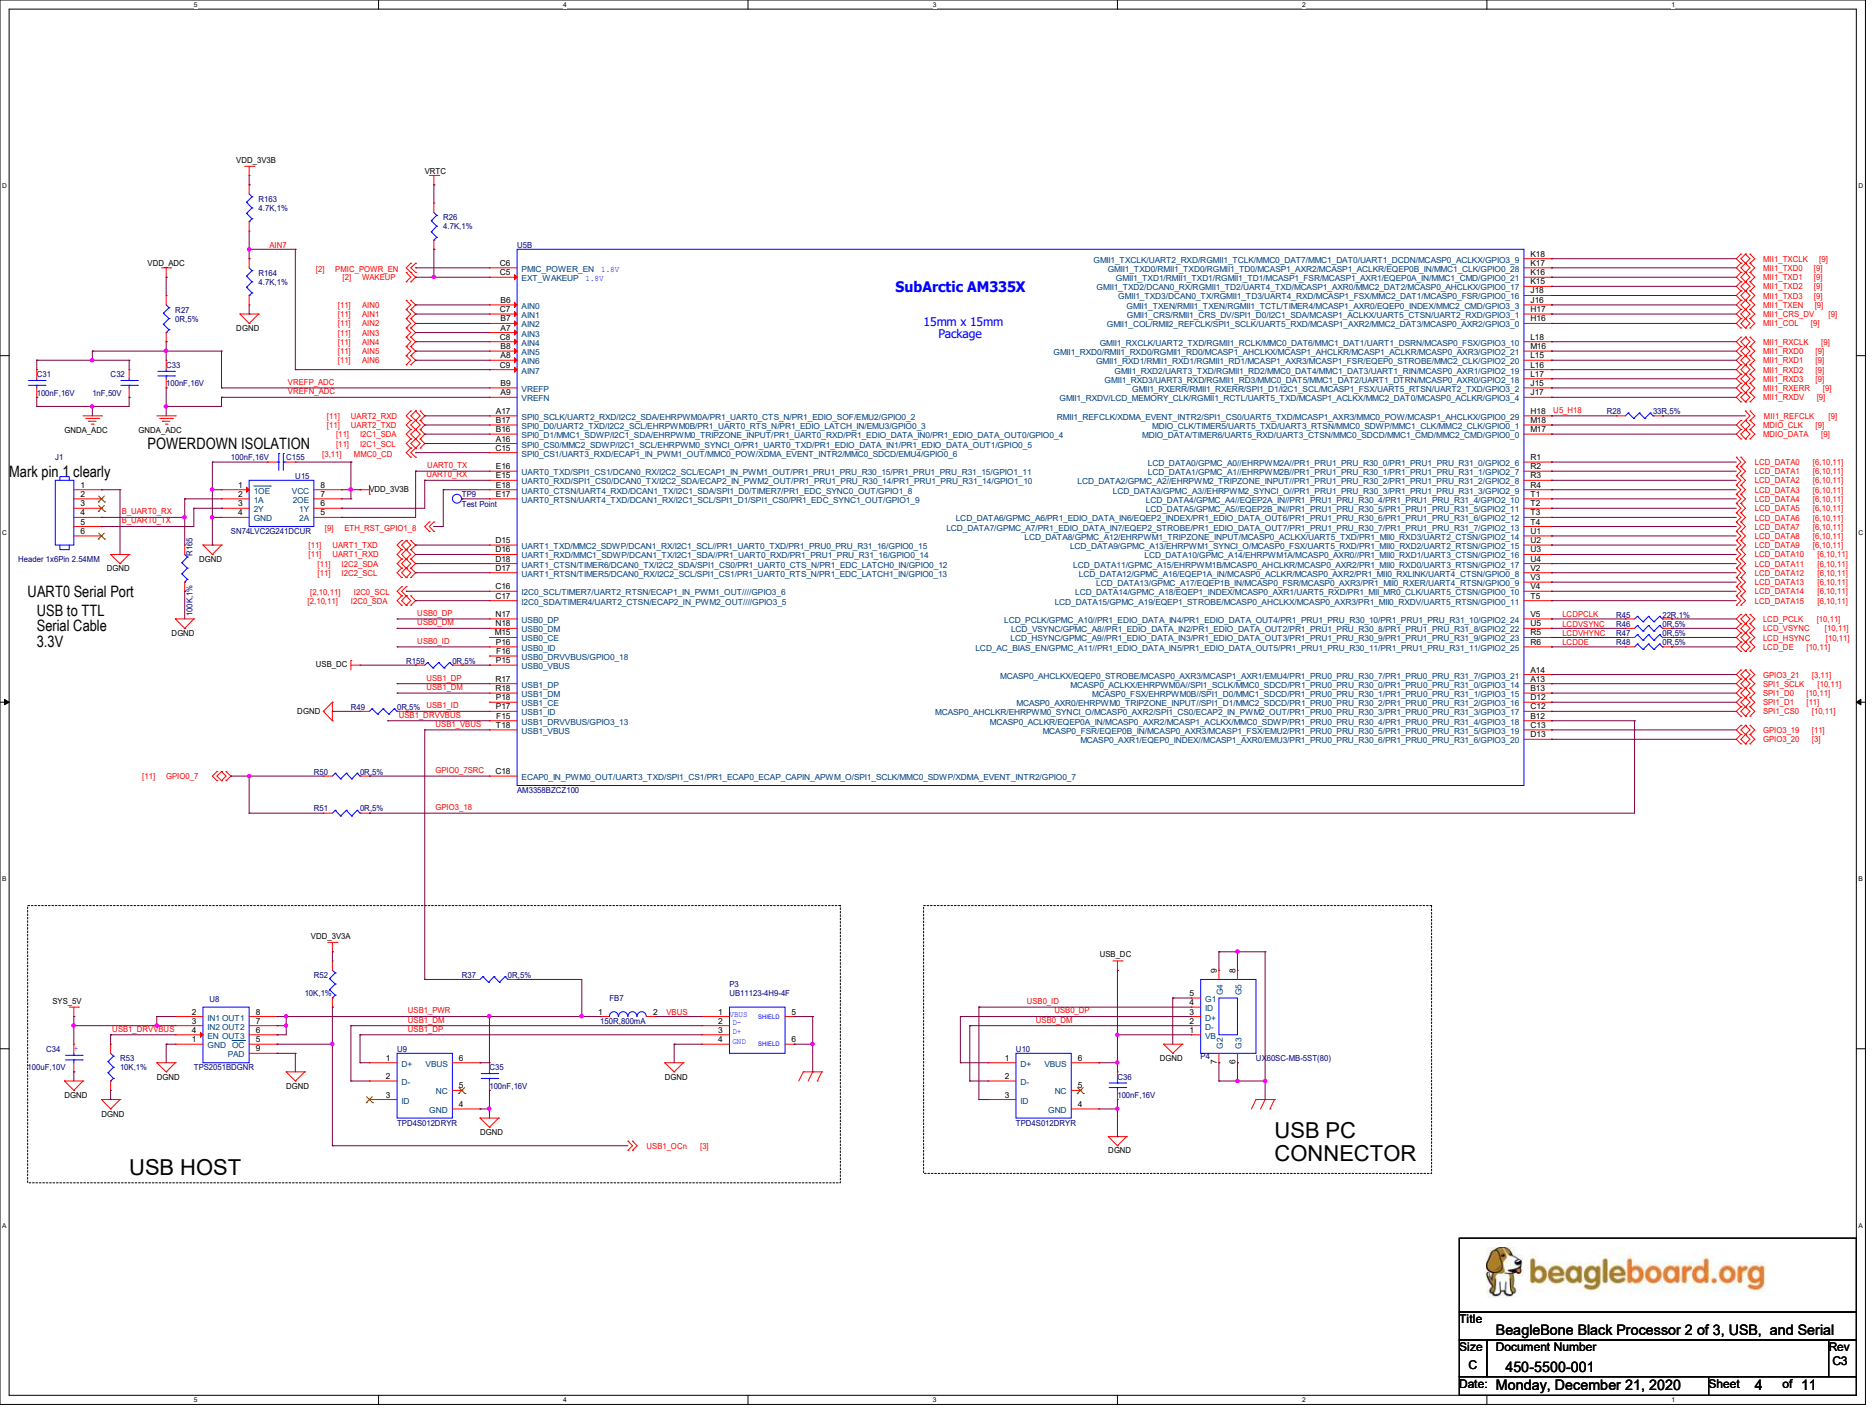
[picture p94: page 4]

# 100nF,16V C83

# 100nF,16V C85

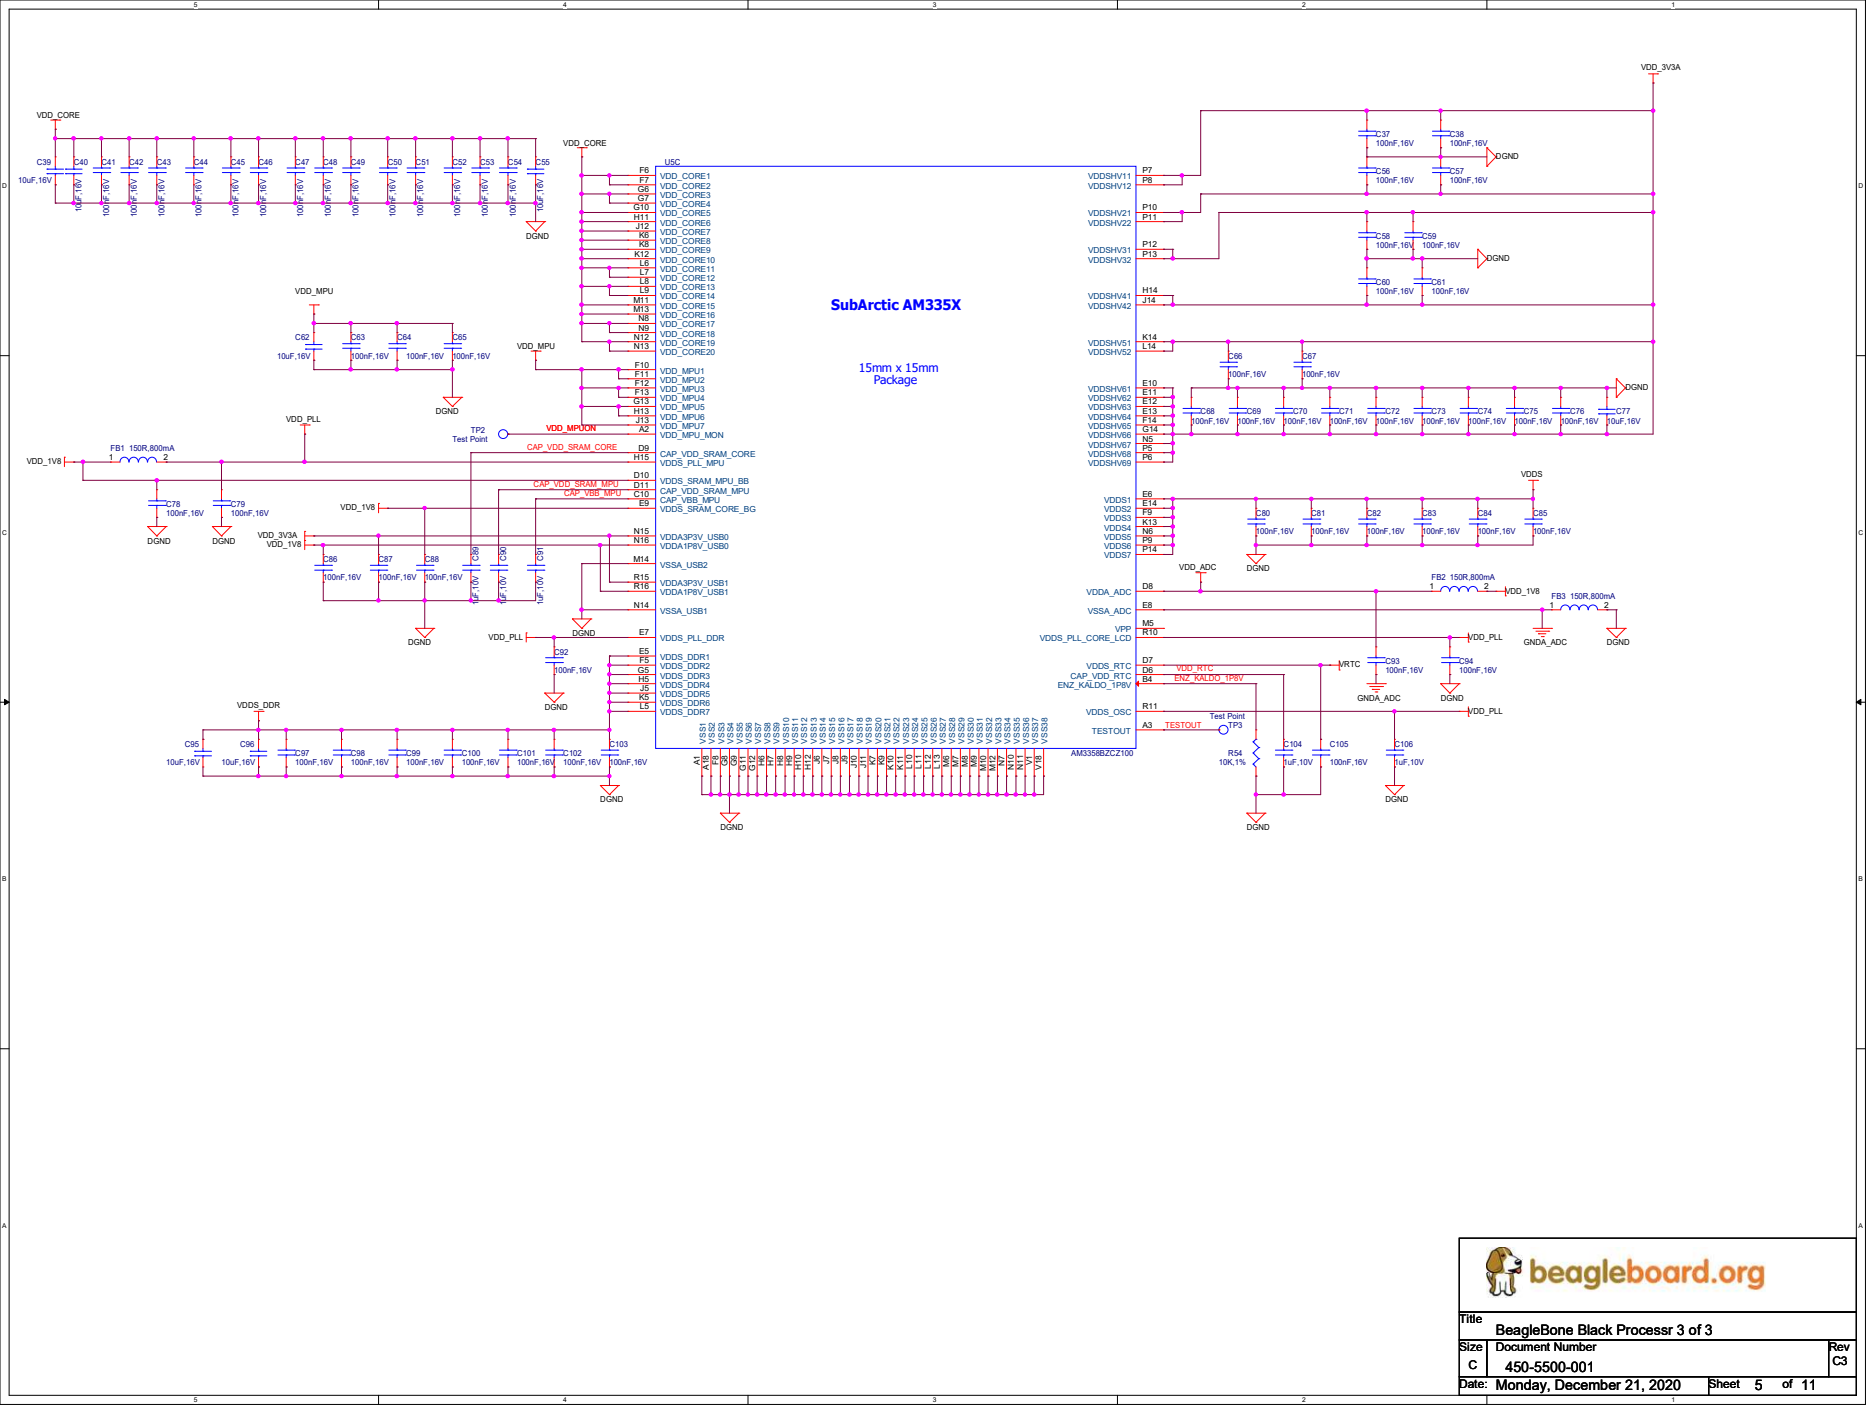
[picture p95: page 5]

# User LED's

## SYS_BOOT0

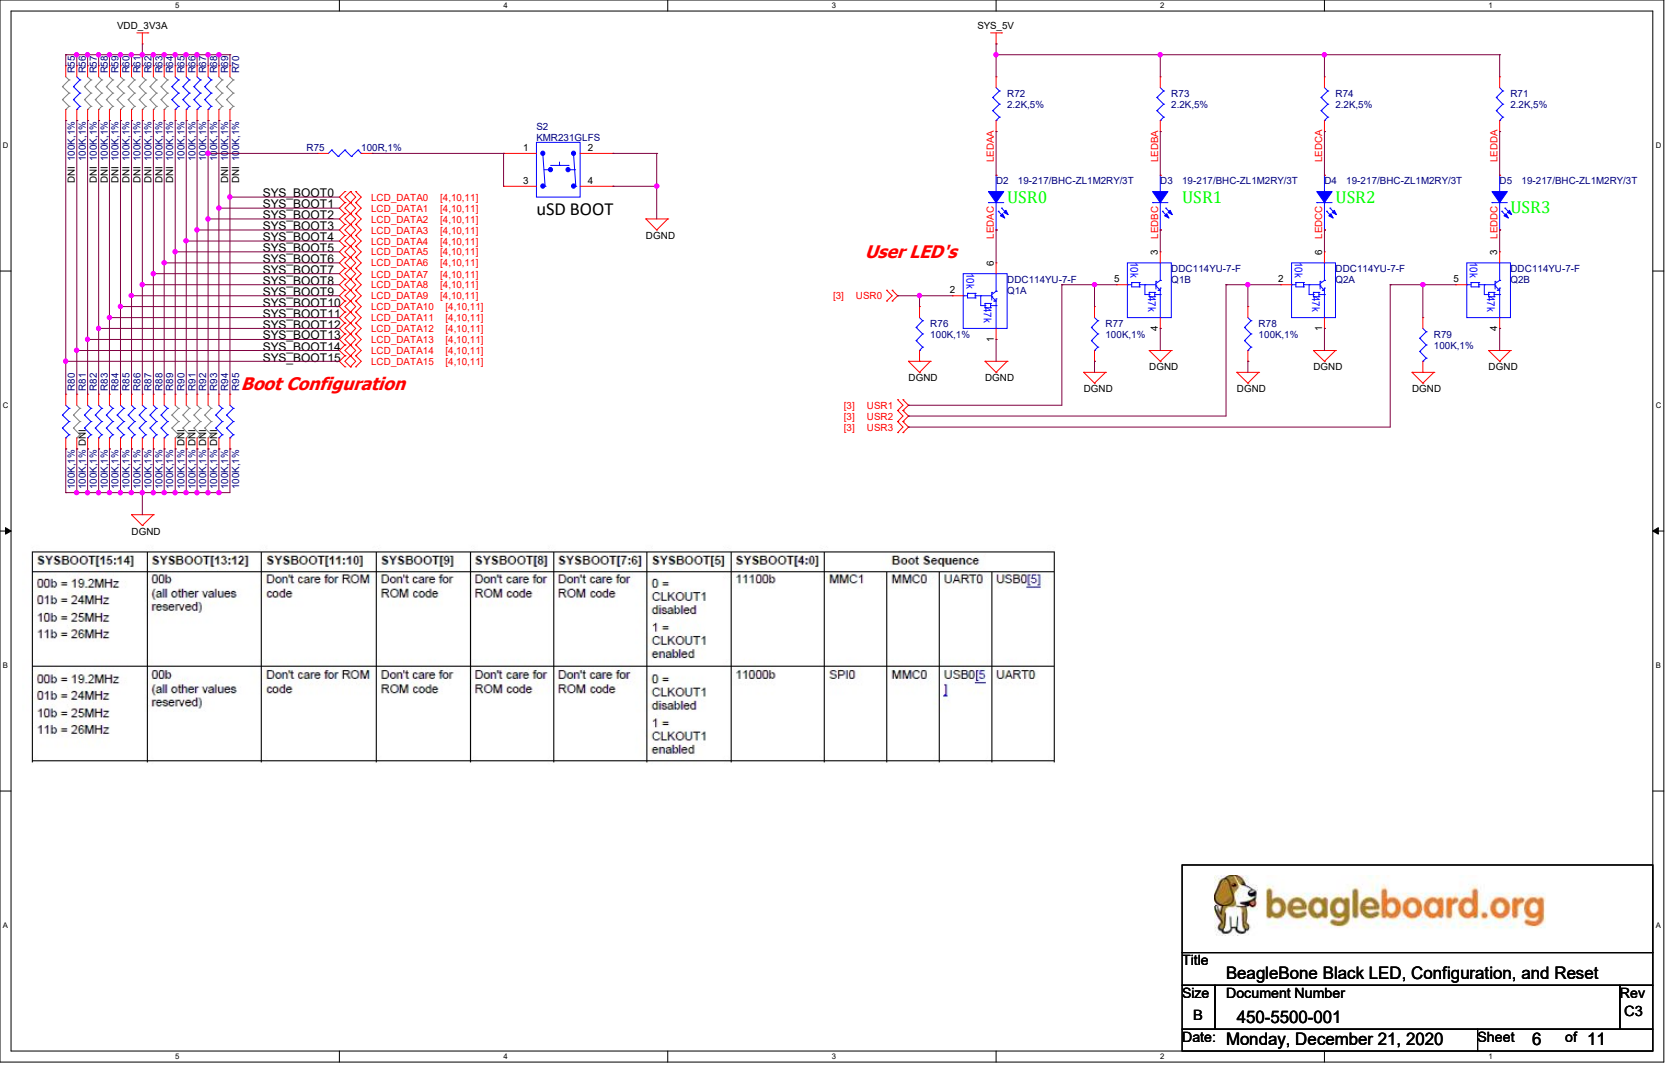
[picture p96: page 6]

100K,1% R⁹¹ 100K,1% DNI R⁵⁵ 100K,1% DNI

D5 19-217/BHC-ZL1M2RY/3T R⁹⁵ 100K,1% R⁵⁷ 100K,1% DNI

3 4 R⁶⁰ 100K,1% DNI R⁵⁹ 100K,1% DNI

SYS_BOOT3
SYS_BOOT4
SYS_BOOT5
SYS_BOOT6
SYS_BOOT7
SYS_BOOT8
SYS_BOOT9
SYS_BOOT10
SYS_BOOT11
SYS_BOOT12
SYS_BOOT13
SYS_BOOT14
SYS_BOOT15

Title
BeagleBone Black LED, Configuration, and Reset

# DDR3L SDRAM

## DGND

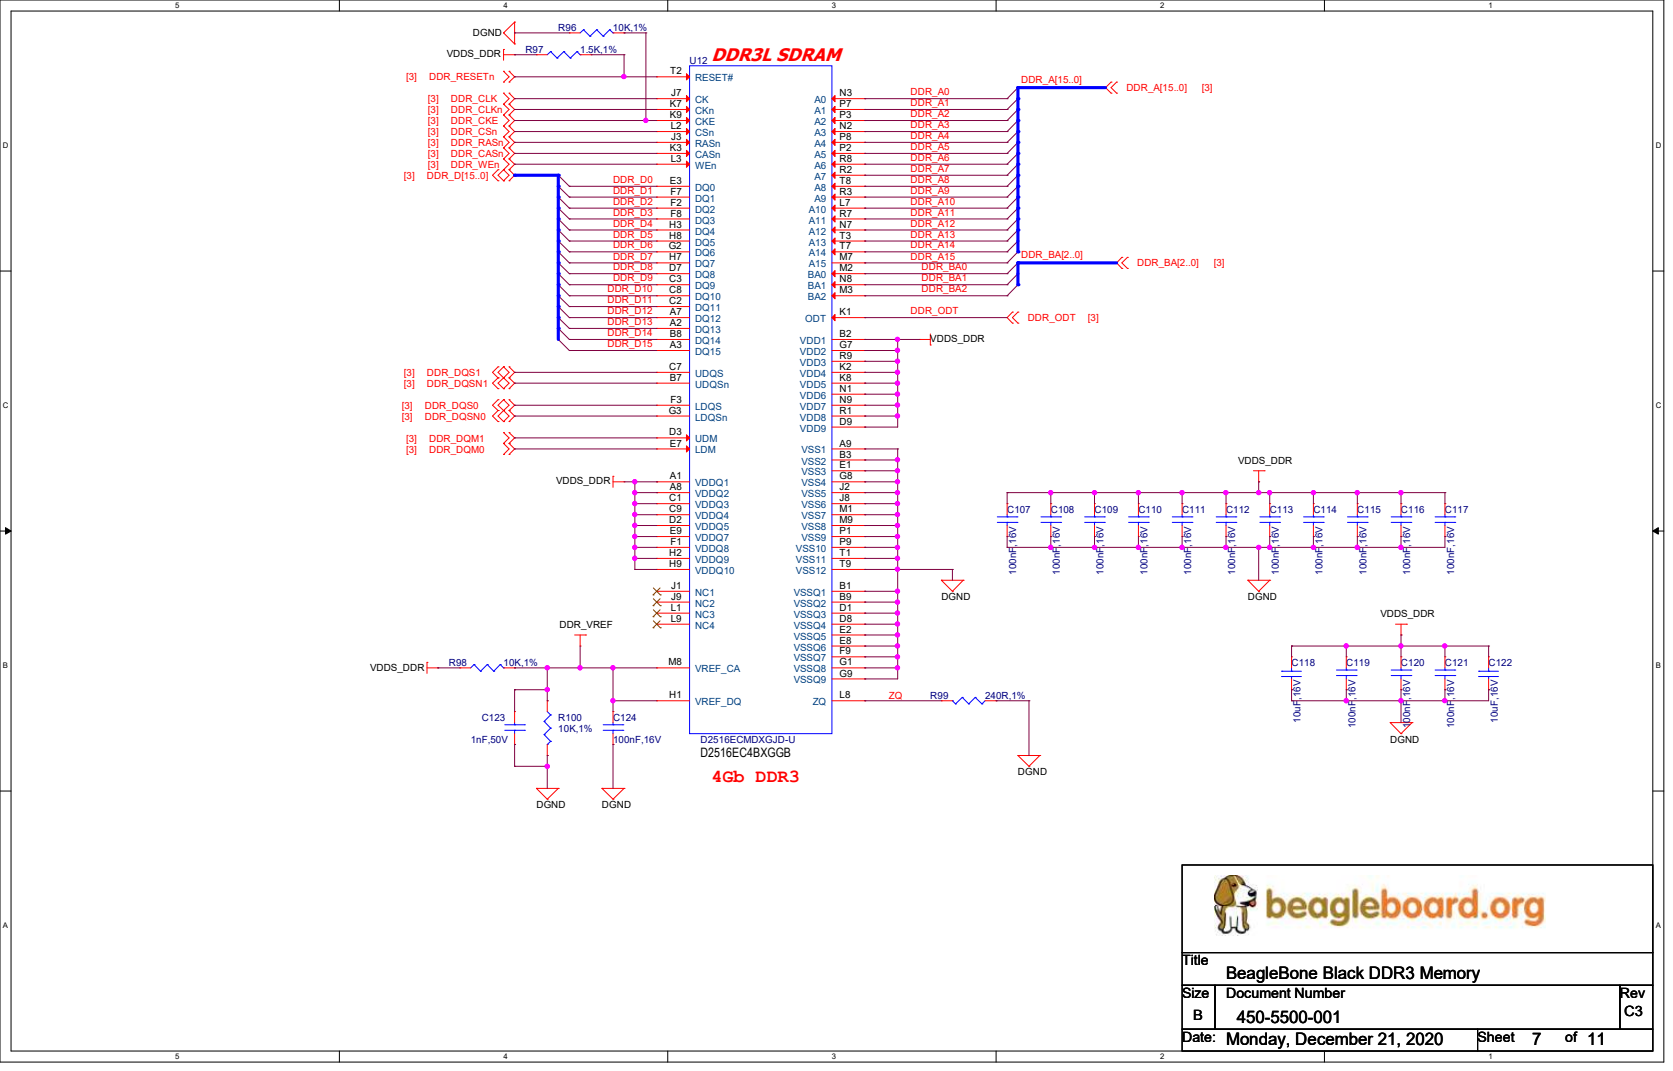
[picture p97: page 7]

## DGND

## DGND

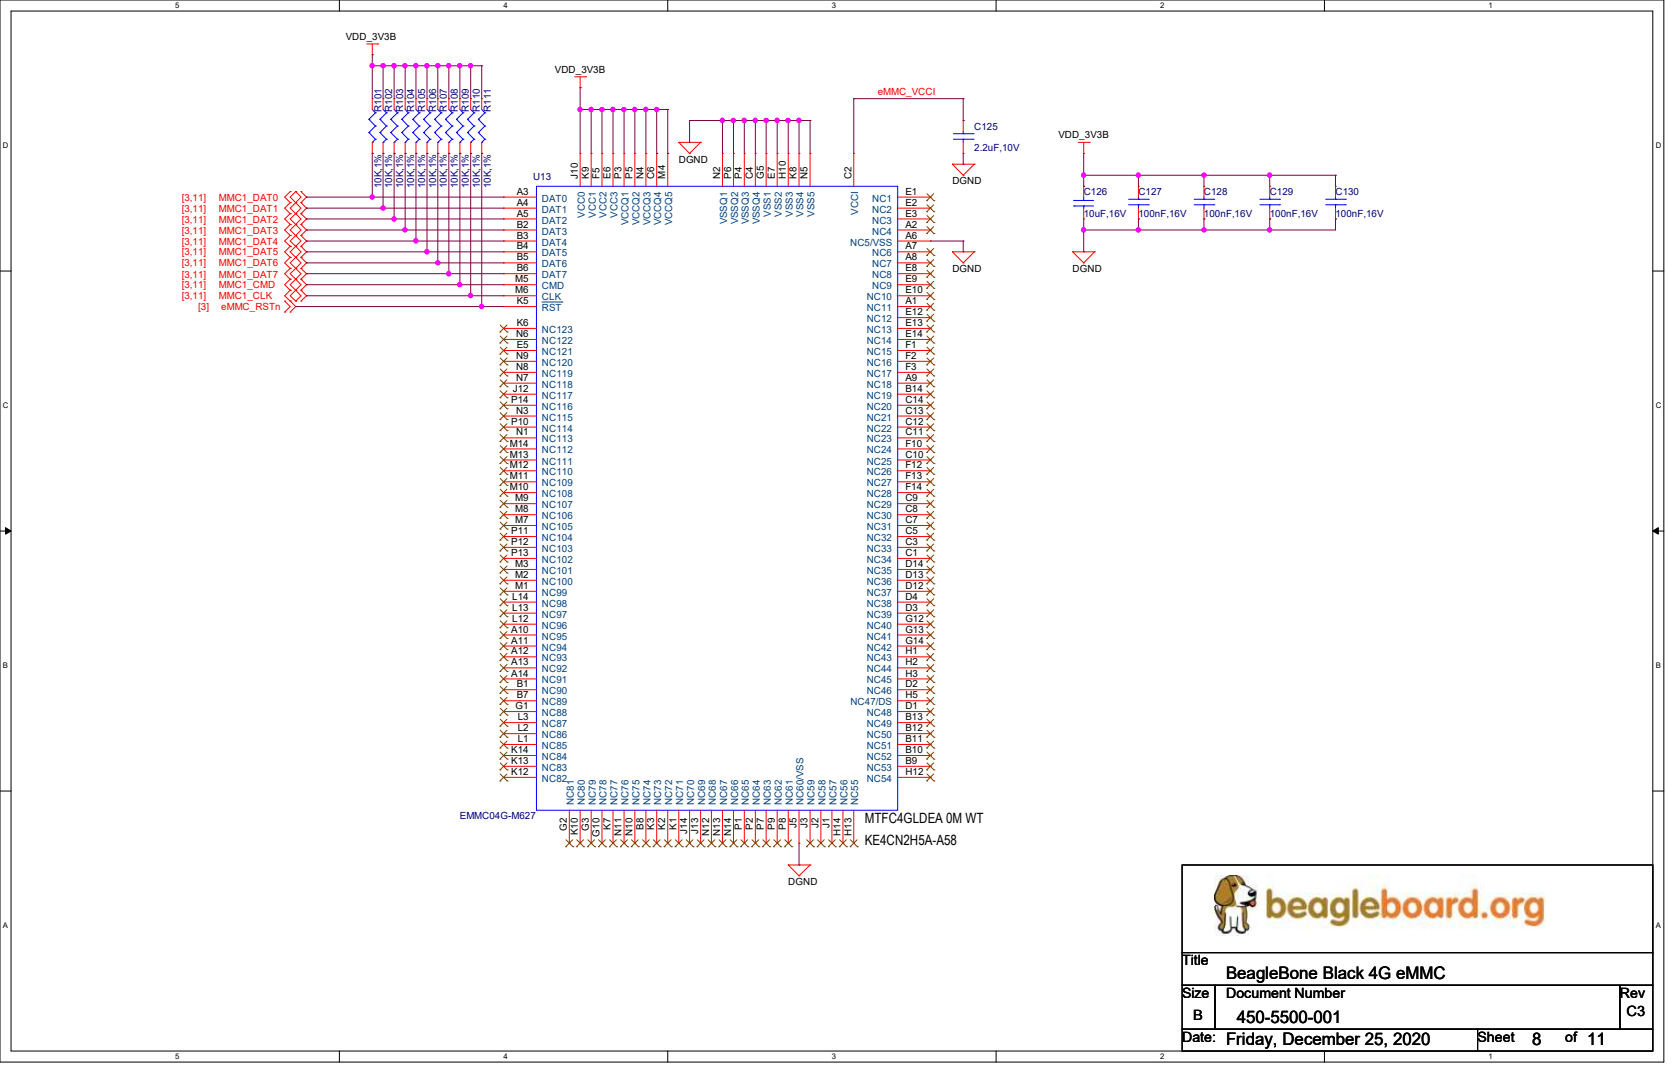
[picture p98: page 8]

# ETHERNET

## VDD_3V3B

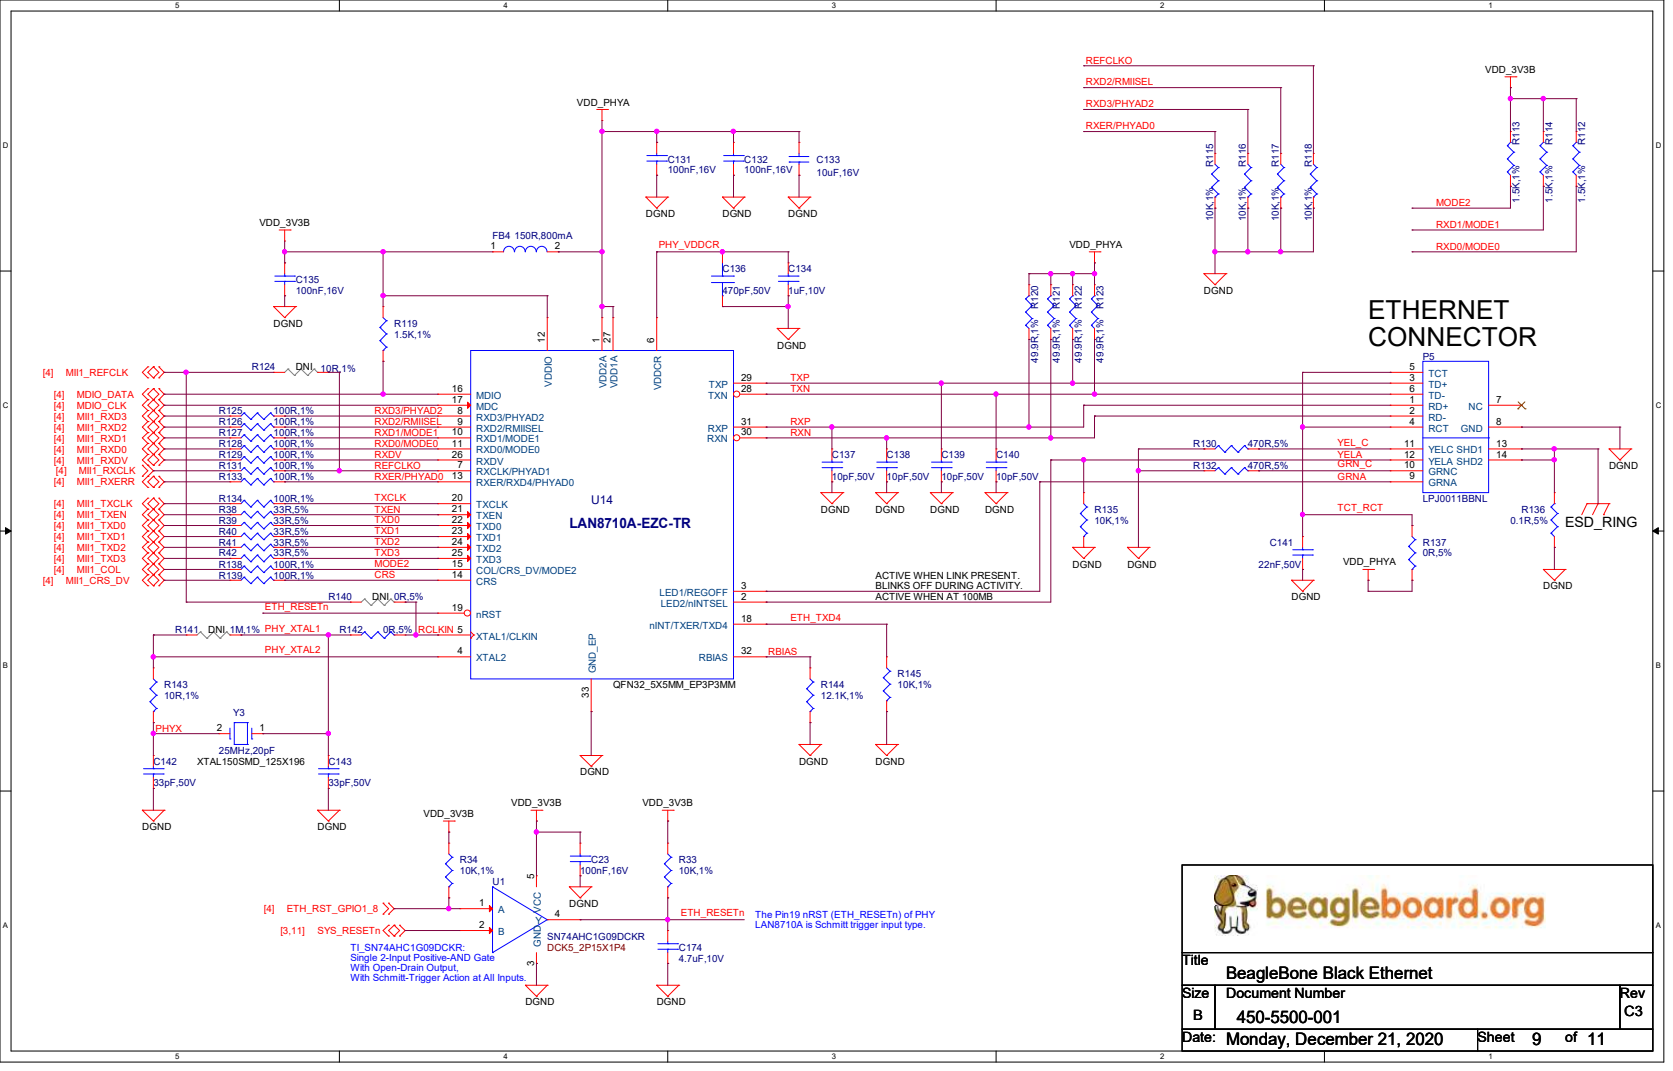
[picture p99: page 9]

6 RXP 31 RXN 30 TXN 28 TXP 29

YEL_C GRNA RXD2/RMIISEL RXD3/PHYAD2 TXCLK MODE2 RXDV

ACTIVE WHEN LINK PRESENT.
BLINKS OFF DURING ACTIVITY.
ACTIVE WHEN AT 100MB

The Pin19 nRST (ETH_RESETn) of PHY
LAN8710A is Schmitt trigger input type.

TI_SN74AHC1G09DCKR:
Single 2-Input Positive-AND Gate
With Open-Drain Output,
With Schmitt-Trigger Action at All Inputs.

## GREEN

## RED

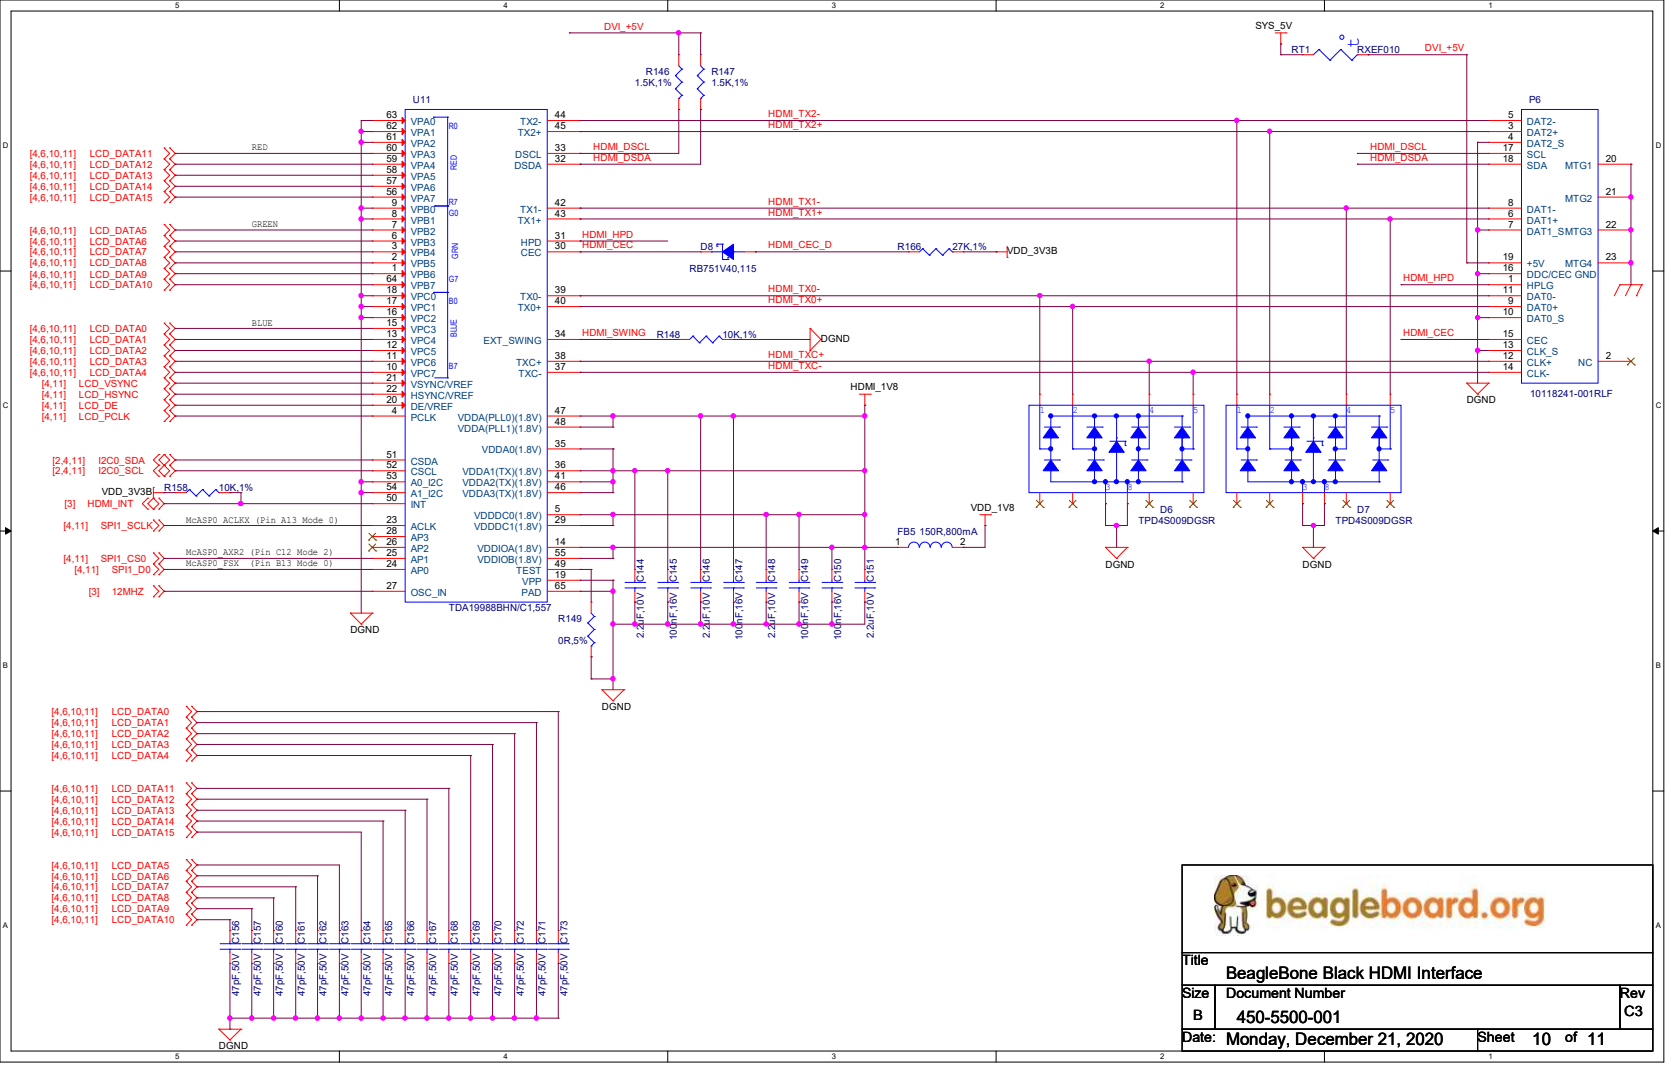
[picture p100: page 10]

uSD CONNECTOR CAUTION: USED ON BOARD | CAUTION: USED ON BOARD

## DGND

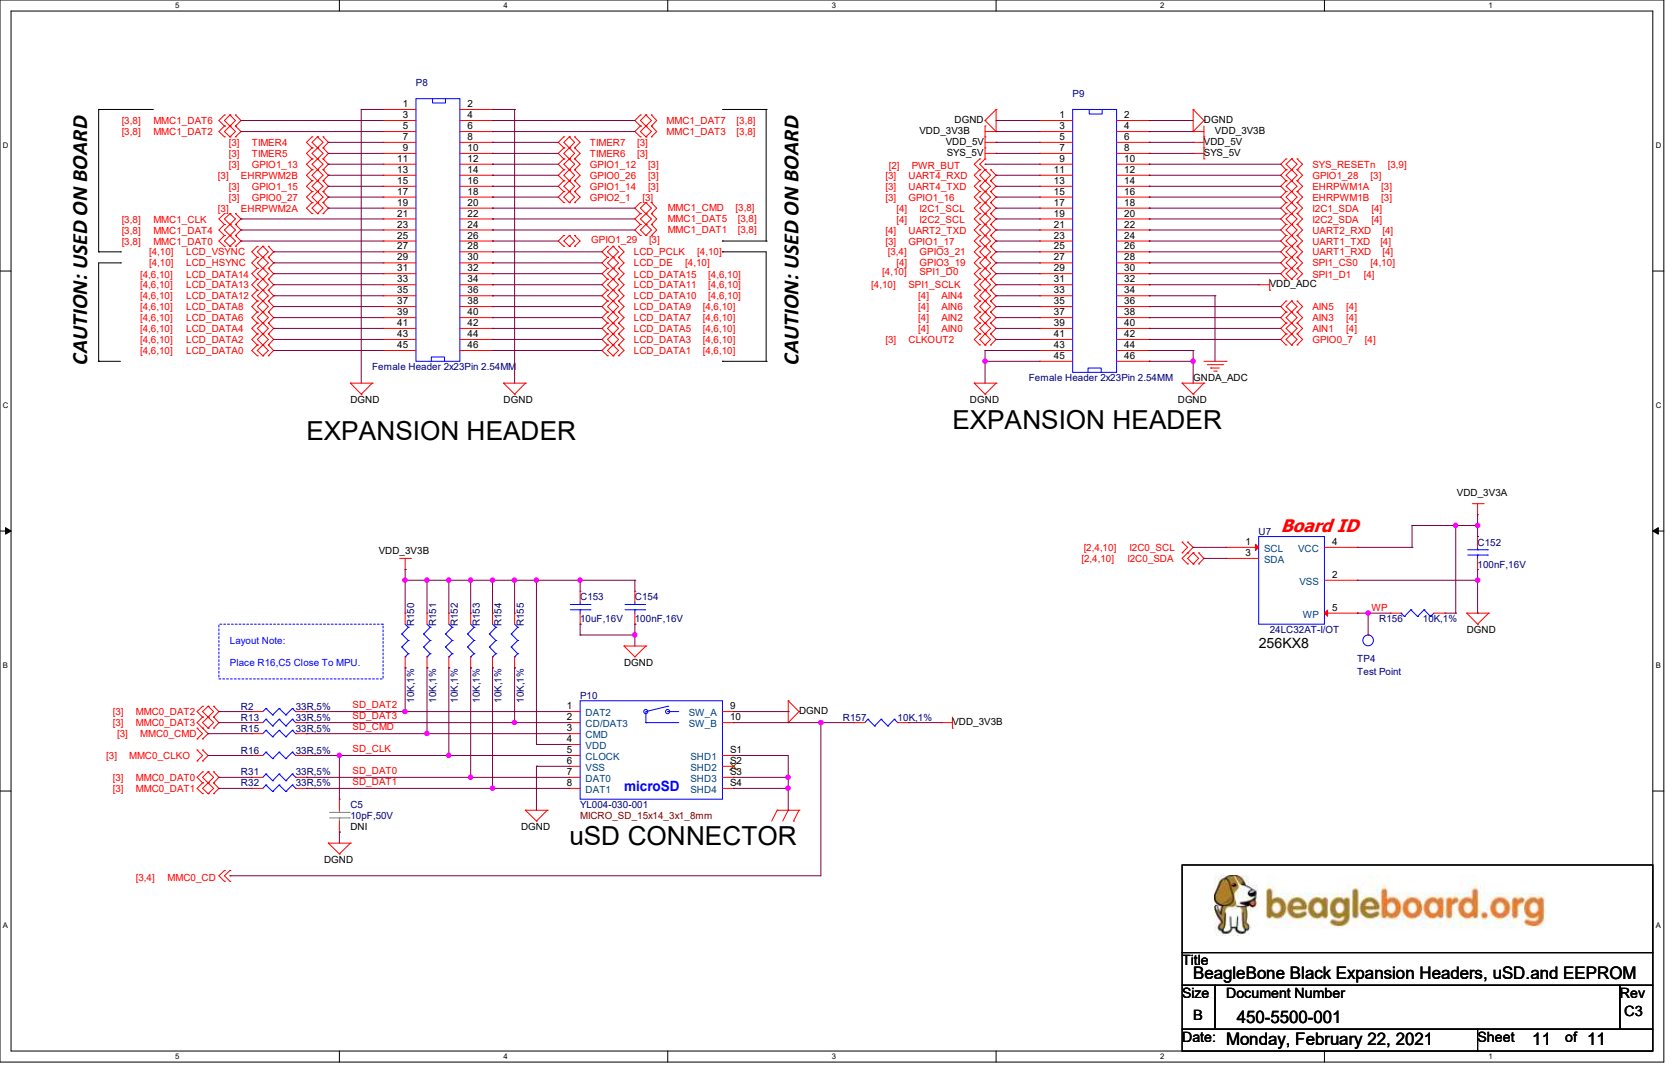
[picture p101: page 11]

Layout Note: Place R16,C5 Close To MPU.

Title
BeagleBone Black Expansion Headers, uSD.and EEPROM
