beagleboard/beaglebone-black/MFG/BeagleBone Black_RevC_ASSY_210222.pdf

# ART FILM - asm_TOP

46

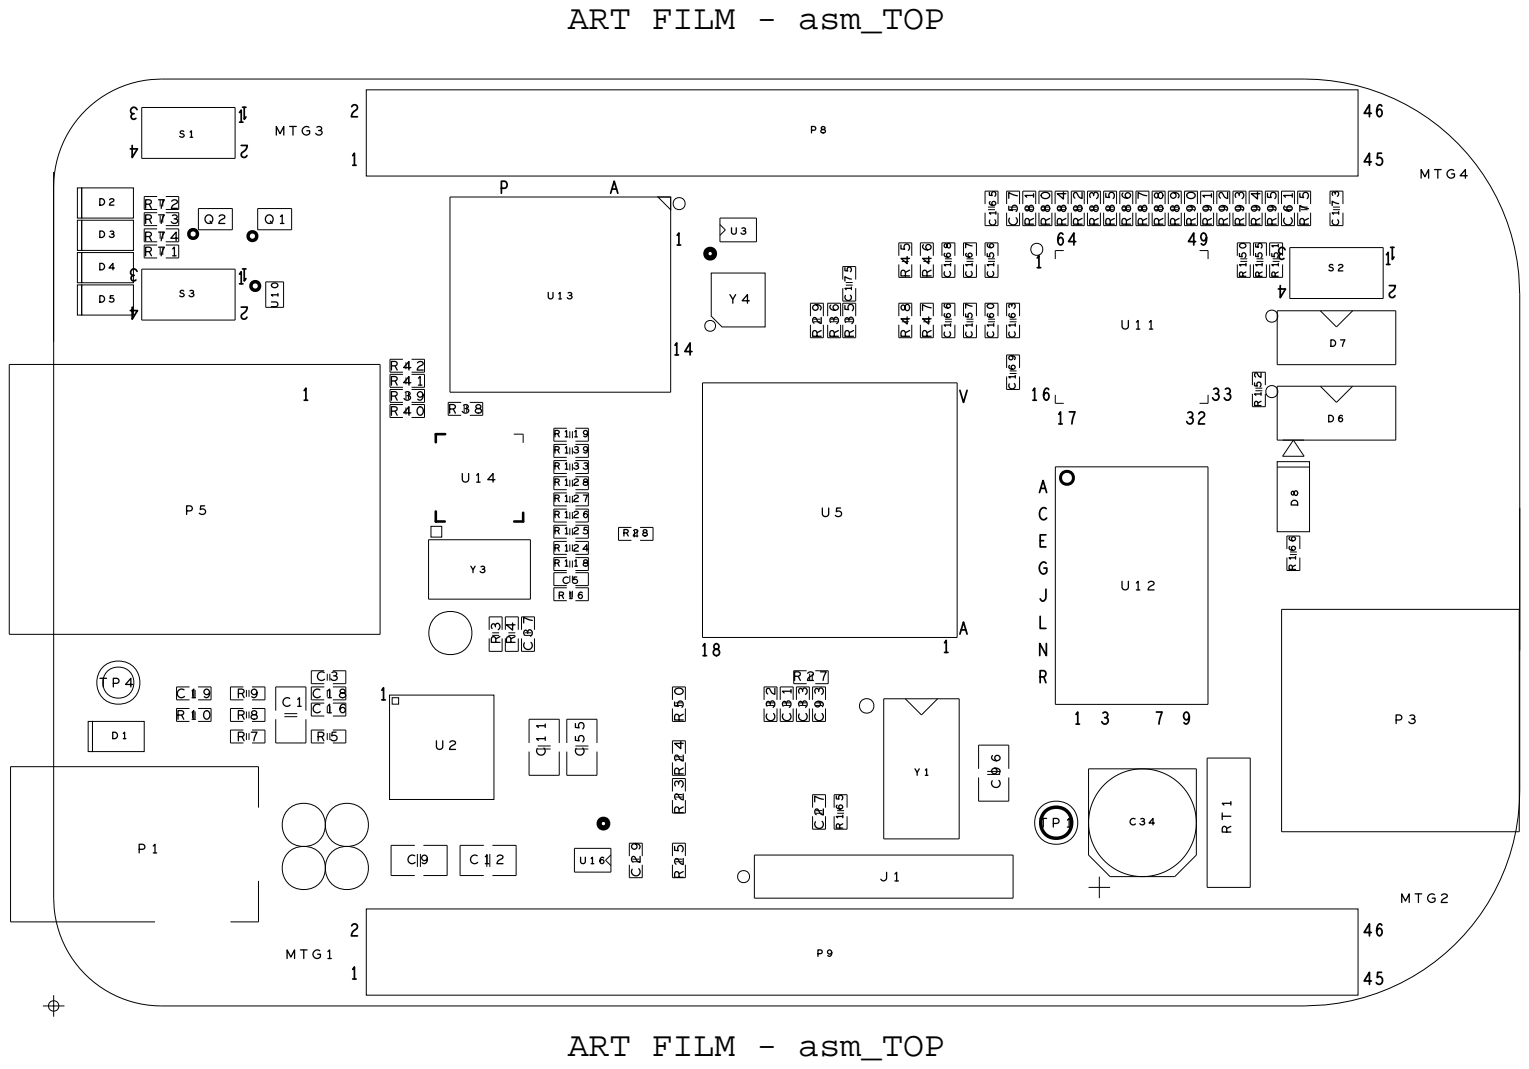
[picture p102: page 1]

# ART FILM - asm_BOTTOM

46

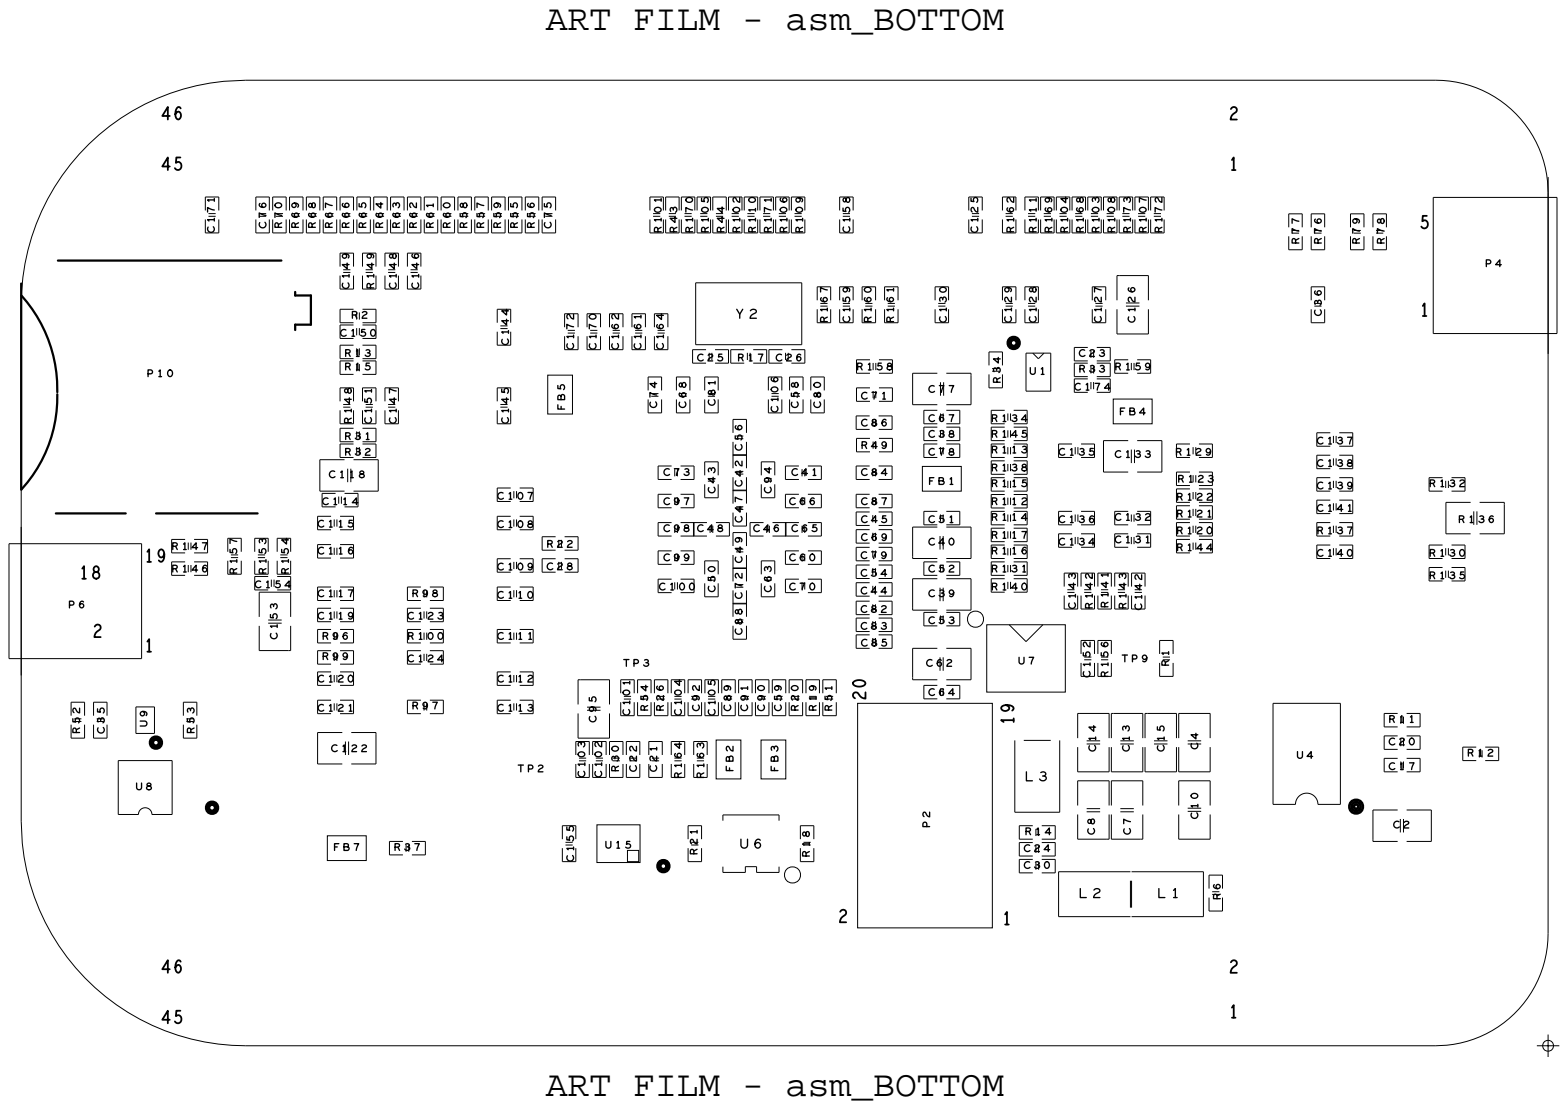
[picture p103: page 2]
