beagleboard/beaglebone-black/(list of files, drawings)

Other design files:
ALLEGRO/BeagleBone Black_PCB_RevD_250403.DSN
ALLEGRO/BEAGLEBONEBLK_C3.DSN
