beagleboard/beaglebone-black/(commit log)

2020-05-22 BOM updated by Seeed Studio
    1) Add alternative parts
    2) Change TI MPN
    3) Change LED RES value to modify the brightness
    [BBB_Industrial_BOM.csv]
2021-08-24 Fix cap count for 0.1uF
    [BBB_BOM.csv]
2021-08-24 BBB_BOM.csv: remove stray semicolon
    [BBB_BOM.csv]
2021-08-24 Add revision C3
    [BBB_BOM.csv, BBB_Industrial_BOM.csv, BEAGLEBONEBLK_C.DSN, BEAGLEBONEBLK_C3.DSN]
2021-08-24 Add C3 manufacturing files
    [BeagleBone Black_RevC_ASSY_XY_210222.xlsx, BeagleBone_Black_RevB6_ASSY_XY.xlsx, art_param.txt, nc_param.txt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]
2021-12-10 Fix rev C3 information
    [BEAGLEBONEBLK_C3.DSN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]
2022-03-11 Add U7 EEPROM alternative part FMD:FT24C32A-ELRT.
    [BBB_BOM.csv, BBB_Industrial_BOM.csv]
2023-04-28 Add new Type A connector
    [BBB_BOM.csv, BBB_Industrial_BOM.csv]
